kazushinjo/PSN_TRX_XIAO_ESP32C3-V2/kicad/README.txt

PSN_TRX_XIAO_ESP32C3-V2 完全KiCadプロジェクト（V2 Ver 1.4）

【このフォルダの開き方】
1. KiCad 10 のプロジェクトマネージャで「ファイルを開く」→ PSN_TRX.kicad_pro を選択
   （※ .kicad_sch や .kicad_pcb を直接開くとライブラリが解決されません。
      必ず .kicad_pro から開いてください）
2. 基板エディタで「検査 → デザインルールチェッカー(DRC)」を実行
   （シルク警告3件は修正済み。残る場合は除外で可）
3. 発注用のデータは「python3 make_production.py」で作り直せます（ガーバー・ドリル・JLCPCB 用 BOM/CPL・座標・部品配置図）
   （同梱の production/ は 2026-11-08 に基板 V2 Ver 1.3 から DRC エラー0・未配線0・回路図との不一致0 の状態で出力済み）

【含まれるもの】
- PSN_TRX.kicad_pro / .kicad_sch / .kicad_pcb / .kicad_sym / .kicad_prl
- sym-lib-table / fp-lib-table（カスタムライブラリは ${KIPRJMOD} 参照＝このフォルダ内完結）
- PSN_TRX.pretty/（カスタムフットプリント21種: XIAO ソケット（2026-11-05 に Seeed 公式の並びに修正）, Si5351 モジュール用 DIP-8（同、ピン番号を修正）, 電源線・同軸じか付け用 SolderWire_1x02（5.08mm・2.54mm、穴 φ1.1）, AL0510 縦置き, 7T50 コイル, T30/T50 トロイダル, TMCV01 トリマ, Heatsink_17PB046 等）
- blank.kicad_wks（図枠テンプレート）
- report.txt（回路図→基板 反映ログ: 警告0/エラー0）
- BOM.md / bom.csv（部品表）
- refdes_map_2026-11-05.csv（部品番号の新旧対応表。2026-11-05 に部品番号を信号の流れの順に振り直した）
- refdes_map_2026-10-15.csv（その前の対応表。2026-10-15 に部品番号を回路図の位置順に振り直した）
- bom_purchase.csv（購入用部品表: 購入先・型番・秋月の販売コード・入数・価格）／make_bom_purchase.py（その作成スクリプト）
- production/（JLCPCB 用製造データ、2026-11-08 に V2 Ver 1.3 から make_production.py で出力）
    PSN_TRX_Gerber_JLCPCB.zip … ガーバー11層＋ドリル(PTH/NPTH)＋ジョブファイル。発注時はこれだけアップロード
    PSN_TRX_BOM_JLCPCB.csv / PSN_TRX_CPL_JLCPCB.csv … 実装も頼む場合の部品表・座標（LCSC 番号は未記入）
    発注指定: 4層、1.6mm、134.1×129.7mm、最小穴 0.3mm、最小線幅 0.2mm・間隔 0.2mm（いずれも標準仕様内）
- PSN_TRX_部品配置図.pdf（A3・1ページ: 上面から見た部品外形と番号、裏面の Q7/Q6 は Q2 の真裏、2026-10-28 に基板 Ver 2.1 から出力。値は入れず部品番号のみ。値は docs/PSN_TRX_部品実装図.pdf の各ページの表を参照）

【標準ライブラリについて】
回路図・基板は KiCad標準ライブラリ（Device, Transistor_BJT, Regulator_Linear,
Diode_THT, Resistor_THT, Connector_PinHeader 等）も使用しています。
これらはKiCad 10インストーラに同梱されています。
「ライブラリが見つかりません」と出る場合は、KiCadインストール時に
「Libraries」にチェックが入っていなかった可能性があります。
その場合はKiCadインストーラを再実行し Libraries を追加してください。
