kazushinjo/PSN_TRX_XIAO_ESP32C3-V2/kicad/production/JLCPCB_提出資料.md

# PSN_TRX_XIAO_ESP32C3-V2 基板 V2 Ver 1.4（SSB シングルスーパー受信）— JLCPCB 提出資料

作成日: 2026-10-21（2026-10-28 再チェック・再出力、同日 Ver 2.1 で再出力、**2026-10-30 V2 の基板から全製造データを再出力**、2026-10-31 J310 → 2SK192A-GR で BOM・CPL の値を更新、**2026-11-05 V2 Ver 1.1 の基板から全製造データを再出力**、**2026-11-06 V2 Ver 1.2 の基板から全製造データを再出力**、**2026-11-08 V2 Ver 1.3 の基板から全製造データを再出力**、**2026-11-11 V2 Ver 1.4 の基板から全製造データを再出力**）　／　対象: `kicad/PSN_TRX.kicad_pcb`（基板シルク V2 Ver 1.4）

> **2026-10-30 以前の zip・BOM・CPL は V1（Ver 2.1）の基板のもので、V2 の受信部（NJM2594V・AD8307・12MHz 水晶 6 個・RF 増幅のカスコードなど）が入っていない。必ずこの日以降のファイル（基板シルクが「V2 Ver 1.0」以降のもの）で発注すること。2026-11-05 より前の V2 Ver 1.0 のデータは XIAO（U3）と Si5351 モジュール（U1）の部品形が鏡写しで、XIAO の列の間隔も違う（11.43mm、正しくは 15.24mm）ので使わないこと。2026-11-06 より前の V2 Ver 1.1 のデータは J2（電源入力）の位置と穴径（φ1.5）・J1 の部品形が違い、C109・C110・R80・J12 がないので、ケースの電源スイッチ・電源 LED（LCD の窓の下）と合わない。**

Ver 1.6 からの変更:
- **V2 Ver 1.4（2026-11-11）**: **PA 入力を 50Ω に整合**。C93 の 1 番を Q19 のゲートから C92 と L15 の間（ネット Net-(C92-Pad2)）へつなぎ替え、値を **C92 100pF → 150pF、C93 22pF → 33pF、L15 47nH → 270nH** に。基板は C93 をその場で 180° 回し（穴の位置は同じ、1 番が右）、ゲートへ行っていた B.Cu の線 2 本を外して、1 番から C92・L15 間の F.Cu の線へ 0.4mm の線を 2 区間引いた。部品の数・穴・外形は Ver 1.3 と同じ
- **V2 Ver 1.3（2026-11-08）**: 論理チェックの残り項目への対応。(1) **マイクのバイアスを送信 12V から +5V に**（R42 の電源側を +5V へつなぎ替え、**R42 470Ω → 1kΩ**）。電源 13.8V でマイクに約 11.2V かかり、耐圧 10V のエレクトレットを超えていたため。基板は R42 の 1 番から J7 の 1 番（+5V）へ F.Cu の 0.5mm の線を 1 本（約 12mm）引き、R42 へ来ていた送信 12V の枝（B.Cu 2 本、C91 から先）を外した。(2) **C59・C60（セラミック・フィルム）の部品形を `PSN_TRX:C_Radial_D5.0mm_P2.00mm_CPpad` に**（穴・パッドの大きさと位置は電解用の CP_Radial_D5.0mm_P2.00mm と同じで、シルクの＋・斜線と四角パッドをなくした）。(3) **K1（G5V-2）の穴を φ0.7 → φ1.0（ランド φ1.8）**に（オムロンの推奨）。(4) **FCZ コイル（L3・L12〜L14）にケースの爪の長穴（1.4 × 0.7mm、めっき、GND）を 2 か所ずつ追加**し、当たる配線 6 本を引き直した（ビア 4 個追加）。(5) **U7（XIAO）の穴 φ0.9 → φ1.0**。(6) 部品形をメーカーの資料で総点検し、**TMCV01（TC1〜TC4）の足の間隔 5.0 → 6.3mm**（長穴 1.0 × 1.3mm）、**放熱器 17PB046 の外形（Q19 側のつば 7mm）**を直し、つばに当たっていた **L15 を縦置き 2.54mm**、**L16 を左下へ**移した（配線 9 区間を引き直し）。NPTH と外形は Ver 1.2 と同じ
- **V2 Ver 1.2（2026-11-06）**: 電源関係をケースの左、アンテナ関係を右に集めるため、(1) **J2（電源入力）を基板の左辺の前寄りへ移した**（ケースの電源スイッチ・DC ジャックの側。ケースの中の電源線が PA の出力 LPF・BNC の上を通らない）。(2) J2 の横に **+12V のパスコン C109（0.1µF）・C110（0.01µF）**、電源 LED 用に **R80（10kΩ）と J12（2 ピンヘッダ）** を追加。(3) **J1（アンテナ）を同軸ケーブルのじか付け**（2.54mm ピッチ、穴 φ1.1mm）に、**J2 の穴を φ1.5 → φ1.1mm**（AWG20、電流 1A 弱に合わせた）に。(4) 旧 J2 から K1 への +12V の短い配線を外し、新しい J2 から L20 まで +12V（0.8mm、約 111mm、ビア 3 個）を基板の前半分（PA から離れた側）に新しく引いた。ほかの配線は 1 本も動かしていない（自動配線の結果は新しいネットの分だけを使った）。邪魔になる GND のステッチビア 2 個を外した。(5) J9（TX ランプ）を基板の右側の辺の前寄り（R31 と R23 の間）へ移し、Q20・R72 まで 0.25mm で引き直した（ケースの TX ランプが RF ゲインのつまみの後ろに移ったため）。部品 276 → **280 点**
- **V2 Ver 1.1（2026-11-05）**: (1) **部品形の修正**: XIAO ESP32C3（新 U7）を Seeed 公式の並び（列の間隔 15.24mm、上の列が右から D0〜D6）に、Si5351 モジュール（新 U6）のピン番号を上から見た正しい並びに、10µH（新 L20・RFC1、AL0510 は長さ 14mm で 12.7mm の横置きに入らない）を L20 は縦置き・RFC1 は横置き 15.24mm（スピーカーのマグネットの下なので寝かせる）に、電源入力 J2 を太い電線のじか付け用（5.08mm・穴 φ1.5mm・ランド φ3mm）にした。(2) **3SK59（旧 Q2）を削除**し、IF 増幅は 2SK192A カスコードだけに。2SK192A は 4 個とも **BL ランク**、ソース抵抗 R3・R18 を **100Ω** に。(3) パスコンの位置を直した（Q3 のゲートの C3、78L05 の出力の C50、DC-DC の入出力の C106・C107）。(4) **部品番号を信号の流れの順に振り直した**（新旧の対応は [`../refdes_map_2026-11-05.csv`](../refdes_map_2026-11-05.csv)。この資料の 1〜4 章は新しい番号、この下の履歴は当時の番号）。(5) ネット名 +9V → RX12V、+12V・TX12V を命名。配線は変えた部品の周りだけを引き直し、ほかの配線は前のまま。部品 277 → **276 点**
- **2026-10-31**: Q4・Q5・Q20・Q25 を J310 から **2SK192A-GR**（東芝、ピン 1 D・2 S・3 G で J310 と同じ並び、TO-92_Inline のまま）に、R66 を 100Ω → **47Ω** に。あわせて L19 のタップを 2 回目 → 3 回目（値 T30-6 11T/3T、利得を J310 のときと同じ約 20dB に戻す）。BOM（2SK192A の行、47Ω の行に R66、L18 と L19 を別の行に）と CPL の値だけが変わる。基板のパターン・配置・シルクは変更なし、ガーバー・ドリル・zip は部品の値を含まないので出し直しなし（DRC 違反 0・未配線 0・回路図との不一致 0、ERC 未除外 0 を再確認）
- **V2 Ver 1.0**（2026-10-29〜30）: 受信部を 12MHz SSB シングルスーパーに作り直した（J310 カスコード RF 増幅 Q20・Q25、NJM2594V の混合 U4・積検波 U5、12MHz 水晶ラダー Y1〜Y6、IF 増幅、AD8307（U7）＋ADS1015（J11）の S メーター、78L05（U6）、AF 前置増幅 Q23 など）。基板を **134.1 × 129.7mm** に広げて受信部を再配置・再配線。V1 の Q7・C3・C16・C20・C50・L2・L4・R8・R10・R12・R37 は削除。部品は 202 → **277 点**（基板だけの H1〜H4・HS1 を除く）。RF・IF 増幅の JFET 4 個（Q4・Q5・Q20・Q25、10-31 から 2SK192A-GR）はすべて TO-92 で、表面実装は上面の NJM2594V（U4・U5、TSSOP-8）2 個だけ
- **Ver 2.1**（2026-10-28）: IC2（NJM2904）の電源パスコン **C79（0.1µF）** を追加（IC2 の 8 番ピンの近く、+5V–GND）。8 番ピンから下りる B.Cu の +5V 配線に約 2mm でつなぎ、ベタを再充填した。部品 201 → 202 点。ほかの部品の位置と配線は変更なし（C54 の部品番号の文字だけ 1.7mm 左へ移動、シルクの版数を Ver 2.1 に）
- **Ver 2.0**: 送信の AF 90° 移相を、アナログのオールパス（IC2A・IC2B・VR8、音声トランス T1 で 2 系統に分配）から **XIAO ESP32C3（U3）のデジタル処理**に変更。マイク → IC2A（マイクアンプ）→ U3 の A2（ADC）→ 複素 FIR → I2S の PDM で D10（I）・D8（Q）→ 2 段 RC → 変調器。**削除 9 点**（T1・VR8・R53〜R57・C69・C70）、**追加 11 点**（R58・R59・R61〜R64・C73・C75〜C78）、**定数変更 3 点**（R36 10k→20k、R40 10k→1k、C54 0.1µ フィルム→10µ 電解）。送信検出は U3 の D8 → D0。基板外形・取付穴・コネクタ・RF 部の配置は変更なし。部品は 199 → 201 点
- 2026-10-28（再チェック・再出力、基板の版数は Ver 2.0 のまま）: 回路図・基板は 10-21 から変更なし。ERC・DRC・整合性・シミュレーションをやり直し、過渡解析（4.3）を追加。ガーバー・ドリル・zip を出し直した（日付の行以外は 10-21 の出力と同一）。CPL・BOM は基板・回路図と照合して変更なし。3 章のドリル径の内訳とビアの記載を実際の値に直した
- Ver 1.7: XIAO ESP32C3（U3）の USB 口の前に入り込んでいた R50・R38・Q19 を移し、USB ケーブルを挿せるようにした（回路・定数は変更なし）
- Ver 1.8: アマチュア局の新スプリアス規定に合わせ、PA 出力 LPF を 5 素子から **7 素子チェビシェフ＋2 倍波トラップ** にした（4.2 参照）。部品 5 点追加（L16・L17・C71・C72・TC2）、C1・C6・L3 の定数変更、基板左端の配置を組み直し（J1・J2 も移動）
- 2026-10-17 夜（再出力、基板の版数は Ver 1.8 のまま）: 回路図を見やすく整理し（ラベルだけでつないでいた IC2A・IC2B・PA 出力 LPF の周りを線で接続）、「回路図から基板を更新」した。変わったのはネット名（PA_LPF_C・PA_LPF_C2・AFPS_IN・AFPS_FB・AFPS_RC → 自動名）と、ガーバーに入るピン名の属性（TO-92 と Q3 のピン名を実部品どおりに）だけで、**銅箔・穴・レジスト・シルク・外形は前回の出力と同一**。あわせて Q2・Q4・Q5 の回路図とのリンクを直し、回路図と基板の整合性の警告をなくした

## 1. アップロードするファイル

| ファイル | 用途 | 内容 |
|---|---|---|
| [`PSN_TRX_Gerber_JLCPCB.zip`](PSN_TRX_Gerber_JLCPCB.zip) | **基板製造（これだけで発注できる）** | ガーバー 11 層＋ドリル 2＋ジョブファイル、計 14 ファイル |
| [`PSN_TRX_BOM_JLCPCB.csv`](PSN_TRX_BOM_JLCPCB.csv) | 部品実装を頼む場合のみ | Comment / Designator / Footprint / LCSC Part #（LCSC 番号は未記入） |
| [`PSN_TRX_CPL_JLCPCB.csv`](PSN_TRX_CPL_JLCPCB.csv) | 部品実装を頼む場合のみ | 280 点の座標・回転・面（全点 Top） |

zip の中身（ファイル名は KiCad 標準の拡張子。JLCPCB はファイル名から層を自動判別する）:

| ファイル | 層 |
|---|---|
| PSN_TRX-F_Cu.gtl | L19 上面 銅箔（信号＋GND ベタ） |
| PSN_TRX-In1_Cu.g1 | L2 内層 GND 全面 |
| PSN_TRX-In2_Cu.g2 | L16 内層 RX12V 全面 |
| PSN_TRX-B_Cu.gbl | L4 裏面 銅箔（信号＋GND ベタ） |
| PSN_TRX-F_Mask.gts / B_Mask.gbs | レジスト |
| PSN_TRX-F_Silkscreen.gto / B_Silkscreen.gbo | シルク（レジスト開口部を除いて出力） |
| PSN_TRX-F_Paste.gtp / B_Paste.gbp | メタルマスク（上面は U1・U2 の NJM2594V の 16 パッドだけ、裏面はなし。基板のみの発注では不要） |
| PSN_TRX-Edge_Cuts.gm1 | 外形 |
| PSN_TRX-PTH.drl / NPTH.drl | ドリル（めっきあり 859 穴、めっきなし 2 穴） |
| PSN_TRX-job.gbrjob | ジョブファイル（層構成・寸法） |

## 2. 注文画面の設定（PCB 製造）

| 項目 | 設定 | 備考 |
|---|---|---|
| Base Material | FR-4 | |
| Layers | **4** | 層の順序はファイル名で判別される（Specify Layer Sequence は不要） |
| Dimensions | 134.1 × 129.7 mm | ガーバーから自動入力される値を確認 |
| PCB Qty | 5（最小） | |
| Different Design | 1 | |
| Delivery Format | Single PCB | |
| PCB Thickness | **1.6 mm** | |
| PCB Color | 任意（緑が最も安い） | |
| Silkscreen | White（色に合わせて自動） | |
| Surface Finish | HASL（with lead）または LeadFree HASL | 手はんだのみなので HASL で十分。ENIG も可 |
| Outer Copper Weight | **1 oz** | PA・電源系は 0.8mm 配線、1oz で設計 |
| Inner Copper Weight | 0.5 oz（標準） | 内層は GND・RX12V のベタのみ |
| Impedance Control | No | 層構成は JLCPCB 標準（JLC04161H-7628 など）でよい |
| Via Covering | Tented（標準） | |
| Min via hole size/diameter | 0.3mm /(0.4/0.45mm) 以上の標準設定 | 本基板のビアは穴 0.3mm・径 0.6mm（162 個）と穴 0.4mm・径 0.8mm（8 個） |
| Board Outline Tolerance | ±0.2mm（標準） | |
| Confirm Production file | No（任意） | |
| Remove Order Number | 任意 | 指定場所（JLCJLCJLCJLC）は設けていない。基板に番号を入れたくない場合は有料の「Yes」 |
| Castellated / Edge plating / Gold fingers | No | |

### 部品実装（PCB Assembly）について

部品はほぼすべてリード部品（手はんだ）のため、**部品実装は頼まずに基板だけを発注**する想定。
表面実装部品は上面の U1・U2（NJM2594V、TSSOP-8）だけ。手はんだが難しい場合は、Assembly を Top side にし、BOM と CPL をアップロードして U1・U2 だけを選ぶ（LCSC 番号は NJM2594V を検索して入れる。それ以外の部品は「Do not place」）。

## 3. 設計値（JLCPCB の 4 層基板の製造能力との比較）

| 項目 | 本基板 | JLCPCB 4 層の標準能力（目安） | 判定 |
|---|---|---|---|
| 最小配線幅 | 0.2 mm（XIAO・Si5351 まわりのデジタル配線の一部 43 本、ほかは 0.25 mm 以上） | 0.09 mm | 余裕あり |
| 最小クリアランス（配線・パッド） | 0.2 mm | 0.09 mm | 余裕あり |
| ベタとのクリアランス | 0.3 mm | — | |
| 最小ドリル径 | 0.3 mm（ビア） | 0.15〜0.2 mm | 余裕あり |
| ビア径 / 穴 | 0.6 / 0.3 mm（環幅 0.15 mm）、8 個だけ 0.8 / 0.4 mm | 環幅 0.13 mm 以上 | 余裕あり |
| 最大ドリル径 | 3.2 mm（取付穴 H1〜H4） | 6.3 mm | |
| めっきなし穴 | φ1.6 × 2（放熱器 HS1 の脚ピン） | | |
| 基板端からのクリアランス | 0.5 mm | 0.3 mm | |

ドリル径の内訳（めっきあり、PTH.drl から集計、2026-11-06）: 0.3（162）、0.4（8）、0.5（32）、0.7（8）、0.75（69）、0.8（427）、0.85（8）、0.9（46）、1.0（76）、1.1（11、J1・J2 を含む）、1.2（8）、3.2（4）、計 859。めっきなし: 1.6（2）。

## 4. 提出前チェック（2026-10-21 実施、2026-10-28 再実施、2026-10-30 V2 で再実施）

| 項目 | 結果 |
|---|---|
| **V2 Ver 1.4 の再出力（2026-11-11）** | ERC 違反 0（パネル部品の除外 8 件のみ）、DRC（ベタ再充填）違反 0・未配線 0・回路図との不一致 0。変えた配線は C93 まわりの 4 区間（外した B.Cu 2 本、足した F.Cu 2 本）だけ。PTH・NPTH・外形のガーバーは Ver 1.3 と日付以外同じ。CPL 280 点・BOM 110 行を `kicad/make_production.py` で作り直し |
| **V2 Ver 1.3 の再出力（2026-11-08）** | ERC 違反 0（パネル部品の除外 8 件のみ）、DRC（ベタ再充填）違反 0・未配線 0・回路図との不一致 0。変えた配線は R42 の 1 本（と外した 2 本）、FCZ の爪に当たった 6 本、TMCV01・L15・L16 の変更に伴う 9 区間の引き直しだけで、ほかの配線は動かしていない。PTH は K1 の 8 穴（φ0.7 → φ1.0）・U7 の 14 穴（φ0.9 → φ1.0）・FCZ の長穴 8 個・TMCV01 の 8 穴（φ1.2 → 長穴 1.0 × 1.3）・L15・L16 の移動・ビアが変わり、NPTH と外形のガーバーは Ver 1.2 と日付以外同じ。CPL 280 点・BOM 110 行を `kicad/make_production.py` で作り直し |
| **V2 Ver 1.2 の再出力（2026-11-06）** | ERC 違反 0（パネル部品の除外 8 件のみ）、DRC（ベタ再充填）違反 0・未配線 0・回路図との不一致 0。追加・移動した部品の周りと新しい +12V だけを引き、元の配線は動かしていない。ガーバー・ドリル・CPL（280 点）・BOM（110 行）・`kicad/PSN_TRX_pick_place.csv`・部品配置図は `kicad/make_production.py` で作り直した（このスクリプトは変更前の基板から前回の出力と同じファイルを作ることを確かめてある） |
| **V2 Ver 1.1 の再出力（2026-11-05）** | ERC 違反 0（パネル部品の除外 8 件のみ）、DRC（ベタ再充填）違反 0・未配線 0・回路図との不一致 0・部品形とライブラリの不一致 0。配線は変えた部品の周りだけ引き直し（元の配線は 1 本も動かしていない）、内層（GND・RX12V のベタ）には配線なし。CPL 276 点・BOM 109 行を基板から作り直し |
| **V2 の再出力（2026-10-30）** | ERC 違反 0、DRC（ベタ再充填）違反 0・未配線 0・回路図との不一致 0。ガーバーのパッドの属性（部品番号・ピン・ネット）を基板と照合し 669 パッド全部一致（つながりのない 5 ピン U5-5・U5-7・U3-7・VR3-3・VR4-3 はネットなしで一致）、V1 の旧部品 11 点は含まれない。CPL・BOM は基板から作り直し 277 点（109 種）。`kicad/PSN_TRX_pick_place.csv` も 282 行（H1〜H4・HS1 を含む）で作り直した。下の行のうち 10-28 以前の数値は V1 のときのもの |
| ERC（回路図） | 違反 0（除外を含めて表示すると、基板外のパネル部品 VR1・VR2・LED1 の 8 ピンが「除外済み」で出る） |
| DRC（基板、ベタ再充填後） | 違反 0・未配線 0・フットプリントの問題 0（10-28 も同じ） |
| 回路図と基板の整合性 | エラー 0・警告 0（Ver 2.0・2.1 で追加した部品も回路図とのリンク・UUID の重複なしを確認） |
| ガーバー・ドリル | 2026-10-28 に Ver 2.1 の基板から出し直し。Ver 2.0 の出力との違いは C64 とその配線・ベタ、C63 の文字、シルクの版数だけで、ドリルの違いは C64 の穴 2 つだけ（11 層・ドリル 2・ジョブファイル）。zip 14 ファイル（内層は In1_Cu.g1・In2_Cu.g2 に改名、ジョブファイルの参照も修正） |
| CPL・BOM | 基板・回路図から作り直し。Ver 2.0 との違いは C64 の追加だけ（202 点）。10-28 に基板から座標を出し直し、座標・回転・面・値・フットプリントが CPL・BOM・回路図と全点一致 |
| USB（XIAO）の前方 | USB 中心線の上下 7mm、モジュール端から基板右端まで部品なし（配線のみ） |
| アナログ部の回路シミュレーション（ngspice） | 下の 4.1 のとおり、全項目で問題なし（2026-10-30 に V2 で再計算） |
| 過渡解析（ngspice、10-28 追加） | 下の 4.3 のとおり。基板の変更が必要なものはなし。ファームウェアで直すもの 2 点（注意 3・4、10-28 のスケッチで対応済み） |
| 外形・寸法 | 134.1 × 129.7 mm（ジョブファイル 134.1 × 129.73）、4 層・1.6mm |
| 新スプリアス規定（PA 出力 LPF） | 下の 4.2 のとおり、計算上は 1W を超える場合の −60dBc も満たす（実測での確認が必要） |
| 原寸確認（2026-11-08 追加） | `docs/PSN_TRX_原寸確認図.pdf` を 100% で印刷し、XIAO・Si5351 モジュール・ADS1015・K1・R-78E・TMCV01・放熱器・FCZ コイル・半固定抵抗などの実物を紙に当てて、足の位置と外形の当たりを確かめてから発注する |
| シルクの版数 | 「Designed by JA6FUF / V2 Ver 1.4」（上面右下。2026-11-05 に Ver 1.0 → 1.1、2026-11-06 に 1.2、2026-11-08 に 1.3、2026-11-11 に 1.4） |

プレビュー（3D 表示、部品付き）: [上面](preview/PSN_TRX_top.jpg)／[裏面](preview/PSN_TRX_bottom.jpg)

### 4.1 アナログ部の回路シミュレーション（2026-11-05、V2 Ver 1.1。V2 Ver 1.2 で足したのは +12V のパスコンと電源 LED だけで、計算の結果は変わらない。2026-11-08 に V2 Ver 1.3 で再計算: マイクの直流電圧が 2.15V になったことと、直流計算の収束の修正で Q7 のドレインが電源と同じ値になったこと以外は同じ）

回路図のネットリストから定数を直接読み、ngspice で計算した（`../sim/run.sh`、結果は `../sim/results.txt`）。トランジスタはデータシートの代表値から作った簡易モデル。

| 項目 | 結果 | 判定 |
|---|---|---|
| 直流動作点 | 電源 11/12/13.8V・hFE 下限〜上限・2SK192A-BL の個体差（IDSS 12〜24mA・VGS(off) −1.2〜−3V、R3・R18 100Ω で 4.6〜10.5mA）で全段が動作範囲内。損失の最大は Q13・Q12 の 237mW | 正常 |
| 受信の前段（L1・Q2・Q3・L2） | 雑音指数 0.88dB、電力利得 +22.6dB、−3dB 帯域 49.18〜51.88MHz、イメージ −48.3dB、AGC の幅 15.7dB（2SK192A-BL・R3 100Ω、L2 のタップ 3 回目） | 正常 |
| 12MHz ラダーフィルタ | 損失 6.1dB、−3dB 幅 2.2kHz、−60dB 幅 7.7kHz | 正常（帯域は水晶で変わる） |
| 受信の全体 | 最小検出信号 約 −139dBm、逆側帯波 −33dB（1kHz）、隣接 ±5kHz −69dB 以下、スピーカー最大 約 113mW | 正常 |
| 送信 AF・I/Q | 300〜2700Hz の逆側帯波の抑圧 69dB（定数どおり）、部品のばらつきは `iqa`・`iqd` で補正 | 正常（調整が必要） |
| PA 出力 LPF | TC4・TC3 を合わせて 2 倍波 −70dBc 以下、挿入損失 0.4〜0.5dB | 正常（**TC4 の調整が必須**） |
| キャリアの漏れ | VR5・VR6 で −30dBm | 正常（調整が必要） |
| 第 1 局発・BFO（blocks.py） | L3（7T50＝FCZ 07S50、0.51〜0.80µH）は 0.57µH で 38.5MHz（コアの範囲内）。U1 のキャリア入力 約 350mVrms、U2（BFO）約 100mVrms（NJM2594 の試験条件 100mVrms 以上） | 正常 |
| IF 増幅・S メーター（blocks.py） | 同調は 12.8MHz・10.3MHz だが負荷が重く帯域が広いので、12MHz での差は 0.5dB 以下。IF 増幅の AGC は Q7 のゲート 1V で −3.7dB、0V で −15.5dB（RF 増幅と合わせて約 −31dB） | 正常（定数の変更不要） |
| 送信の同調・送信表示・送受切替（blocks.py） | L12〜L14 は 15pF で 0.55µH（コアの範囲内）。送信表示の LED は出力 約 10mW 以上で点灯。Q1 は必要 hFE 18 で十分飽和 | 正常 |

調整の手順は `../../manual/調整手順.md`。

### 4.2 新スプリアス規定との関係（50MHz 帯、アマチュア局）

スプリアス領域（2 倍波 101MHz・3 倍波 151MHz はここに入る）の許容値（無線設備規則 別表第三号。金谷秀紀「アマチュア局 スプリアス発射の強度の許容値 改訂版」の表で確認）:

| 空中線電力 | 許容値 | 1W 出力のとき |
|---|---|---|
| 1W 以下 | 50µW 以下 | −43dBc |
| 1W を超え 50W 以下 | 基本周波数の搬送波電力より 60dB 低い値 | −60dBc |

出力の高調波 =「PA（RD06HVF1 のシングル AB 級）自身の高調波」＋「LPF の減衰」。PA 自身の 2 倍波をデータシートに値がないため −15〜−20dBc と仮定すると:

| | LPF の 2 倍波減衰 | 出力の 2 倍波 | 1W 以下（−43dBc） | 1W 超（−60dBc） |
|---|---|---|---|---|
| Ver 1.7 まで（5 素子） | −27〜−31dB | −42〜−51dBc | 届かない場合あり | 満たさない |
| Ver 1.8（7 素子＋トラップ、TC4 調整後） | −70〜−76dB | −85dBc 以下 | 満たす | 満たす |
| Ver 1.8（TC4 未調整でトラップが外れた場合の最悪） | 約 −30dB | 約 −45〜−50dBc | ほぼ満たす | 満たさない |

計算による見込みであり、適合の判断は実測（スペクトラムアナライザ）で行うこと。JARD の保証を受ける場合もスプリアスの確認が必要。

### 4.3 過渡解析（2026-10-28 追加）

回路図の定数をそのまま使い、信号源を正弦波・電源の立ち上がりに替えて時間領域で計算した（`../sim/tran.py`、`./run.sh` の結果の最後の節）。NJM2904 は出力 0.03〜3.6V（5V 電源）で制限、U7 の ADC は 0〜2.5V（減衰 12dB）、PDM はその平均値（2 段 RC の入力）で表した。

| 項目 | 条件 | 結果 | 判定 |
|---|---|---|---|
| 受信 AF 出力段 | 1kHz、スピーカー 8Ω、音量 0.9、12V | 歪み率 1% で 7mW、3% で 28mW、10% で 83mW（最大 約 110mW） | 正常（R41 100Ω 給電の小出力アンプとして妥当） |
| マイクアンプ（Q14・U5A） | 1kHz、L7 60Ω | 2Pa（100dB SPL）まで歪みなし。3Pa（103.5dB SPL）で U5A の出力が上側 3.6V で頭打ち（歪み 16%）。AF_ADC は 5Pa でも 0.98〜2.02V で ADC の範囲内 | 正常（口元に極端に近づけなければ飽和しない。飽和するのは U5A が先で ADC ではない） |
| 変調器ドライブ（Q15・Q16） | PDM の振幅、変調器の負荷 200/1000Ω | 歪み率 1% になるのは PDM ±12mV（FIR 入力 −23dBFS、出力レベル 10%）。マイク 1Pa（−19dBFS）で 1.3〜1.5%、試験トーン（−12dBFS）で 3.1〜3.6%、ALC の効き始め（−6dBFS）で 7〜8.5% | **注意 3** |
| PA 大信号（簡易モデル） | RD06HVF1 を 2 乗特性（Vth 3.0V）で近似、Idq 50/200mA、12V、LPF は標準の定数 | 出力 0.7〜2.5W、ドレインの 2 倍波 −12〜−24dBc に対し出力の 2 倍波 −65〜−77dBc、3 倍波 −91dBc 以下。ドレインのピーク 21〜29.6V（RD06HVF1 の VDSS 50V に対し余裕あり） | 正常（2 倍波の余裕は −60dBc に対し 5〜17dB。4.2 の見込み（−85dBc 以下）より小さいので TC4 の調整は必ず行う） |
| 電源投入 | RX12V が 1ms で立ち上がる、音量 0.5 | スピーカーに最大 0.53V（7ms 後、瞬間 34mW）、13ms で収まる | 正常（小さなポップ音） |
| 送信開始（変調器ドライブ） | TX12V が 10µs で立ち上がる | Q15・Q16 のコレクタが 0→5.3V に上がる段差が C71・C73 を通って変調器に入り、最大 0.58V（負荷 200Ω）〜2.1V（1000Ω）、±10mV に収まるまで 95〜115ms | 既知（Q15・Q16 の電源が送信時に入るため。送信開始の約 0.1 秒、変調器の平衡がくずれて搬送波が漏れる可能性） |
| 送信開始（マイク系） | TX12V で Q14 が立ち上がる（マイクのバイアスは V2 Ver 1.3 から +5V で常時） | U5A が一時的に頭打ちし、AF_ADC が最大 −1.97V（30ms 後）ずれ、±10mV に収まるまで 295ms（2026-11-08 再計算） | **注意 4** |

**注意 3（変調器ドライブの直線範囲、基板ではなくスケッチの設定値）**: Q15・Q16 はエミッタ抵抗 22Ω・コレクタ電流 1〜2mA の小さい増幅段で、直線に動くのは入力（PDM の平均値）±12mV 程度まで。出力レベル（`out`）初期値 10% では、ALC の効き始め −6dBFS（初期値）まで声を大きくすると歪み率 7〜8.5%（高調波 −22dB 程度）になり、これは FIR より後でできる歪みなので帯域外（隣接周波数）と逆側帯波に広がる。→ 2026-10-28 のスケッチで ALC の効き始めの初期値を **−20dBFS** にした（歪み率 1.2〜1.4%。試験トーンも ALC でこの大きさまで絞られる）。以前のスケッチで設定を保存（`w`）していた場合は `alc -20` → `w` を入れ直す。実機ではスペクトラムを見ながら `alc`・`out` を合わせる。

**注意 4（送信開始時の音、スケッチの処理）**: 送信開始から約 0.3 秒、マイク系の立ち上がりの大きな低い音が ADC に入る。スケッチは最初の 64ms（`RAMP_N`）だけ出力を止めているので、残りの約 0.2 秒は ALC の効き始めの大きさの「ボッ」という音として送信され、ALC が絞った分が約 0.26 秒かけて戻る。また複素 FIR は I 側が直流〜200Hz も素通しで（50Hz で I 0dB・Q −9dB）、この帯域の音（ハム・この立ち上がり音）は逆側帯波がほとんど抑圧されない。→ 2026-10-28 のスケッチで、送信開始から 0.3 秒（2026-10-30 に 0.45 秒へ延長。過渡が収まる 0.28 秒に対し余裕を持たせた）は入力を無音にし（`MUTE_N`）、FIR を中心 1600Hz・幅 1400Hz にして I・Q とも低域を落とした（50Hz で −21dB、通過域 300〜2700Hz の抑圧は約 69dB のまま）。この過渡波形を同じ処理に通した計算で、送信開始の音は −9.9dBFS → −55dBFS 以下。基板の変更は不要。抑圧比の図は `docs/images/sideband_suppression.png`。

## 5. 届いた基板で確認すること

- 外形 134.1×129.7mm、取付穴 4 か所、放熱器 HS1 の脚穴（φ1.6×2）の位置
- 電源（J2、基板の左辺の前寄り）と GND の間に短絡がないこと（テスター）。J1・J2 の穴は φ1.1mm（J2 は AWG20、J1 は RG-174 などの同軸をじか付け）
- XIAO をソケットに挿して、USB-C ケーブルが周りの部品に当たらずに挿さること
- 組み立て後、PA 出力の 2 倍波（約 101MHz）を測り TC4 で最小に、続いて TC3 で SWR を最小に合わせる（`manual/調整手順.md` の手順 9）。新しく必要な部品のうち C102（68p）・C98（39p）・TC4（10p トリマ）・L18（T-30-6）は購入先が要確認（`kicad/bom_purchase.csv`）
- Ver 2.0 では送信の I/Q をファームウェアで作るので、組み立て後に XIAO へ最新のスケッチ（tx_dsp.cpp を含む）を書き込み、シリアルの `tone` で 1 本のトーンを出して逆側帯波が最小になるよう `iqa`・`iqd` を合わせる（手順は `manual/送信IQ調整手順.md`）。C66〜C69・R53〜R56 は I と Q で値がそろうよう同じ袋の部品を使う。D0（送信検出）は起動設定ピンなので PTT を押したまま電源を入れない
- 送信の音質は 4.3 の注意 3・4 のとおりスケッチの設定値で決まるので、ダミーロードに送信してスペクトラムアナライザ（または別の受信機のウォーターフォール）で、帯域外への広がりと送信開始時の音を確認し、`alc`・`out` を合わせる。PA の 2 倍波は TC4 を合わせた後に必ず測る（4.3 の計算では −60dBc に対し 5〜17dB の余裕）
- 組み立て・調整は `docs/PSN_TRX_組み立て説明書.docx`・`docs/PSN_TRX_部品実装図.pdf`・`manual/調整手順.md`、部品の購入は `kicad/bom_purchase.csv` を使う（いずれも 2026-11-11 に V2 Ver 1.4 の内容に更新済み。調整は手順 9 の TC4 → TC3 の順）
