kazushinjo/PSN_TRX_XIAO_ESP32C3-V2/kicad/sim/netlist.txt

C1 10p 1=Net-(Q2-G) 2=GND
C2 0.01u 1=Net-(Q2-S) 2=GND
C3 0.01u 1=Net-(Q3-G) 2=GND
C4 5p 1=Net-(Q3-D) 2=GND
C5 0.01u 1=Net-(Q4-G) 2=Net-(C5-Pad2)
C6 0.01u 1=Net-(Q4-S) 2=GND
C7 0.01u 1=RX12V 2=GND
C8 27p 1=Net-(L3-SA) 2=RX12V
C9 0.01u 1=Net-(L2-TAP) 2=Net-(U1-SIG)
C10 0.01u 1=Net-(C10-Pad1) 2=Net-(U1-CARR)
C11 0.1u 1=Net-(U1-V+) 2=GND
C12 0.01u 1=Net-(U1-OUT2) 2=Net-(Q5-B)
C13 0.1u 1=Net-(U1-BYP) 2=GND
C14 0.1u 1=Net-(C14-Pad1) 2=GND
C15 0.01u 1=Net-(Q5-C) 2=Net-(C15-Pad2)
C16 15p 1=Net-(C15-Pad2) 2=GND
C17 82p 1=Net-(C17-Pad1) 2=GND
C18 100p 1=Net-(C18-Pad1) 2=GND
C19 120p 1=Net-(C19-Pad1) 2=GND
C20 100p 1=Net-(C20-Pad1) 2=GND
C21 82p 1=Net-(C21-Pad1) 2=GND
C22 0.01u 1=Net-(J3-Pin_2) 2=GND
C23 0.01u 1=Net-(Q6-S) 2=GND
C24 33p 1=Net-(Q7-D) 2=RX12V
C25 0.01u 1=Net-(Q7-D) 2=Net-(U2-SIG)
C26 0.01u 1=Net-(C26-Pad1) 2=Net-(U2-CARR)
C27 0.1u 1=Net-(U1-V+) 2=GND
C28 0.1u 1=Net-(U2-BYP) 2=GND
C29 0.01u 1=Net-(C29-Pad1) 2=Net-(Q8-B)
C30 0.1u 1=Net-(C30-Pad1) 2=GND
C31 33p 1=Net-(Q8-C) 2=GND
C32 0.01u 1=Net-(Q8-C) 2=Net-(U3-INP)
C33 0.01u 1=Net-(U3-INM) 2=GND
C34 0.01u 1=Net-(U3-OFS) 2=GND
C35 0.1u 1=Net-(U3-ENB) 2=GND
C36 0.1u 1=Net-(J4-A0) 2=GND
C37 1u 1=Net-(U2-OUT2) 2=Net-(C37-Pad2)
C38 0.047u 1=Net-(C38-Pad1) 2=GND
C39 1u 1=Net-(C38-Pad1) 2=Net-(Q10-B)
C40 1u 1=Net-(Q10-C) 2=Net-(C40-Pad2)
C41 0.1u 1=Net-(C40-Pad2) 2=GND
C42 0.1u 1=Net-(Q11-B) 2=GND
C43 0.1u 1=Net-(Q11-E) 2=GND
C44 1u 1=Net-(Q11-C) 2=Net-(C44-Pad2)
C45 1u 1=Net-(Q12-B) 2=Net-(J5-Pin_2)
C46 1u 1=Net-(J5-Pin_2) 2=Net-(Q13-B)
C47 100u 1=Net-(Q12-E) 2=GND
C48 100u 1=Net-(Q12-C) 2=Net-(J6-Pin_1)
C49 0.1u 1=RX12V 2=GND
C50 10u 1=Net-(U1-V+) 2=GND
C51 0.01u 1=RX12V 2=GND
C52 0.01u 1=RX12V 2=GND
C53 0.1u 1=RX12V 2=GND
C54 0.01u 1=RX12V 2=GND
C55 10u 1=RX12V 2=GND
C56 47u 1=Net-(C56-Pad1) 2=GND
C57 1u 1=Net-(J7-Pin_2) 2=Net-(Q14-B)
C58 10u 1=Net-(Q14-C) 2=Net-(C58-Pad2)
C59 0.01u 1=Net-(C58-Pad2) 2=GND
C60 0.068u 1=Net-(C60-Pad1) 2=GND
C61 10u 1=Net-(C60-Pad1) 2=Net-(C61-Pad2)
C62 1u 1=Net-(U5A-+) 2=Net-(C61-Pad2)
C63 10u 1=Net-(C63-Pad1) 2=GND
C64 0.1u 1=+5V 2=GND
C65 1u 1=Net-(C65-Pad1) 2=Net-(C65-Pad2)
C66 3300p 1=Net-(C66-Pad1) 2=GND
C67 3300p 1=/PSN_I_OUT 2=GND
C68 3300p 1=Net-(C68-Pad1) 2=GND
C69 3300p 1=Net-(C69-Pad1) 2=GND
C70 1u 1=/PSN_I_OUT 2=Net-(Q15-B)
C71 1u 1=Net-(Q15-C) 2=Net-(C71-Pad2)
C72 1u 1=Net-(C69-Pad1) 2=Net-(Q16-B)
C73 1u 1=Net-(Q16-C) 2=Net-(C73-Pad2)
C74 0.01u 1=Net-(C74-Pad1) 2=Net-(U6-CLK0)
C75 0.01u 1=Net-(C75-Pad1) 2=Net-(U6-CLK1)
C76 47PF 1=GND 2=Net-(C74-Pad1)
C77 47PF 1=GND 2=Net-(C77-Pad2)
C78 47PF 1=GND 2=Net-(C75-Pad1)
C79 47PF 1=GND 2=Net-(C79-Pad2)
C80 0.001u 1=Net-(C5-Pad2) 2=Net-(C80-Pad2)
C81 0.001u 1=Net-(C81-Pad1) 2=Net-(C81-Pad2)
C82 0.01u 1=Net-(C71-Pad2) 2=GND
C83 0.01u 1=Net-(C73-Pad2) 2=GND
C84 15p 1=Net-(D4-A) 2=Net-(D5-K)
C85 0.01u 1=Net-(Q17-S) 2=GND
C86 15p 1=Net-(L13-SA) 2=/TX12V
C87 0.01u 1=/TX12V 2=GND
C88 0.01u 1=Net-(Q18-B) 2=Net-(L13-AA)
C89 0.01u 1=Net-(Q18-E) 2=GND
C90 15p 1=Net-(L14-SA) 2=/TX12V
C91 0.01u 1=/TX12V 2=GND
C92 150pF 1=Net-(L14-AA) 2=Net-(C92-Pad2)
C93 33pF 1=Net-(C92-Pad2) 2=GND
C94 0.001u 1=Net-(Q19-D) 2=Net-(C94-Pad2)
C95 0.1uF 1=/TX12V 2=GND
C96 100u 1=/TX12V 2=GND
C97 0.1uF 1=/TX12V 2=GND
C98 39p 1=Net-(C94-Pad2) 2=GND
C99 82p 1=Net-(C99-Pad1) 2=GND
C100 5p 1=Net-(C100-Pad1) 2=GND
C101 100p 1=Net-(C101-Pad1) 2=GND
C102 68p 1=Net-(C102-Pad1) 2=GND
C103 5p 1=Net-(C102-Pad1) 2=Net-(D8-K)
C104 1u 1=Net-(C104-Pad1) 2=GND
C105 10u 1=RX12V 2=GND
C106 10u 1=Net-(U8-VI) 2=GND
C107 10u 1=+5V 2=GND
C108 10u 1=Net-(U6-VDD) 2=GND
C109 0.1u 1=/+12V 2=GND
C110 0.01u 1=/+12V 2=GND
D1 1N4001 1/K_1=Net-(D1-K) 2/A_2=GND
D2 1N4148 1/K_1=Net-(D2-K) 2/A_2=GND
D3 1N4148 1/K_1=GND 2/A_2=Net-(D2-K)
D4 1N60 1/K_1=Net-(D4-K) 2/A_2=Net-(D4-A)
D5 1N60 1/K_1=Net-(D5-K) 2/A_2=Net-(D5-A)
D6 1N60 1/K_1=Net-(D6-K) 2/A_2=Net-(D4-A)
D7 1N60 1/K_1=Net-(D5-K) 2/A_2=Net-(D7-A)
D8 1N60 1/K_1=Net-(D8-K) 2/A_2=GND
D9 1N60 1/K_1=Net-(D9-K) 2/A_2=Net-(D8-K)
D10 1N5819 1/K_1=Net-(D10-K) 2/A_2=+5V
J1 RF_IN 1/Pin_1_1=Net-(J1-Pin_1) 2/Pin_2_2=GND
J2 PWR_IN 1/Pin_1_1=/+12V 2/Pin_2_2=GND
J3 Volume 1/Pin_1_1=Net-(J3-Pin_1) 2/Pin_2_2=Net-(J3-Pin_2) 3/Pin_3_3=GND
J4 AE-ADS1015 1/VDD_1=Net-(J4-VDD) 10/A3_10=unconnected-(J4-A3-Pad10) 2/GND_2=GND 3/SCL_3=Net-(J4-SCL) 4/SDA_4=Net-(J4-SDA) 5/ADDR_5=GND 6/ALRT_6=unconnected-(J4-ALRT-Pad6) 7/A0_7=Net-(J4-A0) 8/A1_8=unconnected-(J4-A1-Pad8) 9/A2_9=unconnected-(J4-A2-Pad9)
J5 Volume 1/Pin_1_1=Net-(J5-Pin_1) 2/Pin_2_2=Net-(J5-Pin_2) 3/Pin_3_3=GND
J6 SP-OUT 1/Pin_1_1=Net-(J6-Pin_1) 2/Pin_2_2=GND
J7 MIC-IN 1/Pin_1_1=+5V 2/Pin_2_2=Net-(J7-Pin_2) 3/Pin_3_3=/PTT 4/Pin_4_4=GND
J8 I2C_OUT-LCD 1/SDA_1=Net-(J4-SDA) 2/SCL_2=Net-(J4-SCL) 3/GND_3=GND
J9 TX-ON-LED 1/Pin_1_1=Net-(J9-Pin_1) 2/Pin_2_2=Net-(J9-Pin_2)
J10 Encoder 1/Pin_1_1=Net-(J10-Pin_1) 2/Pin_2_2=Net-(J10-Pin_2) 3/Pin_3_3=Net-(J10-Pin_3) 4/Pin_4_4=GND
J11 NX4832T035 1/Pin_1_1=GND 2/Pin_2_2=Net-(J11-Pin_2) 3/Pin_3_3=Net-(J11-Pin_3) 4/Pin_4_4=+5V
J12 POWER-LED 1/Pin_1_1=Net-(J12-Pin_1) 2/Pin_2_2=GND
K1 G5V-2 DC12 1=GND 11=RX12V 13=/+12V 16=Net-(D1-K) 4=Net-(J1-Pin_1) 6=Net-(D2-K) 8=Net-(C102-Pad1) 9=/TX12V
L1 T30-6 11T/2T 1/1_1=Net-(Q2-G) 2/TAP_2=Net-(D2-K) 3/3_3=GND
L2 T30-6 11T/3T 1/1_1=Net-(Q3-D) 2/TAP_2=Net-(L2-TAP) 3/3_3=RX12V
L3 7T50 1/SA_1=Net-(L3-SA) 2/CT_2=unconnected-(L3-CT-Pad2) 3/SB_3=RX12V 4/AA_4=Net-(L3-AA) 5/AB_5=GND
L4 8.2uH 1/1_1=Net-(C15-Pad2) 2/2_2=Net-(L4-Pad2)
L5 4.7uH 1/1_1=RX12V 2/2_2=Net-(Q7-D)
L6 4.7uH 1/1_1=RX12V 2/2_2=Net-(Q8-C)
L7 15mH 1/1_1=Net-(C60-Pad1) 2/2_2=Net-(C58-Pad2)
L8 100nH 1/1_1=Net-(C74-Pad1) 2/2_2=Net-(C77-Pad2)
L9 100nH 1/1_1=Net-(C75-Pad1) 2/2_2=Net-(C79-Pad2)
L10 1mH 1/1_1=Net-(C80-Pad2) 2/2_2=Net-(C71-Pad2)
L11 1mH 1/1_1=Net-(C81-Pad2) 2/2_2=Net-(C73-Pad2)
L12 7T50 1/SA_1=Net-(D4-A) 2/CT_2=GND 3/SB_3=Net-(D5-K) 4/AA_4=Net-(L12-AA) 5/AB_5=GND
L13 7T50 1/SA_1=Net-(L13-SA) 2/CT_2=unconnected-(L13-CT-Pad2) 3/SB_3=/TX12V 4/AA_4=Net-(L13-AA) 5/AB_5=GND
L14 7T50 1/SA_1=Net-(L14-SA) 2/CT_2=unconnected-(L14-CT-Pad2) 3/SB_3=/TX12V 4/AA_4=Net-(L14-AA) 5/AB_5=GND
L15 270nH 1/1_1=Net-(C92-Pad2) 2/2_2=Net-(Q19-G)
L16 T-50-10 9T/0.6mm 1/1_1=Net-(C99-Pad1) 2/2_2=Net-(C94-Pad2)
L17 T-50-10 10T/0.6mm 1/1_1=Net-(C99-Pad1) 2/2_2=Net-(C101-Pad1)
L18 T-30-6 8T/0.4mm 1/1_1=Net-(C101-Pad1) 2/2_2=Net-(C100-Pad1)
L19 T-50-10 8T/0.6mm 1/1_1=Net-(C102-Pad1) 2/2_2=Net-(C101-Pad1)
L20 10uH 1/1_1=/+12V 2/2_2=Net-(U8-VI)
Q1 2SA1015 1/E_1=/+12V 2/C_2=Net-(D1-K) 3/B_3=Net-(Q1-B)
Q2 2SK192A 1/D_1=Net-(Q2-D) 2/S_2=Net-(Q2-S) 3/G_3=Net-(Q2-G)
Q3 2SK192A 1/D_1=Net-(Q3-D) 2/S_2=Net-(Q2-D) 3/G_3=Net-(Q3-G)
Q4 2SK439 1/G_1=Net-(Q4-G) 2/S_2=Net-(Q4-S) 3/D_3=Net-(L3-SA)
Q5 2SC1815 1/E_1=Net-(Q5-E) 2/C_2=Net-(Q5-C) 3/B_3=Net-(Q5-B)
Q6 2SK192A 1/D_1=Net-(Q6-D) 2/S_2=Net-(Q6-S) 3/G_3=Net-(Q6-G)
Q7 2SK192A 1/D_1=Net-(Q7-D) 2/S_2=Net-(Q6-D) 3/G_3=Net-(J3-Pin_2)
Q8 2SC1815 1/E_1=Net-(Q8-E) 2/C_2=Net-(Q8-C) 3/B_3=Net-(Q8-B)
Q9 2SC1815 1/E_1=GND 2/C_2=Net-(Q9-C) 3/B_3=Net-(Q9-B)
Q10 2SC1815 1/E_1=GND 2/C_2=Net-(Q10-C) 3/B_3=Net-(Q10-B)
Q11 2SC1815 1/E_1=Net-(Q11-E) 2/C_2=Net-(Q11-C) 3/B_3=Net-(Q11-B)
Q12 2SA950 1/E_1=Net-(Q12-E) 2/C_2=Net-(Q12-C) 3/B_3=Net-(Q12-B)
Q13 2SC2120 1/E_1=GND 2/C_2=Net-(Q12-C) 3/B_3=Net-(Q13-B)
Q14 2SC1815 1/E_1=Net-(Q14-E) 2/C_2=Net-(Q14-C) 3/B_3=Net-(Q14-B)
Q15 2SC1815 1/E_1=Net-(Q15-E) 2/C_2=Net-(Q15-C) 3/B_3=Net-(Q15-B)
Q16 2SC1815 1/E_1=Net-(Q16-E) 2/C_2=Net-(Q16-C) 3/B_3=Net-(Q16-B)
Q17 2SK439 1/G_1=Net-(L12-AA) 2/S_2=Net-(Q17-S) 3/D_3=Net-(L13-SA)
Q18 2SC1815 1/E_1=Net-(Q18-E) 2/C_2=Net-(L14-SA) 3/B_3=Net-(Q18-B)
Q19 RD06HVF1 1/G_1=Net-(Q19-G) 2/S_2=GND 3/D_3=Net-(Q19-D)
Q20 2SC1815 1/E_1=GND 2/C_2=Net-(J9-Pin_1) 3/B_3=Net-(D9-K)
Q21 2SC1815 1/E_1=GND 2/C_2=Net-(J3-Pin_2) 3/B_3=Net-(Q21-B)
Q22 2SC1815 1/E_1=GND 2/C_2=Net-(Q22-C) 3/B_3=Net-(Q22-B)
R1 4.7k 1=Net-(Q1-B) 2=/PTT
R2 10k 1=/+12V 2=Net-(Q1-B)
R3 100 1=Net-(Q2-S) 2=GND
R4 100k 1=Net-(J3-Pin_2) 2=Net-(Q3-G)
R5 2.2k 1=RX12V 2=Net-(Q3-D)
R6 100k 1=Net-(Q4-G) 2=GND
R7 51 1=Net-(Q4-S) 2=GND
R8 470 1=Net-(L3-AA) 2=Net-(C10-Pad1)
R9 100 1=Net-(C10-Pad1) 2=GND
R10 1k 1=Net-(U1-OUT2) 2=GND
R11 27k 1=RX12V 2=Net-(Q5-B)
R12 4.7k 1=Net-(Q5-B) 2=GND
R13 1.5k 1=RX12V 2=Net-(Q5-C)
R14 33 1=Net-(Q5-E) 2=Net-(C14-Pad1)
R15 180 1=Net-(C14-Pad1) 2=GND
R16 330 1=Net-(Q6-G) 2=GND
R17 20k 1=Net-(J3-Pin_1) 2=RX12V
R18 100 1=Net-(Q6-S) 2=GND
R19 1.2k 1=Net-(U6-CLK2) 2=Net-(C26-Pad1)
R20 100 1=Net-(C26-Pad1) 2=GND
R21 2.2k 1=Net-(Q7-D) 2=Net-(C29-Pad1)
R22 27k 1=RX12V 2=Net-(Q8-B)
R23 4.7k 1=Net-(Q8-B) 2=GND
R24 27 1=Net-(Q8-E) 2=Net-(C30-Pad1)
R25 220 1=Net-(C30-Pad1) 2=GND
R26 10 1=Net-(U1-V+) 2=Net-(U3-ENB)
R27 1k 1=Net-(U2-OUT2) 2=GND
R28 8.2k 1=Net-(C37-Pad2) 2=Net-(Q9-B)
R29 100k 1=Net-(Q9-B) 2=Net-(Q9-C)
R30 1k 1=Net-(Q9-C) 2=RX12V
R31 1k 1=Net-(Q9-C) 2=Net-(C38-Pad1)
R32 100k 1=Net-(Q10-B) 2=Net-(Q10-C)
R33 1k 1=Net-(Q10-C) 2=RX12V
R34 1.5k 1=Net-(C40-Pad2) 2=Net-(Q11-B)
R35 100k 1=Net-(Q11-B) 2=Net-(Q11-C)
R36 1k 1=Net-(Q11-E) 2=GND
R37 1k 1=Net-(Q11-C) 2=RX12V
R38 330 1=Net-(C44-Pad2) 2=Net-(J5-Pin_1)
R39 10k 1=Net-(Q12-C) 2=Net-(Q12-B)
R40 10k 1=Net-(Q13-B) 2=Net-(Q12-C)
R41 100 1W 1=Net-(Q12-E) 2=RX12V
R42 1k 1=+5V 2=Net-(C56-Pad1)
R43 4.7k 1=Net-(C56-Pad1) 2=Net-(J7-Pin_2)
R44 100k 1=Net-(Q14-C) 2=Net-(Q14-B)
R45 1k 1=/TX12V 2=Net-(Q14-C)
R46 330 1=Net-(Q14-E) 2=GND
R47 620 1=Net-(C61-Pad2) 2=GND
R48 100k 1=+5V 2=Net-(U5A-+)
R49 100k 1=Net-(U5A-+) 2=GND
R50 1k 1=Net-(U5A--) 2=Net-(C63-Pad1)
R51 20k 1=Net-(C65-Pad1) 2=Net-(U5A--)
R52 22k 1=Net-(U7-D2{slash}A2) 2=Net-(C65-Pad2)
R53 3.3k 1=Net-(C66-Pad1) 2=Net-(U7-D10{slash}MOSI)
R54 3.3k 1=/PSN_I_OUT 2=Net-(C66-Pad1)
R55 3.3k 1=Net-(C68-Pad1) 2=Net-(U7-D8{slash}SCK)
R56 3.3k 1=Net-(C69-Pad1) 2=Net-(C68-Pad1)
R57 1M 1=Net-(Q15-C) 2=Net-(Q15-B)
R58 22 1=Net-(Q15-E) 2=GND
R59 1M 1=Net-(Q16-C) 2=Net-(Q16-B)
R60 22 1=Net-(Q16-E) 2=GND
R61 4.7k 1=/TX12V 2=Net-(Q16-C)
R62 4.7k 1=/TX12V 2=Net-(Q15-C)
R63 47 1=Net-(C5-Pad2) 2=GND
R64 47 1=Net-(C81-Pad1) 2=GND
R65 51 1=Net-(Q17-S) 2=GND
R66 20k 1=/TX12V 2=Net-(Q18-B)
R67 4.7k 1=Net-(Q18-B) 2=GND
R68 100 1=Net-(Q18-E) 2=GND
R69 10 1=Net-(Q19-G) 2=Net-(R69-Pad2)
R70 330 1=/TX12V 2=Net-(R70-Pad2)
R71 100k 1=Net-(D9-K) 2=GND
R72 1k 1=Net-(J9-Pin_2) 2=/TX12V
R73 100k 1=Net-(J4-VDD) 2=Net-(U7-D2{slash}A2)
R74 100k 1=Net-(U7-D2{slash}A2) 2=GND
R75 10k 1=Net-(U7-D10{slash}MOSI) 2=Net-(C104-Pad1)
R76 47k 1=Net-(C104-Pad1) 2=Net-(Q21-B)
R77 47k 1=/TX12V 2=Net-(Q22-B)
R78 10k 1=Net-(Q22-B) 2=GND
R79 10k 1=Net-(J4-VDD) 2=Net-(Q22-C)
R80 10k 1=/+12V 2=Net-(J12-Pin_1)
RFC1 10uH 1/1_1=/TX12V 2/2_2=Net-(Q19-D)
TC1 30p 1=Net-(Q2-G) 2=GND
TC2 30p 1=Net-(Q3-D) 2=GND
TC3 30p 1=Net-(C99-Pad1) 2=GND
TC4 10p 1=Net-(C100-Pad1) 2=GND
U1 NJM2594V 1/V+_1=Net-(U1-V+) 2/OUT1_2=unconnected-(U1-OUT1-Pad2) 3/OUT2_3=Net-(U1-OUT2) 4/GND_4=GND 5/SIG_5=Net-(U1-SIG) 6/BYP_6=Net-(U1-BYP) 7/CARR_7=Net-(U1-CARR) 8/NC_8=unconnected-(U1-NC-Pad8)
U2 NJM2594V 1/V+_1=Net-(U1-V+) 2/OUT1_2=unconnected-(U2-OUT1-Pad2) 3/OUT2_3=Net-(U2-OUT2) 4/GND_4=GND 5/SIG_5=Net-(U2-SIG) 6/BYP_6=Net-(U2-BYP) 7/CARR_7=Net-(U2-CARR) 8/NC_8=unconnected-(U2-NC-Pad8)
U3 AD8307ANZ 1/INM_1=Net-(U3-INM) 2/COM_2=GND 3/OFS_3=Net-(U3-OFS) 4/OUT_4=Net-(J4-A0) 5/INT_5=unconnected-(U3-INT-Pad5) 6/ENB_6=Net-(U3-ENB) 7/VPS_7=Net-(U3-ENB) 8/INP_8=Net-(U3-INP)
U4 78L05 1/VO_1=Net-(U1-V+) 2/GND_2=GND 3/VI_3=RX12V
U5 NJM2904 1=Net-(C65-Pad1) 2/-_2=Net-(U5A--) 3/+_3=Net-(U5A-+) 4/V-_4=GND 5/+_5=GND 6/-_6=Net-(U5B--) 7=Net-(U5B--) 8/V+_8=+5V
U6 Si5351_DIP8 1/VDDO_1=Net-(U6-VDD) 2/SCL_2=Net-(J4-SCL) 3/SDA_3=Net-(J4-SDA) 4/GND_4=GND 5/CLK0_5=Net-(U6-CLK0) 6/CLK1_6=Net-(U6-CLK1) 7/CLK2_7=Net-(U6-CLK2) 8/VDD_8=Net-(U6-VDD)
U7 Seeeduino_XIAO_Socket 1/D0/A0_1=Net-(Q22-C) 10/3V3_10=Net-(J4-VDD) 11/D10/MOSI_11=Net-(U7-D10{slash}MOSI) 12/D9/MISO_12=Net-(J10-Pin_3) 13/D8/SCK_13=Net-(U7-D8{slash}SCK) 14/D7/RX_14=Net-(J11-Pin_3) 2/D1/A1_2=Net-(J10-Pin_2) 3/D2/A2_3=Net-(U7-D2{slash}A2) 4/D3/A3_4=Net-(J10-Pin_1) 5/D4/SDA_5=Net-(J4-SDA) 6/D5/SCL_6=Net-(J4-SCL) 7/D6/TX_7=Net-(J11-Pin_2) 8/VIN_8=Net-(D10-K) 9/GND_9=GND
U8 R-78E5.0-1.0 1/VO_1=+5V 2/GND_2=GND 3/VI_3=Net-(U8-VI)
U9 LP2950-3.3_TO92 1/VO_1=Net-(U6-VDD) 2/GND_2=GND 3/VI_3=+5V
VR3 500 1/1_1=Net-(C5-Pad2) 2/2_2=Net-(C77-Pad2) 3/3_3=Net-(C77-Pad2)
VR4 500 1/1_1=Net-(C81-Pad1) 2/2_2=Net-(C79-Pad2) 3/3_3=Net-(C79-Pad2)
VR5 1k 1/1_1=Net-(D4-K) 2/2_2=Net-(C80-Pad2) 3/3_3=Net-(D5-A)
VR6 1k 1/1_1=Net-(D6-K) 2/2_2=Net-(C81-Pad2) 3/3_3=Net-(D7-A)
VR7 500 1/1_1=Net-(R70-Pad2) 2/2_2=Net-(R69-Pad2) 3/3_3=GND
Y1 12MHz 1/1_1=Net-(L4-Pad2) 2/2_2=Net-(C17-Pad1)
Y2 12MHz 1/1_1=Net-(C17-Pad1) 2/2_2=Net-(C18-Pad1)
Y3 12MHz 1/1_1=Net-(C18-Pad1) 2/2_2=Net-(C19-Pad1)
Y4 12MHz 1/1_1=Net-(C19-Pad1) 2/2_2=Net-(C20-Pad1)
Y5 12MHz 1/1_1=Net-(C20-Pad1) 2/2_2=Net-(C21-Pad1)
Y6 12MHz 1/1_1=Net-(C21-Pad1) 2/2_2=Net-(Q6-G)
