kazushinjo/PSN_TRX_XIAO_ESP32C3-V2/docs/PSN_TRX_VFO改造仕様書.docx

# PSN_TRX_XIAO_ESP32C3-V2 VFO 仕様書

XIAO ESP32C3 ＋ Si5351 による局発・BFO・送信キャリアと、送信 I/Q の生成

発行日: 2026-11-11（基板シルク V2 Ver 1.4・現行スケッチに対応）

# 1. 概要

Seeed Studio XIAO ESP32C3（U7）と Si5351 モジュール（U6、秋月 AE-Si5351A）で、受信の第 1 局発・BFO と送信のキャリアを作る。Si5351 の 3 出力を送受で使い分ける。

- 送信中: CLK0（0°）と CLK1（90°）に表示周波数（50.000〜51.000MHz）を出し、2 組の平衡変調器のキャリアに直接入れる（RF 側の 90° は Si5351 の位相オフセット）。CLK2 は止める。
- 受信中: CLK0 に第 1 局発（表示周波数 + RIT − BFO、38〜39MHz）、CLK2 に BFO（約 12MHz）を出す。CLK1 は止める。
- 送信の AF の 90° は XIAO の複素 FIR で作り、I・Q を I2S の PDM で出す（9.7・9.8）。
- S メーター・AGC は IF 増幅の出力を AD8307（U3）で測り、ADS1015（J4）で読む。

# 2. 周波数の構成

出力 | 送信中 | 受信中 | PLL・分周
CLK0 | 表示周波数（0°） | 表示周波数 + RIT − BFO（38〜39MHz） | 送信: PLLA = f × 16、÷16。受信: PLLA = 局発 × 20、÷20
CLK1 | 表示周波数（90°） | 止める | PLLA、÷16、位相オフセット 16（90°）
CLK2 | 止める | BFO（USB 11,999,900Hz・LSB 12,003,100Hz が初期値） | PLLB = BFO × 64、÷64

BFO は USB ではラダーフィルタの通過域の下端の外、LSB では上端の外に置く。シリアルの「bfo usb <Hz>」「bfo lsb <Hz>」（11,990,000〜12,010,000Hz）で合わせて保存する。BFO を変えても表示周波数はずれない（局発をスケッチが合わせる）。受信のイメージは 26〜27MHz（前段で −48dB）。

# 3. VFO まわりの部品（回路図の部品番号）

部品番号 | 部品 | 値・型番 | 用途
U7 | マイコンモジュール | Seeed XIAO ESP32C3（ソケット実装） | VFO 制御・表示・エンコーダ・S メーター・AGC・送信 I/Q
U6 | クロックジェネレーター | Si5351 DIP-8 モジュール（AE-Si5351A-B、25MHz 水晶） | CLK0/CLK1/CLK2、I2C 0x60
U9 | LDO | LP2950-3.3（TO-92） | U6 用 3.3V（C108）
U8 | DC-DC | RECOM R-78E5.0-1.0（78xx 互換、1A） | +5V（U7・U9・U5・J7・J11）。+12V から L20/C106 の LC フィルタ経由で常時給電
D10 | ショットキーダイオード | 1N5819 | +5V → XIAO の 5V ピン（USB 接続時の逆流防止）
C74 / C75 | コンデンサ | 0.01µF | CLK0 / CLK1 の直流カット
C76・C77 / C78・C79 | コンデンサ | 47pF | π 型 LPF
L8 / L9 | インダクタ | 100nH（AL0510、空芯 5 回巻きで代用可） | π 型 LPF（CLK0 / CLK1）
VR3 / VR4 | 半固定抵抗 | 500Ω（GF063P） | CLK0 / CLK1 のレベル（RF 側の位相の合わせ込み）
R63 / R64 | 抵抗 | 47Ω | レベル調整の分圧の下側
C80 / C81 | コンデンサ | 0.001µF | 平衡変調器（VR5 / VR6 のワイパー）への結合
C5・Q4・R6・R7・C6 | 第 1 局発バッファ | 0.01µF・2SK439・100kΩ・51Ω・0.01µF | CLK0 を受けて L3 へ（受信中だけ動く）
L3・C8・R8・R9・C10 | 局発の取り出し | 7T50・27pF・470Ω・100Ω・0.01µF | 38.5MHz に同調し、U1 のキャリア入力へ約 350mVrms
R19・R20・C26 | BFO の減衰 | 1.2kΩ・100Ω・0.01µF | U2 のキャリア入力へ約 100mVrms
J4 | ADC モジュール | 秋月 AE-ADS1015（I2C 0x48） | A0 = U3（AD8307）の出力
R75・C104・R76・Q21 | AGC | 10kΩ・1µF・47kΩ・2SC1815 | D10 の PWM を平滑し、Q3・Q7 のゲートを下げる
Q22・R77・R78・R79 | 送信検出 | 2SC1815・47kΩ・10kΩ・10kΩ | TX12V で Q22 がオンし D0 を LOW に（RIT を外す・AGC を保持・PDM を始める）
R52・C65 / R73・R74 | マイク入力 | 22kΩ・1µF / 100kΩ ×2 | U5A の出力を A2 へ（1.65V バイアス）
R53〜R56 / C66〜C69 | PDM 出力の 2 段 RC | 3.3kΩ / 3300pF | I: D10 → R53・C66・R54・C67 → C70、Q: D8 → R55・C68・R56・C69 → C72。I と Q で同じ袋の部品
J10 / J11 / J8 | ピンヘッダ | 4P / 4P / 3P | エンコーダ / Nextion 表示器 / I2C（OLED）

# 4. 接続

## 4.1 XIAO ESP32C3（U7）のピン割り当て

XIAO ピン | GPIO | 接続先 | 備考
D0 | GPIO2 | Q22 コレクタ（送信検出） | R79 で 3V3 へプルアップ、送信中 LOW。起動設定ピンなので PTT を押したまま電源を入れない
D1 | GPIO3 | J10.2 エンコーダ B | 内部プルアップ
D2 (A2) | GPIO4 | R52 ← C65 ← U5A 出力（マイク） | ADC1。R73・R74 で 1.65V にバイアス。送信中だけ 32kHz で連続変換（受信音は来ない）
D3 | GPIO5 | J10.1 エンコーダ A | 内部プルアップ
D4 (SDA) | GPIO6 | U6.3 SDA・J4 SDA・J8.1 | I2C 共通バス（Si5351 0x60、ADS1015 0x48、OLED）
D5 (SCL) | GPIO7 | U6.2 SCL・J4 SCL・J8.2 | I2C 共通バス
D6 (TX) | GPIO21 | J11.2 → 表示器の RX | Serial1。起動時に 9600 → 115200bps に切り替え
D7 (RX) | GPIO20 | J11.3 ← 表示器の TX | Serial1
D8 | GPIO8 | R55 → C68 → R56 → C69 → C72 → Q16 | 送信中だけ I2S の PDM（Q）。受信中は LOW
D9 | GPIO9 | J10.3 エンコーダ SW | 内部プルアップ。押す = 設定モード。起動設定ピンなので押したまま電源を入れない
D10 | GPIO10 | R75 → C104 → R76 → Q21（AGC）／ R53 → C66 → R54 → C67 → C70 → Q15（I の PDM） | 受信中は AGC の PWM（19.5kHz・12 ビット）、送信中は I2S の PDM（I）
3V3 | — | J4 VDD（ADS1015）・R73・R79 | XIAO の 3.3V 出力
5V (VIN) | — | +5V（U8 の出力）から D10（1N5819） | USB 接続時の逆流防止
GND | — | GND

## 4.2 Si5351 DIP-8 モジュール（U6）のピン配置

ピン | 働き | 接続先
1 | VDDO（出力バッファの電源） | U9 3.3V
2 | SCL | XIAO D5
3 | SDA | XIAO D4
4 | GND | GND
5 | CLK0 | C74 → CLK0 の LPF
6 | CLK1 | C75 → CLK1 の LPF
7 | CLK2 | R19 → U2（BFO）
8 | VDD（コアの電源） | U9 3.3V

上から見て 1 番（VDDO）が左上の並び（2026-11-05 に部品形を修正）。

## 4.3 Si5351 → 平衡変調器・受信の局発・BFO

CLK0 ─ C74 ─┬─ L8 100nH ─┬─ VR3 500Ω ─┬─ C5 0.01µ → Q4（受信の局発バッファ）→ L3 → R8・R9 → C10 → U1

C76 47p C77 47p R63 47Ω └─ C80 0.001µ → VR5 ワイパー（平衡変調器 1: D4/D5）

CLK1 ─ C75 ─┬─ L9 100nH ─┬─ VR4 500Ω ─┬─ C81 0.001µ → VR6 ワイパー（平衡変調器 2: D6/D7）

C78 47p C79 47p R64 47Ω

CLK2 ─ R19 1.2k ─┬─ C26 0.01µ → U2（積検波）のキャリア入力

R20 100Ω

# 5. LPF とレベル

## 5.1 LPF

Si5351 は CMOS の矩形波を出すので、π 型 LPF（47pF–100nH–47pF）で高調波を減らす。50Ω 終端・理想部品での計算値: 38〜39MHz・50〜51MHz 約 −0.3dB、100MHz 約 −1.0dB、150〜153MHz 約 −11dB、250〜255MHz 約 −26dB。カットオフは約 100MHz。矩形波の第 3 高調波（基本波比 約 −9.5dB）と合わせて約 −20dB。キャリアはさらに平衡変調器・同調回路（L12〜L14）と PA 出力 LPF を通るので、最終的な高調波は送信出力で実測する。

## 5.2 レベル

Si5351 の出力は約 3.3V（CMOS）。VR3（直列の可変抵抗）と R63（47Ω）の分圧比 47/(47 + VR3) で下げる（VR3 = 500Ω で約 1/11.6 = −21dB）。CLK1 側は VR4・R64 で同じ。VR3・VR4 は I と Q の RF 側の位相・振幅の合わせ込みにも使う（計算では VR3 0.9・VR4 0.6 付近で 90°）。

供給先 | 必要なレベル | 計算値・備考
平衡変調器（D4/D5、D6/D7: 1N60） | 0.3〜0.5V ピーク | Ge ダイオードの Vf 約 0.2〜0.3V
U1（NJM2594V、第 1 混合）のキャリア入力 | 100mVrms 以上 | 約 354mVrms（Q4・L3 で増幅、R8・R9 で調整。調整手順 3）
U2（NJM2594V、積検波）のキャリア入力 | 100mVrms 以上 | 約 102mVrms（R19・R20）

# 6. ソフトウェア

## 6.1 開発環境

項目 | 内容
IDE | Arduino IDE（ESP32 Arduino コア）
ボード | XIAO_ESP32C3
スケッチ | PSN_TRX_XIAO_ESP32C3/PSN_TRX_XIAO_ESP32C3.ino（送信 I/Q は tx_dsp.cpp / tx_dsp.h）
表示器の選択 | #define USE_NEXTION_DISPLAY（標準: NX4832T035）。コメントアウトで SSD1306 OLED

## 6.2 必要なライブラリ

ライブラリ | 作者 | 用途
Etherkit Si5351 | Jason Milldrum | Si5351 の制御
Preferences | ESP32 Arduino コア内蔵 | NVS への周波数・ステップ・AGC・BFO・送信設定の保存
Wire | ESP32 Arduino コア内蔵 | I2C（Si5351・ADS1015。ADS1015 はレジスタを直接読む）
Adafruit SSD1306 / Adafruit GFX | Adafruit | OLED を選んだときだけ

## 6.3 主な機能

機能 | 内容
周波数範囲 | 50.000〜51.000MHz（範囲外は端で止まる）、初期値 50.500MHz
送信の 90° | set_phase(CLK0, 0)、set_phase(CLK1, 16) の後に PLL をリセット（位相オフセットの単位 Tvco/4 → 90° = 分周比）
受信の局発・BFO | CLK0 = 表示周波数 + RIT − BFO（PLLA、×20）、CLK2 = BFO（PLLB、×64）。BFO は変わったときだけ設定し直す
出力 | CLK0・CLK1・CLK2 とも駆動電流 8mA
チューニングステップ | 10Hz / 100Hz / 1kHz（初期値）/ 10kHz / 100kHz。設定モードの STEP で変える
周波数の記憶 | 周波数・ステップ・AGC を変えるたびに NVS へ保存（RIT は電源投入で 0）
表示 | Nextion: t0 = 周波数、t1 = ステップ（設定モード中はメニュー）、t2 = 機種名、t3 = S 値、t4 = AGC/TX、t5 = RIT、t6 = AGC の量、背景の目盛りに針を描くアナログ S メーター。OLED: 周波数・ステップ・バー
設定モード | エンコーダを押す → 機能（RIT / STEP / AGC / EXIT）を選ぶ → 押す → 値を変える → 押して確定。長押し・15 秒操作なしで取り消し
RIT | ±9.99kHz・10Hz 刻み。受信のときだけ加え、送信検出（D0 LOW）で外す
S メーター | ADS1015 の A0（AD8307 の出力、25mV/dB）を 2ms ごとに読み、16ms のピーク（rssi）と AGC で下げた量から計算（S9 = RSSI_S9_MV、初期値 1900mV）
AGC | rssi が AGC_TARGET_MV（初期値 1750mV）を超えた分で D10 の PWM（19.5kHz・12 ビット、AGC_DUTY_START 700〜AGC_DUTY_FULL 1400）を上げる。FAST / SLOW / OFF。送信中は保持
送信 I/Q の生成 | A2 を 32kHz で連続変換し 2 サンプル平均で 16kHz → マイク利得 → ALC → 複素 FIR（127 タップ、カイザー窓、中心 1600Hz・通過 300〜2700Hz）→ I2S の PDM（D10 = I、D8 = Q）。送信開始時は 64ms かけて出力の平均を中点へ上げ、0.45 秒は入力を無音にする
ALC | FIR の前で、入力のピークが効き始め（初期値 −20dBFS）を超えた分だけ利得を下げる（すぐ追従、戻り約 0.26 秒）。送信中はメーターが ALC メーターになる
シリアルのコマンド | 115200bps・改行あり。受信中は 0.1 秒ごとに「rssi … mV agc … S … dB」を出す。bfo（表示・設定）、dsp（表示）、mic・out・iqd・iqa・sb・tone・alc、w（保存）

# 7. 注意事項

- Si5351 モジュールの基準水晶が 25MHz 以外（27MHz など）のときは、si5351.init() の第 2 引数を変える。
- 送信の CLK0 と CLK1 は必ず同じ PLL（PLLA）・同じ偶数の整数分周にする（スケッチは ÷16 固定）。分周比を変えるときは位相オフセットも同じ値にする。
- BFO は PLLB を使う。PLLB をリセットすると BFO が一瞬途切れるので、スケッチは BFO が変わったときだけ設定し直す。
- NVS には周波数を変えるたびに書き込む。フラッシュの書き換え回数を減らしたいときは、一定時間操作がないときだけ保存する方式にする。
- I2C の線にプルアップ抵抗がない（AE-Si5351A と XIAO には付いておらず、AE-ADS1015 は出荷時に未接続）。AE-ADS1015 の裏のはんだジャンパを短絡してプルアップを入れる。
- OLED（J8）を使うとき、J8 には電源ピンがないので 3.3V を別に配線する。
- +5V は DC-DC（1A）なので Nextion 表示器を含めても容量に余裕がある。受信でスイッチングノイズのビートが出ないことを確かめる。
- D0（GPIO2、送信検出）と D9（GPIO9、エンコーダの SW）は起動設定ピン。PTT やつまみを押したまま電源を入れると起動しない。

# 8. S メーター・AGC の調整値

定数（スケッチ冒頭） | 初期値 | 意味・合わせ方
RSSI_S9_MV | 1900.0 | S9（−73dBm）の信号のときの rssi（計算の見込み 約 1900mV）。調整手順 7 で実測値を入れる
RSSI_MV_PER_DB | 25.0 | AD8307 の傾き。−93dBm との差 ÷ 20 で確かめる
AGC_TARGET_MV | 1750.0 | AGC が効き始める rssi（S9 の 6dB 下 = RSSI_S9_MV − 150）
AGC_DUTY_START / AGC_DUTY_FULL | 700 / 1400 | Q21 が効き始める PWM 値と、Q3・Q7 のゲートをほぼ 0V まで下げる PWM 値（計算では 700 前後・1000 前後）
AGC_RANGE_DB | 28.0 | AGC を最大に効かせたときの利得の低下（S メーター換算用。計算では約 31dB）
BFO_USB_DEFAULT / BFO_LSB_DEFAULT | 11999900 / 12003100 | BFO の初期値。bfo コマンドで合わせた値が優先

# 9. 1W パワーアンプ（PA）

励振段（Q17 2SK439 → Q18 2SC1815）の出力（約 20〜30mW）を、終段の RD06HVF1（RF MOSFET、Q19）で約 1W に増幅する。

## 9.1 使用するトランジスタ: RD06HVF1（三菱電機）

パラメータ | 値 | 備考
VDSS | 50V | 絶対最大定格
VGSS | ±20V
ID | 3A
Pch | 27.8W（Tc = 25℃） | 放熱器 17PB046（11.9℃/W）を使う
Rth(ch-c) | 4.5℃/W
動作例 | 175MHz・12.5V で 6W 級 | データシート
本機の目標 | 50MHz・12V で約 1W、AB 級（Idq 200〜400mA）

アイドル時の損失は約 3.6W（12V × 0.3A）で、チャネル温度は約 86〜101℃ と見積もられる（評価試験報告書 6.1）。Idq は 200mA 程度から合わせることを推奨する。

## 9.2 ゲートバイアス回路

TX12V（送信中の 12V、K1 NO2）

│

R70 330Ω

├──── VR7 500Ω（3266W）の 1 番 ─ 3 番 ─ GND

│ │ワイパー（2 番）

│ R69 10Ω（ゲートストッパ）── Q19 ゲート

ドレイン給電: TX12V ── RFC1 10µH ── Q19 ドレイン、ソースは GND 直結

VR7 でゲート電圧 0〜約 7.2V（12V のとき、13.8V では約 8.3V）。RD06HVF1 の Vth は 1.9〜4.9V（データシート）で、Idq 200〜400mA になるゲート電圧は個体により約 4〜6V。最初の送信の前に VR7 を GND 側いっぱいにしておく。

## 9.3 入力回路

励振段 Q18 の出力トランス L14（AA 端子）→ C92（150pF、直流カット）→ C93（33pF、GND へ）→ L15（270nH）→ Q19 ゲート。C93（並列 C）と L15（直列 L）で、ゲートの低いインピーダンス（ゲート容量・ミラー容量・バイアス抵抗）を 50Ω に変換する L 型の整合回路。計算（RD06HVF1 の小信号モデル、ミラー効果を含む、gm 0.3〜1.0S・VR7 0.3〜0.7）で、信号源を 50Ω とした不整合損失は 0.2〜0.4dB（V2 Ver 1.3 までの C92 100p・L15 47nH・ゲートに C93 22p では 3.4〜5.3dB）。50〜51MHz で特性はほぼ同じ。L14 のリンクの実際のインピーダンスは測っていない。

## 9.4 出力ローパスフィルター

アマチュア局の新スプリアス規定（50MHz 帯: 1W 以下は 50µW 以下＝1W 出力で −43dBc、1W を超え 50W 以下は −60dBc）を満たすため、7 素子チェビシェフ LPF（fc 約 56MHz）とし、アンテナ側から 2 番目のシャント（C101）に 101MHz の直列共振トラップを付けた。Q19 の出力容量（Coss 約 18pF＠12V）は入口のシャント C98 に並列に入るので、C98 はその分を見込んだ値にしている。

Q19 ドレイン ── C94 0.001µF ──┬── L16 ──┬── L17 ──┬── L19 ──┬── K1 NO1 → アンテナ

(RFC1 給電) (直流カット) C98 9T C99 82p 10T C101 8T C102 68p ／ C103 5p（送信表示）

39p ∥ TC3 30p 100p ∥ L18 T-30-6 8T ─ C100 5p ∥ TC4 10p（101MHz）

GND

L19 = T-50-10 8T（約 0.20µH）、L16 = 9T（約 0.25µH）、L17 = 10T（約 0.31µH）（0.6mm 線、AL = 31µH/100T として）。C98 = 39pF、C99 = 82pF ＋ TC3、C101 = 100pF、C102 = 68pF（いずれも NP0）。トラップは L18 = T-30-6 8T（0.4mm 線、約 0.23µH）と C100 5pF ＋ TC4 で 101MHz に共振させる。ngspice の計算（L ±7%、Coss 18〜25pF）で、TC4 を合わせると 2 倍波 −70〜−76dB、3 倍波 −75〜−80dB、挿入損失 0.41〜0.53dB、反射減衰量 21.7dB 以上。TC4 を合わせないと 2 倍波が −30dB 程度に戻ることがある。

PA 自体の高調波と合わせて、スプリアス規定への適合はスペクトラムアナライザで実測すること。

## 9.5 PA の部品

部品番号 | 部品 | 値・型番 | 備考
Q19 | RF MOSFET | RD06HVF1 | 放熱器 HS1 にタブを M3 ねじ止め（タブは HS1 側）。ピン 1 = G、2 = S、3 = D
HS1 | 放熱器 | 秋月 17PB046 | 46.2 × 17 × 25mm、11.9℃/W。脚ピン 2 本（φ1.4、ピッチ 30mm）を基板の φ1.6 穴へ。Q19 側に両端のつば（7mm）
RFC1 | RF チョーク | 10µH（アキシャル） | ドレイン給電。横置き 15.24mm（スピーカーのマグネットの下）
R70 / VR7 / R69 | バイアス | 330Ω / 500Ω（3266W）/ 10Ω | Idq の調整・ゲートストッパ
C92 / C93 / L15 | 入力の整合回路 | 150pF / 33pF / 270nH（Fastron SMCC-R27K-02） | C93 は C92 と L15 の間から GND へ（V2 Ver 1.4）
C94 | 直流カット | 0.001µF
L16 / L17 / L19 | 出力 LPF | T-50-10 9T / 10T / 8T | 7 素子チェビシェフ
C98 / C99・TC3 / C101 / C102 | 出力 LPF のシャント | 39pF / 82pF ＋ 30pF トリマ / 100pF / 68pF（NP0） | TC3 は TC4 の後に出力最大（SWR 最小）に
L18 / C100 / TC4 | 2 倍波トラップ | T-30-6 8T（0.4mm 線）/ 5pF NP0 / 10pF トリマ | C101 と並列に GND へ。TC4 で 101MHz に
C95 / C97 / C96 / C87 / C91 | バイパス | 0.1µF / 0.1µF / 100µF / 0.01µF / 0.01µF | TX12V。C96 はバルク

## 9.6 バイアスの調整手順

(1) アンテナ端子（J1）に 50Ω のダミーロードをつなぐ。

(2) VR7 をゲート電圧最小（GND 側いっぱい）にしてから電源を入れる。

(3) 電源の電流を見ながら PTT を押し（tone 0）、VR7 を少しずつ回してドレイン電流の増えた分（Idq）を 200mA に合わせる。ゲート電圧が 4V を超えたあたりから電流が急に増えるので、ゆっくり回す。

(4) 先に TC4 を 2 倍波（約 101MHz）が最小になるように合わせる（スペクトラムアナライザで出力を見る。測定器がなければ、取り付けた後、送信回路の電源を入れる前にディップメーターで L18＋C100∥TC4 を 101MHz に合わせる）。そのあと TC3 を出力最大に合わせる。

(5) Idq を変えて最大出力・歪みの少ない点を探す。放熱器の温度も確かめる。

(6) 発振や不安定な動作があるときは R69（ゲートストッパ）の値を見直す。

## 9.7 送信信号の経路

マイク（J7.2）→ Q14 → AF LPF（C59・L7・C60、R47 で終端）→ C62 → U5A（約 21 倍）→ C65・R52 → U7 の A2（ADC）

U7: 16kHz → マイク利得 → ALC（−20dBFS から）→ 複素 FIR（中心 1600Hz、通過 300〜2700Hz）→ I・Q → I2S の PDM

├ I: D10 → R53・C66・R54・C67（2 段 RC）→ C70 → Q15 → L10 → VR5 ─ 平衡変調器 1（D4/D5）← CLK0

└ Q: D8 → R55・C68・R56・C69（2 段 RC）→ C72 → Q16 → L11 → VR6 ─ 平衡変調器 2（D6/D7）← CLK1

→ L12（合成）→ Q17（2SK439）→ L13 → Q18（2SC1815）→ L14 → L15 → Q19（RD06HVF1）約 1W

→ 出力 LPF（C98・L16・C99＋TC3・L17・C101＋トラップ・L19・C102）→ K1（送受切替）→ J1（アンテナ 50Ω）

Q15・Q16 はエミッタ抵抗 22Ω・コレクタ電流 1〜2mA の小さな増幅段で、直線に動くのは入力（PDM の平均値）±12mV 程度まで（ngspice の過渡解析）。出力レベル（out）10% で ALC の効き始めを −20dBFS にすると、変調器入力の歪み率は約 1.2〜1.4%（−6dBFS では 7〜8.5%）。

## 9.8 送信 I/Q の調整（iqd・iqa、VR3・VR4）

I/Q の 90° は FIR の係数で決まるが、PDM の 2 段 RC・Q15/Q16・平衡変調器の I と Q の差が残る。ダミーロードに送信し、シリアルの tone で試験トーンを出して、SDR または受信機で逆側帯波（USB なら送信周波数 − トーン周波数）が最小になるよう iqa（利得、−2〜+2dB）と iqd（遅延、−20〜+20µs）を合わせ、w で保存する。どのトーンでも同じだけ残るときは RF 側の位相のずれなので VR3・VR4 で合わせる。調整中は out 5 に下げ、最後に out 10 に戻して保存する。計算では、RC が I/Q で ±3% ずれた場合に補正なしで約 33dB、補正後で約 50dB（300〜2700Hz の最悪値）。手順・測り方・記録表は manual/送信IQ調整手順.md。

# 10. KiCad のシンボル・部品形

部品 | シンボル | 部品形
XIAO ESP32C3（U7） | PSN_TRX:Seeeduino_XIAO_Socket（14 ピン） | PSN_TRX:Seeeduino_XIAO_Socket（列の間隔 15.24mm）
Si5351 モジュール（U6） | PSN_TRX:Si5351_DIP8 | PSN_TRX:DIP-8_W7.62mm
ADS1015 モジュール（J4） | AE-ADS1015（10 ピン） | PSN_TRX:AE-ADS1015_Vertical
FCZ コイル（L3・L12〜L14） | 7T50 | PSN_TRX:L_FCZ07S_CT
トロイダルコイル（L1・L2 / L16・L17・L19 / L18） | — | PSN_TRX:L_T30_3pin_Vertical / L_T50_2pin_Vertical / L_T30_2pin_Vertical
RD06HVF1（Q19） | PSN_TRX:RD06HVF1 | Package_TO_SOT_THT:TO-220-3_Vertical
放熱器 17PB046（HS1） | —（基板専用部品） | PSN_TRX:Heatsink_17PB046
電源入力（J2） | PWR_IN | PSN_TRX:SolderWire_1x02_P5.08mm_D1.1mm
アンテナ入力（J1） | RF_IN | PSN_TRX:SolderWire_1x02_P2.54mm_D1.1mm

ライブラリは sym-lib-table に PSN_TRX（PSN_TRX.kicad_sym）、fp-lib-table に PSN_TRX（PSN_TRX.pretty）を登録している。

以上
