kazushinjo/PSN_TRX_XIAO_ESP32C3-V2/docs/PSN_TRX_回路図論理検証レポート.docx

# PSN_TRX_XIAO_ESP32C3-V2 回路図 論理検証レポート

対象リポジトリ: kazushinjo/PSN_TRX_XIAO_ESP32C3-V2

対象ファイル: kicad/PSN_TRX.kicad_sch（V2 Ver 1.4: 基板実装 280 点＋パネル部品 VR1・VR2・LED1・160 ネット）、PSN_TRX_XIAO_ESP32C3/PSN_TRX_XIAO_ESP32C3.ino・tx_dsp.cpp

検証日: 2026-11-11（基板シルク V2 Ver 1.4。部品番号は 2026-11-05 に信号の流れの順に振り直した後のもの。C109・C110・R80・J12 は V2 Ver 1.2 で追加）

# 1. 概要

50MHz 帯 PSN（位相シフト網）方式 SSB トランシーバ（受信は IF 12MHz の SSB シングルスーパー）の KiCad 回路図を対象に、ERC・ネットリスト全ネットの横断解析・ファームウェアとの照合・部品データシートとの照合で、電気的・論理的な矛盾がないかを確かめた。

結果: ERC の未除外の違反は 0 件で、断線・ショートなどの形式的な矛盾はない。ネットごとに回路の働きを追った結果、受信・送信・送受切替・電源の各経路は設計どおりにつながっており、ファームウェアのピン割り当て・Si5351 の設定とも一致する。部品の仕様や実機で確かめる必要のある項目を 7.1 にまとめた。

# 2. 検証方法

- kicad-cli sch erc --severity-all（エレクトリカルルールチェック、KiCad 10.0.6）
- kicad-cli sch export netlist（kicadsexpr）＋ Python による全ネットの接続・ピンの働きの横断解析
- 各ブロック（受信・送信・送受切替・電源・VFO・S メーター／AGC）の信号経路と直流バイアス経路の追跡
- ファームウェア（PSN_TRX_XIAO_ESP32C3.ino・tx_dsp.cpp）のピン割り当て・Si5351 の設定と回路図の照合
- データシートとの照合: Omron G5V-2、NJM2594、AD8307、ADS1015（AE-ADS1015）、2SK192A、2SK439、RD06HVF1、LP2950、78L05、R-78E5.0-1.0、Si5351（位相オフセット）、ESP32-C3（起動設定ピン）
- JARL 公開資料（FCZ コイル）との照合
- KiCad 同梱の ngspice による直流動作点・周波数特性・過渡解析（kicad/sim/、結果は評価試験報告書 6.5）

# 3. 信号の流れの確認

## 3.1 受信経路（RX）

J1（ANT）→ K1.4（COM1）→ K1.6（NC1）→ L1 のタップ（D2・D3 1N4148 で入力保護）

→ L1（T30-6 11T、TC1・C1 10p で 50.5MHz に同調）→ Q2 ゲート

→ Q2・Q3（2SK192A-BL カスコード。Q2 ソース R3 100Ω/C2、Q3 ゲート = AGC 線から R4 100k・C3）

→ L2（T30-6 11T、TC2・C4 5p、R5 2.2k で制動）→ L2 のタップ → C9 → U1（NJM2594V、第 1 混合）SIG

局発: U6 CLK0 → C74 → C76・L8・C77（π 型 LPF）→ VR3 → R63/C5 → Q4（2SK439）

→ L3（7T50、C8 27p）→ R8・R9 → C10 → U1 CARR

→ U1 OUT2（R10）→ C12 → Q5（2SC1815、混合後増幅）→ C15 → L4 8.2µH・C16（L 整合）

→ Y1〜Y6（12MHz ラダー、C17〜C21）→ R16 330Ω → Q6 ゲート

→ Q6・Q7（2SK192A-BL カスコード。R18 100Ω/C23、Q7 ゲート = AGC 線）→ L5・C24 → C25 → U2（積検波）SIG

BFO: U6 CLK2 → R19・R20 → C26 → U2 CARR

→ U2 OUT2（R27）→ C37 → R28 → Q9（前置増幅）→ R31・C38 → C39 → Q10 → C40 → R34 → Q11

→ C44 → R38 → J5（音量 VR2）→ C45・C46 → Q12（2SA950）・Q13（2SC2120）→ C48 → J6（SP-OUT）

S メーター: Q7 ドレイン → R21 → C29 → Q8（L6・C31）→ C32 → U3（AD8307）→ J4 A0（ADS1015）→ I2C → U7

信号経路は一直線につながっている。局発バッファ Q4 のドレインには L3 の SB から RX12V、U1・U2・U3 には U4（78L05）の 5V（受信中だけ）を供給している。U1・U2 の未使用の OUT1・NC はどこにもつながっていない。

## 3.2 送信経路（TX）

J7.2（MIC。+5V → R42 1kΩ/C56 47µ → R43 4.7k でバイアス、V2 Ver 1.3）→ C57 → Q14（マイクアンプ）→ C58

→ C59 0.01µ・L7 15mH・C60 0.068µ（AF LPF、R47 620Ω で終端）→ C61 → C62

→ U5A（非反転 約 21 倍: R51 20k・R50 1k・C63 10µ、R48/R49 で 2.5V バイアス）→ C65 → R52 → U7 A2（R73/R74 で 1.65V）

U7: 複素 FIR で I/Q を作り、D10（I）の PDM → R53・C66・R54・C67 → C70 → Q15 → C71 → L10（C82）→ VR5 ワイパー（D4/D5）

D8（Q）の PDM → R55・C68・R56・C69 → C72 → Q16 → C73 → L11（C83）→ VR6 ワイパー（D6/D7）

キャリア: CLK0 → C74 → C76・L8・C77 → VR3 → R63 → C80 → VR5 ワイパー

CLK1 → C75 → C78・L9・C79 → VR4 → R64 → C81 → VR6 ワイパー

→ L12（合成、C84 15p、CT = GND）→ Q17 2SK439 → L13（C86）→ C88 → Q18 2SC1815 → L14（C90）

→ C92 150p →（C93 33p で GND へ）→ L15 270nH → Q19 RD06HVF1 ゲート（バイアス R70 330Ω・VR7 500Ω・R69 10Ω）

→ ドレイン（RFC1 10µH から TX12V）→ C94 → C98 39p → L16 9T → C99 82p＋TC3 → L17 10T

→ C101 100p ∥ トラップ（L18 8T ＋ C100 5p ∥ TC4、101MHz）→ L19 8T → C102 68p（7 素子 LPF）→ K1.8（NO1）→ K1.4 → J1

送信表示: C102 → C103 5p → D8・D9（倍電圧検波）→ R71 → Q20 → J9（LED1、R72 1k から TX12V）

CLK0（0°）・CLK1（90°）の直交キャリアを 2 組の平衡変調器（D4/D5・D6/D7、1N60）へ入れ、AF 側は XIAO（U7）の複素 FIR で作った 90° 違う I/Q を PDM で出して 2 段 RC で平滑し、L12 で合成する PSN 構成であることを確かめた。RF 側の 90° は CLK1 の位相オフセット（分周比と同じ 16）で、AF 側は FIR の係数（I 側が左右対称、Q 側が逆対称）で作る。D10 は受信中は AGC の PWM、送信中だけ I の PDM になる（送信中は RX12V が切れて Q21 の先の Q3・Q7 は止まっているので影響しない）。D8 はコンデンサで直流的に切れているので、起動設定ピン GPIO8 の条件に影響しない。CLK0 は送信中は C5 → Q4 にも入るが、Q4 は RX12V で動くので送信中は働かない。U5B は未使用（＋入力を GND、出力を−入力に接続）。

## 3.3 送受切替（K1）と電源

ピン | 働き | 回路図での接続
1 / 16 | コイル | 1 = GND、16 = Q1 コレクタ（D1 のカソード）
4（COM1） | 共通 1 | J1（アンテナ）
6（NC1） | 常閉 1 | L1 のタップ（受信入力、D2・D3 で保護）
8（NO1） | 常開 1 | PA 出力 LPF の出口（C102）・C103（送信表示）
13（COM2） | 共通 2 | +12V（J2）
11（NC2） | 常閉 2 | RX12V（受信中の 12V: RF 増幅・局発バッファ・混合・IF・検波・AF・U4 78L05）
9（NO2） | 常開 2 | TX12V（送信中の 12V: マイクアンプ Q14・変調器ドライブ Q15/Q16・励振 Q17/Q18・PA Q19・送信検出 Q22・TX ランプ）

PTT: J7.3 を外の PTT スイッチで GND に落とすと、+12V → Q1（2SA1015、PNP）のエミッタ → ベース → R1（4.7kΩ）→ J7.3 とベース電流（約 2.3mA）が流れて Q1 が導通し、コレクタから K1 のコイル（他端 K1.1 = GND、約 41.7mA）が励磁される。R2（10kΩ）はベース・エミッタ間で、PTT を離したときに Q1 をオフに保つ。D1（1N4001）はコイルのフライバック保護（カソードが Q1 のコレクタ側）。

+12V（J2、C109 0.1µ・C110 0.01µ）─┬─ R80 10k → J12（電源 LED、約 1mA）

├─ L20 10µH / C106 → U8（R-78E 5V、常時）→ +5V ─┬→ U9 LP2950 3.3V → U6（Si5351）

│ ├→ D10 → U7（XIAO）VIN、U5（NJM2904）、J7.1、J11.4、R42（マイクのバイアス）

│ └ U7 の 3V3 → J4（ADS1015）・R73・R79

├─ K1 COM2 ─┬─ NC2 → RX12V（受信中だけ）→ 受信 RF・IF・AF、U4 78L05 → 5V（U1・U2・U3）

│ └─ NO2 → TX12V（送信中だけ）→ マイクアンプ・変調器ドライブ・励振・PA・送信検出

└─ Q1（PNP）→ K1 のコイル → GND（ベースは R1 から J7.3（PTT））

U8（5V DC-DC）は +12V から常に動くので、送信中も XIAO・Si5351・U5・表示器が動く。受信のアナログ部の 5V は、スイッチングノイズを避けるため U4（78L05）で RX12V から別に作っている。内層 In2.Cu は RX12V の全面ベタ。

# 4. ファームウェアとの照合

項目 | ファームウェア | 回路図 | 判定
I2C | Wire.begin()（XIAO 既定 D4 = SDA、D5 = SCL） | D4 → U6.3・J4 SDA・J8.1、D5 → U6.2・J4 SCL・J8.2 | 一致
エンコーダ | D3 = A、D1 = B、D9 = SW（内部プルアップ） | J10.1/2/3 = D3/D1/D9、J10.4 = GND | 一致
表示器 | NX4832T035: Serial1 9600 → 115200bps（起動時に切り替え）、TX = D6、RX = D7 | J11.2 = D6、J11.3 = D7、J11.4 = +5V、J11.1 = GND | 一致
Si5351（送信） | 25MHz 水晶、PLLA = f × 16、CLK0/CLK1 を ÷16、CLK1 の位相 16（90°）、8mA | U6 CLK0 → C74、CLK1 → C75 | 一致
Si5351（受信） | CLK0 = 表示周波数 + RIT − BFO（PLLA、×20）、CLK2 = BFO（PLLB、×64）、CLK1 は止める | CLK0 → C74 → … → Q4 → L3 → U1、CLK2 → R19・R20 → U2 | 一致
S メーター | ADS1015（0x48）の A0 を 2ms ごとに読み、16ms のピークから AGC・S メーターを計算 | U3（AD8307）OUT → J4.7（A0）、J4.5（ADDR）= GND → 0x48 | 一致
AGC | D10 の PWM（19.5kHz・12 ビット）、AGC_DUTY_START 700・FULL 1400 | D10 → R75・C104・R76 → Q21 → J3.2 の線 → Q7 ゲート・R4 → Q3 ゲート | 一致
送信検出 | D0（送信中 LOW）で RIT を外し、AGC を保持し、PDM を始める | D0 = Q22 コレクタ（R79 で 3V3）、Q22 のベースは TX12V から R77/R78 | 一致
送信 I/Q | A2 を送信中だけマイク入力に（ADC 連続変換）、I2S の PDM で D10 = I・D8 = Q（tx_dsp.cpp） | A2 = R52 ← C65 ← U5A、D10 → R53 → … → Q15、D8 → R55 → … → Q16 | 一致

# 5. FCZ コイル・トロイダルコイルの接続の照合

FCZ コイル（7T50 = FCZ 07S50）の L3・L12・L13・L14 の接続を JARL 公開資料（1–3 同調巻線、2 センタータップ、4–5 リンク巻線）と照合した。4 個とも同調巻線（SA = 1、SB = 3）に高インピーダンス側と同調コンデンサ（L3 は C8 27p、L12〜L14 は 15p）、リンク巻線（AA = 4、AB = 5）に低インピーダンス側がつながり、一次側・二次側の取り違えはない。L12 のセンタータップは GND（平衡変調器の電流の帰り道）、L3・L13・L14 のセンタータップは未接続。

受信の入出力同調 L1・L2（T30-6 11T）は 3 ピンの部品形で、1 = 高インピーダンス側（L1 は Q2 ゲート、L2 は Q3 ドレイン）、3 = 交流的な接地（L1 は GND、L2 は RX12V）、2 = タップ（L1 はアンテナ側、GND 側から 2 回目。L2 は U1 の入力、RX12V 側から 3 回目）で、回路図・部品表と一致する。

# 6. KiCad ERC の結果

回路図に対し全重要度で ERC を実行した結果、未除外の違反は 0 件（2026-11-11、KiCad 10.0.6）。基板に載せないパネル部品 VR1（RF ゲイン 10kΩ B）・VR2（AF 音量 10kΩ）・LED1（送信表示）の計 8 ピンは「pin not connected」として出るので、プロジェクト設定でピンごとに除外している（除外分を含めて表示すると 8 件が「除外済み」で出る）。基板の DRC も違反 0・未配線 0・回路図との不一致 0・部品形の問題 0。

ERC は結線の形の整合を確かめるもので、働きの上の問題は見つけられないため、3〜5 章でネットごとに追った。

# 7. 結論

回路図には断線・ショートなどの形式的な矛盾はなく、受信・送信・送受切替・電源の信号経路は設計どおりにつながっている。ファームウェアのピン割り当て・Si5351 の設定とも一致し、回路図と基板の不一致もない（評価試験報告書 3 章）。部品の仕様や実機で確かめる必要のある項目を 7.1 に示す。

再精査（2026-11-05）で、RF ゲインのつまみ VR1 を 5kΩ → 10kΩ B に変えた。R17（20kΩ）との分圧で AGC の線（Q3・Q7 のゲート）の最大は、5kΩ では約 2.4V（電源 11V で 2.2V）にしかならず、VGS(off) が −3V に近い 2SK192A では下段 Q2・Q6 の Vds（2.26V）が飽和に必要な電圧（2.29V）を下回る。10kΩ では約 4.0V（11〜13.8V で 3.7〜4.6V）になり、ngspice の計算・調整手順の目安と一致する。VR1 は基板に載らないパネル部品なので、基板・製造データは変わらない。

再チェック（2026-11-08、V2 Ver 1.3）では、ネットリストを部品ごと・ネットごとにもう一度追い、極性・ピンの並び・ファームウェアとの対応に誤りがないことを確かめた。そのうえで残っていた項目に対応した: (1) マイクのバイアスを送信 12V から +5V に変えた（R42 の電源側を +5V へ、R42 470Ω → 1kΩ。7.1 の No.10）。(2) C59・C60（セラミック・フィルム）の部品形を、穴・パッドは電解用のまま極性マークのないものにした。(3) I2C のプルアップは AE-ADS1015 のはんだジャンパを短絡する方式にそろえ、購入用部品表の「つながない」を訂正した（No.14）。(4) 回路シミュレーションの直流計算が、コンデンサだけでつながった点（L7・L10・L11 の先）で収束していなかったのを直した（Q7 のドレインが電源より高く出ていた。ほかの値は変わらない）。(5) 部品形の寸法をメーカーの資料で総点検し、TMCV01（TC1〜TC4）の足の間隔（5.0 → 6.3mm）と放熱器 17PB046 の外形（Q19 側のつば 7mm。つばに当たっていた L15 を縦置きに、L16 を移動）を直した。部品のピンの並びをメーカーの資料（東芝 2SK192A、ルネサス 2SK439、日清紡 NJM2594、秋月 AE-Si5351A・AE-ADS1015、RECOM R-78E、オムロン G5V-2）で照合し、すべて一致した。G5V-2 の穴は KiCad 標準の部品形の φ0.7 だったので、オムロンの推奨の φ1.0（ランド φ1.8）にした。FCZ コイル（L3・L12〜L14）にケースの爪の長穴（GND）を 2 か所ずつ足し、当たる配線 6 本（PTT・TX12V・AGC・BFO・TX ランプ・L14 の SA）を引き直した。XIAO（U7）の穴は 0.64mm 角のピンヘッダが入るよう φ0.9 → φ1.0 にした。D0・D9 の起動設定ピン（No.8）は、XIAO の空きピンがないので、組み立て説明書と README の注意で対応する。

## 7.1 確認事項

No | 項目 | 内容 | 重大度 | 推奨する対応
1 | 12MHz ラダーフィルタの通過域 | 帯域・中心は水晶の運動定数で決まる（計算は Cm 15fF と仮定。10〜20fF で −6dB 幅 1.7〜3.4kHz）。 | 中 | Y1〜Y6 は同じロットで直列共振 ±50Hz 以内のものを選び、BFO で音声の帯域を合わせる（調整手順 6）
2 | 2SK192A-BL の個体差 | R3・R18 100Ω で 4.6〜10.5mA。 | 低 | 調整手順 1・2 で R3・R18 の両端電圧を測り、外れたら R18 を 47〜150Ω に替える
3 | NJM2594V のキャリア入力 | 計算では U1 約 354mVrms、U2 約 102mVrms（試験条件 100mVrms 以上）。U2 は下限に近い。 | 低 | 調整手順 3 で U1・U2 の 7 番ピン側を測る。U2 が 0.28Vpp に届かないときは R19 を小さく
4 | DC-DC のスイッチングノイズ | U8（R-78E5.0-1.0）はスイッチング方式。入力に L20/C106 の LC フィルタ、受信のアナログ部は U4（78L05）の別電源。 | 中 | 受信でスプリアス（ビート）が出ないことを実機で確かめる
5 | PA 入力の整合 | V2 Ver 1.4 で C92 150p・C93 33p（C92 と L15 の間から GND へ）・L15 270nH の L 型整合にし、50Ω 源に対する不整合損失を 3.4〜5.3dB → 0.2〜0.4dB に（計算）。L14 リンクの実際のインピーダンスは不明。 | 低 | 励振が強くなったので、最初は出力レベル（out）を小さくして出力を確かめる
6 | PA 出力のスプリアス | 7 素子 LPF＋2 倍波トラップで、TC4 を合わせると 2 倍波 −70〜−76dB（計算）。合わせないと −30dB 程度に戻ることがある。 | 中 | TC4 を 2 倍波最小に合わせ、スペクトラムアナライザで実測（調整手順 9）
7 | Si5351 出力の LPF | L8・L9 100nH の π 型 LPF は 2 倍波をほとんど減らさない（Si5351 の出力はデューティ 50% で偶数次はもともと小さい）。 | 低 | 送信出力で高調波を実測
8 | D0・D9 が起動設定ピン | D0（GPIO2、送信検出）と D9（GPIO9、エンコーダの SW）は ESP32-C3 の起動設定ピン。 | 低 | PTT やつまみを押したまま電源を入れない（組み立て説明書 1.1）
9 | J8（I2C_OUT-LCD）に電源ピンがない | J8 は SDA/SCL/GND の 3 ピンで、OLED（SSD1306）を使うときの電源がない。 | 低 | J11（Nextion）を標準とし、OLED のときは 3.3V を別に配線
10 | マイクの電圧 | V2 Ver 1.2 までは送信 12V から給電し、13.8V で約 11.2V と耐圧 10V のエレクトレットを超えていた。V2 Ver 1.3 で +5V → R42 1kΩ → R43 4.7kΩ に変更し、マイク電圧は電流 0.1〜0.5mA で約 4.4〜2.2V（計算、電源電圧によらない）。感度（R43 の負荷）は同じ。 | 済 | 対応済み（V2 Ver 1.3）
11 | U6 のピン配置 | U6 の DIP-8 の並びは秋月 AE-Si5351A-B の資料（1 VDDO・2 SCL・3 SDA・4 GND・5〜7 CLK0〜2・8 VDD）に合わせた。 | 低 | 実物のモジュールで確かめる
12 | AGC の効き切る点 | 計算では PWM 値 1000 前後で Q3・Q7 のゲートがほぼ 0V になるが、スケッチの AGC_DUTY_FULL は 1400。 | 低 | 調整手順 7 で実機の値に合わせる
13 | 電源の逆接続保護 | +12V（J2）に逆接続の保護がない。 | 低 | 電源の極性に注意（必要なら外にダイオードを入れる）
14 | I2C のプルアップ | SDA・SCL にプルアップ抵抗がない（AE-Si5351A・XIAO には付いておらず、AE-ADS1015 は出荷時に未接続）。ESP32 の内部プルアップ（約 45kΩ）だけでは不安定になるおそれがある。 | 中 | AE-ADS1015 の裏のはんだジャンパを短絡してプルアップを入れる（組み立て説明書 STEP 11）

No.1 と No.6 は実機での調整・測定で確かめる必要がある。PA 出力 LPF の減衰量は計算値なので、TC4 を 2 倍波最小に合わせたうえで、スプリアス規定への適合をスペクトラムアナライザで確かめること。
