kazushinjo/PSN_TRX_XIAO_ESP32C3-V2/docs/PSN_TRX_組み立て説明書.docx

# PSN_TRX_XIAO_ESP32C3-V2 組み立て説明書

50MHz 帯 PSN 方式 SSB トランシーバ（受信 IF 12MHz シングルスーパー）　XIAO ESP32C3 制御版

対象基板: PSN_TRX.kicad_pcb（4 層 134.1 × 129.7mm、M3 取付穴 ×4、基板シルク V2 Ver 1.4）

発行日: 2026-11-11

# 1. はじめに

この説明書は、50MHz 帯の PSN（位相シフト網）方式 SSB トランシーバ基板「PSN_TRX_XIAO_ESP32C3-V2」の部品の取り付け・配線・調整をまとめたものです。

受信は、RF 増幅（2SK192A-BL のカスコード）→ 第 1 混合（NJM2594V）→ 12MHz の水晶ラダーフィルタ → IF 増幅 → 積検波のシングルスーパーです。送信は、Si5351 の CLK0/CLK1 の直交出力を平衡変調器へ直接入れる PSN 方式で、音声の 90° は XIAO ESP32C3（U7）のファームウェア（複素 FIR）で作ります。PA 出力は 7 素子 LPF＋2 倍波トラップです。組み立て後に、manual/調整手順.md の 13 の調整（受信 7・送信 6）が必要です。部品番号・配置は基板シルク V2 Ver 1.2（部品番号は 2026-11-05 の振り直し後、C109・C110・R80・J12 は V2 Ver 1.2 で追加）のものです。

## 1.1 安全上の注意

- はんだ付けの作業中はやけどに注意してください。作業台を片づけ、燃えやすい物を近づけないこと。
- 電解コンデンサ・ダイオード・トランジスタ・IC には極性・向きがあります。逆に付けると壊れたり煙が出たりします。
- Q19（RD06HVF1）は終段の RF MOSFET です。必ず放熱器 HS1 を取り付け、最初の送信の前に VR7（Idq）をゲート電圧最小（GND 側いっぱい）にしてください。
- 通電前のチェック（6 章）を必ず行ってから電源を入れてください。
- XIAO の D0（送信検出）と D9（エンコーダの SW）は起動設定ピンです。PTT やつまみを押したまま電源を入れないでください。
- 送信の試験は必ずダミーロードをつなぎ、無線局の免許などの法令の要件を満たしたうえで行ってください。

## 1.2 用意するもの（工具・部材）

- はんだごて（温度調節式、320〜350℃）と細いこて先（U1・U2 の TSSOP-8 用）／糸はんだ（0.6〜0.8mm と 0.3mm 程度）／フラックス・はんだ吸取線・ルーペ
- ニッパー・ラジオペンチ・ピンセット
- テスター（直流の電圧・電流・導通）
- 安定化電源（12V、電流制限つき）
- トリマ用の絶縁ドライバー（VR3〜VR7、TC1〜TC4、FCZ コイルのコア）
- ポリウレタン線: 0.4mm（L1・L2・L18）、0.6mm（L16・L17・L19。L8・L9 を空芯コイルで代用するときも）
- M3 スペーサー・ねじ（基板の固定用 4 組、放熱器の固定用 1 組）、電源線 AWG20（0.5sq、J2）、同軸ケーブル RG-174 など（J1）
- 換気・煙の対策

# 2. 部品表（BOM）

部品は回路図（PSN_TRX.kicad_sch）から集計しました（基板に付ける部品 280 点＋放熱器 HS1）。部品番号・購入先は kicad/BOM.md と kicad/bom_purchase.csv（サトー電気優先版は bom_purchase_sato.csv）にあります。

種類 | 数量 | 部品番号・注意
固定抵抗 | 80 本 | R1〜R80。R80（10kΩ）は電源 LED の電流制限。R41 は 1W 品（100Ω）。R53〜R56（3.3kΩ、PDM の RC）は I と Q で同じ袋のものを使う。R3・R18（100Ω）は 2SK192A のソース抵抗
半固定抵抗 | 5 個 | VR3・VR4（GF063P 500Ω）、VR5・VR6（GF063P 1kΩ）、VR7（3266W 500Ω）
セラミック・フィルムコンデンサ | 90 個 | C109（0.1µF）・C110（0.01µF）は J2 の横の +12V のパスコン。C66〜C69（3300pF、PDM の RC）は C0G かフィルムで I と Q で同じ袋。PA の LPF・トラップ（C98・C99・C101・C102・C100）と同調用（C1・C4・C8・C16〜C21・C24・C31・C84・C86・C90）は NP0（CH）
電解コンデンサ | 20 個 | C47・C48・C96（100µF）、C50・C55・C58・C61・C63・C105〜C108（10µF）、C56（47µF）、C57・C62・C65・C70〜C73（1µF）
トリマコンデンサ | 4 個 | TC1〜TC3（30pF）、TC4（10pF）
コイル・インダクタ・チョーク | 21 個 | L1・L2（T30-6 11T タップ付き、自分で巻く）、L3・L12〜L14（FCZ 7T50）、L4〜L11・L15・L20（市販品）、L16・L17・L19（T-50-10、自分で巻く）、L18（T-30-6、自分で巻く）、RFC1
ダイオード | 10 本 | D1（1N4001）、D2・D3（1N4148）、D4〜D9（1N60）、D10（1N5819）
トランジスタ・FET | 22 個 | Q1（2SA1015）、Q2・Q3・Q6・Q7（2SK192A-BL）、Q4・Q17（2SK439）、2SC1815 ×12、Q12（2SA950）、Q13（2SC2120）、Q19（RD06HVF1）
水晶振動子 | 6 個 | Y1〜Y6（12MHz、同じロットで直列共振 ±50Hz 以内）
IC・レギュレータ・モジュール | 8 個 | U1・U2（NJM2594V、TSSOP-8 表面実装）、U3（AD8307）、U4（78L05）、U5（NJM2904）、U6（Si5351 モジュール）、U8（R-78E5.0-1.0）、U9（LP2950-3.3）
マイコンモジュール | 1 個 | U7（XIAO ESP32C3、ソケットに差す）
リレー | 1 個 | K1（G5V-2 DC12）
コネクタ | 12 個 | J3・J5〜J12（ピンヘッダ）、J4 は AE-ADS1015 を差す、J1 は同軸・J2 は電源線のじか付け
放熱器 | 1 個 | HS1（秋月 17PB046）。脚ピン 2 本を基板の穴に差す

このほかパネル部品（RF ゲイン 10kΩ B = VR1、AF 音量 10kΩ A = VR2、送信表示 LED = LED1、エンコーダ、LCD、マイクコネクタ、イヤホンジャック、スピーカー、電源スイッチ、DC ジャック、ヒューズ、BNC）と、IC ソケット DIP-8 ×3（U3・U5・U6）、ケースが必要です（5 章）。

# 3. 取り付けの手順

表面実装の U1・U2 を最初に付け、そのあと背の低い部品から順に付けると、はんだ付けのときに基板を安定して置けます。部品はすべて部品面（表面）に付けます。四角いパッドが 1 番ピン（電解コンデンサの＋、ダイオードの K）です。ブロックごとの拡大図と部品表は docs/PSN_TRX_部品実装図.pdf（組立順の目安: 1 → 13）にあります。

## STEP 1: 表面実装の IC（U1・U2）

- U1（第 1 混合）・U2（積検波）は NJM2594V（TSSOP-8、0.65mm ピッチ）です。ほかの部品がない状態で最初に付けます。
- 1 番ピンの印（くぼみ・線）を実装図の 1 番パッドに合わせます。片側のパッド 1 つに予備はんだ → 部品を置いて 1 本だけ仮止め → 位置を直して反対側 → 残りの順に付けます。ブリッジしたらフラックスを付けて吸取線で取ります。
- ルーペで全ピンを確かめ、隣のピンとの導通がないことをテスターで確かめます。

## STEP 2: 固定抵抗（R1〜R79）

- 全 80 本を付けます（縦置き）。R53〜R56（3.3kΩ）は I と Q で値がそろうよう同じ袋のものを使います。抵抗に極性はありません。値をテスターで確かめてから差すと間違いを防げます。
- R41（100Ω 1W）は小型の 1W 品を縦に置き、本体を少し浮かせます（静止時に最大約 0.5W 消費）。
- R3・R18（100Ω）は 2SK192A の電流を決めます。調整手順 2 で替えることがあるので、足を少し長めに残しておくと楽です。

## STEP 3: ダイオード（D1〜D10）

- D2〜D9（1N4148・1N60）: 縦置き。四角パッドが K（カソード）です。D4〜D7（平衡変調）は同じ袋の品を 4 本使います。
- D1（1N4001）: 横置き 10.16mm。帯（カソード）を四角パッド側に合わせます。
- D10（1N5819、ショットキー）: 縦置き。四角パッドが K（カソード、XIAO 側）。XIAO の 5V ピンへの逆流防止で、基板に電源を入れたまま USB で書き込んでも DC-DC と USB の電源がぶつかりません。

## STEP 4: IC ソケット・水晶

- U3（AD8307）・U5（NJM2904）・U6（Si5351 モジュール）は DIP-8 のソケットを使います。切り欠き（1 番ピン）の向きに注意します。
- Y1〜Y6（12MHz、HC-49/U）を付けます。6 個とも同じロットで、直列共振周波数がそろったもの（±50Hz 以内）を使います。

## STEP 5: トランジスタ・FET・小型レギュレータ

- TO-92 の部品は、シルク・実装図の外形の平らな側に、部品の平らな面（型番の印字面）を合わせて差します。基板の穴はこの向きで正しい並びになるようにしてあります。
- バイポーラ（2SC1815・2SC2120・2SA950・2SA1015）は平らな面から見て左から E-C-B、2SK192A は D-S-G（1 D・2 S・3 G）、2SK439 は G-S-D です。
- Q1 は PNP の 2SA1015 です（2SC1815 と取り違えないこと）。Q12 は PNP の 2SA950、Q13 は NPN の 2SC2120 です。
- Q2・Q3・Q6・Q7 は 2SK192A の BL ランク（IDSS 12〜24mA）です。上段・下段の組（Q2 と Q3、Q6 と Q7）は IDSS の近いものにします。
- U4（78L05）・U9（LP2950-3.3）も TO-92 です。平らな面の向きを実装図で確かめます。
- Q19（RD06HVF1、TO-220）: 先に放熱器 HS1（17PB046）をタブに M3 ねじで固定し（Q19 は放熱器の両端のつばの間に入ります）、Q19 の足と放熱器の脚ピン 2 本を同時に基板の穴へ差します（脚のピッチ 30mm）。タブは放熱器側（実装図の HS1 側）を向きます。ピンは 1 = G、2 = S（タブと共通）、3 = D で、四角パッドが 1 番（ゲート）です。

## STEP 6: セラミック・フィルムコンデンサ

- 電解以外の 90 個を付けます。0.01µF と 0.001µF など値の近いものを混同しないよう確かめます。
- C66〜C69（3300pF）は XIAO の PDM 出力（I・Q）を平滑する RC の部品です。C0G（NP0）かフィルムを使い、I と Q で値がそろうよう同じ袋のものを付けます。残ったずれは調整手順 12 のファームウェアの補正で打ち消します。
- PA 出力 LPF・2 倍波トラップの C98（39pF）・C99（82pF）・C101（100pF）・C102（68pF）・C100（5pF）、同調用の C1（10pF）・C4（5pF）・C8（27pF）・C16（15pF）・C17〜C21（ラダー）・C24・C31（33pF）・C84・C86・C90（15pF）は NP0（CH）特性のものを使います。2.54mm ピッチの品がない 27p・82p・120p・3300p は 5mm ピッチ品の足を寄せて使います。
- C59（0.01µF、セラミック）・C60（0.068µF、フィルム）は 2mm ピッチの穴（電解用と同じ大きさ、極性マークなし）に足を合わせて差します（無極性なので向きは自由）。

## STEP 7: 電解コンデンサ

- 計 20 個。足の長い方（＋）を四角パッドに合わせます。
- C58 は＋が Q14 側、C61 は＋が L7・C60 側、C63 は＋が R50 側、C65 は＋が U5A の出力側、C70 は＋が R54・C67 側、C72 は＋が R56・C69 側です。向きはすべて実装図の四角パッドに従ってください。
- C96（100µF、送信 12V のバルク）はふた裏のスピーカーのマグネットの真下に来るので、寝かせて付けるか高さ 7mm 以下の品を使います。

## STEP 8: コイル・インダクタ

- L3・L12・L13・L14（FCZ 7T50 = 07S50）。5 本足で向きは穴の並びで決まります。ケースの爪 2 本も長穴に差し、基板に密着させてからはんだ付けします（爪は GND。シールドになります）。
- L4（8.2µH）・L5・L6（4.7µH）・L7（15mH）・L8・L9（100nH）・L10・L11（1mH）・L20（10µH）は縦置きのインダクタ（AL0510 など）。値の取り違えに注意します（特に L5・L6 の 4.7µH と L4 の 8.2µH）。
- L15（270nH）は縦置き 2.54mm です。本体を 1 番の穴（C92 側）の上に立て、もう一方の足を折り返して 2 番（Q19 ゲート側）へ差します。RFC1（10µH）は横置き 15.24mm です（スピーカーのマグネットの下なので寝かせて付ける）。

### 受信の同調コイル L1・L2 の巻き方（T30-6）

- コア: T30-6（黄）、線: 0.4mm ポリウレタン線を約 20cm、巻き数: 11 回（すき間なく均等に、コアの約 3/4 周に広げる）。
- L1: GND 側（3 番）の端から 2 回目のところで線をよじってタップを出します（タップ = 2 番、アンテナ側）。1 番が Q2 のゲート側です。
- L2: RX12V 側（3 番）の端から 3 回目のところでタップを出します（タップ = 2 番、U1 の入力側）。1 番が Q3 のドレイン側です。
- タップの線は被覆を取ってよじり、予備はんだをします。巻き終わったら番号を書いたテープを付け、L1 と L2 を取り違えないようにします。
- 同調は TC1・TC2（30pF）で取ります（計算では TC1 約 11pF・TC2 約 18.5pF）。

### PA 出力 LPF・トラップのコイル（T-50-10・T-30-6）

- L19: T-50-10 に 0.6mm 線 8 回（約 0.20µH、アンテナ側）、L16: 9 回（約 0.25µH、ドレイン側）、L17: 10 回（約 0.31µH、中央）。
- L18: T-30-6（黄）に 0.4mm 線 8 回（約 0.23µH、2 倍波トラップ）。
- 巻き数を取り違えないよう、巻いたら番号を書いたテープを付けてから取り付けます。

### 空芯コイルの巻き方（L8・L9 を空芯で代用するとき）

L8・L9 は Si5351 の CLK0・CLK1 出力の LPF の 100nH です。市販の 100nH（AL0510 相当）が手に入らないときは、空芯コイルで代用します。2 個とも同じものを作ります。

- 線: 0.6mm ポリウレタン線を 1 個あたり約 12cm
- 巻き芯: 直径 4.4mm の丸棒（4.4mm のドリルの柄など）。線の中心で測った直径が約 5mm になります
- 巻き数: 5 回、巻き幅: 約 3.9mm（1 回目の線の端から 5 回目の線の端まで）。このとき約 100nH

(1) 線を約 12cm に切り、端を 15mm ほど残して、芯にすき間なく 5 回巻きます。巻き終わりも 15mm ほど残して切ります。

(2) 芯から抜き、両端を軽く引いて巻き幅を約 3.9mm に広げます（1 回あたり約 0.8mm、すき間は約 0.2mm）。

(3) 巻き始めと巻き終わりの線を、コイルの両端の下側から真下へ出るように曲げ、足の間隔を基板の穴の間隔（2.54mm）に合わせます。

(4) 足の先 5mm ほどの被覆を取り、予備はんだをします（380℃ 前後のこてで被覆が溶けます）。

(5) コイルを寝かせて基板から 1〜2mm 浮かせて付けます。L8 と L9 は軸を 90° ずらして、互いの結合を小さくします。U6（Si5351）のソケットに触れないようにします。

(6) LCR メーターや NanoVNA があれば 100nH 前後になっているかを測ります。巻き幅を縮めると増え、広げると減ります。±10% 程度に入っていれば十分です。

## STEP 9: 半固定抵抗・トリマ

- VR3・VR4（GF063P 500Ω）、VR5・VR6（GF063P 1kΩ）、VR7（3266W 500Ω）を付けます。VR3〜VR6 は中点、VR7 はゲート電圧最小（GND 側いっぱい）にしておきます。
- TC1〜TC3（30pF）、TC4（10pF）を付けます。

## STEP 10: リレー・コネクタ・電源線

- K1（G5V-2 DC12、12V コイル品）を付けます。穴は φ1.0 なので足はそのまま入ります。
- J3・J5〜J12 のピンヘッダと、J4（AE-ADS1015 を差すソケット）を付けます（働きは 5 章の表）。
- J2（電源入力、基板の左辺の前寄り）は AWG20（0.5sq）の電線を穴（φ1.1mm）に直接はんだ付けします。四角パッドが +12V（1 番）、丸パッドが GND です。
- J1（アンテナ入力）は同軸ケーブル（RG-174 など）を直接はんだ付けします。四角パッド（1 番、φ1.1mm）に芯線、丸パッド（2 番）に編組をよじって付け、編組の引き出しはできるだけ短くします。

## STEP 11: DC-DC・モジュール

- U8（5V DC-DC、RECOM R-78E5.0-1.0）: 四角パッドがモジュールの 1 番ピン（Vin）。向きを実装図で確かめて差します。
- U3（AD8307）・U5（NJM2904）・U6（Si5351 モジュール）・J4（AE-ADS1015）は、通電前のチェック（6 章）のあとに差します。
- J4 の AE-ADS1015 は、差す前にモジュール裏の SDA・SCL のプルアップ用はんだジャンパを短絡します。I2C の線（Si5351・ADS1015・表示器の OLED）には、ほかにプルアップ抵抗がありません（Si5351 モジュールと XIAO には付いていない。AE-ADS1015 は出荷時は未接続）。
- XIAO ESP32C3 はふちが端子の基板なので、先に 1×7 のピンヘッダを 2 本はんだ付けしておきます（基板の穴は φ1.0 で 0.64mm 角の足が入ります。抜き差ししたいときは基板側に 1×7 のピンソケットを 2 本付けます）。
- 最後に XIAO ESP32C3 を差します（部品面を上にし、USB 端子が基板の右辺を向く向き。実装図の「U7 (XIAO)」に合わせる）。

## STEP 12: 基板の固定

- 4 隅の M3 取付穴（GND）にスペーサーを付け、ケースに固定します。

# 4. 部品配置図

基板表面（部品面）の部品配置図です。部品は 13 のブロック（色分け）にまとめてあり、ブロックの番号が組み立ての順の目安です。ブロック別の拡大図と部品表は docs/PSN_TRX_部品実装図.pdf を見てください。

## 4.1 全体図（ブロック色分け）

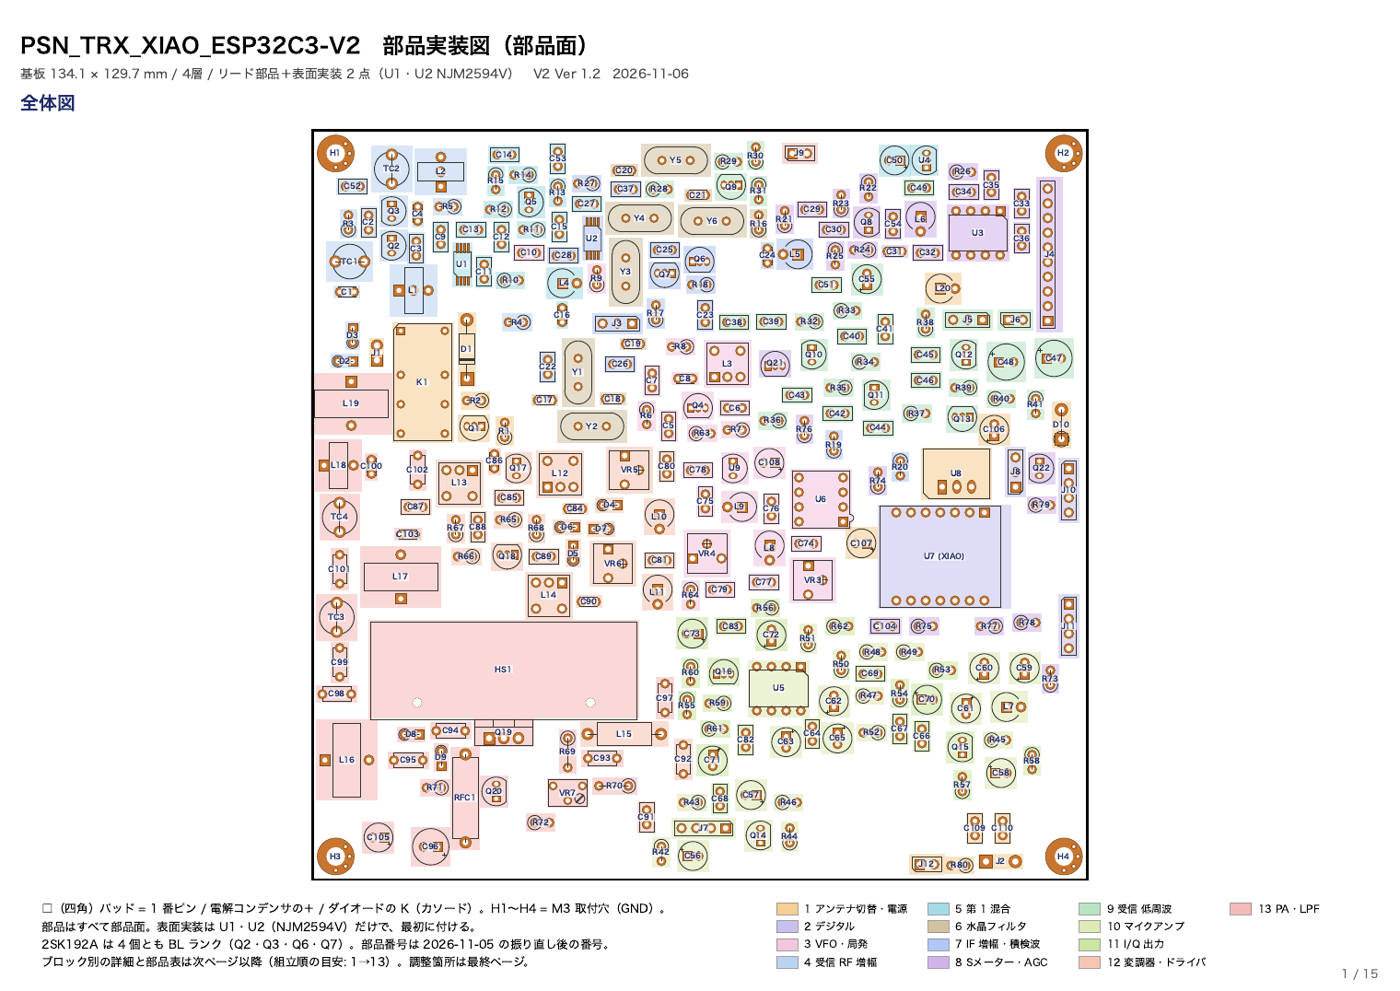
[picture p8: figure]

## 4.2 調整箇所

赤枠が調整する部品、丸数字が manual/調整手順.md の手順の番号です。

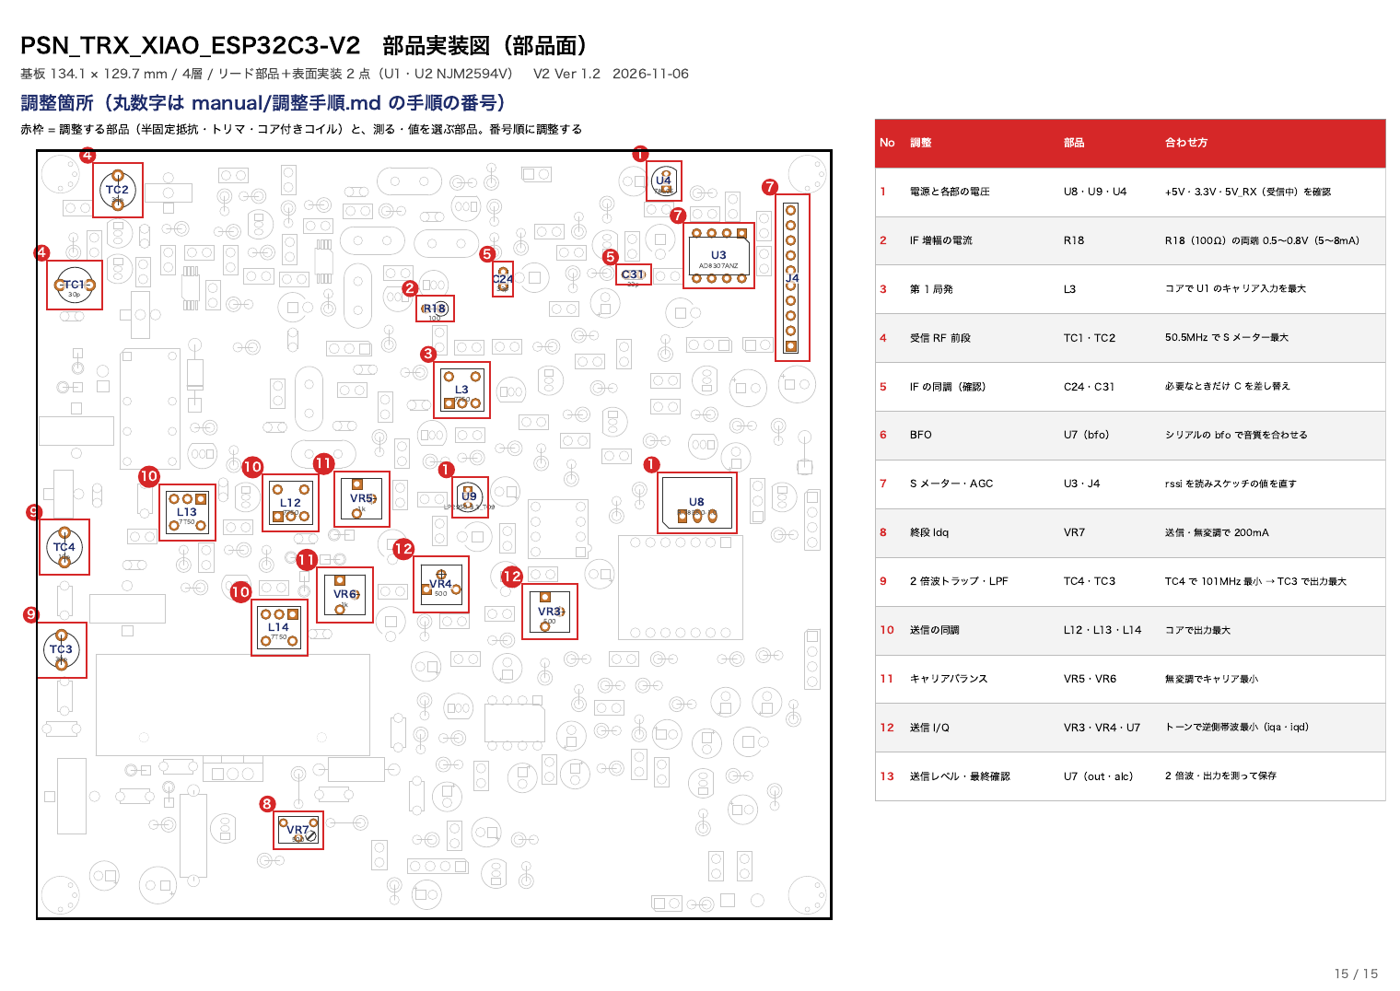
[picture p9: figure]

# 5. コネクタとパネル部品の配線

## 5.1 基板のコネクタ

コネクタ | 名前 | ピン配置 | つなぐパネル部品
J1 | RF_IN（じか付け） | 1: 芯線 / 2: 編組（GND） | 後面の BNC（アンテナ）。同軸ケーブル（RG-174 など）を基板にじか付けし、短く
J2 | PWR_IN（じか付け） | 1: +12V（四角）/ 2: GND | 後面の DC ジャック → ヒューズ → 電源スイッチ（ふた上面、LCD の窓の下）→ J2（AWG20 をじか付け）
J3 | Volume（RF ゲイン） | 1: R17 経由 RX12V / 2: ワイパー（AGC の線、Q3・Q7 のゲート）/ 3: GND | 上面の RF ゲインつまみ VR1（10kΩ B カーブ。R17 20kΩ との分圧で、右いっぱいのとき AGC の線が約 4.0V）。AGC はこのつまみで決めた感度を上限に働くので、AGC を使うときも必ずつなぐ
J4 | AE-ADS1015 | モジュールを差す（VDD = XIAO 3V3、ADDR = GND、A0 = AD8307 の出力） | 基板上（パネル部品なし）
J5 | Volume（AF） | 1: 入力 / 2: ワイパー / 3: GND | 上面の AF 音量 VR2（10kΩ A カーブ）
J6 | SP-OUT | 1: 音声出力 / 2: GND | イヤホンジャック（スイッチ付き）とスピーカー（8Ω）
J7 | MIC-IN | 1: +5V / 2: MIC / 3: PTT / 4: GND | 上面のマイクコネクタ（4 ピン）
J8 | I2C_OUT-LCD | 1: SDA / 2: SCL / 3: GND | OLED を使うときだけ（電源は 3.3V を別に）。Nextion 表示器では使わない
J9 | TX-ON-LED | 1: LED のカソード側 / 2: LED のアノード側（R72 1k から TX12V） | 上面の送信表示 LED1（3mm、TX、φ3.0 穴、RF ゲインのつまみの後ろ）。J9 は基板の右側の辺の前寄り
J10 | Encoder | 1: A（D3）/ 2: B（D1）/ 3: SW（D9）/ 4: GND | 上面のロータリーエンコーダ（押しスイッチ付き）。ケーブルは MIC と反対の向き（ケースの右奥）へ出す
J11 | NX4832T035 | 1: GND / 2: TX（D6）/ 3: RX（D7）/ 4: +5V | LCD NX4832T035（3.5 インチ）。J11.2 → LCD の RX、J11.3 → LCD の TX
J12 | POWER-LED | 1: LED のアノード側（R80 10kΩ 経由 +12V）/ 2: GND | ふた上面の電源 LED（LCD の窓の下、POWER の右）（3mm、高輝度品。電流は約 1mA）

## 5.2 電源の系統（後面 → 電源スイッチ → 基板）

後面 DC ジャック（+12V）─┬─ ヒューズ（1A）─ 電源スイッチ（ふた上面、LCD の窓の下）─ J2.1（+12V）

左側面 DC ジャック（+12V）─┘ 基板の中: +12V ─ R80 10kΩ ─ J12.1 ─ 電源 LED（3mm）─ J12.2（GND）

DC ジャックの GND ─────────────────────────────── J2.2（GND）

ヒューズは速断 1A を目安にしてください（PA の Idq 0.2〜0.4A ＋ 送信時の電流 ＋ 受信部・表示器）。電源 LED は基板の R80（10kΩ）で約 1mA にしているので、高輝度品を使ってください。

電源関係（DC ジャック・ヒューズ・電源スイッチ・電源 LED・J2）はケースの左側、アンテナ（BNC・J1）は右寄りに集めてあります。電源線はケースの左の側板に沿わせ（＋12V で約 175mm）、PA の出力 LPF（基板の後ろの端）と BNC の上を通さないでください。＋12V と GND の 2 本はより合わせます。2 つの DC ジャックに同時に電源をつながないでください。

## 5.3 配線の要点

- RF ゲイン（J3）: 上面の RF つまみ（10kΩ B のパネル取付ボリューム、φ7.2 穴。5kΩ を使うと AGC の線が約 2.4V までしか上がらず、Q2・Q6 の電圧が足りなくなる個体がある）を J3 につなぎます（J3.1 = 上端、J3.2 = ワイパー、J3.3 = GND）。右いっぱいで最大感度です。
- AF 音量（J5）・マイク（J7）の配線はシールド線かツイストペアを使い、PA・アンテナの配線から離してください。
- LCD（J11）の配線は 4 芯で、+5V と GND を確実につなぎ、TX/RX は交差させます（J11.2 → LCD の RX、J11.3 → LCD の TX）。
- エンコーダ（J10）のケーブル: ふた裏の MIC コネクタの本体（φ20、ふた裏に約 25mm）と J10 のすき間は約 0.9mm しかありません。J10 に差すコネクタは低いものを使い、ケーブルは MIC と反対の向き（ケースの右奥）へ倒して出してください。ふたを閉める前に、MIC の本体がコネクタに当たらないことを確かめます。
- イヤホンジャックのブレーク接点を通してスピーカーをつなぐと、イヤホンを挿したときにスピーカーが切れます。
- アンテナ（J1）は同軸ケーブルで BNC から最短でつなぎます。

# 6. 通電前のチェックリスト

- ☐ 全部品のはんだ付けにブリッジ・いもはんだがないか目で確かめた（特に U1・U2 の TSSOP-8）
- ☐ 電解コンデンサ・ダイオード・トランジスタ・IC の極性・向きをもう一度確かめた
- ☐ D10（1N5819）の向き（四角パッド = カソードが XIAO 側）を確かめた
- ☐ Q1（2SA1015）・Q12（2SA950）・Q13（2SC2120）・2SK192A・2SK439・U4・U9 を取り違えていない
- ☐ L1（GND 側から 2 回目）と L2（RX12V 側から 3 回目）のタップの位置、L5・L6（4.7µH）と L4（8.2µH）を確かめた
- ☐ L19 が 8 回、L16 が 9 回、L17 が 10 回、L18（T-30-6）が 8 回巻きで、C98・C99・C101・C102・C100・TC3・TC4 が付いている
- ☐ R53〜R56・C66〜C69（PDM の RC）は I と Q で同じ値の部品を付けた
- ☐ AE-ADS1015（J4）の裏のプルアップ用はんだジャンパを短絡した
- ☐ Q19 に放熱器 HS1 を固定し、放熱器の脚ピン 2 本が基板の穴に入っている
- ☐ VR7（Idq）をゲート電圧最小（GND 側いっぱい）にした
- ☐ J2（+12V）と GND の間、RX12V・TX12V・+5V と GND の間に短絡がないことをテスターで確かめた
- ☐ ヒューズ・電源スイッチ・電源 LED（J12、アノードが 1 番）の配線を確かめた
- ☐ J10（エンコーダ）のケーブルを MIC と反対の向きへ出し、ふたを閉めても MIC の本体に当たらないことを確かめた
- ☐ 安定化電源の電流制限を絞った状態（300mA）で最初の通電をする準備ができた

最初の通電は、XIAO・Si5351・ADS1015・U3・U5 を差さずに行い、異常な電流が流れないことを確かめます。電源を切ってモジュールを差し、受信状態で +5V（U8 の出力）・3.3V（U9 の出力）・5V_RX（U4 の出力）を確かめ、PTT を押して（J7.3 を GND）K1 が動き、+5V・3.3V が保たれることを確かめます。

# 7. 調整

調整は manual/調整手順.md のとおり、受信 → 送信の順に行います。番号は 4.2 の調整箇所の丸数字と同じです。送信の調整は必ず 50Ω のダミーロードをつないで行います。XIAO にはあらかじめ最新のスケッチを書き込み、シリアルモニタ（115200bps・改行あり）を使います。

No | 調整 | 部品 | 目標
1 | 電源と各部の電圧 | U8・U9・U4 | +5V・3.3V・5V_RX（受信中）、R3 の両端 0.46〜1.05V
2 | IF 増幅の電流（Q6・Q7） | R18 | R18（100Ω）の両端 0.5〜0.8V（5〜8mA）
3 | 第 1 局発 | L3（コア） | U1 のキャリア入力が最大（0.3〜1.0Vpp）
4 | 受信 RF 前段 | TC1・TC2 | 50.5MHz で rssi 最大
5 | IF の同調（確認） | C24・C31 | 調整不要（症状があるときだけ）
6 | BFO | シリアルの bfo | 音声の帯域 300〜2700Hz
7 | S メーター・AGC | スケッチの値 | S9（−73dBm）で S9 を指す
8 | 終段 Idq | VR7 | 無変調の送信で 200mA
9 | 2 倍波トラップ・出力 LPF | TC4 → TC3 | 101MHz が最小 → 出力最大
10 | 送信の同調 | L12・L13・L14（コア） | 出力最大
11 | キャリアバランス | VR5・VR6 | 無変調でキャリア最小（−30dBm 以下）
12 | 送信 I/Q | VR3・VR4・iqa・iqd | 逆側帯波 40dB 以上（manual/送信IQ調整手順.md）
13 | 送信レベル・最終確認 | out・alc | 出力・2 倍波・Idq を確かめて保存

TC4 を合わせないと 2 倍波が十分に下がらず（計算で −30dB 程度）、アマチュア局の新スプリアス規定を満たさないことがあります。スペクトラムアナライザがないときは、L18・C100・TC4 を付けた後、送信回路の電源を入れる前にディップメーターで L18＋C100∥TC4 を 101MHz に合わせます。

# 8. 動作の確認

- 受信: アンテナ（後面の BNC）をつなぎ、わかっている信号を受信してスピーカー・イヤホンから音が出ることを確かめる。
- AF 音量・RF ゲインのつまみで音量・感度が変わることを確かめる。
- エンコーダで周波数が変わり LCD の表示が追いつくこと、つまみを押すと設定モード（RIT・STEP・AGC）に入って設定を変えられることを確かめる。受信信号で S メーターが振れることも確かめる。
- 送信: マイクの PTT を押すと K1 が切り替わることを確かめる（上面の TX ランプは出力約 10mW 以上で点く）。送信中も LCD の表示が消えないこと。
- 送信出力をパワー計またはダミーロード＋オシロスコープで確かめ、異常な発振がないことを確かめる。送信開始の 0.45 秒は無音になるのが正常。
- 送信のあと、Idq（VR7 の設定）が変わっていないかもう一度確かめる。

送信の試験は必ずダミーロードをつなぎ、必要な無線局の免許などの法令の要件を満たしたうえで行ってください。スプリアスはスペクトラムアナライザで確かめることを推奨します（評価試験報告書 6.3）。
