kazushinjo/PSN_TRX_XIAO_ESP32C3-V2/docs/PSN_TRX_評価試験報告書.docx

PSN_TRX_XIAO_ESP32C3-V2

評価試験報告書

対象リポジトリ: kazushinjo/PSN_TRX_XIAO_ESP32C3-V2

対象ファイル: kicad/PSN_TRX.kicad_sch, kicad/PSN_TRX.kicad_pcb, PSN_TRX_XIAO_ESP32C3/PSN_TRX_XIAO_ESP32C3.ino, PSN_TRX_XIAO_ESP32C3/tx_dsp.cpp

試験日: 2026-11-11（基板シルク V2 Ver 1.4）

試験者: JA6FUF (kazushinjo) / Claude Code 支援

関連文書: PSN_TRX_回路図論理検証レポート.docx、kicad/production/JLCPCB_提出資料.md、manual/調整手順.md

# 1. 概要

基板シルク V2 Ver 1.4 の KiCad プロジェクト（4 層、7 ブロックの配置、受信は IF 12MHz の SSB シングルスーパー、送信 AF の I/Q は XIAO の複素 FIR、PA 出力は 7 素子チェビシェフ＋2 倍波トラップ）とスケッチを対象に、次の 2 段階で評価した。

- 基板を発注してよいかの判定: ERC・DRC、回路図と基板の整合、高周波配線の長さ・デジタル部との距離
- 回路の働きの妥当性: 回路のつながりの確認と、データシートの値・回路定数による計算（ngspice の回路シミュレーションを含む。6.5）

後者は実測を伴わない検討で、動作を保証するものではない。実機は未確認。

# 2. 試験方法

- kicad-cli sch erc --severity-all: 回路図の電気的ルールチェック
- kicad-cli pcb drc --severity-all --schematic-parity: 基板の設計ルールと回路図・基板の整合
- kicad-cli sch export netlist ＋ Python: 全ネットの接続・直流バイアス経路の追跡
- pcbnew の Python API: 配線長・ビア数・部品間の距離
- データシートとの照合: RD06HVF1（三菱電機）、2SK192A（東芝）、NJM2594、AD8307、LP2950、Si5351（位相オフセット）
- KiCad 同梱の ngspice（libngspice を Python から呼ぶ、kicad/sim/run.sh）: 直流動作点（dc.py）、AF 系（af.py）、PA 出力 LPF・PA 入力・DC-DC 入力フィルタ・AGC（rf.py）、過渡解析（tran.py）、受信部（rx.py）、回路全体（full.py）、ブロックごとの確認（blocks.py）。I/Q の位相差・抑圧比は iq_scan.py・sideband.py（ファームウェアと同じ FIR 係数）

# 3. 基板発注可否の判定

## 3.1 基板の仕様

項目 | 内容
外形 | 134.1 × 129.7 mm（M3 取付穴 4 か所、GND パッド付き）
層構成 | 4 層: F.Cu 信号 / In1.Cu GND 全面 / In2.Cu RX12V 全面 / B.Cu 信号。F.Cu・B.Cu の空いたところは GND ベタ
部品 | 285 フットプリント（回路部品 280、放熱器 HS1、取付穴 H1〜H4）。表面実装は上面の U1・U2（NJM2594V、TSSOP-8）だけで、ほかはすべて上面のリード部品
配置 | 7 ブロック: アンテナ切替・電源（ANT/T-R/PWR）／受信高周波（RX RF）／受信低周波（RX AF）／送信高周波（TX RF）／VFO（Si5351）／デジタル（DIGITAL）／送信低周波（TX AF）
配線 | 1,411 本（総延長 約 4.4 m）。0.25 mm（デジタル）・0.4 mm（信号）・0.8 mm（電源・PA 出力系、TX12V は全区間）、XIAO・Si5351 まわりの一部 43 本は 0.2 mm
ビア | 177 個（0.6/0.3 mm 169 個、0.8/0.4 mm 8 個）。うち GND ステッチ 144 個
設計ルール | クリアランス 0.2 mm、基板端 0.5 mm
シルク | 「Designed by JA6FUF / V2 Ver 1.4」（上面右下）

## 3.2 試験結果のまとめ

項目 | 結果 | 備考
ERC（回路図） | 未除外の違反 0 件 | 基板外のパネル部品 VR1・VR2・LED1 の 8 ピンは除外設定
DRC（基板ルール） | 違反 0 件 | ベタ再充填後
未配線 | 0 件
回路図と基板の整合 | 0 件 | HS1・取付穴は基板専用部品
部品形とライブラリ | 問題 0 件

## 3.3 部品形の確認（2026-11-05）

全部品の部品形（フットプリント）を実部品・データシートと照合し、見つかった誤りを V2 Ver 1.1 で直した。

部品 | 内容 | 対応
U7（XIAO ESP32C3） | 列の間隔が 11.43 mm で、ピンの並びが鏡写しだった | Seeed 公式の並び（列の間隔 15.24 mm、上の列が右から D0〜D6）に修正
U6（Si5351 モジュール） | ピン番号が鏡写しだった | 上から見て 1 番（VDDO）が左上の DIP-8 の並びに修正
L20・RFC1（10µH） | AL0510（長さ 14 mm）が 12.7 mm の横置きに入らない | L20 は縦置き（2.54 mm）、RFC1 は横置き 15.24 mm（スピーカーのマグネットの下なので寝かせる）
J2（電源入力） | ピンヘッダでは太い電線が使えない | 電線のじか付け用（5.08 mm、穴 φ1.1 mm、AWG20。V2 Ver 1.2 で基板の左辺の前寄りへ移し、穴を電流 1A 弱に合わせた）
J1（アンテナ入力） | ピンヘッダでは同軸の編組の付け方があいまい | 同軸ケーブルのじか付け用（2.54 mm、穴 φ1.1 mm。1 = 芯線、2 = 編組。V2 Ver 1.2）

## 3.4 高周波配線とデジタル部の分離

主な高周波ネットの配線長を示す（pcbnew で集計）。ビアは CLK2 と第 1 局発の U1 入力の 1 個ずつだけ。

ネット（区間） | 配線長 | ビア
J1 → K1（アンテナ） | 5.1 mm | 0
K1 → L1 のタップ（D2・D3 を含む） | 35.2 mm | 0
L1 → Q2 ゲート（TC1・C1 を含む） | 18.8 mm | 0
Q3 ドレイン → L2（TC2・C4・R5 を含む） | 15.5 mm | 0
L2 のタップ → C9（U1 の入力） | 11.1 mm | 0
Si5351 CLK0 / CLK1 / CLK2 の出力 | 12.5 / 17.4 / 28.1 mm | 0 / 0 / 1
VR3・R63 → C5（局発）・C80（変調器 1） | 46.5 mm | 0
Q4 → L3、L3 → R8 | 9.8 / 5.1 mm | 0
R8・R9 → C10（U1 のキャリア入力） | 40.3 mm | 1
C15 → L4・C16、L4 → Y1 | 13.1 / 13.4 mm | 0
Y6 → Q6 ゲート（R16 を含む） | 14.6 mm | 0
Q7 ドレイン → L5・C24・C25・R21 | 31.2 mm | 0
L12 → Q17 ゲート | 5.4 mm | 0
L14 → C92（PA 入力） | 38.2 mm | 0
Q19 ゲート / ドレイン | 22.8 / 14.3 mm | 0
出力 LPF の中間（C94–L16、C99、C101） | 26.4 / 41.0 / 38.6 mm | 0
LPF の出口 → K1（C103 を含む） | 33.4 mm | 0

XIAO（U7）から受信初段 Q2 までは 109.7 mm、入力同調 L1 までは 104.4 mm 離れている。5V DC-DC（U8）も XIAO の近く（デジタルブロック）にあり、Q2 から 104.5 mm。Si5351（U6）はデジタルブロックの隣の VFO ブロックにあり、XIAO との距離は 21.5 mm、局発バッファ Q4 とは 29.9 mm。アナログ信号の配線はデジタル領域を通さず、デジタル配線はデジタル・VFO 領域の中に収めた。電源入力 J2 は基板の左辺の前寄り（ケースの電源スイッチ・DC ジャックの側）にあり、+12V は J2 から L20 まで約 111mm（0.8mm、ビア 3 個）を基板の前半分に通して、PA（Q19・出力 LPF）から離した（V2 Ver 1.2）。

## 3.5 結論（発注可否）

DRC 違反 0・未配線 0・整合 0 で、製造データとしては発注してよい状態である。ガーバー・ドリルデータと JLCPCB 用の BOM・CPL は kicad/production/ にある（2026-11-11 に V2 Ver 1.4 の基板から kicad/make_production.py で出力）。6.3 の PA 出力 LPF とスプリアスは実測で確かめること。

# 4. FCZ コイル（L_FCZ07S_CT）の部品形の確認

サトー電気 FCZ コイル 7mm 角（07S、50MHz 用 7T50）の JARL 公開資料の寸法表と KiCad の部品形を照合した。使っているのは L3（第 1 局発 38.5MHz、C8 27p）と L12〜L14（送信 50.5MHz、15p）。

項目 | 公式値（JARL 資料 07S 寸法表） | 部品形の値 | 判定
外形（A） | 7.2 mm 角 | fp_rect −3.6〜3.6 = 7.2 mm 角 | 一致
ピン間隔（B） | 4.5 mm | パッド座標 ±2.25 mm = 4.5 mm 間隔 | 一致
ケースの爪の幅（C） | 1.0 mm | パッド 5 と同じ GND の長穴 1.4 × 0.7 mm を 2 か所（ケースの辺の中央、±3.5 mm） | 一致（V2 Ver 1.3 で追加）
ピン径（D） | 0.7 mm | 穴径 1.0 mm（余裕 0.3 mm） | 一致

V2 Ver 1.2 までの照合では寸法表の C（ケースの爪の幅）をピン径と読み違え、爪の穴がないことを見落としていた。V2 Ver 1.3 で寸法図（FCZ 研究所）を読み直し、爪の長穴を足した。爪はケースの GND で、パッド 5（リンク巻線の AB、4 個とも GND）と同じ番号にしたので回路図は変わらない。

pad1（+2.25, +2.25）・pad2（+2.25, 0）・pad3（+2.25, −2.25）が縦一列に並び、2 番ピンが中間にある配置は、公式資料の「2 番ピンを中心に 1 番・3 番ピンとの間でバランスをとる」記述と合う。L3 は FCZ 07S50（0.68µH、コアで 0.51〜0.80µH）で 38.5MHz に必要な 0.57µH がコアの範囲内に入る（6.5）。

# 5. 回路の働きのレビュー

ネットリストの解析と設計資料との照合による机上のレビューである。

## 5.1 受信の前段・第 1 混合

入力同調 L1（T30-6 11T、GND 側から 2 回目のタップがアンテナ）→ RF 増幅 Q2・Q3（2SK192A-BL のカスコード、AGC は上段 Q3 のゲート）→ 出力同調 L2（RX12V 側から 3 回目のタップ）→ U1（NJM2594V）の構成。R5（2.2kΩ）で L2 を制動して前段の利得を約 23dB に抑え、混合器に入る信号を小さくしている（その分は AF 前置増幅 Q9 で戻す）。局発は CLK0（38〜39MHz）を Q4 で受けて L3 で取り出し、R8・R9 で約 350mVrms にして U1 のキャリア入力へ入れる。

## 5.2 12MHz ラダーフィルタ・IF 増幅・積検波

Q5 の出力を L4・C16 の L 整合で 330Ω にしてラダーフィルタ（Y1〜Y6、C17 82p・C18 100p・C19 120p・C20 100p・C21 82p）へ入れ、出口を R16（330Ω）で終端して IF 増幅 Q6・Q7（2SK192A-BL のカスコード、AGC は上段 Q7 のゲート）で増幅する。Q7 の負荷 L5・C24 から C25 で U2（積検波）へ、R21 から S メーター用の Q8 へ分ける。BFO は CLK2 を R19・R20 で約 100mVrms にして U2 へ入れる。

## 5.3 S メーター・AGC

Q8（L6・C31）→ U3（AD8307、25mV/dB）→ J4（ADS1015）の A0 を XIAO が I2C で読む。AGC は D10 の PWM を R75・C104 で平滑し、R76 → Q21 で J3 の 2 番の線（Q7 のゲート、R4 から Q3 のゲート）を下げる。最大感度は J3 につなぐ RF ゲインのつまみ（VR1）で決まる。

## 5.4 受信 AF

U2 → C37 → R28 → Q9（利得 R29 ÷ R28 ≒ 12）→ R31・C38（LPF）→ Q10 → Q11 → R38 → J5（音量、VR2）→ Q12（2SA950）・Q13（2SC2120）の出力段 → C48 → J6。出力段は R41（100Ω 1W）から給電する。

## 5.5 送信 AF・I/Q

マイク → Q14 → AF LPF（C59・L7・C60、R47 で終端）→ U5A（約 21 倍）→ C65・R52 → U7 の A2。U7 で 16kHz → マイク利得 → ALC → 複素 FIR（127 タップ、中心 1600Hz・通過 300〜2700Hz）→ I2S の PDM（D10 = I、D8 = Q）→ 2 段 RC（3.3kΩ・3300pF ×2）→ Q15・Q16 → L10・L11 → VR5・VR6 のワイパー。

## 5.6 平衡変調器・励振・PA

平衡変調器は 2 組: D4/D5＋VR5（キャリア CLK0、I）と D6/D7＋VR6（キャリア CLK1、Q）。VR5・VR6 がキャリアバランス、VR3・VR4 が CLK0・CLK1 のレベル（RF 側の位相の合わせ込み）。出力は L12（C84 15p、センタータップ GND）で合成し、Q17（2SK439）→ L13 → Q18（2SC1815）→ L14 → L15・C92・C93 → Q19（RD06HVF1）。Q19 のバイアスは TX12V → R70 → VR7 → R69 → ゲート。

## 5.7 送受切替・電源

K1（G5V-2 DC12）の 1 組目でアンテナ、2 組目で電源（RX12V／TX12V）を切り替える。U8（5V DC-DC）は常時、U4（78L05）は受信中だけ動く。詳しくは論理検証レポート 3.3。

# 6. 計算による評価

## 6.1 PA の発熱

アイドル時の損失は約 3.6W（12V × 0.3A）。RD06HVF1 の Rth(ch-c) 4.5℃/W、放熱器 17PB046 の 11.9℃/W、接触の 0.5℃/W として、温度上昇は約 61℃（周囲 25〜40℃ でチャネル約 86〜101℃）と見積もられる。Idq は 200mA から合わせることを推奨する（このとき損失 2.4W、上昇約 41℃）。

## 6.2 Si5351 出力の LPF

Si5351 は CMOS の矩形波を出すので、π 型 LPF（C76・C78 47pF – L8・L9 100nH – C77・C79 47pF）で高調波を減らす。50Ω 終端・理想部品での計算値:

周波数 | 内容 | LPF の減衰（計算）
38〜39 MHz | 受信の局発 | 約 −0.3 dB
50〜51 MHz | 送信のキャリア | 約 −0.3 dB
100 MHz | — | 約 −1.0 dB
150〜153 MHz | 第 3 高調波 | 約 −11 dB
250〜255 MHz | 第 5 高調波 | 約 −26 dB

## 6.3 PA 出力 LPF とスプリアス

7 素子チェビシェフ LPF（C98 39p・L16 9T・C99 82p＋TC3・L17 10T・C101 100p・L19 8T・C102 68p、fc 約 56MHz）のアンテナ側から 2 番目のシャント（C101）に、101MHz の直列共振トラップ（L18 T-30-6 8T ＋ C100 5p ∥ TC4）を付けた。C98 には Q19 の出力容量（Coss 約 18pF）が並列に入る。

周波数 | LPF の減衰（TC4 調整後、計算）
50.5 MHz（基本波） | 挿入損失 0.41〜0.53 dB
101 MHz（2 倍波） | −70.5〜−76.1 dB
151.5 MHz（3 倍波） | −75.3〜−79.8 dB
202 MHz（4 倍波） | −94〜−99 dB

アマチュア局の新スプリアス規定（50MHz 帯: 1W 以下は 50µW 以下＝1W 出力で −43dBc、1W を超え 50W 以下は −60dBc）に対し、PA 自身の 2 倍波を −15〜−20dBc と仮定すると出力の 2 倍波は −85dBc 以下で、どちらも満たす見込み。ただし TC4 を合わせないと LPF の 2 倍波の減衰が約 −30dB に戻る組み合わせがあり、そのときは −60dBc を満たさない。過渡解析の簡易モデルでは出力の 2 倍波 −65〜−77dBc で、−60dBc に対する余裕は 5〜17dB。TC4 の調整と実測は必ず行う。

## 6.4 受信の感度と選択度

前段の雑音指数 0.88dB・電力利得 +22.6dB、混合器の雑音指数を 10〜15dB として全体 1.0〜1.4dB、最小検出信号は帯域 2.4kHz で約 −139dBm（約 0.02〜0.03µV）。選択度は逆側帯波 −33dB（1kHz）・−49dB（2kHz）、隣接 +5kHz −69dB・−5kHz −78dB、イメージ −48dB。

## 6.5 回路シミュレーション（ngspice）

回路図のネットリストから定数を直接読み、KiCad 同梱の ngspice で計算した（V2 Ver 1.4、2026-11-11。kicad/sim/run.sh、結果は kicad/sim/results.txt）。トランジスタはデータシートの代表値から作った簡易モデルなので、実機では測定で確かめること。

項目 | 結果
直流動作点 | 電源 11/12/13.8V・hFE 下限〜上限・2SK192A-BL の個体差（IDSS 12〜24mA・VGS(off) −1.2〜−3V）で全段が動作範囲内。2SK192A は R3・R18 100Ω で 4.6〜10.5mA（標準 7.4mA）。損失の最大は Q12・Q13 の 237mW、Q18 の 212mW。AF 出力段のアイドル 37〜68mA（R41 最大 0.47W、1W 品）
受信の前段（L1・Q2・Q3・L2） | 電力利得 +22.6dB、雑音指数 0.88dB、−3dB 帯域 49.18〜51.88MHz（50.0MHz −0.5dB・51.0MHz −0.4dB）。イメージ 26.5MHz −48.3dB、半 IF 44.5MHz −19.8dB、局発の漏れ −32.5dB、12MHz の素通り −66.4dB。TC1 11.0pF・TC2 18.5pF で同調。AGC（Q3 のゲート 1V）−3.9dB、（0V）−15.7dB
第 1 局発（blocks.py） | L3（FCZ 07S50、0.51〜0.80µH）は 0.57µH で 38.5MHz に同調（コアの範囲内）。U1 のキャリア入力 約 354mVrms、38.0／39.0MHz で −1.8／−1.6dB
混合後増幅（Q5・L 整合） | 電圧利得 +18.7dB（NJM2594 の出力 1kΩ → ラダー 330Ω）
12MHz ラダーフィルタ（水晶の運動定数は仮定 Cm 15fF） | 損失 6.1dB、−3dB 幅 2.22kHz、−6dB 幅 2.56kHz、−60dB 幅 7.7kHz、リップル 3dB。Cm 10〜20fF の水晶では −6dB 幅 1.7〜3.4kHz
IF 増幅・S メーター増幅（blocks.py） | Q6 のゲート → U2 +14.0dB、→ AD8307 +23.0dB（12MHz）。同調点は 12.84MHz・10.25MHz だが帯域が広く、C24・C31 を替えても 12MHz での差は 0.5dB 以下。IF 増幅の AGC は Q7 のゲート 1V で −3.7dB、0V で −15.5dB
BFO（blocks.py） | U2 のキャリア入力 約 102mVrms（NJM2594 の試験条件 100mVrms 以上）
受信のレベル配分（NJM2594 の変換利得 0dB と仮定） | アンテナ端 → 積検波の入力 +60.1dB。S9（−73dBm）で積検波の出力 約 50mVrms、AD8307 の入力 S1 −51.9dBm・S9 −4.0dBm（範囲 −75〜+17dBm）
AGC（Q21） | PWM の平均 0.55〜0.80V（12 ビットで 683〜993）でゲートが 4.0V → 0.1〜0.2V。RF 増幅 −15.7dB ＋ IF 増幅 −15.5dB で計 約 −31dB
受信 AF（U2 → Q9 → スピーカー 8Ω） | 1kHz 基準で 300Hz +0.3dB、2700Hz −2.0dB、利得 41.9dB（音量 0.9）。歪み率 1% 以下は 3.8mW、3% 以下は 23mW、10% 以下は 76mW、最大 約 113mW
受信の全体（full.py、アンテナ → スピーカー） | 約 +101dB（1kHz、音量 0.9。S9 のスピーカー出力は出力段の最大 約 113mW で頭打ち）。音声の −6dB 帯域 300〜2830Hz。逆側帯波 −33dB（1kHz）・−49dB（2kHz）、隣接 +5kHz −69dB・−5kHz −78dB、イメージ −48dB。全体の雑音指数 1.0〜1.4dB（混合器 10〜15dB と仮定）、最小検出信号 約 −139dBm（2.4kHz）
送信 AF（マイク → A2） | 300Hz 0〜+0.1dB、2700Hz −0.5dB（1kHz 基準）。マイク 1Pa で U5A の出力 約 330mVrms、A2 に約 230mVrms。U5A は 3Pa（103.5dB SPL）付近から頭打ち（ADC は範囲内）
送信 PDM 出力 → 変調器入力 | 300Hz 0dB、2700Hz −0.4dB、PDM の 78kHz で −30dB 以下
送信 I/Q | FIR だけでは位相差 90.00°、逆側帯波の抑圧 約 69〜70dB。RC が I/Q で ±3% ずれると 32.6dB、iqd 2.19µs・iqa −0.22dB の補正で 49.6dB
変調器ドライブ（Q15・Q16） | 歪み率 1% は PDM ±12mV（FIR 入力 −23dBFS、出力レベル 10%）まで。ALC の効き始め −20dBFS で 1.2〜1.4%
送信の全体（full.py、変調器 → PA → LPF → 50Ω） | 変調器の音声入力 100mV で 114mW、800mV で 1.68W（最大 約 1.7W、2 倍波 −67〜−90dBc）。キャリアの漏れは VR5・VR6 の中点で −1dBm、合わせると −25dBm（計算の刻みによる）。I と Q の RF 側の位相差は中点で 93.2°（RF 側だけで抑圧 31dB）→ VR3 0.9・VR4 0.6 で 90°
送信の同調（blocks.py） | L12〜L14 は 15pF で 0.55µH（コアの範囲内、41.9〜52.5MHz で合う）
PA 入力 | C92 150p・C93 33p・L15 270nH の L 型整合（V2 Ver 1.4）で、50Ω 源に対し不整合損失 0.2〜0.4dB。ゲート電圧の上限 12V で 7.23V
PA 出力 LPF（7 素子＋2 倍波トラップ） | L ±7%・Coss 18〜25pF の全組み合わせで、TC4 を合わせると 2 倍波 −70.5〜−76.1dB、3 倍波 −75.3〜−79.8dB、挿入損失 0.41〜0.53dB、反射減衰量 21.7dB 以上。TC4 を合わせないと 2 倍波が −30〜−32dB に戻る組み合わせがある
PA 大信号（簡易モデル） | Idq 50/200mA で出力 0.7〜2.5W、出力の 2 倍波 −65〜−77dBc、3 倍波 −91dBc 以下、ドレインのピーク 21〜29.6V（VDSS 50V）
RFC1・DC-DC 入力フィルタ | RFC1 10µH は 51MHz で 1.5kΩ（自己共振 29MHz）。L20/C106 の共振 16kHz のピーク 1.5〜4.1Ω で、R-78E の負性入力抵抗（−58〜−96Ω）より十分小さく安定
送信表示・送受切替（blocks.py） | LED は出力 約 10mW 以上で点灯（約 10mA）。PTT で Q1 のベース電流 2.3mA、K1 のコイル 41.7mA に必要な hFE は 18 で十分に飽和
過渡（電源投入・送信開始） | 電源投入時のスピーカーのポップ音 最大 0.33V（14mW、19ms）。送信開始時の変調器入力の段差は 95〜115ms、マイク系の A2 のずれは 295ms で収まる（スケッチが送信開始から 0.45 秒を無音にする）

基板の変更が必要な結果はなかった。IF・S メーターの同調（C24・C31）は 12MHz からずれているが、帯域が広いので変更不要（調整手順 5）。調整箇所と目標値は manual/調整手順.md にまとめた。

# 7. 総合評価

V2 Ver 1.4 の回路図・基板は、ERC・DRC・整合の確認で問題がなく、計算でも受信・送信の各ブロックが設計どおりに働く見込みである。基板は発注してよい。実機で次を確かめること。

- 電源・各段の直流電圧、2SK192A の電流（調整手順 1・2）
- 第 1 局発・BFO のレベル、受信 RF 前段の同調、BFO による音声の帯域（調整手順 3〜6）
- S メーター・AGC の調整値（RSSI_S9_MV・AGC_TARGET_MV・AGC_DUTY_FULL、調整手順 7）
- PA の Idq、2 倍波トラップ（TC4）と出力 LPF（TC3）、送信の同調（調整手順 8〜10）
- キャリアバランス、送信 I/Q の補正（iqa・iqd）、逆側帯波の抑圧 40dB 以上（調整手順 11・12、manual/送信IQ調整手順.md）
- スペクトラムアナライザでの 2 倍波・3 倍波（−60dBc 以下）と帯域外への広がり、受信時のビート（DC-DC・XIAO）
