kazushinjo/PSN_TRX_XIAO_ESP32C3-V2/docs/images/fp_check/fp_check_08.png

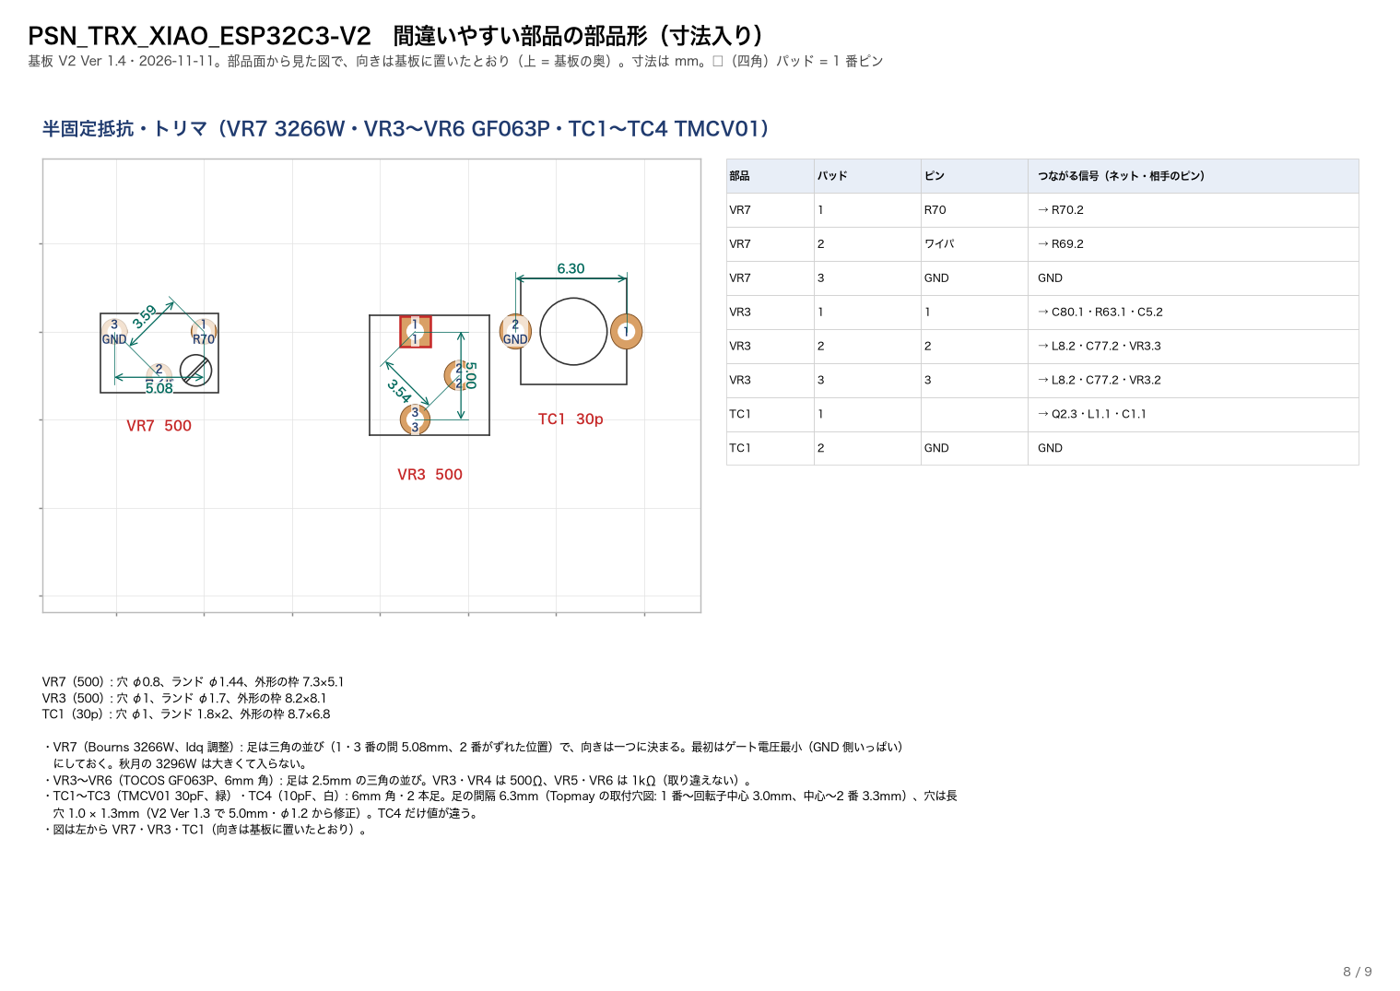
docs/images/fp_check/fp_check_08.png
