kazushinjo/PSN_TRX_XIAO_ESP32C3-V2/enclosure/preview/front_view.png

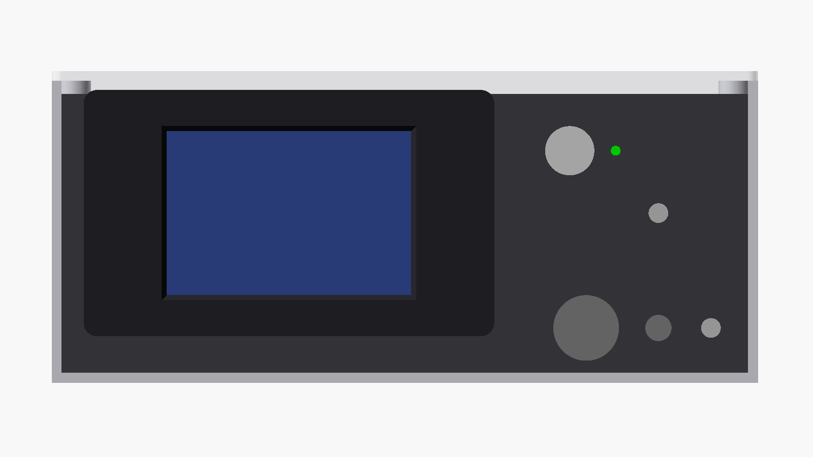
enclosure/preview/front_view.png
