kazushinjo/PSN_TRX_XIAO_ESP32C3-V2/kicad/BOM.md

# PSN_TRX V2 部品表（BOM）

50MHz 帯 PSN 方式 SSB トランシーバ V2（受信部は IF 12MHz の SSB シングルスーパー）。回路図 (`PSN_TRX.kicad_sch`) から `kicad-cli sch export bom` で自動生成した [`bom.csv`](bom.csv) を整形したもの。

> **購入先（2026-10-15、2026-11-04 更新）**: 各表の「購入先」「購入先の型番（販売コード）」列は [`make_bom_purchase.py`](make_bom_purchase.py) で入れたもの。秋月電子の型番・販売コードは 2026-10-15 に秋月の通販サイトで確認済み（V2 で増えた部品は 2026-11-04 に確認）。入数・価格・代替品のメモ付きの一覧は [`bom_purchase.csv`](bom_purchase.csv)（Excel でそのまま開ける）。サトー電気（町田・川崎・横浜）で扱いのある部品をサトー電気から買う版は [`bom_purchase_sato.csv`](bom_purchase_sato.csv)（[`make_bom_purchase_sato.py`](make_bom_purchase_sato.py) で作成、価格は 2026-11-04 に通販カタログで確認。販売コードはないので品名と値で注文する）。「要確認」は秋月で扱いがないか、型番・在庫・販売コードを確かめていない部品（2SK439・2SK192A・1N60・FCZ コイル・RD06HVF1・L15・L8/L9・L4（8.2µH）・R47（620Ω）・マイクコネクタ・電源スイッチ）。2.54mm ピッチ品がない 27p・82p・120p・3300p の C0G は 5mm ピッチ品の足を寄せて使う
> - 代替品: D1 は 1N4001 の代わりに秋月の **1N4007**。C77・C76・C79・C78（47pF）は 2.54mm ピッチ品がないので 5mm ピッチ品の足を寄せて使う
> - U8（R-78E5.0-1.0）・K1（G5V-2-DC12）・VR7（3266W-1-501LF）は秋月に扱いがなく DigiKey／Mouser。秋月の R-78E5.0-0.5 は 0.5A 品、3296W は外形が大きく基板に合わない

> **最終更新: 2026-11-11（V2 Ver 1.4）**
> - **V2 Ver 1.3（2026-11-08、論理チェックの残り項目）**: (1) マイクのバイアスを送信 12V から **+5V** に（R42 の電源側を +5V へつなぎ替え、**R42 470Ω → 1kΩ**）。電源 13.8V でマイクに約 11.2V かかり、耐圧 10V のエレクトレットを超えていたため。マイク電圧は電流 0.1〜0.5mA で約 4.4〜2.2V、感度（R43 4.7kΩ の負荷）は変わらない。基板は R42 の 1 番から J7 の 1 番（+5V）へ 0.5mm の線を 1 本引き、送信 12V の枝 2 本を外した。(2) **C59・C60 の部品形を極性マークなしの `PSN_TRX:C_Radial_D5.0mm_P2.00mm_CPpad` に**（穴・パッドは電解用と同じで、シルクの＋と斜線だけを消した）。(3) I2C のプルアップは AE-ADS1015 の裏のはんだジャンパを短絡する方式にそろえた（購入用部品表の「つながない」は誤り）。(4) **K1（G5V-2）の穴を φ0.7 → φ1.0（ランド φ1.4 → φ1.8）**に（オムロンの推奨。足の断面 0.4×0.5mm に φ0.7 では余裕が約 0.06mm しかなかった）。部品形は `PSN_TRX:Relay_DPDT_Omron_G5V-2_D1.0mm`。(5) **FCZ コイル（L3・L12〜L14）にケースの爪の長穴（1.4 × 0.7mm、GND）を 2 か所ずつ追加**（FCZ 研究所の寸法表の C = 爪の幅 1.0mm。それまでは穴がなく、コイルが浮いてケースも GND につながらなかった）。爪と当たる配線 6 本（PTT・TX12V・AGC・BFO・TX ランプ・L14 の SA）を引き直し（ビア 4 個追加）。(6) **U7（XIAO）の穴を φ0.9 → φ1.0**（0.64mm 角のピンヘッダが入るように）。(7) **部品形のメーカー資料による総点検**: **TMCV01（TC1〜TC4）の足の間隔を 5.0 → 6.3mm**（Topmay の取付穴図: 1 番〜回転子中心 3.0mm・中心〜2 番 3.3mm、穴 1.0 × 1.3mm → 長穴 1.0 × 1.3mm・ランド 1.8 × 2.0mm）。TC1・TC2・TC4 は 2 番（GND）を 1.3mm 外へ、TC3 は 1 番を 0.75mm 上げて 2 番を 0.55mm 下げた。**放熱器 17PB046 の外形を実物どおり**（取付面からフィン側 10mm、Q19 側に両端のつば 7mm）に直し、つばに当たっていた **L15 を縦置き 2.54mm** に、**L16 を左下へ**移した。T-50 縦置きの外形は本体と足だけに。関係する配線 9 区間を引き直し（ビア +3）
> - **V2 Ver 1.2（2026-11-06）**: 電源関係をケースの左に集めるため、J2（電源入力）を基板の左辺の前寄りへ移し、穴を φ1.1mm（AWG20）に。J1（アンテナ）を同軸のじか付け（穴 φ1.1mm）に。J2 の横に +12V のパスコン **C109（0.1µF）・C110（0.01µF）**、電源 LED 用に **R80（10kΩ）・J12（2 ピンヘッダ）** を追加（部品 276 → 280 点）。電源 LED の 2.2kΩ は基板の R80 に置き換え
> - **RF ゲインのつまみ VR1 を 5kΩ → 10kΩ B に（2026-11-05、回路図の再精査）**: R17（20kΩ）との分圧で AGC の線（Q3・Q7 のゲート）の最大を約 4.0V に（5kΩ では約 2.4V）。パネル部品なので基板・製造データは変わらない
> - **V2 Ver 1.1（2026-11-05）**: (1) **部品番号を信号の流れの順に振り直した**（受信: アンテナ → RF 増幅 → 混合 → フィルタ → IF → 検波 → 低周波、送信: マイク → I/Q → 変調 → 励振 → 終段 → LPF、最後に制御・電源。IC は U に統一し U1〜U9）。新旧の対応は [`refdes_map_2026-11-05.csv`](refdes_map_2026-11-05.csv)。この表の番号はすべて新しい番号（下の履歴は当時の番号のまま）。(2) **3SK59 をやめた**（旧 Q2 を削除。IF 増幅は Q6・Q7 の 2SK192A カスコードだけ）。2SK192A は 4 個とも **BL ランク**、ソース抵抗 **R3・R18 を 100Ω** に。(3) **部品形の修正**: U7（XIAO、列の間隔 11.43 → 15.24mm・鏡写しを公式の並びに）、U6（Si5351 モジュール、鏡写しのピン番号）、L20（縦置き 2.54mm）・RFC1（横置き 15.24mm、スピーカーのマグネットの下なので寝かせる）、J2（電源線のじか付け用、穴 φ1.5mm）。(4) ネット名 +9V → **RX12V**（受信中の 12V）、送信中の 12V を **TX12V**、入力を **+12V** と命名。(5) パスコンの配置: C3（Q3 のゲート）・C50（U4 78L05 の出力）・C106・C107（U8 DC-DC の入出力）を足元へ移動
> - **V2 Ver 1.0: 受信部を 12MHz の SSB シングルスーパーに（2026-10-30）**: 受信をダイレクトコンバージョンから、入力同調 L18 → RF 増幅 Q20・Q25（2SK192A-GR カスコード、AGC 付き）→ 出力同調 L19 → 第 1 混合 U4（NJM2594V、局発 38〜39MHz は CLK0 → Q11 → L9）→ 混合後増幅 Q21・L 整合 → 12MHz 水晶ラダーフィルタ（Y1〜Y6）→ IF 増幅 Q2（3SK59、AGC）→ 積検波 U5（NJM2594V、BFO は CLK2）→ AF 前置増幅 Q23 → AF 段 に変更。S メーター・AGC は Q22 → U7（AD8307）→ J11（ADS1015）で測る。U6（78L05）は受信中だけの 5V。部品 202 → 277 点（LED1 を除く）
>   - **追加（86 点）**: R66〜R86・R95〜R98、C80・C82〜C114・C116・C117、L18・L19・L21〜L23、TC3・TC4、D9・D10、Q20〜Q23・Q25、U4〜U7、Y1〜Y6、J11
>   - **削除（11 点）**: Q7（2SC1923、プロダクト検波）、L2・L4（受信の同調）、R8・R10・R12・R37、C3・C16・C20・C50。A2 に受信音は来ない（送信中のマイク入力だけ）
>   - **変更**: C11 15p → 33p（L22 と 12MHz）、C29 15p → 27p（L9 を第 1 局発に）、Q2 は受信 RF 増幅から IF 増幅に、Q4・Q5 は SOT-23（基板裏面）から TO-92（表面）に。J310 は 4 個とも 2SK192A-GR に置き換え（2026-10-31、R66 100Ω → 47Ω）。IC ソケットは U7 の分を足して 3 個。DC ジャックはケースの後面と左側面に 1 個ずつ（並列）
>
> **V1（PSN_TRX_XIAO_ESP32C3）での変更の履歴**（部品番号・役割は当時のもの）
> - **基板 Ver 2.1: IC2 の電源パスコン C79 を追加（2026-10-28）**: +5V ネットのコンデンサが C55（10µF）だけで、IC2（NJM2904）の電源ピンの近くにパスコンがなかったため、C79（0.1µF、円板セラミック 2.5mm ピッチ）を IC2 の 8 番ピンの近く（右下）に追加。部品 201 → 202 点
> - **基板 Ver 2.0: 送信の I/Q をデジタルで生成（2026-10-21）**: AF の 90° 移相を、アナログのオールパス（IC2A・IC2B・VR8）から **U3（XIAO ESP32C3）のファームウェア**に移した。マイク音声を A2 の ADC で読み、複素 FIR（127 タップ、300〜2700Hz）で I・Q を作り、PDM で **D10（I）・D8（Q）** に出して 2 段 RC（R61〜R64・C75〜C78）で平滑して変調器へ入れる。計算上の逆側帯波の抑圧は 70dB、RC が I/Q で ±3% ずれても iqd・iqa の補正で約 50dB。**削除: T1（ST-71）・VR8・R53〜R57・C69・C70**。**追加: R58（620Ω）・R59（22k）・R61〜R64（3.3k）・C73（1µ）・C75〜C78（3300p）**。**変更: IC2A をマイクアンプ（R36 20k・R40 1k・C54 10µ 電解）**、IC2B は未使用。送信検出を D8→**D0** に。A2 は受信中は受信音（S メーター・AGC）、送信中はマイク。D10 は受信中は AGC の PWM、送信中は PDM の I
> - **PA 出力 LPF を 7 素子＋2 倍波トラップに（2026-10-17、基板シルク Ver 1.8）**: アマチュア局の新スプリアス規定（50MHz 帯: 1W 以下は 50µW 以下、1W を超え 50W 以下は −60dBc）を満たすため、5 素子（2 倍波の減衰 −27〜−31dB）を 7 素子チェビシェフ（カットオフ約 56MHz）にし、中央に 101MHz の直列共振トラップを付けた。C6-L3-（C4＋TC1）-L16-（C71＋トラップ）-L1-C1 の順。**C6 を 33p→39p、C1 を 56p→68p、L3 を 9T に、L16（10T）・C71（100p）を追加**、トラップは **L17（T-30-6 8T ≈ 0.23µH）＋C72（5p）∥TC2（10p トリマ）**。ngspice の計算で、L1/L3/L16 ±7%・Coss 18〜25pF の範囲で TC1 8〜16pF、TC2 5〜6.5pF に合わせると、2 倍波 −70〜−76dB、3 倍波 −75〜−80dB、挿入損失 0.41〜0.53dB、反射減衰量 22dB 以上。**TC2 は 2 倍波が最小になるように必ず合わせる**（合わせないと −30dB 程度に戻ることがある）
> - **アナログ部の動作点・フィルタ特性の検証（2026-10-16、基板シルク Ver 1.6）**: KiCad 同梱の ngspice で、各段の直流動作点（電源 11〜13.8V、hFE 下限〜上限）と AF・RF フィルタの特性を計算して修正した。(1) **マイク系**: C66・C62 を 1µ→**10µ**（T1 との直列共振で 300Hz 付近が +7〜17dB 持ち上がっていた）、**C65 を 0.01µ・C63 を 0.068µ** に（1µ では 15mH と Q18 の 1kΩ に合わず、1kHz を基準に 2.7kHz で −12dB、途中に山と谷があった）。変調器入力で 300〜2700Hz が +1〜−3dB に。**C62 は向きを反転**（＋を L15 側に）。(2) **PA 出力 LPF**: **C6 を 56p→33p**（Q3 の Coss 約 18pF が並列に入り、TC1 をどこに合わせても反射減衰量が 10〜13dB しか取れなかった）、**C4 を 100p→82p**（最適な C4＋TC1 が 90〜106pF のため）。(3) **R6 を 470→330Ω**（RD06HVF1 の Vth は最大 4.9V。ゲート電圧の上限を約 6.2V→7.2V に）。VR8 の合わせ値の記載を 5.6kΩ→5.1kΩ（約 310Hz）に訂正
> - **部品番号の振り直し（2026-10-15）**: 部品番号を回路図の位置順（X 座標の小さい順、同じ X は Y の順）に振り直した。欠番（旧 C26・D4・R20・LED1）はなくなり、XIAO ESP32C3 のソケットは U3 になった。新旧の対応は [`refdes_map_2026-10-15.csv`](refdes_map_2026-10-15.csv)。接続・部品・基板の配置と配線は変わらない（ネットリストの接続は振り直し前と同じ、DRC・ERC も同じ結果）。この表の番号はすべて新しい番号
> - **PTT 回路の修正（2026-10-15、基板シルク Ver 1.4）**: Q1 のベースが PTT につながっておらず（ベースは R1 経由で自分のコレクタへ、エミッタが PTT）、PTT スイッチにリレーのコイル電流がそのまま流れていた。**Q1 を PNP の 2SA1015 に替えてハイサイドスイッチに**（エミッタ = PWR_IN、コレクタ = K1.16、K1.1 = GND）、**R1 を 4.7kΩ のベース抵抗（ベース↔PTT）**に、**R2（10kΩ、ベース↔エミッタ）を追加**、D1 の向きをコイルに合わせて反転。PTT を GND に落とすとベース電流約 2.4mA で Q1 がオンし K1 が入る。PTT の電流は約 2.4mA、開放時の PTT 端子は R1＋R2 経由で 12V
> - **S メーター・AGC・送信検出を追加（2026-10-14〜15、基板 Ver 1.3）**: リード部品 12 点（縦置き抵抗 8・円板セラミック 2・2SC1815 2）を追加。基板は元の 134×108 mm のまま。RF 部（ANT/T-R/PWR・TX RF・RX RF・VFO）は元の配置・配線のまま、AF・DIGITAL 部だけを配置し直して入れた（ケースは変更なし）。エンコーダ SW を XIAO の D2 → D9 に変更
> - 回路図論理検証（第2版）の修正を反映: **R41・R43（100kΩ）追加**（IC2A の Vcc/2 バイアス）、**C4（82pF NP0）追加**（PA 出力 LPF）、**L1・L3 を T-50-10 6T に変更**（旧 18T）、**C7 を 0.001µF に変更**（旧 100pF）
> - Q2 は 3SK59（TO-72、挿入部品）。旧 BOM の BF998（SOT-143）から変更済み
> - **論理チェック（2026-10-11）**: 電解 C43・C66・C48・C68・C44 の向きを直流電圧に合わせて修正、XIAO 5V ピンに逆流防止ショットキー D8（1N5819）を追加、R11 を 100Ω に変更（12V 動作での Q8 損失対策）
> - **論理チェック（2026-10-12）**: TO-92 トランジスタ・FET と Q3 のピン配置を実部品に合わせて修正（シルクの平面側に合わせて挿せば正しく付く。下記トランジスタ表の備考参照）、R52 を 2.2kΩ に変更（12V 動作でのマイク電圧対策）、K1 を **12V コイル品（G5V-2 DC12）** と明記
> - **論理チェック第2回（2026-10-12）**: 送信 12V に **C13（100µF）** を追加、マイク電源を **R51（470Ω）＋C67（47µF）** で送信 12V から分離し **R52 を 4.7kΩ** に、PA 出力 LPF を **5 素子**に（**C6・C1（56pF NP0）** を追加、**L1・L3 を T-50-10 8T** に）、エンコーダ A 相を XIAO の **D0 → D3** に変更（起動設定ピン GPIO2 を避ける）。基板シルク「Ver 1.2」
> - **回路図の見直し（2026-10-11）**: L8 のセンタータップを GND に、Q8 コレクタを L6 の 1 番に修正。C54=0.1µF、R32・R29=22Ω、R3=100kΩ に修正
> - **Q2 は選択式**: 3SK59（Q2）または 2SK192A-GR カスコード（Q4 上段 + Q5 下段、TO-92、基板表面）の**どちらか一方のみ実装**する。2SK192A 使用時は R5 を 47Ω にして実機で調整（下記 R5 の備考参照）
> - IC1（5V）を **DC-DC コンバータ R-78E5.0-1.0**（78xx 互換、1A）に変更し、PWR_IN から **L12（10µH）・C52（10µF）** の入力フィルタ経由で常時給電（送信中も 5V/3.3V 系が動作、LCD を含めても発熱しない）
> - J11 は廃止済み。PTT は J10（MIC-IN）の 3 番ピンで、Q1（PNP）が K1 のコイルを 12V 側でオンオフする
> - **基板 Ver 1.5（2026-10-16）**: 空いていた **IC2B を I 側の AF オールパス**に使用（**R53〜R57・C69・C70** を追加、C49 の向きを反転。逆側帯波の抑圧が 300〜2700Hz の最悪値で約 6dB → 約 18dB）、**R27 を 1W** に（静止電流で最大約 0.5W 消費するため）、**C4 を 100pF** に（TC1 が回しきりにならないように）、放熱器を **17PB046（11.9℃/W）** に変更
> - 基板専用部品（回路図にない）: 放熱器 **HS1（秋月 17PB046）**、M3 取付穴 **H1〜H4**

---

## 抵抗 R（固定）

| Reference | 値 / 型番 | フットプリント | 数量 | 購入先 | 購入先の型番（販売コード） | 備考 |
|---|---|---|---|---|---|---|
| R1, R12, R23, R43, R61, R62, R67 | 4.7k | `R_Axial_DIN0207_L6.3mm_D2.5mm_P2.54mm_Vertical` | 7 | 秋月電子 | CF25J4K7B（125472） | R1: Q1（PNP）のベース抵抗（PTT を GND に落とすとベース電流約 2.4mA）。R43: エレクトレットマイクのバイアス（V2 Ver 1.3 から +5V → R42 1kΩ → R43 の順で給電。マイク電圧は電流 0.1〜0.5mA で約 4.4〜2.2V、電源電圧によらない）。R12 は混合後増幅 Q5、R23 は S メーター用増幅 Q8 のまわり（V2 追加） |
| R2, R39, R40, R75, R78, R79, R80 | 10k | `R_Axial_DIN0207_L6.3mm_D2.5mm_P2.54mm_Vertical` | 7 | 秋月電子 | RD25S 10K（125103） | R2: Q1 のベース-エミッタ間（PTT 開放時に Q1 を確実にオフ）。R75: AGC の PWM 平滑。R78: Q22 ベース-GND。R79: 送信検出（D0）のプルアップ。R80: 電源 LED の電流制限（+12V から J12 へ、約 1mA。V2 Ver 1.2 追加） |
| R3, R9, R18, R20, R68 | 100 | `R_Axial_DIN0207_L6.3mm_D2.5mm_P2.54mm_Vertical` | 5 | 秋月電子 | CF25J100RB（125101） | R3: 受信 RF 増幅のカスコード下段 Q2（2SK192A-BL）のソース。R18: IF 増幅のカスコード下段 Q6（2SK192A-BL）のソース（どちらも 100Ω で 5〜8mA。R18 は調整 2 で 47〜150Ω の範囲で合わせる。2026-11-05 に 47Ω・120Ω → 100Ω）。R68: Q18（励振）のエミッタ抵抗（12V 動作で Q18 の損失を抑えるため 100Ω）。R9: 第 1 局発の減衰（R8 と組）、R20: BFO の減衰（R19 と組） |
| R4, R6, R29, R32, R35, R44, R48, R49, R71, R73, R74 | 100k | `R_Axial_DIN0207_L6.3mm_D2.5mm_P2.54mm_Vertical` | 11 | 秋月電子 | CF25J100KB（125104） | R71: 送信検出 Q20 のベース抵抗。R73・R74: A2（マイク入力）を 1.65V にバイアス（3V3／GND 側）。R48・R49: U5A（マイクアンプ）の＋入力の Vcc/2 バイアス。R4: AGC → Q3 のゲート、R29: AF 前置増幅 Q9 の帰還（R4・R29 は V2 追加） |
| R5, R21 | 2.2k | `R_Axial_DIN0207_L6.3mm_D2.5mm_P2.54mm_Vertical` | 2 | 秋月電子 | CF25J2K2B（125222） | R5: L2 の制動（受信 RF 増幅の利得を約 20dB に、L2 のタップ 3 回目）。R21 は S メーター用増幅 Q8 のまわり（V2 追加） |
| R7, R65 | 51 | `R_Axial_DIN0207_L6.3mm_D2.5mm_P2.54mm_Vertical` | 2 | 秋月電子 | CF25J51RB（125510） |  |
| R8 | 470 | `R_Axial_DIN0207_L6.3mm_D2.5mm_P2.54mm_Vertical` | 1 | 秋月電子 | CF25J470RB（125471） | R8: 第 1 局発のレベル（U1 へ約 100mVrms、V2 追加） |
| R10, R27, R30, R31, R33, R36, R37, R42, R45, R50, R72 | 1k | `R_Axial_DIN0207_L6.3mm_D2.5mm_P2.54mm_Vertical` | 11 | 秋月電子 | CF25J1KB（125102） | R42: マイク電源のデカップリング（+5V から、C56 と組。V2 Ver 1.3 で送信 12V → +5V、470Ω → 1kΩ）。R50: U5A の−入力→C63→GND。R10・R27: U1・U2 の出力（エミッタフォロワ）の負荷。R31: AF の LPF（C38 と組）。R30: AF 前置増幅 Q9 のコレクタ負荷（R10・R27・R31・R30 は V2 追加） |
| R11, R22 | 27k | `R_Axial_DIN0207_L6.3mm_D2.5mm_P2.54mm_Vertical` | 2 | 秋月電子 | RD25S 27K（125273） | R11 は混合後増幅 Q5、R22 は S メーター用増幅 Q8 のまわり（V2 追加） |
| R13, R34 | 1.5k | `R_Axial_DIN0207_L6.3mm_D2.5mm_P2.54mm_Vertical` | 2 | 秋月電子 | CF25J1K5B（125152） | R13 は混合後増幅 Q5 のまわり（V2 追加） |
| R14 | 33 | `R_Axial_DIN0207_L6.3mm_D2.5mm_P2.54mm_Vertical` | 1 | 秋月電子 | CF25J33RB（103941） | 混合後増幅 Q5 のエミッタ帰還（バイパスしない、V2 追加） |
| R15 | 180 | `R_Axial_DIN0207_L6.3mm_D2.5mm_P2.54mm_Vertical` | 1 | 秋月電子 | CF25J180RB（125181） | 混合後増幅 Q5 のまわり（V2 追加） |
| R16, R38, R46 | 330 | `R_Axial_DIN0207_L6.3mm_D2.5mm_P2.54mm_Vertical` | 3 | 秋月電子 | CF25J330RB（125331） | R16: 水晶ラダーフィルタの出力の終端（V2 追加） |
| R17, R51, R66 | 20k | `R_Axial_DIN0207_L6.3mm_D2.5mm_P2.54mm_Vertical` | 3 | 秋月電子 | CF25J20KB（103940） | R51 は U5A（マイクアンプ）の帰還抵抗（R50 と組で利得 21 倍） |
| R19 | 1.2k | `R_Axial_DIN0207_L6.3mm_D2.5mm_P2.54mm_Vertical` | 1 | 秋月電子 | CF25J1K2B（125122） | BFO の減衰（U2 へ約 100mVrms、V2 追加） |
| R24 | 27 | `R_Axial_DIN0207_L6.3mm_D2.5mm_P2.54mm_Vertical` | 1 | 秋月電子 | CF25J27RB（114273） | S メーター用増幅 Q8 のまわり（V2 追加） |
| R25 | 220 | `R_Axial_DIN0207_L6.3mm_D2.5mm_P2.54mm_Vertical` | 1 | 秋月電子 | CF25J220RB（125221） | S メーター用増幅 Q8 のまわり（V2 追加） |
| R26 | 10 | `R_Axial_DIN0207_L6.3mm_D2.5mm_P2.54mm_Vertical` | 1 | 秋月電子 | CF25J10RB（125100） | U3（AD8307）の電源デカップリング（V2 追加） |
| R28 | 8.2k | `R_Axial_DIN0207_L6.3mm_D2.5mm_P2.54mm_Vertical` | 1 | 秋月電子 | CF25J8K2B（125822） | AF 前置増幅 Q9 の入力（利得 ≒ R29÷R28、V2 追加） |
| R41 | 100 1W | `R_Axial_DIN0207_L6.3mm_D2.5mm_P2.54mm_Vertical` | 1 | 秋月電子 | MFU100F100RB（108816） | AF 終段（Q13/Q12）のバイアス。静止電流 35〜80mA で最大約 0.5W 消費するので 1W 品。φ3.5×9mm 程度の小型品を縦置き、本体は 1 番パッド（C47 側）。C47 に触れないよう少し離して付ける |
| R47 | 620 | `R_Axial_DIN0207_L6.3mm_D2.5mm_P2.54mm_Vertical` | 1 | 千石電商／マルツ など（要確認） | 1/4W 620Ω | マイク LPF（L7）の出口の終端 |
| R52 | 22k | `R_Axial_DIN0207_L6.3mm_D2.5mm_P2.54mm_Vertical` | 1 | 秋月電子 | CF25J22KB（125223） | U5A 出力（C65 経由）→ AF_ADC（U7 の A2）の直列 |
| R53, R54, R55, R56 | 3.3k | `R_Axial_DIN0207_L6.3mm_D2.5mm_P2.54mm_Vertical` | 4 | 秋月電子 | CF25J3K3B（125332） | U7 の PDM 出力の 2 段 RC（R53・R54 が I＝D10、R55・R56 が Q＝D8、C66〜C69 と組で約 15kHz）。I と Q で値がそろうよう同じ袋のものを使う |
| R57, R59 | 1M | `R_Axial_DIN0207_L6.3mm_D2.5mm_P2.54mm_Vertical` | 2 | 秋月電子 | CF25J1MB（125105） |  |
| R58, R60 | 22 | `R_Axial_DIN0207_L6.3mm_D2.5mm_P2.54mm_Vertical` | 2 | 秋月電子 | CF25J22RB（103821） | I・Q 2 系統（Q16・Q15）のエミッタ抵抗。両系統の利得をそろえるため同じ値にする |
| R63, R64 | 47 | `R_Axial_DIN0207_L6.3mm_D2.5mm_P2.54mm_Vertical` | 2 | 秋月電子 | CF25J47RB（125470） | RF PSN（CLK0・CLK1）側の抵抗 |
| R69 | 10 | `R_Axial_DIN0207_L6.3mm_D2.5mm_P5.08mm_Vertical` | 1 | 秋月電子 | CF25J10RB（125100） | PA ゲートストッパー |
| R70 | 330 | `R_Axial_DIN0207_L6.3mm_D2.5mm_P5.08mm_Vertical` | 1 | 秋月電子 | CF25J330RB（125331） | PA ゲートバイアス上側。RD06HVF1 の Vth は 1.9〜4.9V（Idq 0.3A で Vgs 約 5V）なので、ゲート電圧の上限を約 7.2V（12V 時）にしている |
| R76, R77 | 47k | `R_Axial_DIN0207_L6.3mm_D2.5mm_P2.54mm_Vertical` | 2 | 秋月電子 | CF25J47KB（118208） | R77 TX12V→Q22 ベース、R76 AGC 電圧→Q21 ベース |

**抵抗 R（固定） 合計: 80**

---

## 半固定抵抗 VR（基板実装）

| Reference | 値 / 型番 | フットプリント | 数量 | 購入先 | 購入先の型番（販売コード） | 備考 |
|---|---|---|---|---|---|---|
| VR3, VR4 | 500 | `Potentiometer_TOCOS_GF063P_Vertical` | 2 | 秋月電子 | GF063P B501K（114900） | CLK0・CLK1 のレベル（RF の位相、調整 12） |
| VR5, VR6 | 1k | `Potentiometer_TOCOS_GF063P_Vertical` | 2 | 秋月電子 | GF063P B102K（114901） | キャリアバランス（調整 11） |
| VR7 | 500 | `Potentiometer_Bourns_3266W_Vertical` | 1 | DigiKey／Mouser | 3266W-1-501LF | Idq 調整（Bourns 3266W）。最初は GND 側いっぱいから回す。Idq 200〜400mA はゲート約 4.5〜5.5V（個体差あり、調整 8） |

**半固定抵抗 VR（基板実装） 合計: 5**

---

## コンデンサ C（無極性：セラミック）

| Reference | 値 / 型番 | フットプリント | 数量 | 購入先 | 購入先の型番（販売コード） | 備考 |
|---|---|---|---|---|---|---|
| C1 | 10p | `C_Disc_D3.0mm_W1.6mm_P2.50mm` | 1 | 秋月電子 | RD15N100J1HL2L-10（104058） | NP0。受信 RF 増幅の入力同調（L1・TC1 と並列、V2 追加） |
| C2, C3, C5, C6, C7, C9, C10, C12, C15, C22, C23, C25, C26, C29, C32, C33, C34, C51, C52, C54, C74, C75, C82, C83, C85, C87, C88, C89, C91, C110 | 0.01u | `C_Disc_D5.0mm_W2.5mm_P2.50mm` | 30 | 秋月電子 | RD15W103K1HL2L-10（104063） | C9: L2 のタップ→U1 の入力。C25: Q2 ドレイン→U2 の入力。C26: BFO→U2 のキャリア入力。C32: Q8→U3（AD8307）の入力。C34: AD8307 の OFS。C3: Q3 ゲートの高周波接地（C2〜C9・C10・C12・C15・C25・C26・C29・C54〜C34・C3 は V2 追加） |
| C4, C100, C103 | 5p | `C_Disc_D3.0mm_W1.6mm_P2.50mm` | 3 | 秋月電子 | RDE5C1H5R0C0P1H03B（131234） | NP0。C100: 2 倍波トラップの固定分（TC4 と並列）。C4: 受信 RF 増幅の出力同調（L2・TC2 と並列、V2 追加） |
| C8 | 27p | `C_Disc_D3.0mm_W1.6mm_P2.50mm` | 1 | 秋月電子 | RDE5C1H270J0K1H03B（108095） | L3 を第 1 局発（38〜39MHz）に同調（V2 で 15p→27p） |
| C11, C13, C14, C27, C28, C30, C35, C36, C41, C42, C43, C49, C53, C64, C109 | 0.1u | `C_Disc_D5.0mm_W2.5mm_P2.50mm` | 15 | 秋月電子 | RDER71H104K0P1H03B（113582） | C109（0.1u）・C110（0.01u）: J2（電源入力）のすぐ横の +12V のパスコン（V2 Ver 1.2 追加）。C64: U5（NJM2904）の電源パスコン（8 番ピンの近く）。C13・C28: U1・U2 の BYP（AC 接地）。C11・C27: U1・U2 の電源パスコン。C35: U3（AD8307）の電源パスコン。C36: AD8307 出力の平滑（C13・C11・C14・C53・C28・C27・C49・C30・C35・C36 は V2 追加） |
| C16, C84, C86, C90 | 15p | `C_Disc_D3.0mm_W1.6mm_P2.50mm` | 4 | 秋月電子 | RD15N150J1HL2L（104059） | C16: 混合後増幅 Q5 の出力の L 整合（L4 と組、約 1.5kΩ→330Ω）、NP0（V2 追加） |
| C17, C21 | 82p | `C_Disc_D3.0mm_W1.6mm_P2.50mm` | 2 | 秋月電子 | RDE5C1H820J0K1H03B（108101） | NP0。12MHz 水晶ラダーフィルタの両端の C。水晶の運動定数で最適値が変わるので、水晶を測って決める（V2 追加） |
| C18, C20 | 100p | `C_Disc_D3.0mm_W1.6mm_P2.50mm` | 2 | 秋月電子 | RD15N101J1HL2L-10（104061） | NP0。12MHz 水晶ラダーフィルタの C（V2 追加） |
| C19 | 120p | `C_Disc_D3.0mm_W1.6mm_P2.50mm` | 1 | 秋月電子 | RDE5C1H121J0K1H03B（108103） | NP0。12MHz 水晶ラダーフィルタの中央の C（V2 追加） |
| C24, C31 | 33p | `C_Disc_D3.0mm_W1.6mm_P2.50mm` | 2 | 秋月電子 | RDE5C1H330J0P1H03B（113317） | NP0。C24: L5 と 12MHz に同調（IF 増幅 Q7 の出力、V2 で 15p→33p）。C31: L6 と 12MHz に同調（S メーター用増幅 Q8、V2 追加）。同調がずれていれば C を差し替える（調整 5） |
| C37, C39, C40, C44, C45, C46, C104 | 1u | `C_Disc_D5.0mm_W2.5mm_P2.50mm` | 7 | 秋月電子 | RD15W105K1HL2L-503（115940） | C104: AGC の PWM 平滑（R75 と組）。C37: 積検波（U2）の出力→AF 前置増幅 Q9（V2 追加） |
| C38 | 0.047u | `C_Disc_D5.0mm_W2.5mm_P2.50mm` | 1 | 秋月電子 | RDER71H473K0P1H03B（112059） | AF の LPF（R31 と組で約 3.4kHz、V2 追加） |
| C66, C67, C68, C69 | 3300p | `C_Disc_D5.0mm_W2.5mm_P2.50mm` | 4 | 秋月電子 | RDE5C1H332J0K1H03B（108120） | U7 の PDM 出力の 2 段 RC の C（C66・C67 が I、C68・C69 が Q）。I と Q で値がそろうよう同じ袋のものを使う。残ったずれはファームウェアの iqd・iqa で補正 |
| C76, C77, C78, C79 | 47PF | `C_Disc_D5.0mm_W2.5mm_P2.50mm` | 4 | 秋月電子 | RDE5C1H470J0K1H03B（108045） |  |
| C80, C81 | 0.001u | `C_Disc_D5.0mm_W2.5mm_P2.50mm` | 2 | 秋月電子 | RD15N102J1HL2L-10（104062） |  |
| C92 | 150pF | `C_Disc_D5.0mm_W2.5mm_P5.00mm` | 1 | 秋月電子 | RDE5C1H151J0K1H03B（108104） | PA 入力整合（V2 Ver 1.4 で 100pF から変更） |
| C93 | 33pF | `C_Disc_D5.0mm_W2.5mm_P5.00mm` | 1 | 秋月電子 | RDE5C1H330J0K1H03B（108096） | PA 入力整合。C92 と L15 の間から GND へ（V2 Ver 1.4 でゲート側から移し、22pF から変更） |
| C94 | 0.001u | `C_Disc_D5.0mm_W2.5mm_P5.00mm` | 1 | 秋月電子 | RDE5C1H102J0K1H03B（108114） | PA 出力 DC カット |
| C95, C97 | 0.1uF | `C_Disc_D5.0mm_W2.5mm_P5.00mm` | 2 | 秋月電子 | RDER72E104K2K1H03B（110147） |  |
| C98 | 39p | `C_Disc_D5.0mm_W2.5mm_P5.00mm` | 1 | 秋月電子 | RDE5C1H390J0K1H03B（108097） | PA 出力 LPF のドレイン側シャント、NP0。Q19 の出力容量（Coss 約 18〜25pF）と配線容量が並列に入る分を差し引いた値（2026-10-17 に 33p→39p） |
| C99 | 82p | `C_Disc_D5.0mm_W2.5mm_P5.00mm` | 1 | 秋月電子 | RDE5C1H820J0K1H03B（108101） | PA 出力 LPF の 1 番目の中央シャント、NP0。7 素子にしても TC3 が 8〜16pF（調整範囲 5〜30pF の中ほど）で合う |
| C101 | 100p | `C_Disc_D5.0mm_W2.5mm_P5.00mm` | 1 | 秋月電子 | RDE5C1H101J0K1H03B（108063） | PA 出力 LPF 7 素子の 2 番目の中央シャント、NP0 |
| C102 | 68p | `C_Disc_D5.0mm_W2.5mm_P5.00mm` | 1 | 秋月電子 | RDE5C1H680J0K1H03B（108048） | PA 出力 LPF のアンテナ側シャント、NP0（7 素子 C98-L16-C99/TC3-L17-C101-L19-C102、2026-10-17 に 56p→68p） |

**コンデンサ C（無極性：セラミック） 合計: 88**

---

## コンデンサ C（電解：有極性）

| Reference | 値 / 型番 | フットプリント | 数量 | 購入先 | 購入先の型番（販売コード） | 備考 |
|---|---|---|---|---|---|---|
| C47, C48, C96 | 100u | `CP_Radial_D6.3mm_P2.50mm` | 3 | 秋月電子 | 25PX100MEFC5X11（117877） | C96: 送信 12V のバルク（PA 電流の変動対策、25V 以上）。C96 はふた裏のスピーカーのマグネットの真下に来るので、寝かせて付けるか高さ 7mm 以下の品を使う |
| C50, C55, C58, C61, C63, C105, C106, C107, C108 | 10u | `CP_Radial_D5.0mm_P2.00mm` | 9 | 秋月電子 | 50PX10MEFC5X11（117897） | C106: DC-DC 入力 LC フィルタ。C58・C61: マイク系の結合（C58 は＋が Q14 側、C61 は＋が L7・C60 側）。C63 は U5A の−入力側（R50 と GND の間、＋が R50 側）。C50: 受信中の 5V（5V_RX、U4 の出力）のデカップリング（V2 追加） |
| C56 | 47u | `CP_Radial_D5.0mm_P2.00mm` | 1 | 秋月電子 | 35PX47MEFC5X11（117887） | マイク電源デカップリング（R42 と組。V2 Ver 1.3 から 5V 系） |
| C57, C62, C65, C70, C71, C72, C73 | 1u | `CP_Radial_D5.0mm_P2.00mm` | 7 | 秋月電子 | 50PX1MEFC5X11（117889） | ＋は四角パッド。C72・C70 は PDM の RC の出口→変調器の結合（C72 は＋が R56・C69 側、C70 は＋が R54・C67 側）。C65 は U5A 出力→R52 の結合（＋が U5A 側） |
| C59 | 0.01u | `C_Radial_D5.0mm_P2.00mm_CPpad` | 1 | 秋月電子 | RD15W103K1HL2L-10（104063） | マイク LPF（L7 の入口側シャント）。セラミック（無極性）を 2mm ピッチに足を合わせて付ける。V2 Ver 1.3 から部品形は極性マークなし（穴・パッドは電解用と同じ） |
| C60 | 0.068u | `C_Radial_D5.0mm_P2.00mm_CPpad` | 1 | 秋月電子 | 50F2D683J（110342） | マイク LPF（L7 の出口側シャント）。フィルム（無極性）を 2mm ピッチに足を合わせて付ける。V2 Ver 1.3 から部品形は極性マークなし（穴・パッドは電解用と同じ） |

**コンデンサ C（電解：有極性） 合計: 22**

---

## トリマコンデンサ TC

| Reference | 値 / 型番 | フットプリント | 数量 | 購入先 | 購入先の型番（販売コード） | 備考 |
|---|---|---|---|---|---|---|
| TC1, TC2, TC3 | 30p | `C_Trimmer_TMCV01` | 3 | 秋月電子 | TMCV01-30P100VBG（115472） | TC3: PA 出力 LPF（TC4 を合わせた後、出力最大に、調整 9）。TC1・TC2: 受信 RF 増幅の入出力同調（50.5MHz で S メーター最大に、調整 4、V2 追加）。足の間隔 6.3mm（V2 Ver 1.3 で 5.0mm から修正） |
| TC4 | 10p | `C_Trimmer_TMCV01` | 1 | 秋月電子 | TMCV01-10P100VBW（115470） | 2 倍波トラップの調整（C100 と並列、3〜10pF 程度で可。2 倍波（約 101MHz）が最小になるように合わせる、調整 9） |

**トリマコンデンサ TC 合計: 4**

---

## コイル L・インダクタ・チョーク

| Reference | 値 / 型番 | フットプリント | 数量 | 購入先 | 購入先の型番（販売コード） | 備考 |
|---|---|---|---|---|---|---|
| L1 | T30-6 11T/2T | `L_T30_3pin_Vertical` | 1 | 秋月電子 | T-30-6（116458） | T30-6（黄）に 0.4mm 線 11 回、2 回目からタップ。受信 RF 増幅の入力同調。巻き方は組み立て説明書（V2 追加） |
| L2 | T30-6 11T/3T | `L_T30_3pin_Vertical` | 1 | 秋月電子 | T-30-6（116458） | T30-6（黄）に 0.4mm 線 11 回、**RX12V 側から 3 回目**からタップ（L1 は 2 回目）。受信 RF 増幅の出力同調（1 = ドレイン、3 = RX12V、タップ → U1）。巻き方は組み立て説明書（V2 追加、2026-10-31 にタップを 2 回目 → 3 回目） |
| L3, L12, L13, L14 | 7T50 | `L_FCZ07S_CT` | 4 | サトー電気 など（要確認） | 7S50 | FCZ07S 相当（7T50）。ケースの爪 2 か所も長穴（GND）に差してはんだ付けする（V2 Ver 1.3 で長穴を追加）。L14〜L12 は送信の同調（コアで出力最大、調整 10）。L3 は第 1 局発（38〜39MHz）の取り出し（コアで U1 のキャリア入力を最大、調整 3）。旧 L2・L4（受信の同調）は V2 で削除 |
| L4 | 8.2uH | `L_AL0510-153K_Vertical` | 1 | マルツ／DigiKey など（要確認） | AL0510-8R2K 相当（アキシャル 8.2µH） | 混合後増幅 Q5 の出力の L 整合の直列 L（C16 と組、V2 追加） |
| L5, L6 | 4.7uH | `L_AL0510-153K_Vertical` | 2 | 秋月電子 | AL0410-4R7K（104931） | L5: C24 と 12MHz に同調（IF 増幅 Q7 の出力）。L6: C31 と 12MHz に同調（S メーター用増幅 Q8）（V2 追加） |
| L7 | 15mH | `L_AL0510-153K_Vertical` | 1 | 秋月電子 | AL0510-153K（111407） | マイク AF ローパス |
| L8, L9 | 100nH | `L_AL0510-153K_Vertical` | 2 | DigiKey／Mouser（要確認） | 100nH アキシャル（AL0510 相当） | L8/L9: Si5351 CLK0/CLK1 出力 LPF。代替に空芯可（φ0.6mm 線を φ4.4mm 芯に 5 回巻き・巻き幅 約3.9mm で約100nH、伸縮で調整。L8 と L9 は軸を 90° ずらす） |
| L10, L11 | 1mH | `L_AL0510-153K_Vertical` | 2 | 秋月電子 | AL0510-102K（111367） | L11: 平衡変調器 AF 注入 |
| L15 | 270nH | `L_Axial_L9.5mm_D4.0mm_P2.54mm_Vertical_Fastron_SMCC` | 1 | DigiKey／Mouser（要確認） | Fastron SMCC-R27K-02（0.27µH ±10%、Q 45、0.11Ω、1.4A） | PA 入力整合（V2 Ver 1.4 で 47nH から変更）。縦置き 2.54mm（本体は 1 番の穴の上に立て、2 番 = Q19 ゲート側へ足を折り返す。放熱器のつばの内側。V2 Ver 1.3 で横置き 12.7mm から変更） |
| L16 | T-50-10 9T/0.6mm | `L_T50_2pin_Vertical` | 1 | 秋月電子 | T-50-10（111948） | 9 回巻き（約 0.25µH）。PA 出力 7 素子 LPF のドレイン側 |
| L17 | T-50-10 10T/0.6mm | `L_T50_2pin_Vertical` | 1 | 秋月電子 | T-50-10（111948） | 10 回巻き（約 0.31µH）。PA 出力 7 素子 LPF の中央 |
| L18 | T-30-6 8T/0.4mm | `L_T30_2pin_Vertical` | 1 | 秋月電子 | T-30-6（116458） | 0.4mm 線 8 回巻き（約 0.23µH）。2 倍波トラップ（C100∥TC4 と 101MHz で直列共振） |
| L19 | T-50-10 8T/0.6mm | `L_T50_2pin_Vertical` | 1 | 秋月電子 | T-50-10（111948） | T-50-10 に 0.6mm 線 8 回巻き（約 0.20µH）。PA 出力 7 素子 LPF のアンテナ側 |
| L20 | 10uH | `L_AL0510-153K_Vertical` | 1 | 秋月電子 | AL0510-100K（104922） | DC-DC（U8）入力 LC フィルタ。AL0510（長さ 14mm）は 12.7mm の横置きに入らないので、2026-11-05 に縦置き（2.54mm）に変更 |
| RFC1 | 10uH | `L_Axial_L14.0mm_D4.5mm_P15.24mm_Horizontal_Fastron_LACC` | 1 | 秋月電子 | AL0510-100K（104922） | PA（Q19）ドレインの RF チョーク。スピーカーのマグネットの下（すき間約 10mm）なので横置き（15.24mm、高さ約 5mm）。2026-11-05 に 12.7mm から変更（AL0510 の長さ 14mm が入らなかった） |

**コイル L・インダクタ・チョーク 合計: 21**

---

## ダイオード D

| Reference | 値 / 型番 | フットプリント | 数量 | 購入先 | 購入先の型番（販売コード） | 備考 |
|---|---|---|---|---|---|---|
| D1 | 1N4001 | `D_DO-41_SOD81_P10.16mm_Horizontal` | 1 | 秋月電子 | 1N4007-3485（100934） | K1 コイルのフライバック（カソードが Q1 コレクタ側、アノードが GND） |
| D2, D3 | 1N4148 | `D_DO-35_SOD27_P2.54mm_Vertical_CathodeUp` | 2 | 秋月電子 | 1N4148（100941） | 受信入力の保護（2 本を逆向きに並列、V2 追加） |
| D4, D5, D6, D7, D8, D9 | 1N60 | `D_DO-35_SOD27_P2.54mm_Vertical_CathodeUp` | 6 | サトー電気 など（要確認） | 1N60 | ゲルマニウム。D4〜D7 は平衡変調（4 本とも同じ袋の品を使う）、D8・D9 は送信検出 |
| D10 | 1N5819 | `D_DO-41_SOD81_P5.08mm_Vertical_AnodeUp` | 1 | 秋月電子 | 1N5819（117244） | ショットキー。+5V → XIAO 5V ピンの逆流防止（USB 接続時に DC-DC と USB 電源がぶつからないよう、Seeed 推奨） |

**ダイオード D 合計: 10**

---

## トランジスタ・FET Q

| Reference | 値 / 型番 | フットプリント | 数量 | 購入先 | 購入先の型番（販売コード） | 備考 |
|---|---|---|---|---|---|---|
| Q1 | 2SA1015 | `TO-92_Inline` | 1 | 秋月電子 | 2SA1015L-GR-T92（106734） | K1 コイルのハイサイドスイッチ（PNP、エミッタ = PWR_IN）。ピン E-C-B（平面側から見て左から）、シルクの平面側に合わせて挿入。2SC1815 と取り違えない |
| Q2, Q3, Q6, Q7 | 2SK192A | `TO-92_Inline` | 4 | 秋月電子／サトー電気 など（要確認） | 2SK192A-BL（東芝） | BL ランク（IDSS 12〜24mA）を 4 個そろえる（上段・下段の組で IDSS が近いもの）。ピン 1 D・2 S・3 G（東芝データシートで確認、基板と同じ並び）。耐圧 VGDO 18V・許容損失 200mW。Q2・Q3: 受信 RF 増幅のカスコード（Q2 = 下段、Q3 = 上段でゲートに AGC）。Q6・Q7: IF 増幅のカスコード（Q6 = 下段、Q7 = 上段でゲートに AGC）。ソース抵抗 R3・R18 は 100Ω。2026-10-31 に J310 から置き換え、2026-11-05 に GR → BL ランク（3SK59 は使わない） |
| Q4, Q17 | 2SK439 | `TO-92_Inline` | 2 | サトー電気 など（要確認） | 2SK439 | Q4 は第 1 局発のバッファ、Q17 は励振。ピン G-S-D（日立 SPAK） |
| Q5, Q8, Q9, Q10, Q11, Q14, Q15, Q16, Q18, Q20, Q21, Q22 | 2SC1815 | `TO-92_Inline` | 12 | 秋月電子 | 2SC1815L-GR-T92（106477） | ピン E-C-B（平面側から見て左から）、シルクの平面側に合わせて挿入。Q20: 送信検出（TX ランプ）。Q18: 励振。Q10・Q11: 受信 AF。Q15・Q16: 変調器ドライブ（I・Q）。Q21: AGC（Q3・Q7 のゲートを下げる）。Q14: マイク。Q22: 送信検出（TX12V でオン → D0 を LOW）。Q5: 混合後の 12MHz 増幅、Q8: S メーター用の 12MHz 増幅、Q9: AF 前置増幅（Q5〜Q9 は V2 追加） |
| Q12 | 2SA950 | `TO-92_Inline` | 1 | 秋月電子 | 2SA950-Y（113825） | AF 出力 PNP。ピン E-C-B |
| Q13 | 2SC2120 | `TO-92_Inline` | 1 | 秋月電子 | 2SC2120-Y（113829） | AF 出力 NPN。ピン E-C-B（平面側から見て左から） |
| Q19 | RD06HVF1 | `TO-220-3_Vertical` | 1 | DigiKey／RF 部品店（要確認） | RD06HVF1 | 1W PA 終段 RF MOSFET、放熱器 HS1 に固定。ピン 1=G 2=S 3=D |

**トランジスタ・FET Q 合計: 22**

---

## 水晶振動子 Y

| Reference | 値 / 型番 | フットプリント | 数量 | 購入先 | 購入先の型番（販売コード） | 備考 |
|---|---|---|---|---|---|---|
| Y1, Y2, Y3, Y4, Y5, Y6 | 12MHz | `Crystal_HC49-U_Vertical` | 6 | 秋月電子 | HUSG-12.000-20（108669） | 12MHz 水晶ラダーフィルタ（6 素子）。6 個とも同じロットで、直列共振周波数が ±50Hz 以内のものを選ぶ（V2 追加） |

**水晶振動子 Y 合計: 6**

---

## IC・レギュレータ・モジュール

| Reference | 値 / 型番 | フットプリント | 数量 | 購入先 | 購入先の型番（販売コード） | 備考 |
|---|---|---|---|---|---|---|
| U1, U2 | NJM2594V | `TSSOP-8_4.4x3mm_P0.65mm` | 2 | 秋月電子 | NJM2594V（111195） | ダブルバランスドミキサ（SSOP8 0.65mm、表面実装）。U1 = 第 1 混合（50MHz × 局発 38〜39MHz → 12MHz）、U2 = 積検波（12MHz × BFO）。全部品の中で最初にはんだ付けする。1 番ピンに注意（V2 追加） |
| U3 | AD8307ANZ | `DIP-8_W7.62mm` | 1 | 秋月電子 | AD8307ANZ（100195） | 対数検波（S メーター・AGC、25mV/dB）。出力を J4（ADS1015）の A0 へ。切り欠きの向きに注意（V2 追加） |
| U4 | 78L05 | `TO-92_Inline` | 1 | 秋月電子 | TA78L05S（108973） | 受信中だけの 5V（5V_RX、U1・U2・U3 の電源）。平面側の向きに注意（V2 追加） |
| U5 | NJM2904 | `DIP-8_W7.62mm` | 1 | 秋月電子 | NJM2904D（109216） | U5A はマイクアンプ（非反転、約 21 倍）。U5B は未使用（＋入力を GND、出力を−入力につなぐ） |
| U6 | Si5351_DIP8 | `DIP-8_W7.62mm` | 1 | 秋月電子 | AE-Si5351A-B（110679） | Si5351 モジュール（I2C 0x60）。上から見て 1 番（VDDO）が左上の DIP-8 並び（2026-11-05 に部品形のピン番号を修正。前の部品形は鏡写しだった） |
| U8 | R-78E5.0-1.0 | `DCDC_RECOM_R-78E_78Lxx-pinmap` | 1 | DigiKey／Mouser | R-78E5.0-1.0 | 5V 1A DC-DC（RECOM R-78E5.0-1.0、78xx 互換）。PWR_IN から L20/C106 の LC フィルタ経由で常時給電 |
| U9 | LP2950-3.3_TO92 | `TO-92_Inline` | 1 | 秋月電子 | LP2950L-33-T92（108749） | Si5351 用 3.3V |

**IC・レギュレータ・モジュール 合計: 8**

---

## マイコンモジュール

| Reference | 値 / 型番 | フットプリント | 数量 | 購入先 | 購入先の型番（販売コード） | 備考 |
|---|---|---|---|---|---|---|
| U7 | Seeeduino_XIAO_Socket | `Seeeduino_XIAO_Socket` | 1 | 秋月電子 | 113991054（117454） | XIAO ESP32C3 本体（秋月 117454 は XIAO 本体で、ソケットではない）。ふちが端子なので 1×7 のピンヘッダを 2 本はんだ付けし、基板にじか付けかピンソケットで付ける（穴 φ1.0、V2 Ver 1.3 で φ0.9 から変更）。部品面を上にして差す。USB 端子は基板右辺向き。2026-11-05 に部品形を Seeed 公式の並び（列の間隔 15.24mm、上の列が右から D0〜D6）に修正 |

**マイコンモジュール 合計: 1**

---

## リレー K

| Reference | 値 / 型番 | フットプリント | 数量 | 購入先 | 購入先の型番（販売コード） | 備考 |
|---|---|---|---|---|---|---|
| K1 | G5V-2 DC12 | `Relay_DPDT_Omron_G5V-2_D1.0mm` | 1 | DigiKey／Mouser | G5V-2-DC12 | DPDT、送受切替（PTT = J7.3 → Q1 で駆動）。電源 12V なので **DC12V コイル品**を使う（コイル 288Ω・41.7mA）。穴はオムロン推奨の φ1.0（V2 Ver 1.3 で φ0.7 から変更） |

**リレー K 合計: 1**

---

## コネクタ J（ピンヘッダ）

| Reference | 値 / 型番 | フットプリント | 数量 | 購入先 | 購入先の型番（販売コード） | 備考 |
|---|---|---|---|---|---|---|
| J1 | RF_IN | `SolderWire_1x02_P2.54mm_D1.1mm` | 1 | （同軸ケーブル） | RG-174 など 50Ω | アンテナ入力（Pin1 = 芯線、□ パッド、Pin2 = 編組）。同軸ケーブルを穴 φ1.1mm に直接はんだ付けし、編組の引き出しは短くする（V2 Ver 1.2 にピンヘッダから変更） |
| J2 | PWR_IN | `SolderWire_1x02_P5.08mm_D1.1mm` | 1 | （電線） | AWG20（0.5sq） | 電源 12V 入力（Pin1 = +12V、□ パッド、Pin2 = GND）。AWG20 の電線を穴 φ1.1mm に直接はんだ付け（電流は送信時でも 1A 弱）。V2 Ver 1.2 で基板の左辺の前寄り（ケースの電源スイッチ・DC ジャックの側）に移した |
| J3, J5 | Volume | `PinHeader_1x03_P2.54mm_Vertical` | 2 | 秋月電子 | PH-1x40SG（100167） |  |
| J4 | AE-ADS1015 | `AE-ADS1015_Vertical` | 1 | 秋月電子 | AE-ADS1015（113838） | 秋月 AE-ADS1015（ADS1015 モジュール、I2C 0x48）を差す。A0 = U3（AD8307）の出力（S メーター・AGC、V2 追加）。**モジュール裏の SDA・SCL のプルアップ用はんだジャンパを短絡する（I2C の線にほかのプルアップがない。Si5351 モジュール・XIAO には付いていない）** |
| J6 | SP-OUT | `PinHeader_1x02_P2.54mm_Vertical` | 1 | 秋月電子 | PH-1x40SG（100167） |  |
| J7 | MIC-IN | `PinHeader_1x04_P2.54mm_Vertical` | 1 | 秋月電子 | PH-1x40SG（100167） |  |
| J8 | I2C_OUT-LCD | `PinHeader_1x03_P2.54mm_Vertical` | 1 | 秋月電子 | PH-1x40SG（100167） |  |
| J9 | TX-ON-LED | `PinHeader_1x02_P2.54mm_Vertical` | 1 | 秋月電子 | PH-1x40SG（100167） | 送信表示 LED（ふた上面、RF ゲインのつまみの後ろ）へ。V2 Ver 1.2 で基板の右側の辺の前寄りへ移した（Q20・R72 までは 0.25mm の線） |
| J10 | Encoder | `PinHeader_1x04_P2.54mm_Vertical` | 1 | 秋月電子 | PH-1x40SG（100167） |  |
| J11 | NX4832T035 | `PinHeader_1x04_P2.54mm_Vertical` | 1 | 秋月電子 | PH-1x40SG（100167） |  |
| J12 | POWER-LED | `PinHeader_1x02_P2.54mm_Vertical` | 1 | 秋月電子 | PH-1x40SG（100167） | 電源 LED（ふた上面、LCD の窓の下）へ。Pin1 = アノード側（R80 10kΩ 経由で +12V）、Pin2 = GND（V2 Ver 1.2 追加） |

**コネクタ J（ピンヘッダ） 合計: 12**

---

## パネル部品（基板非搭載）

| Reference | 値 / 型番 | フットプリント | 数量 | 購入先 | 購入先の型番（販売コード） | 備考 |
|---|---|---|---|---|---|---|
| LED1 | LED黄 | `PinHeader_1x02_P2.54mm_Vertical` | 1 | 秋月電子 | OSY5JA3Z74A（111639） | 基板非搭載。送信表示 LED、J9 に接続。ケース上面の TX の穴（φ3.0）に取付 |

**パネル部品（基板非搭載） 合計: 1**

---

## 回路図に載っていない部品

| 品名 | 数量 | 購入先 | 購入先の型番（販売コード） | 備考 |
|---|---|---|---|---|
| 放熱器 17PB046（HS1） | 1 | 秋月電子 | 17PB046-01025（105050） | 46.2×17×25mm、11.9℃/W（2026-10-16 に 20PB020 から変更）。17PB046 は断面 46.2 × 17mm のうち、取付面からフィン側が 10mm、反対の Q19 側に両端のつば（厚さ約 1.3mm、長さ 7mm）が出ている。Q19 はつばの間に入る。Q19 のタブに M3 ねじで固定、脚ピン 2 本（ピッチ 30mm）を基板の φ1.6 穴に差す |
| RF ゲイン用 可変抵抗 10kΩ B カーブ（回路図 VR1、DNP） | 1 | 秋月電子 | SH16K4B103L20KCCI（118292） | J3 に接続。R17（20kΩ）との分圧で、右いっぱいのとき AGC の線（Q3・Q7 のゲート）が約 4.0V（2026-11-05 に 5kΩ から変更。5kΩ では約 2.4V になり、Q2・Q6 の電圧が足りなくなる個体がある）。ケース上面の RF つまみ（パネル取付ボリューム、φ7.2 穴）。AGC の上限（最大ゲイン）を決めるので AGC 使用時も必ず付ける |
| AF ボリューム 10kΩ A カーブ（回路図 VR2、DNP） | 1 | 秋月電子 | SH16K4A103L20KCCI（129553） | J5 に接続、ケース上面 |
| ロータリーエンコーダ（押しスイッチ付き） | 1 | 秋月電子 | EC12E2420801（106357） | J10、ケース上面 |
| LCD NX4832T035（Nextion、3.5インチ 480×320 シリアル HMI） | 1 | Nextion 公式ストア（AliExpress・Amazon など） | NX4832T035_011 | J11。ケース上面のベゼルのボスに裏側から M3×6 で固定 |
| マイクコネクタ 4P | 1 | 千石電商／マルツ など（要確認） | 4P 丸型マイクコネクタ（メス、パネル取付 φ16） | J7、ケース上面 MIC（φ16.2） |
| イヤホンジャック 3.5mm スイッチ付き（MJ-352W-C） | 1 | 秋月電子 | MJ-352W-C（117359） | J6、ケース上面 PHN。差し込み口の M6 ねじをふたの φ6.2 穴に通しナットで固定。プラグを挿すとブレーク接点が開くので、スピーカーをブレーク接点経由でつなぐとイヤホン使用時にスピーカーが切れる |
| 電源スイッチ（φ13 穴）、3mm LED（高輝度） | 各 1 | 要確認 | φ13 穴に合うもの | ケース上面の LCD の窓の下（電源スイッチと電源ランプ）。LED は J12 に接続（電流制限は基板の R80 10kΩ、約 1mA なので高輝度品を使う） |
| DC ジャック（センタープラス）、ヒューズホルダ 5×20 ＋ 1A 速断、BNC | 2 ／ 1 ／ 1 | 秋月電子 | MJ-14 ／ MF-524M ／ B-014IF（106342 ／ 107079 ／ 100093） | 後面パネル（DC ジャックは後面と左側面に 1 個ずつ、並列） |
| IC ソケット DIP-8 | 3 | 秋月電子 | 2227-08-03（100017） | U3・U5・U6 用（推奨） |
| M3 インサートナット | 24 | Amazon／モノタロウ |  | ケース（基板スタンドオフ 4、側板内側のふた固定ボス 4、前後パネル一体ボスの上端 4・下端 4）、ベゼル（LCD 用 4、ベゼル固定用 4） |
| M3×8 ねじ | 4 | ホームセンター／モノタロウ |  | ベゼル→ふた（ふた裏から） |
| M3×10 ねじ | 8 | ホームセンター／モノタロウ |  | ふた固定（側板内側のボス 4、前後パネル一体のボス 4） |
| M3×10 皿ねじ | 4 | ホームセンター／モノタロウ |  | 前後パネル→底板（底板の裏から） |
| M3×6 ねじ | 8 | ホームセンター／モノタロウ |  | 基板固定 4、LCD→ベゼル 4 |
| スピーカー 5cm 8Ω 0.5W | 1 | 秋月電子 | DXYD50N-22Z-8A-F（116024） | J6（SP-OUT）に接続。ふた裏の通風スロットの左に M3×8 皿ねじ 4 本＋ナットで固定。マグネットの真下に来る C96 は寝かせるか高さ 7mm 以下の品にする（RFC1 は横置きの部品形） |
| M3×8 皿ねじ・M3 ナット | 各 4 | ホームセンター／モノタロウ |  | スピーカー固定（ふた上面から） |

**基板実装部品 合計: 280 点**（パネル部品 LED1 を除く）
