kazushinjo/PSN_TRX_XIAO_ESP32C3-V2/kicad/部品個数まとめ.md

# 部品個数まとめ

`bom_purchase.csv` から `make_bom_summary.py` で作成。同じ品（同じ購入先の型番）を 1 行にまとめ、合計個数と買う数を出したもの。部品表で値・足のピッチごとに分かれている行も、買う品が同じならここでは 1 行になる。

| 項目 | 数 |
|---|---|
| 回路図の部品 | 95 種類・281 個 |
| 回路図に載っていない部品（ケース・ねじ・パネル部品など） | 17 種類 |
| 価格が分かっている品の合計（税込、2026-10-15 時点） | 16,040 円（88 種類） |
| 価格が分かっていない品 | 24 種類（購入先・型番を確かめてから注文） |

買う数は「合計個数 ÷ 入数」の切り上げ（ピンヘッダは 40 ピンで 1 本として計算）。金額 = 買う数 × 単価。

## 抵抗（27 種類・80 個）

| 品名 | 値/型番 | 合計個数 | 部品番号 | 購入先 | 型番（販売コード） | 入数 | 買う数 | 金額 | メモ |
|---|---|---:|---|---|---|---|---:|---:|---|
| カーボン抵抗 1/4W | 4.7k | 7 | R1, R12, R23, R43, R61, R62, R67 | 秋月電子 | CF25J4K7B（125472） | 100本 | 1 | 170 |  |
| カーボン抵抗 1/4W | 10k | 7 | R2, R39, R40, R75, R78-R80 | 秋月電子 | RD25S 10K（125103） | 100本 | 1 | 100 |  |
| カーボン抵抗 1/4W | 100 | 5 | R3, R9, R18, R20, R68 | 秋月電子 | CF25J100RB（125101） | 100本 | 1 | 200 |  |
| カーボン抵抗 1/4W | 100k | 11 | R4, R6, R29, R32, R35, R44, R48, R49, R71, R73, R74 | 秋月電子 | CF25J100KB（125104） | 100本 | 1 | 200 |  |
| カーボン抵抗 1/4W | 2.2k | 2 | R5, R21 | 秋月電子 | CF25J2K2B（125222） | 100本 | 1 | 220 |  |
| カーボン抵抗 1/4W | 51 | 2 | R7, R65 | 秋月電子 | CF25J51RB（125510） | 100本 | 1 | 200 |  |
| カーボン抵抗 1/4W | 470 | 1 | R8 | 秋月電子 | CF25J470RB（125471） | 100本 | 1 | 200 |  |
| カーボン抵抗 1/4W | 1k | 11 | R10, R27, R30, R31, R33, R36, R37, R42, R45, R50, R72 | 秋月電子 | CF25J1KB（125102） | 100本 | 1 | 100 |  |
| カーボン抵抗 1/4W | 27k | 2 | R11, R22 | 秋月電子 | RD25S 27K（125273） | 100本 | 1 | 100 |  |
| カーボン抵抗 1/4W | 1.5k | 2 | R13, R34 | 秋月電子 | CF25J1K5B（125152） | 100本 | 1 | 170 |  |
| カーボン抵抗 1/4W | 33 | 1 | R14 | 秋月電子 | CF25J33RB（103941） | 100本 | 1 | 200 |  |
| カーボン抵抗 1/4W | 180 | 1 | R15 | 秋月電子 | CF25J180RB（125181） | 100本 | 1 | 100 |  |
| カーボン抵抗 1/4W | 330 | 4 | R16, R38, R46, R70 | 秋月電子 | CF25J330RB（125331） | 100本 | 1 | 200 |  |
| カーボン抵抗 1/4W | 20k | 3 | R17, R51, R66 | 秋月電子 | CF25J20KB（103940） | 100本 | 1 | 180 |  |
| カーボン抵抗 1/4W | 1.2k | 1 | R19 | 秋月電子 | CF25J1K2B（125122） | 100本 | 1 | 170 |  |
| カーボン抵抗 1/4W | 27 | 1 | R24 | 秋月電子 | CF25J27RB（114273） | 100本 | 1 | 100 |  |
| カーボン抵抗 1/4W | 220 | 1 | R25 | 秋月電子 | CF25J220RB（125221） | 100本 | 1 | 200 |  |
| カーボン抵抗 1/4W | 10 | 2 | R26, R69 | 秋月電子 | CF25J10RB（125100） | 100本 | 1 | 220 |  |
| カーボン抵抗 1/4W | 8.2k | 1 | R28 | 秋月電子 | CF25J8K2B（125822） | 100本 | 1 | 100 | AF 前置増幅 Q9 の入力 |
| 超小型 金属皮膜抵抗 1W 100Ω | 100 1W | 1 | R41 | 秋月電子 | MFU100F100RB（108816） | 100本 | 1 | 300 | 縦置き・2.54mm ピッチに入る小型品 |
| カーボン抵抗 1/4W 620Ω | 620 | 1 | R47 | 千石電商／マルツ など（要確認） | 1/4W 620Ω |  |  |  | 秋月に 1/4W 620Ω の扱いなし（2026-11-04 確認） |
| カーボン抵抗 1/4W | 22k | 1 | R52 | 秋月電子 | CF25J22KB（125223） | 100本 | 1 | 180 |  |
| カーボン抵抗 1/4W | 3.3k | 4 | R53-R56 | 秋月電子 | CF25J3K3B（125332） | 100本 | 1 | 180 | I・Q の RC（R53〜R56）は同じ袋のものを使う |
| カーボン抵抗 1/4W | 1M | 2 | R57, R59 | 秋月電子 | CF25J1MB（125105） | 100本 | 1 | 200 |  |
| カーボン抵抗 1/4W | 22 | 2 | R58, R60 | 秋月電子 | CF25J22RB（103821） | 100本 | 1 | 200 |  |
| カーボン抵抗 1/4W | 47 | 2 | R63, R64 | 秋月電子 | CF25J47RB（125470） | 100本 | 1 | 200 |  |
| カーボン抵抗 1/4W | 47k | 2 | R76, R77 | 秋月電子 | CF25J47KB（118208） | 100本 | 1 | 150 |  |

## 半固定抵抗（3 種類・5 個）

| 品名 | 値/型番 | 合計個数 | 部品番号 | 購入先 | 型番（販売コード） | 入数 | 買う数 | 金額 | メモ |
|---|---|---:|---|---|---|---|---:|---:|---|
| 半固定抵抗 TOCOS GF063P | 500 | 2 | VR3, VR4 | 秋月電子 | GF063P B501K（114900） | 1個 | 2 | 60 |  |
| 半固定抵抗 TOCOS GF063P | 1k | 2 | VR5, VR6 | 秋月電子 | GF063P B102K（114901） | 1個 | 2 | 60 |  |
| 多回転半固定抵抗 Bourns 3266W | 500 | 1 | VR7 | DigiKey／Mouser | 3266W-1-501LF |  |  |  | 秋月の 3296W は外形が大きく基板に合わない |

## コンデンサ（セラミック）（23 種類・90 個）

| 品名 | 値/型番 | 合計個数 | 部品番号 | 購入先 | 型番（販売コード） | 入数 | 買う数 | 金額 | メモ |
|---|---|---:|---|---|---|---|---:|---:|---|
| 積層セラミックコンデンサ 10pF 50V NP0 2.54mm | 10p | 1 | C1 | 秋月電子 | RD15N100J1HL2L-10（104058） | 10個 | 1 | 100 | 受信の入力同調 |
| 積層セラミックコンデンサ 0.01µF 50V X7R 2.54mm | 0.01u | 31 | C2, C3, C5-C7, C9, C10, C12, C15, C22, C23, C25, C26, C29, C32-C34, C51, C52, C54, C59, C74, C75, C82, C83, C85, C87-C89, C91, C110 | 秋月電子 | RD15W103K1HL2L-10（104063） | 10個 | 4 | 400 | 2mm ピッチに足を合わせる |
| 積層セラミックコンデンサ 5pF 50V C0G 2.54mm | 5p | 3 | C4, C100, C103 | 秋月電子 | RDE5C1H5R0C0P1H03B（131234） | 10個 | 1 | 150 |  |
| 積層セラミックコンデンサ 27pF 50V C0G 5mm | 27p | 1 | C8 | 秋月電子 | RDE5C1H270J0K1H03B（108095） | 10個 | 1 | 100 | L3 を 38〜39MHz に同調（V2 で 15p から変更）。2.54mm ピッチ品がないため足を寄せて使う |
| 積層セラミックコンデンサ 0.1µF 50V X7R 2.54mm | 0.1u | 15 | C11, C13, C14, C27, C28, C30, C35, C36, C41-C43, C49, C53, C64, C109 | 秋月電子 | RDER71H104K0P1H03B（113582） | 10個 | 2 | 200 |  |
| 積層セラミックコンデンサ 15pF 50V NP0 2.54mm | 15p | 4 | C16, C84, C86, C90 | 秋月電子 | RD15N150J1HL2L（104059） | 10個 | 1 | 100 |  |
| 積層セラミックコンデンサ 82pF 50V C0G 5mm | 82p | 3 | C17, C21, C99 | 秋月電子 | RDE5C1H820J0K1H03B（108101） | 10個 | 1 | 150 | ラダーフィルタ。値は水晶の運動定数を測ってから決める。2.54mm ピッチ品がないため足を寄せて使う |
| 積層セラミックコンデンサ 100pF 50V NP0 2.54mm | 100p | 2 | C18, C20 | 秋月電子 | RD15N101J1HL2L-10（104061） | 10個 | 1 | 100 | ラダーフィルタ。値は水晶の運動定数を測ってから決める |
| 積層セラミックコンデンサ 120pF 50V C0G 5mm | 120p | 1 | C19 | 秋月電子 | RDE5C1H121J0K1H03B（108103） | 10個 | 1 | 100 | ラダーフィルタ。値は水晶の運動定数を測ってから決める。2.54mm ピッチ品がないため足を寄せて使う |
| 積層セラミックコンデンサ 33pF 50V C0G 2.54mm | 33p | 2 | C24, C31 | 秋月電子 | RDE5C1H330J0P1H03B（113317） | 10個 | 1 | 180 | C24 は Q2 のドレイン同調、C31 は S メーター増幅の同調 |
| 積層セラミックコンデンサ 1µF 50V X7R 2.54mm | 1u | 7 | C37, C39, C40, C44-C46, C104 | 秋月電子 | RD15W105K1HL2L-503（115940） | 10個 | 1 | 170 |  |
| 積層セラミックコンデンサ 0.047µF 50V X7R 2.54mm | 0.047u | 1 | C38 | 秋月電子 | RDER71H473K0P1H03B（112059） | 1個 | 1 | 15 | AF 前置増幅の後の高域カット |
| フィルムコンデンサ 0.068µF 50V（ルビコン F2D） | 0.068u | 1 | C60 | 秋月電子 | 50F2D683J（110342） | 1個 | 1 | 10 | マイク LPF。2mm ピッチに足を合わせる |
| 積層セラミックコンデンサ 3300pF 50V C0G 5mm | 3300p | 4 | C66-C69 | 秋月電子 | RDE5C1H332J0K1H03B（108120） | 10個 | 1 | 120 | PDM 出力の RC（C66〜C69）。I・Q で値がそろうよう同じ袋のものを使う。2.54mm ピッチの C0G 品がないため足を寄せて使う |
| 積層セラミックコンデンサ 47pF 50V C0G 5mm | 47PF | 4 | C76-C79 | 秋月電子 | RDE5C1H470J0K1H03B（108045） | 10個 | 1 | 130 | 2.54mm ピッチ品がないため 5mm ピッチ品の足を寄せて使う |
| 積層セラミックコンデンサ 1000pF 50V 2.54mm | 0.001u | 2 | C80, C81 | 秋月電子 | RD15N102J1HL2L-10（104062） | 10個 | 1 | 100 |  |
| 積層セラミックコンデンサ 150pF 50V C0G 5mm | 150pF | 1 | C92 | 秋月電子 | RDE5C1H151J0K1H03B（108104） | 10個 | 1 | 130 |  |
| 積層セラミックコンデンサ 33pF 50V C0G 5mm | 33pF | 1 | C93 | 秋月電子 | RDE5C1H330J0K1H03B（108096） | 10個 | 1 | 120 |  |
| 積層セラミックコンデンサ 1000pF 50V C0G 5mm | 0.001u | 1 | C94 | 秋月電子 | RDE5C1H102J0K1H03B（108114） | 10個 | 1 | 130 |  |
| 積層セラミックコンデンサ 0.1µF 250V X7R 5mm | 0.1uF | 2 | C95, C97 | 秋月電子 | RDER72E104K2K1H03B（110147） | 1個 | 2 | 50 |  |
| 積層セラミックコンデンサ 39pF 50V C0G 5mm | 39p | 1 | C98 | 秋月電子 | RDE5C1H390J0K1H03B（108097） | 10個 | 1 | 100 |  |
| 積層セラミックコンデンサ 100pF 50V C0G 5mm | 100p | 1 | C101 | 秋月電子 | RDE5C1H101J0K1H03B（108063） | 10個 | 1 | 120 |  |
| 積層セラミックコンデンサ 68pF 50V C0G 5mm | 68p | 1 | C102 | 秋月電子 | RDE5C1H680J0K1H03B（108048） | 10個 | 1 | 100 |  |

## コンデンサ（電解）（4 種類・20 個）

| 品名 | 値/型番 | 合計個数 | 部品番号 | 購入先 | 型番（販売コード） | 入数 | 買う数 | 金額 | メモ |
|---|---|---:|---|---|---|---|---:|---:|---|
| 電解コンデンサ 100µF 25V | 100u | 3 | C47, C48, C96 | 秋月電子 | 25PX100MEFC5X11（117877） | 1個 | 3 | 30 |  |
| 電解コンデンサ 10µF 50V | 10u | 9 | C50, C55, C58, C61, C63, C105-C108 | 秋月電子 | 50PX10MEFC5X11（117897） | 1個 | 9 | 90 |  |
| 電解コンデンサ 47µF 35V | 47u | 1 | C56 | 秋月電子 | 35PX47MEFC5X11（117887） | 1個 | 1 | 10 |  |
| 電解コンデンサ 1µF 50V | 1u | 7 | C57, C62, C65, C70-C73 | 秋月電子 | 50PX1MEFC5X11（117889） | 1個 | 7 | 70 |  |

## トリマコンデンサ（2 種類・4 個）

| 品名 | 値/型番 | 合計個数 | 部品番号 | 購入先 | 型番（販売コード） | 入数 | 買う数 | 金額 | メモ |
|---|---|---:|---|---|---|---|---:|---:|---|
| セラミックトリマコンデンサ 30pF | 30p | 3 | TC1-TC3 | 秋月電子 | TMCV01-30P100VBG（115472） | 1個 | 3 | 75 |  |
| セラミックトリマコンデンサ 10pF（3〜10pF） | 10p | 1 | TC4 | 秋月電子 | TMCV01-10P100VBW（115470） | 1個 | 1 | 20 | TC3 と同じ TMCV01 系（同じ足） |

## コイル（10 種類・21 個）

| 品名 | 値/型番 | 合計個数 | 部品番号 | 購入先 | 型番（販売コード） | 入数 | 買う数 | 金額 | メモ |
|---|---|---:|---|---|---|---|---:|---:|---|
| トロイダルコア T-30-6（黄、0.4mm ポリウレタン線 11 回、2 回目にタップ） | T30-6 11T/2T・T30-6 11T/3T・T-30-6 8T/0.4mm | 3 | L1, L2, L18 | 秋月電子 | T-30-6（116458） | 1個 | 3 | 630 | Amidon。L18 と同じコア。線は別途 ／ Amidon。L1 と同じコア（タップの位置だけ違う）。線は別途 ／ Amidon。線は別途 |
| FCZ コイル 07S 50MHz（センタータップ付） | 7T50 | 4 | L3, L12-L14 | サトー電気 など（要確認） | 7S50 |  |  |  | FCZ 研究所の製品。類似品あり |
| マイクロインダクタ 8.2µH | 8.2uH | 1 | L4 | マルツ／DigiKey など（要確認） | AL0510-8R2K 相当（アキシャル 8.2µH） |  |  |  | 秋月に 8.2µH のマイクロインダクタの扱いなし（2026-11-04 確認） |
| マイクロインダクタ 4.7µH | 4.7uH | 2 | L5, L6 | 秋月電子 | AL0410-4R7K（104931） | 10本 | 1 | 80 | AL0510 の 4.7µH は扱いなし。一回り小さい AL0410 を縦に立てる |
| マイクロインダクタ 15mH | 15mH | 1 | L7 | 秋月電子 | AL0510-153K（111407） | 10本 | 1 | 110 |  |
| マイクロインダクタ 100nH | 100nH | 2 | L8, L9 | DigiKey／Mouser（要確認） | 100nH アキシャル（AL0510 相当） |  |  |  | 秋月に扱いなし。代替: 空芯 φ0.6mm 線・φ4.4mm 芯に 5 回巻き（線の中心で直径 5mm）・巻き幅 約3.9mm で約100nH（密巻き 3mm で約117nH、伸ばして合わせる）。L8 と L9 は軸を 90° ずらして付け、2 個の値をそろえる |
| マイクロインダクタ 1mH | 1mH | 2 | L10, L11 | 秋月電子 | AL0510-102K（111367） | 10本 | 1 | 150 |  |
| アキシャルインダクタ 270nH | 270nH | 1 | L15 | DigiKey／Mouser（要確認） | Fastron SMCC-R27K-02（0.27µH ±10%、Q 45、0.11Ω、1.4A） |  |  |  | 秋月に扱いなし |
| トロイダルコア T-50-10（0.6mm ポリウレタン線を巻く） | T-50-10 9T/0.6mm・T-50-10 10T/0.6mm・T-50-10 8T/0.6mm | 3 | L16, L17, L19 | 秋月電子 | T-50-10（111948） | 1個 | 3 | 450 | 線は別途 |
| マイクロインダクタ 10µH | 10uH | 2 | L20, RFC1 | 秋月電子 | AL0510-100K（104922） | 10本 | 1 | 110 |  |

## ダイオード（4 種類・10 個）

| 品名 | 値/型番 | 合計個数 | 部品番号 | 購入先 | 型番（販売コード） | 入数 | 買う数 | 金額 | メモ |
|---|---|---:|---|---|---|---|---:|---:|---|
| 整流ダイオード 1A | 1N4001 | 1 | D1 | 秋月電子 | 1N4007-3485（100934） | 20本 | 1 | 100 | 1N4001 の代わりに 1N4007 |
| 小信号ダイオード | 1N4148 | 2 | D2, D3 | 秋月電子 | 1N4148（100941） | 50本 | 1 | 200 | 受信入力の保護 |
| ゲルマニウムダイオード | 1N60 | 6 | D4-D9 | サトー電気 など（要確認） | 1N60 |  |  |  | 秋月に扱いなし |
| ショットキーダイオード 40V 1A | 1N5819 | 1 | D10 | 秋月電子 | 1N5819（117244） | 10本 | 1 | 100 |  |

## トランジスタ・FET（7 種類・22 個）

| 品名 | 値/型番 | 合計個数 | 部品番号 | 購入先 | 型番（販売コード） | 入数 | 買う数 | 金額 | メモ |
|---|---|---:|---|---|---|---|---:|---:|---|
| PNP トランジスタ | 2SA1015 | 1 | Q1 | 秋月電子 | 2SA1015L-GR-T92（106734） | 20個 | 1 | 100 |  |
| N-ch JFET（TO-92 小型） | 2SK192A | 4 | Q2, Q3, Q6, Q7 | 秋月電子／サトー電気 など（要確認） | 2SK192A-BL（東芝） |  |  |  | Q2・Q3（RF 増幅）と Q6・Q7（IF 増幅）のカスコード。BL ランク（IDSS 12〜24mA）を 4 個そろえる（上段・下段の組で IDSS が近いもの）。ソース抵抗 R3・R18 は 100Ω。ピン 1 D・2 S・3 G（データシートで確認済み）。製造中止品の流通在庫 |
| RF 用 N-ch JFET | 2SK439 | 2 | Q4, Q17 | サトー電気 など（要確認） | 2SK439 |  |  |  | 製造中止品 |
| NPN トランジスタ | 2SC1815 | 12 | Q5, Q8-Q11, Q14-Q16, Q18, Q20-Q22 | 秋月電子 | 2SC1815L-GR-T92（106477） | 20個 | 1 | 100 |  |
| PNP トランジスタ | 2SA950 | 1 | Q12 | 秋月電子 | 2SA950-Y（113825） | 20個 | 1 | 150 |  |
| NPN トランジスタ | 2SC2120 | 1 | Q13 | 秋月電子 | 2SC2120-Y（113829） | 20個 | 1 | 150 |  |
| RF パワー MOSFET | RD06HVF1 | 1 | Q19 | DigiKey／RF 部品店（要確認） | RD06HVF1 |  |  |  | 秋月に扱いなし |

## 水晶振動子（1 種類・6 個）

| 品名 | 値/型番 | 合計個数 | 部品番号 | 購入先 | 型番（販売コード） | 入数 | 買う数 | 金額 | メモ |
|---|---|---:|---|---|---|---|---:|---:|---|
| 水晶振動子 12MHz HC-49/S | 12MHz | 6 | Y1-Y6 | 秋月電子 | HUSG-12.000-20（108669） | 1個 | 6 | 180 | ラダーフィルタ用に同じロットを 10〜20 個買い、直列共振が ±50Hz 以内の 6 個を選ぶ |

## IC・レギュレータ・モジュール（7 種類・8 個）

| 品名 | 値/型番 | 合計個数 | 部品番号 | 購入先 | 型番（販売コード） | 入数 | 買う数 | 金額 | メモ |
|---|---|---:|---|---|---|---|---:|---:|---|
| ダブルバランスドミキサ IC（SSOP8） | NJM2594V | 2 | U1, U2 | 秋月電子 | NJM2594V（111195） | 1個 | 2 | 300 | 第 1 混合と積検波で 2 個。表面実装 |
| 対数増幅器（S メーター） | AD8307ANZ | 1 | U3 | 秋月電子 | AD8307ANZ（100195） | 1個 | 1 | 2,000 | DIP-8 |
| 5V 3 端子レギュレータ | 78L05 | 1 | U4 | 秋月電子 | TA78L05S（108973） | 1個 | 1 | 20 | 受信用 5V。78L05 と同じピン配置（TO-92） |
| デュアルオペアンプ | NJM2904 | 1 | U5 | 秋月電子 | NJM2904D（109216） | 1個 | 1 | 60 |  |
| Si5351A クロックジェネレータモジュール | Si5351_DIP8 | 1 | U6 | 秋月電子 | AE-Si5351A-B（110679） | 1セット | 1 | 650 | ピン配置を基板と照合してから取り付ける |
| DC-DC コンバータ 5V 1A（78xx 互換） | R-78E5.0-1.0 | 1 | U8 | DigiKey／Mouser | R-78E5.0-1.0 |  |  |  | 秋月は 0.5A 品 R-78E5.0-0.5（106353）のみ |
| 3.3V LDO レギュレータ | LP2950-3.3_TO92 | 1 | U9 | 秋月電子 | LP2950L-33-T92（108749） | 1個 | 1 | 30 |  |

## マイコンモジュール（1 種類・1 個）

| 品名 | 値/型番 | 合計個数 | 部品番号 | 購入先 | 型番（販売コード） | 入数 | 買う数 | 金額 | メモ |
|---|---|---:|---|---|---|---|---:|---:|---|
| Seeed Studio XIAO ESP32C3 | Seeeduino_XIAO_Socket | 1 | U7 | 秋月電子 | 113991054（117454） | 1個 | 1 | 1,080 |  |

## トランス・リレー（1 種類・1 個）

| 品名 | 値/型番 | 合計個数 | 部品番号 | 購入先 | 型番（販売コード） | 入数 | 買う数 | 金額 | メモ |
|---|---|---:|---|---|---|---|---:|---:|---|
| リレー DPDT 12V（オムロン G5V-2） | G5V-2 DC12 | 1 | K1 | DigiKey／Mouser | G5V-2-DC12 |  |  |  | 秋月に扱いなし |

## コネクタ（4 種類・12 個）

| 品名 | 値/型番 | 合計個数 | 部品番号 | 購入先 | 型番（販売コード） | 入数 | 買う数 | 金額 | メモ |
|---|---|---:|---|---|---|---|---:|---:|---|
| 同軸ケーブル（基板に直接はんだ付け） | RF_IN | 1 | J1 | （同軸ケーブル） | RG-174 など 50Ω |  |  |  | J1 はピンヘッダを使わず、穴 φ1.1mm に芯線と編組を直接はんだ付けする（編組の引き出しは短く） |
| 電源線（基板に直接はんだ付け） | PWR_IN | 1 | J2 | （電線） | AWG20（0.5sq） |  |  |  | J2 はピンヘッダを使わず、穴 φ1.1mm に電線を直接はんだ付けする（電流は送信時でも 1A 弱） |
| ピンヘッダ | Volume・SP-OUT・MIC-IN・I2C_OUT-LCD・TX-ON-LED・Encoder・NX4832T035・POWER-LED | 9（27 ピン） | J3, J5, J6, J7, J8, J9, J10, J11, J12 | 秋月電子 | PH-1x40SG（100167） | 1本(40P) | 1 | 35 | J3・J5〜J12 で 1 本 |
| ADS1015 12 ビット I2C AD コンバータモジュール | AE-ADS1015 | 1 | J4 | 秋月電子 | AE-ADS1015（113838） | 1個 | 1 | 540 | 付属のピンヘッダで基板に立てて差す。差す前に裏の SDA・SCL のプルアップ用はんだジャンパを短絡する（I2C の線にほかのプルアップがない） |

## パネル部品（基板非搭載）（1 種類・1 個）

| 品名 | 値/型番 | 合計個数 | 部品番号 | 購入先 | 型番（販売コード） | 入数 | 買う数 | 金額 | メモ |
|---|---|---:|---|---|---|---|---:|---:|---|
| 3mm LED 黄 | LED黄 | 1 | LED1 | 秋月電子 | OSY5JA3Z74A（111639） | 1個 | 1 | 20 |  |

## 回路図に載っていない部品（17 種類・59 個＋「各」の行）

| 品名 | 値/型番 | 合計個数 | 部品番号 | 購入先 | 型番（販売コード） | 入数 | 買う数 | 金額 | メモ |
|---|---|---:|---|---|---|---|---:|---:|---|
| 放熱器 17PB046（HS1） |  | 1 |  | 秋月電子 | 17PB046-01025（105050） | 1個 | 1 | 90 |  |
| RF ゲイン用 可変抵抗 10kΩ B カーブ（回路図 VR1、DNP） |  | 1 |  | 秋月電子 | SH16K4B103L20KCCI（118292） | 1個 | 1 | 80 |  |
| AF ボリューム 10kΩ A カーブ（回路図 VR2、DNP） |  | 1 |  | 秋月電子 | SH16K4A103L20KCCI（129553） | 1個 | 1 | 60 |  |
| ロータリーエンコーダ（押しスイッチ付き） |  | 1 |  | 秋月電子 | EC12E2420801（106357） | 1個 | 1 | 100 | 押しスイッチ付きか要確認 |
| LCD NX4832T035（Nextion、3.5インチ 480×320 シリアル HMI） |  | 1 |  | Nextion 公式ストア（AliExpress・Amazon など） | NX4832T035_011 |  |  |  |  |
| マイクコネクタ 4P |  | 1 |  | 千石電商／マルツ など（要確認） | 4P 丸型マイクコネクタ（メス、パネル取付 φ16） |  |  |  |  |
| イヤホンジャック 3.5mm スイッチ付き（MJ-352W-C） |  | 1 |  | 秋月電子 | MJ-352W-C（117359） | 1個 | 1 | 175 | M6 ナットでふたに固定。スイッチ付き |
| IC ソケット DIP-8 |  | 3 |  | 秋月電子 | 2227-08-03（100017） | 10個 | 1 | 110 |  |
| M3 インサートナット |  | 24 |  | Amazon／モノタロウ |  |  |  |  |  |
| M3×8 ねじ |  | 4 |  | ホームセンター／モノタロウ |  |  |  |  |  |
| M3×10 ねじ |  | 8 |  | ホームセンター／モノタロウ |  |  |  |  |  |
| M3×10 皿ねじ |  | 4 |  | ホームセンター／モノタロウ |  |  |  |  |  |
| M3×6 ねじ |  | 8 |  | ホームセンター／モノタロウ |  |  |  |  |  |
| スピーカー 5cm 8Ω 0.5W |  | 1 |  | 秋月電子 | DXYD50N-22Z-8A-F（116024） | 1個 | 1 | 250 |  |
| 電源スイッチ（φ13 穴）、3mm LED（高輝度） |  | 各 1 |  | 要確認 | φ13 穴に合うもの |  |  |  | LED は秋月 OSG5TA3Z74A（111635）、2.2kΩ は CF25J2K2B（125222） |
| DC ジャック（センタープラス）、ヒューズホルダ 5×20 ＋ 1A 速断、BNC |  | 2 ／ 1 ／ 1 |  | 秋月電子 | MJ-14 ／ MF-524M ／ B-014IF（106342 ／ 107079 ／ 100093） | 2個／1個／1個 |  |  | DC ジャック／ヒューズホルダ／BNC。ヒューズは MF51NR 250V 1（107129、40 円） |
| M3×8 皿ねじ・M3 ナット |  | 各 4 |  | ホームセンター／モノタロウ |  |  |  |  |  |
