kazushinjo/PSN_TRX_XIAO_ESP32C3-V2/kicad/bom.csv

Reference | Value | Footprint | Qty | DNP
C1 | 10p | Capacitor_THT:C_Disc_D3.0mm_W1.6mm_P2.50mm | 1
C2,C3,C5-C7,C9,C10,C12,C15,C22,C23,C25,C26,C29,C32-C34,C51,C52,C54,C74,C75,C82,C83,C85,C87-C89,C91,C110 | 0.01u | Capacitor_THT:C_Disc_D5.0mm_W2.5mm_P2.50mm | 30
C4,C100,C103 | 5p | Capacitor_THT:C_Disc_D3.0mm_W1.6mm_P2.50mm | 3
C8 | 27p | Capacitor_THT:C_Disc_D3.0mm_W1.6mm_P2.50mm | 1
C11,C13,C14,C27,C28,C30,C35,C36,C41-C43,C49,C53,C64,C109 | 0.1u | Capacitor_THT:C_Disc_D5.0mm_W2.5mm_P2.50mm | 15
C16,C84,C86,C90 | 15p | Capacitor_THT:C_Disc_D3.0mm_W1.6mm_P2.50mm | 4
C17,C21 | 82p | Capacitor_THT:C_Disc_D3.0mm_W1.6mm_P2.50mm | 2
C18,C20 | 100p | Capacitor_THT:C_Disc_D3.0mm_W1.6mm_P2.50mm | 2
C19 | 120p | Capacitor_THT:C_Disc_D3.0mm_W1.6mm_P2.50mm | 1
C24,C31 | 33p | Capacitor_THT:C_Disc_D3.0mm_W1.6mm_P2.50mm | 2
C37,C39,C40,C44-C46,C104 | 1u | Capacitor_THT:C_Disc_D5.0mm_W2.5mm_P2.50mm | 7
C38 | 0.047u | Capacitor_THT:C_Disc_D5.0mm_W2.5mm_P2.50mm | 1
C47,C48,C96 | 100u | Capacitor_THT:CP_Radial_D6.3mm_P2.50mm | 3
C50,C55,C58,C61,C63,C105-C108 | 10u | Capacitor_THT:CP_Radial_D5.0mm_P2.00mm | 9
C56 | 47u | Capacitor_THT:CP_Radial_D5.0mm_P2.00mm | 1
C57,C62,C65,C70-C73 | 1u | Capacitor_THT:CP_Radial_D5.0mm_P2.00mm | 7
C59 | 0.01u | PSN_TRX:C_Radial_D5.0mm_P2.00mm_CPpad | 1
C60 | 0.068u | PSN_TRX:C_Radial_D5.0mm_P2.00mm_CPpad | 1
C66-C69 | 3300p | Capacitor_THT:C_Disc_D5.0mm_W2.5mm_P2.50mm | 4
C76-C79 | 47PF | Capacitor_THT:C_Disc_D5.0mm_W2.5mm_P2.50mm | 4
C80,C81 | 0.001u | Capacitor_THT:C_Disc_D5.0mm_W2.5mm_P2.50mm | 2
C92 | 150pF | Capacitor_THT:C_Disc_D5.0mm_W2.5mm_P5.00mm | 1
C93 | 33pF | Capacitor_THT:C_Disc_D5.0mm_W2.5mm_P5.00mm | 1
C94 | 0.001u | Capacitor_THT:C_Disc_D5.0mm_W2.5mm_P5.00mm | 1
C95,C97 | 0.1uF | Capacitor_THT:C_Disc_D5.0mm_W2.5mm_P5.00mm | 2
C98 | 39p | Capacitor_THT:C_Disc_D5.0mm_W2.5mm_P5.00mm | 1
C99 | 82p | Capacitor_THT:C_Disc_D5.0mm_W2.5mm_P5.00mm | 1
C101 | 100p | Capacitor_THT:C_Disc_D5.0mm_W2.5mm_P5.00mm | 1
C102 | 68p | Capacitor_THT:C_Disc_D5.0mm_W2.5mm_P5.00mm | 1
D1 | 1N4001 | Diode_THT:D_DO-41_SOD81_P10.16mm_Horizontal | 1
D2,D3 | 1N4148 | Diode_THT:D_DO-35_SOD27_P2.54mm_Vertical_CathodeUp | 2
D4-D9 | 1N60 | Diode_THT:D_DO-35_SOD27_P2.54mm_Vertical_CathodeUp | 6
D10 | 1N5819 | Diode_THT:D_DO-41_SOD81_P5.08mm_Vertical_AnodeUp | 1
J1 | RF_IN | PSN_TRX:SolderWire_1x02_P2.54mm_D1.1mm | 1
J2 | PWR_IN | PSN_TRX:SolderWire_1x02_P5.08mm_D1.1mm | 1
J3,J5 | Volume | Connector_PinHeader_2.54mm:PinHeader_1x03_P2.54mm_Vertical | 2
J4 | AE-ADS1015 | PSN_TRX:AE-ADS1015_Vertical | 1
J6 | SP-OUT | Connector_PinHeader_2.54mm:PinHeader_1x02_P2.54mm_Vertical | 1
J7 | MIC-IN | Connector_PinHeader_2.54mm:PinHeader_1x04_P2.54mm_Vertical | 1
J8 | I2C_OUT-LCD | Connector_PinHeader_2.54mm:PinHeader_1x03_P2.54mm_Vertical | 1
J9 | TX-ON-LED | Connector_PinHeader_2.54mm:PinHeader_1x02_P2.54mm_Vertical | 1
J10 | Encoder | Connector_PinHeader_2.54mm:PinHeader_1x04_P2.54mm_Vertical | 1
J11 | NX4832T035 | Connector_PinHeader_2.54mm:PinHeader_1x04_P2.54mm_Vertical | 1
J12 | POWER-LED | Connector_PinHeader_2.54mm:PinHeader_1x02_P2.54mm_Vertical | 1
K1 | G5V-2 DC12 | PSN_TRX:Relay_DPDT_Omron_G5V-2_D1.0mm | 1
L1 | T30-6 11T/2T | PSN_TRX:L_T30_3pin_Vertical | 1
L2 | T30-6 11T/3T | PSN_TRX:L_T30_3pin_Vertical | 1
L3,L12-L14 | 7T50 | PSN_TRX:L_FCZ07S_CT | 4
L4 | 8.2uH | PSN_TRX:L_AL0510-153K_Vertical | 1
L5,L6 | 4.7uH | PSN_TRX:L_AL0510-153K_Vertical | 2
L7 | 15mH | PSN_TRX:L_AL0510-153K_Vertical | 1
L8,L9 | 100nH | PSN_TRX:L_AL0510-153K_Vertical | 2
L10,L11 | 1mH | PSN_TRX:L_AL0510-153K_Vertical | 2
L15 | 270nH | Inductor_THT:L_Axial_L9.5mm_D4.0mm_P2.54mm_Vertical_Fastron_SMCC | 1
L16 | T-50-10 9T/0.6mm | PSN_TRX:L_T50_2pin_Vertical | 1
L17 | T-50-10 10T/0.6mm | PSN_TRX:L_T50_2pin_Vertical | 1
L18 | T-30-6 8T/0.4mm | PSN_TRX:L_T30_2pin_Vertical | 1
L19 | T-50-10 8T/0.6mm | PSN_TRX:L_T50_2pin_Vertical | 1
L20 | 10uH | PSN_TRX:L_AL0510-153K_Vertical | 1
LED1 | LED黄 | Connector_PinHeader_2.54mm:PinHeader_1x02_P2.54mm_Vertical | 1 | 未実装(DNP)
Q1 | 2SA1015 | Package_TO_SOT_THT:TO-92_Inline | 1
Q2,Q3,Q6,Q7 | 2SK192A | Package_TO_SOT_THT:TO-92_Inline | 4
Q4,Q17 | 2SK439 | Package_TO_SOT_THT:TO-92_Inline | 2
Q5,Q8-Q11,Q14-Q16,Q18,Q20-Q22 | 2SC1815 | Package_TO_SOT_THT:TO-92_Inline | 12
Q12 | 2SA950 | Package_TO_SOT_THT:TO-92_Inline | 1
Q13 | 2SC2120 | Package_TO_SOT_THT:TO-92_Inline | 1
Q19 | RD06HVF1 | Package_TO_SOT_THT:TO-220-3_Vertical | 1
R1,R12,R23,R43,R61,R62,R67 | 4.7k | Resistor_THT:R_Axial_DIN0207_L6.3mm_D2.5mm_P2.54mm_Vertical | 7
R2,R39,R40,R75,R78-R80 | 10k | Resistor_THT:R_Axial_DIN0207_L6.3mm_D2.5mm_P2.54mm_Vertical | 7
R3,R9,R18,R20,R68 | 100 | Resistor_THT:R_Axial_DIN0207_L6.3mm_D2.5mm_P2.54mm_Vertical | 5
R4,R6,R29,R32,R35,R44,R48,R49,R71,R73,R74 | 100k | Resistor_THT:R_Axial_DIN0207_L6.3mm_D2.5mm_P2.54mm_Vertical | 11
R5,R21 | 2.2k | Resistor_THT:R_Axial_DIN0207_L6.3mm_D2.5mm_P2.54mm_Vertical | 2
R7,R65 | 51 | Resistor_THT:R_Axial_DIN0207_L6.3mm_D2.5mm_P2.54mm_Vertical | 2
R8 | 470 | Resistor_THT:R_Axial_DIN0207_L6.3mm_D2.5mm_P2.54mm_Vertical | 1
R10,R27,R30,R31,R33,R36,R37,R42,R45,R50,R72 | 1k | Resistor_THT:R_Axial_DIN0207_L6.3mm_D2.5mm_P2.54mm_Vertical | 11
R11,R22 | 27k | Resistor_THT:R_Axial_DIN0207_L6.3mm_D2.5mm_P2.54mm_Vertical | 2
R13,R34 | 1.5k | Resistor_THT:R_Axial_DIN0207_L6.3mm_D2.5mm_P2.54mm_Vertical | 2
R14 | 33 | Resistor_THT:R_Axial_DIN0207_L6.3mm_D2.5mm_P2.54mm_Vertical | 1
R15 | 180 | Resistor_THT:R_Axial_DIN0207_L6.3mm_D2.5mm_P2.54mm_Vertical | 1
R16,R38,R46 | 330 | Resistor_THT:R_Axial_DIN0207_L6.3mm_D2.5mm_P2.54mm_Vertical | 3
R17,R51,R66 | 20k | Resistor_THT:R_Axial_DIN0207_L6.3mm_D2.5mm_P2.54mm_Vertical | 3
R19 | 1.2k | Resistor_THT:R_Axial_DIN0207_L6.3mm_D2.5mm_P2.54mm_Vertical | 1
R24 | 27 | Resistor_THT:R_Axial_DIN0207_L6.3mm_D2.5mm_P2.54mm_Vertical | 1
R25 | 220 | Resistor_THT:R_Axial_DIN0207_L6.3mm_D2.5mm_P2.54mm_Vertical | 1
R26 | 10 | Resistor_THT:R_Axial_DIN0207_L6.3mm_D2.5mm_P2.54mm_Vertical | 1
R28 | 8.2k | Resistor_THT:R_Axial_DIN0207_L6.3mm_D2.5mm_P2.54mm_Vertical | 1
R41 | 100 1W | Resistor_THT:R_Axial_DIN0207_L6.3mm_D2.5mm_P2.54mm_Vertical | 1
R47 | 620 | Resistor_THT:R_Axial_DIN0207_L6.3mm_D2.5mm_P2.54mm_Vertical | 1
R52 | 22k | Resistor_THT:R_Axial_DIN0207_L6.3mm_D2.5mm_P2.54mm_Vertical | 1
R53-R56 | 3.3k | Resistor_THT:R_Axial_DIN0207_L6.3mm_D2.5mm_P2.54mm_Vertical | 4
R57,R59 | 1M | Resistor_THT:R_Axial_DIN0207_L6.3mm_D2.5mm_P2.54mm_Vertical | 2
R58,R60 | 22 | Resistor_THT:R_Axial_DIN0207_L6.3mm_D2.5mm_P2.54mm_Vertical | 2
R63,R64 | 47 | Resistor_THT:R_Axial_DIN0207_L6.3mm_D2.5mm_P2.54mm_Vertical | 2
R69 | 10 | Resistor_THT:R_Axial_DIN0207_L6.3mm_D2.5mm_P5.08mm_Vertical | 1
R70 | 330 | Resistor_THT:R_Axial_DIN0207_L6.3mm_D2.5mm_P5.08mm_Vertical | 1
R76,R77 | 47k | Resistor_THT:R_Axial_DIN0207_L6.3mm_D2.5mm_P2.54mm_Vertical | 2
RFC1 | 10uH | Inductor_THT:L_Axial_L14.0mm_D4.5mm_P15.24mm_Horizontal_Fastron_LACC | 1
TC1-TC3 | 30p | PSN_TRX:C_Trimmer_TMCV01 | 3
TC4 | 10p | PSN_TRX:C_Trimmer_TMCV01 | 1
U1,U2 | NJM2594V | Package_SO:TSSOP-8_4.4x3mm_P0.65mm | 2
U3 | AD8307ANZ | Package_DIP:DIP-8_W7.62mm | 1
U4 | 78L05 | Package_TO_SOT_THT:TO-92_Inline | 1
U5 | NJM2904 | Package_DIP:DIP-8_W7.62mm | 1
U6 | Si5351_DIP8 | PSN_TRX:DIP-8_W7.62mm | 1
U7 | Seeeduino_XIAO_Socket | PSN_TRX:Seeeduino_XIAO_Socket | 1
U8 | R-78E5.0-1.0 | PSN_TRX:DCDC_RECOM_R-78E_78Lxx-pinmap | 1
U9 | LP2950-3.3_TO92 | Package_TO_SOT_THT:TO-92_Inline | 1
VR3,VR4 | 500 | PSN_TRX:Potentiometer_TOCOS_GF063P_Vertical | 2
VR5,VR6 | 1k | PSN_TRX:Potentiometer_TOCOS_GF063P_Vertical | 2
VR7 | 500 | Potentiometer_THT:Potentiometer_Bourns_3266W_Vertical | 1
Y1-Y6 | 12MHz | Crystal:Crystal_HC49-U_Vertical | 6
