kazushinjo/PSN_TRX_XIAO_ESP32C3-V2/kicad/bom_purchase_sato.csv

区分 | Reference | 品名 | 値/型番 | フットプリント | 数量 | 購入先 | 購入先の型番 | 販売コード | 入数 | 価格（税込、サトー電気 2026-11-04／秋月 2026-10-15・11-04） | 購入メモ
抵抗 | R1,R12,R23,R43,R61,R62,R67 | カーボン抵抗 1/4W | 4.7k | R_Axial_DIN0207_L6.3mm_D2.5mm_P2.54mm_Vertical | 7 | サトー電気 | カーボン抵抗 1/4W S1 4.7kΩ |  | 1本 | 20（10本以上は単価 13、1種 100本 660）
抵抗 | R2,R39,R40,R75,R78-R80 | カーボン抵抗 1/4W | 10k | R_Axial_DIN0207_L6.3mm_D2.5mm_P2.54mm_Vertical | 7 | サトー電気 | カーボン抵抗 1/4W S1 10kΩ |  | 1本 | 20（10本以上は単価 13、1種 100本 660）
抵抗 | R3,R9,R18,R20,R68 | カーボン抵抗 1/4W | 100 | R_Axial_DIN0207_L6.3mm_D2.5mm_P2.54mm_Vertical | 5 | サトー電気 | カーボン抵抗 1/4W S1 100Ω |  | 1本 | 20（10本以上は単価 13、1種 100本 660）
抵抗 | R4,R6,R29,R32,R35,R44,R48,R49,R71,R73,R74 | カーボン抵抗 1/4W | 100k | R_Axial_DIN0207_L6.3mm_D2.5mm_P2.54mm_Vertical | 11 | サトー電気 | カーボン抵抗 1/4W S1 100kΩ |  | 1本 | 20（10本以上は単価 13、1種 100本 660）
抵抗 | R5,R21 | カーボン抵抗 1/4W | 2.2k | R_Axial_DIN0207_L6.3mm_D2.5mm_P2.54mm_Vertical | 2 | サトー電気 | カーボン抵抗 1/4W S1 2.2kΩ |  | 1本 | 20（10本以上は単価 13、1種 100本 660）
抵抗 | R7,R65 | カーボン抵抗 1/4W | 51 | R_Axial_DIN0207_L6.3mm_D2.5mm_P2.54mm_Vertical | 2 | サトー電気 | カーボン抵抗 1/4W S1 51Ω |  | 1本 | 20（10本以上は単価 13、1種 100本 660）
抵抗 | R8 | カーボン抵抗 1/4W | 470 | R_Axial_DIN0207_L6.3mm_D2.5mm_P2.54mm_Vertical | 1 | サトー電気 | カーボン抵抗 1/4W S1 470Ω |  | 1本 | 20（10本以上は単価 13、1種 100本 660）
抵抗 | R10,R27,R30,R31,R33,R36,R37,R42,R45,R50,R72 | カーボン抵抗 1/4W | 1k | R_Axial_DIN0207_L6.3mm_D2.5mm_P2.54mm_Vertical | 11 | サトー電気 | カーボン抵抗 1/4W S1 1kΩ |  | 1本 | 20（10本以上は単価 13、1種 100本 660）
抵抗 | R11,R22 | カーボン抵抗 1/4W | 27k | R_Axial_DIN0207_L6.3mm_D2.5mm_P2.54mm_Vertical | 2 | サトー電気 | カーボン抵抗 1/4W S1 27kΩ |  | 1本 | 20（10本以上は単価 13、1種 100本 660）
抵抗 | R13,R34 | カーボン抵抗 1/4W | 1.5k | R_Axial_DIN0207_L6.3mm_D2.5mm_P2.54mm_Vertical | 2 | サトー電気 | カーボン抵抗 1/4W S1 1.5kΩ |  | 1本 | 20（10本以上は単価 13、1種 100本 660）
抵抗 | R14 | カーボン抵抗 1/4W | 33 | R_Axial_DIN0207_L6.3mm_D2.5mm_P2.54mm_Vertical | 1 | サトー電気 | カーボン抵抗 1/4W S1 33Ω |  | 1本 | 20（10本以上は単価 13、1種 100本 660）
抵抗 | R15 | カーボン抵抗 1/4W | 180 | R_Axial_DIN0207_L6.3mm_D2.5mm_P2.54mm_Vertical | 1 | サトー電気 | カーボン抵抗 1/4W S1 180Ω |  | 1本 | 20（10本以上は単価 13、1種 100本 660）
抵抗 | R16,R38,R46 | カーボン抵抗 1/4W | 330 | R_Axial_DIN0207_L6.3mm_D2.5mm_P2.54mm_Vertical | 3 | サトー電気 | カーボン抵抗 1/4W S1 330Ω |  | 1本 | 20（10本以上は単価 13、1種 100本 660）
抵抗 | R17,R51,R66 | カーボン抵抗 1/4W | 20k | R_Axial_DIN0207_L6.3mm_D2.5mm_P2.54mm_Vertical | 3 | サトー電気 | カーボン抵抗 1/4W S1 20kΩ |  | 1本 | 20（10本以上は単価 13、1種 100本 660）
抵抗 | R19 | カーボン抵抗 1/4W | 1.2k | R_Axial_DIN0207_L6.3mm_D2.5mm_P2.54mm_Vertical | 1 | サトー電気 | カーボン抵抗 1/4W S1 1.2kΩ |  | 1本 | 20（10本以上は単価 13、1種 100本 660）
抵抗 | R24 | カーボン抵抗 1/4W | 27 | R_Axial_DIN0207_L6.3mm_D2.5mm_P2.54mm_Vertical | 1 | サトー電気 | カーボン抵抗 1/4W S1 27Ω |  | 1本 | 20（10本以上は単価 13、1種 100本 660）
抵抗 | R25 | カーボン抵抗 1/4W | 220 | R_Axial_DIN0207_L6.3mm_D2.5mm_P2.54mm_Vertical | 1 | サトー電気 | カーボン抵抗 1/4W S1 220Ω |  | 1本 | 20（10本以上は単価 13、1種 100本 660）
抵抗 | R26 | カーボン抵抗 1/4W | 10 | R_Axial_DIN0207_L6.3mm_D2.5mm_P2.54mm_Vertical | 1 | サトー電気 | カーボン抵抗 1/4W S1 10Ω |  | 1本 | 20（10本以上は単価 13、1種 100本 660）
抵抗 | R28 | カーボン抵抗 1/4W | 8.2k | R_Axial_DIN0207_L6.3mm_D2.5mm_P2.54mm_Vertical | 1 | サトー電気 | カーボン抵抗 1/4W S1 8.2kΩ |  | 1本 | 20（10本以上は単価 13、1種 100本 660）
抵抗 | R41 | 酸化金属皮膜抵抗 1W 100Ω | 100 1W | R_Axial_DIN0207_L6.3mm_D2.5mm_P2.54mm_Vertical | 1 | サトー電気 | 酸化金属皮膜抵抗 1W 100Ω（日本製） |  | 1本 | 28（1種 10本 220） | 縦置き・2.54mm ピッチに入るか外形を確かめる。入らなければ秋月の超小型品 MFU100F100RB
抵抗 | R47 | カーボン抵抗 1/4W | 620 | R_Axial_DIN0207_L6.3mm_D2.5mm_P2.54mm_Vertical | 1 | サトー電気 | カーボン抵抗 1/4W S1 620Ω |  | 1本 | 20（10本以上は単価 13、1種 100本 660）
抵抗 | R52 | カーボン抵抗 1/4W | 22k | R_Axial_DIN0207_L6.3mm_D2.5mm_P2.54mm_Vertical | 1 | サトー電気 | カーボン抵抗 1/4W S1 22kΩ |  | 1本 | 20（10本以上は単価 13、1種 100本 660）
抵抗 | R53-R56 | カーボン抵抗 1/4W | 3.3k | R_Axial_DIN0207_L6.3mm_D2.5mm_P2.54mm_Vertical | 4 | サトー電気 | カーボン抵抗 1/4W S1 3.3kΩ |  | 1本 | 20（10本以上は単価 13、1種 100本 660）
抵抗 | R57,R59 | カーボン抵抗 1/4W | 1M | R_Axial_DIN0207_L6.3mm_D2.5mm_P2.54mm_Vertical | 2 | サトー電気 | カーボン抵抗 1/4W S1 1MΩ |  | 1本 | 20（10本以上は単価 13、1種 100本 660）
抵抗 | R58,R60 | カーボン抵抗 1/4W | 22 | R_Axial_DIN0207_L6.3mm_D2.5mm_P2.54mm_Vertical | 2 | サトー電気 | カーボン抵抗 1/4W S1 22Ω |  | 1本 | 20（10本以上は単価 13、1種 100本 660）
抵抗 | R63,R64 | カーボン抵抗 1/4W | 47 | R_Axial_DIN0207_L6.3mm_D2.5mm_P2.54mm_Vertical | 2 | サトー電気 | カーボン抵抗 1/4W S1 47Ω |  | 1本 | 20（10本以上は単価 13、1種 100本 660）
抵抗 | R69 | カーボン抵抗 1/4W | 10 | R_Axial_DIN0207_L6.3mm_D2.5mm_P5.08mm_Vertical | 1 | サトー電気 | カーボン抵抗 1/4W S1 10Ω |  | 1本 | 20（10本以上は単価 13、1種 100本 660）
抵抗 | R70 | カーボン抵抗 1/4W | 330 | R_Axial_DIN0207_L6.3mm_D2.5mm_P5.08mm_Vertical | 1 | サトー電気 | カーボン抵抗 1/4W S1 330Ω |  | 1本 | 20（10本以上は単価 13、1種 100本 660）
抵抗 | R76,R77 | カーボン抵抗 1/4W | 47k | R_Axial_DIN0207_L6.3mm_D2.5mm_P2.54mm_Vertical | 2 | サトー電気 | カーボン抵抗 1/4W S1 47kΩ |  | 1本 | 20（10本以上は単価 13、1種 100本 660）
半固定抵抗 | VR3,VR4 | 半固定抵抗 東京コスモス GF063P | 500 | Potentiometer_TOCOS_GF063P_Vertical | 2 | サトー電気 | GF063P 500Ω（7mm角 立型） |  | 1個 | 50（1種 10個 462）
半固定抵抗 | VR5,VR6 | 半固定抵抗 東京コスモス GF063P | 1k | Potentiometer_TOCOS_GF063P_Vertical | 2 | サトー電気 | GF063P 1kΩ（7mm角 立型） |  | 1個 | 50（1種 10個 462）
半固定抵抗 | VR7 | 多回転半固定抵抗 Bourns 3266W | 500 | Potentiometer_Bourns_3266W_Vertical | 1 | DigiKey／Mouser | 3266W-1-501LF |  |  |  | 秋月の 3296W は外形が大きく基板に合わない
コンデンサ（セラミック） | C1 | セラミックコンデンサ 10pF 50V | 10p | C_Disc_D3.0mm_W1.6mm_P2.50mm | 1 | サトー電気 | セラミックコンデンサ ディスク型 50V 10pF |  | 1個 | 17（1種 10個 110） | 5本以上で注文。受信の入力同調。同調・フィルタ用。温度特性の表示がないので、気になる場合は秋月の C0G 品（bom_purchase.csv）を使う
コンデンサ（セラミック） | C2,C3,C5-C7,C9,C10,C12,C15,C22,C23,C25,C26,C29,C32-C34,C51,C52,C54,C74,C75,C82,C83,C85,C87-C89,C91,C110 | セラミックコンデンサ 0.01µF 50V | 0.01u | C_Disc_D5.0mm_W2.5mm_P2.50mm | 30 | サトー電気 | セラミックコンデンサ ディスク型 50V 0.01µF（103） |  | 1個 | 17（1種 10個 110） | 5本以上で注文
コンデンサ（セラミック） | C4,C100,C103 | セラミックコンデンサ 5pF 50V | 5p | C_Disc_D3.0mm_W1.6mm_P2.50mm | 3 | サトー電気 | セラミックコンデンサ ディスク型 50V 5pF |  | 1個 | 17（1種 10個 110） | 5本以上で注文。同調・フィルタ用。温度特性の表示がないので、気になる場合は秋月の C0G 品（bom_purchase.csv）を使う
コンデンサ（セラミック） | C8 | セラミックコンデンサ 27pF 50V | 27p | C_Disc_D3.0mm_W1.6mm_P2.50mm | 1 | サトー電気 | セラミックコンデンサ ディスク型 50V 27pF |  | 1個 | 17（1種 10個 110） | 5本以上で注文。L3 を 38〜39MHz に同調。同調・フィルタ用。温度特性の表示がないので、気になる場合は秋月の C0G 品（bom_purchase.csv）を使う
コンデンサ（セラミック） | C11,C13,C14,C27,C28,C30,C35,C36,C41-C43,C49,C53,C64,C109 | 積層セラミックコンデンサ 0.1µF 50V 2.54mm | 0.1u | C_Disc_D5.0mm_W2.5mm_P2.50mm | 15 | サトー電気 | 積層セラミックコンデンサ 50V 0.1µF（ムラタ） |  | 1個 | 22（50個 770） | 足の間隔 2.54mm を指定して注文（指定しないと 5.08mm が届く）
コンデンサ（セラミック） | C16,C84,C86,C90 | セラミックコンデンサ 15pF 50V | 15p | C_Disc_D3.0mm_W1.6mm_P2.50mm | 4 | サトー電気 | セラミックコンデンサ ディスク型 50V 15pF |  | 1個 | 17（1種 10個 110） | 5本以上で注文。同調・フィルタ用。温度特性の表示がないので、気になる場合は秋月の C0G 品（bom_purchase.csv）を使う
コンデンサ（セラミック） | C17,C21 | セラミックコンデンサ 82pF 50V | 82p | C_Disc_D3.0mm_W1.6mm_P2.50mm | 2 | サトー電気 | セラミックコンデンサ ディスク型 50V 82pF |  | 1個 | 17（1種 10個 110） | 5本以上で注文。ラダーフィルタ。値は水晶の運動定数を測ってから決める。同調・フィルタ用。温度特性の表示がないので、気になる場合は秋月の C0G 品（bom_purchase.csv）を使う
コンデンサ（セラミック） | C18,C20 | セラミックコンデンサ 100pF 50V | 100p | C_Disc_D3.0mm_W1.6mm_P2.50mm | 2 | サトー電気 | セラミックコンデンサ ディスク型 50V 100pF |  | 1個 | 17（1種 10個 110） | 5本以上で注文。ラダーフィルタ。値は水晶の運動定数を測ってから決める。同調・フィルタ用。温度特性の表示がないので、気になる場合は秋月の C0G 品（bom_purchase.csv）を使う
コンデンサ（セラミック） | C19 | セラミックコンデンサ 120pF 50V | 120p | C_Disc_D3.0mm_W1.6mm_P2.50mm | 1 | サトー電気 | セラミックコンデンサ ディスク型 50V 120pF |  | 1個 | 17（1種 10個 110） | 5本以上で注文。ラダーフィルタ。値は水晶の運動定数を測ってから決める。同調・フィルタ用。温度特性の表示がないので、気になる場合は秋月の C0G 品（bom_purchase.csv）を使う
コンデンサ（セラミック） | C24,C31 | セラミックコンデンサ 33pF 50V | 33p | C_Disc_D3.0mm_W1.6mm_P2.50mm | 2 | サトー電気 | セラミックコンデンサ ディスク型 50V 33pF |  | 1個 | 17（1種 10個 110） | 5本以上で注文。C24 は Q2 のドレイン同調、C31 は S メーター増幅の同調。同調・フィルタ用。温度特性の表示がないので、気になる場合は秋月の C0G 品（bom_purchase.csv）を使う
コンデンサ（セラミック） | C37,C39,C40,C44-C46,C104 | 積層セラミックコンデンサ 1µF 50V | 1u | C_Disc_D5.0mm_W2.5mm_P2.50mm | 7 | サトー電気 | 積層セラミックコンデンサ 50V 1.0µF |  | 1個 | 77（1種 10個 660）
コンデンサ（セラミック） | C38 | セラミックコンデンサ 0.047µF 100V | 0.047u | C_Disc_D5.0mm_W2.5mm_P2.50mm | 1 | サトー電気 | セラミックコンデンサ ディスク型 0.047µF（100V） |  | 1個 | 22（10個 176） | AF 前置増幅の後の高域カット
コンデンサ（セラミック） | C59 | セラミックコンデンサ 0.01µF 50V | 0.01u | C_Radial_D5.0mm_P2.00mm_CPpad | 1 | サトー電気 | セラミックコンデンサ ディスク型 50V 0.01µF（103） |  | 1個 | 17（1種 10個 110） | 5本以上で注文。2mm ピッチに足を合わせる
コンデンサ（セラミック） | C60 | マイラーフィルムコンデンサ 0.068µF 50V | 0.068u | C_Radial_D5.0mm_P2.00mm_CPpad | 1 | サトー電気 | マイラーフィルムコンデンサ 50V 0.068µF |  | 1個 | 28（1種 10個 220） | マイク LPF。2mm ピッチに足を合わせる
コンデンサ（セラミック） | C66-C69 | マイラーフィルムコンデンサ 3300pF 50V | 3300p | C_Disc_D5.0mm_W2.5mm_P2.50mm | 4 | サトー電気 | マイラーフィルムコンデンサ 50V 0.0033µF |  | 1個 | 17（1種 10個 143） | PDM 出力の RC（C66〜C69）。I・Q で値がそろうよう同じ袋のものを使う。足を 2.5mm に寄せる
コンデンサ（セラミック） | C76-C79 | セラミックコンデンサ 47pF 50V | 47PF | C_Disc_D5.0mm_W2.5mm_P2.50mm | 4 | サトー電気 | セラミックコンデンサ ディスク型 50V 47pF |  | 1個 | 17（1種 10個 110） | 5本以上で注文。同調・フィルタ用。温度特性の表示がないので、気になる場合は秋月の C0G 品（bom_purchase.csv）を使う
コンデンサ（セラミック） | C80,C81 | セラミックコンデンサ 1000pF 50V | 0.001u | C_Disc_D5.0mm_W2.5mm_P2.50mm | 2 | サトー電気 | セラミックコンデンサ ディスク型 50V 0.001µF（102） |  | 1個 | 17（1種 10個 110） | 5本以上で注文
コンデンサ（セラミック） | C92 | セラミックコンデンサ 150pF 50V | 150pF | C_Disc_D5.0mm_W2.5mm_P5.00mm | 1 | サトー電気 | セラミックコンデンサ ディスク型 50V 150pF |  | 1個 | 17（1種 10個 110） | 5本以上で注文。同調・フィルタ用。温度特性の表示がないので、気になる場合は秋月の C0G 品（bom_purchase.csv）を使う
コンデンサ（セラミック） | C93 | セラミックコンデンサ 33pF 50V | 33pF | C_Disc_D5.0mm_W2.5mm_P5.00mm | 1 | サトー電気 | セラミックコンデンサ ディスク型 50V 33pF |  | 1個 | 17（1種 10個 110） | 5本以上で注文。同調・フィルタ用。温度特性の表示がないので、気になる場合は秋月の C0G 品（bom_purchase.csv）を使う
コンデンサ（セラミック） | C94 | セラミックコンデンサ 1000pF 50V | 0.001u | C_Disc_D5.0mm_W2.5mm_P5.00mm | 1 | サトー電気 | セラミックコンデンサ ディスク型 50V 0.001µF（102） |  | 1個 | 17（1種 10個 110） | 5本以上で注文
コンデンサ（セラミック） | C95,C97 | 積層セラミックコンデンサ 0.1µF 250V X7R 5mm | 0.1uF | C_Disc_D5.0mm_W2.5mm_P5.00mm | 2 | 秋月電子 | RDER72E104K2K1H03B | 110147 | 1個 | 25
コンデンサ（セラミック） | C98 | セラミックコンデンサ 39pF 50V | 39p | C_Disc_D5.0mm_W2.5mm_P5.00mm | 1 | サトー電気 | セラミックコンデンサ ディスク型 50V 39pF |  | 1個 | 17（1種 10個 110） | 5本以上で注文。同調・フィルタ用。温度特性の表示がないので、気になる場合は秋月の C0G 品（bom_purchase.csv）を使う
コンデンサ（セラミック） | C99 | セラミックコンデンサ 82pF 50V | 82p | C_Disc_D5.0mm_W2.5mm_P5.00mm | 1 | サトー電気 | セラミックコンデンサ ディスク型 50V 82pF |  | 1個 | 17（1種 10個 110） | 5本以上で注文。同調・フィルタ用。温度特性の表示がないので、気になる場合は秋月の C0G 品（bom_purchase.csv）を使う
コンデンサ（セラミック） | C101 | セラミックコンデンサ 100pF 50V | 100p | C_Disc_D5.0mm_W2.5mm_P5.00mm | 1 | サトー電気 | セラミックコンデンサ ディスク型 50V 100pF |  | 1個 | 17（1種 10個 110） | 5本以上で注文。同調・フィルタ用。温度特性の表示がないので、気になる場合は秋月の C0G 品（bom_purchase.csv）を使う
コンデンサ（セラミック） | C102 | セラミックコンデンサ 68pF 50V | 68p | C_Disc_D5.0mm_W2.5mm_P5.00mm | 1 | サトー電気 | セラミックコンデンサ ディスク型 50V 68pF |  | 1個 | 17（1種 10個 110） | 5本以上で注文。同調・フィルタ用。温度特性の表示がないので、気になる場合は秋月の C0G 品（bom_purchase.csv）を使う
コンデンサ（電解） | C47,C48,C96 | 電解コンデンサ 100µF 25V | 100u | CP_Radial_D6.3mm_P2.50mm | 3 | サトー電気 | 電解コンデンサ 東信 UTES 25V 100µF |  | 1個 | 25 | 中止品・在庫限り。直径が φ6.3 以下か確かめる
コンデンサ（電解） | C50,C55,C58,C61,C63,C105-C108 | 電解コンデンサ 10µF 50V | 10u | CP_Radial_D5.0mm_P2.00mm | 9 | サトー電気 | 電解コンデンサ 東信 UTES 50V 10µF |  | 1個 | 22 | 中止品・在庫限り。直径が φ5 以下か確かめる
コンデンサ（電解） | C56 | 電解コンデンサ 47µF 35V | 47u | CP_Radial_D5.0mm_P2.00mm | 1 | サトー電気 | 電解コンデンサ 東信 UTES 35V 47µF |  | 1個 | 22 | 中止品・在庫少。直径が φ5 以下か確かめる
コンデンサ（電解） | C57,C62,C65,C70-C73 | 電解コンデンサ 1µF 50V | 1u | CP_Radial_D5.0mm_P2.00mm | 7 | サトー電気 | 電解コンデンサ 東信 UTES 50V 1µF |  | 1個 | 21 | 中止品・在庫限り
トリマコンデンサ | TC1-TC3 | セラミックトリマコンデンサ 30pF | 30p | C_Trimmer_TMCV01 | 3 | サトー電気 | セラミックトリマ 5mmφ 2本足 30pF（オレンジ） |  | 1個 | 88 | 足の間隔を基板（TMCV01 用）と照合してから付ける
トリマコンデンサ | TC4 | セラミックトリマコンデンサ 10pF | 10p | C_Trimmer_TMCV01 | 1 | サトー電気 | セラミックトリマ 4mmφ 2本足 10pF（無塗装） |  | 1個 | 110 | 足の間隔を基板（TMCV01 用）と照合してから付ける
コイル | L1 | トロイダルコア T-30-6（黄、0.4mm ポリウレタン線 11 回、2 回目にタップ） | T30-6 11T/2T | L_T30_3pin_Vertical | 1 | 秋月電子 | T-30-6 | 116458 | 1個 | 210 | Amidon。L18 と同じコア。線は別途
コイル | L2 | トロイダルコア T-30-6（黄、0.4mm ポリウレタン線 11 回、3 回目にタップ） | T30-6 11T/3T | L_T30_3pin_Vertical | 1 | 秋月電子 | T-30-6 | 116458 | 1個 | 210 | Amidon。L1 と同じコア（タップの位置だけ違う）。線は別途
コイル | L3,L12-L14 | FCZ コイル 7mm角 50MHz | 7T50 | L_FCZ07S_CT | 4 | サトー電気 | FCZ 7mm角 50MHz コイル 7T50Y（黄） |  | 1個 | 270 | 中国製・台湾の磁棒（Q が少し高い品）。センタータップの有無とピン配置を基板と照合する
コイル | L4 | リード型チョークコイル 8.2µH | 8.2uH | L_AL0510-153K_Vertical | 1 | サトー電気 | 太陽誘電 LAL03NA 8.2µH（2.6φ×7L） |  | 1本 | 55 | 横浜店扱い
コイル | L5,L6 | リード型コイル 4.7µH | 4.7uH | L_AL0510-153K_Vertical | 2 | サトー電気 | リード型コイル LGA0510 4.7µH（5.0φ×10.5L） |  | 1種 5個 | 66
コイル | L7 | マイクロインダクタ 15mH | 15mH | L_AL0510-153K_Vertical | 1 | 秋月電子 | AL0510-153K | 111407 | 10本 | 110
コイル | L8,L9 | リード型コイル 0.1µH | 100nH | L_AL0510-153K_Vertical | 2 | サトー電気 | リード型コイル LGA0307 0.1µH（2.8φ×7.0L） |  | 1種 5個 | 55 | 小型品は誤差 10〜15%。L8 と L9 は軸を 90° ずらして付け、2 個の値をそろえる
コイル | L10,L11 | リード型コイル 1mH | 1mH | L_AL0510-153K_Vertical | 2 | サトー電気 | リード型コイル LGA0510 1.0mH（5.0φ×10.5L） |  | 1種 5個 | 66
コイル | L15 | アキシャルインダクタ 270nH | 270nH | L_Axial_L9.5mm_D4.0mm_P2.54mm_Vertical_Fastron_SMCC | 1 | DigiKey／Mouser（要確認） | Fastron SMCC-R27K-02（0.27µH ±10%、Q 45、0.11Ω、1.4A） |  |  |  | 秋月に扱いなし
コイル | L16 | トロイダルコア T-50-10（0.6mm ポリウレタン線を巻く） | T-50-10 9T/0.6mm | L_T50_2pin_Vertical | 1 | サトー電気 | カーボニル鉄トロイダルコア T50-10（黒） |  | 1個 | 203 | 線は別途
コイル | L17 | トロイダルコア T-50-10（0.6mm ポリウレタン線を巻く） | T-50-10 10T/0.6mm | L_T50_2pin_Vertical | 1 | サトー電気 | カーボニル鉄トロイダルコア T50-10（黒） |  | 1個 | 203 | 線は別途
コイル | L18 | トロイダルコア T-30-6（黄、0.4mm ポリウレタン線を巻く） | T-30-6 8T/0.4mm | L_T30_2pin_Vertical | 1 | 秋月電子 | T-30-6 | 116458 | 1個 | 210 | Amidon。線は別途
コイル | L19 | トロイダルコア T-50-10（0.6mm ポリウレタン線を巻く） | T-50-10 8T/0.6mm | L_T50_2pin_Vertical | 1 | サトー電気 | カーボニル鉄トロイダルコア T50-10（黒） |  | 1個 | 203 | 線は別途
コイル | L20 | リード型コイル 10µH | 10uH | L_AL0510-153K_Vertical | 1 | サトー電気 | リード型コイル LGA0307 10µH（2.8φ×7.0L） |  | 1種 5個 | 55
コイル | RFC1 | カーボン抵抗 1/4W | 10uH | L_Axial_L14.0mm_D4.5mm_P15.24mm_Horizontal_Fastron_LACC | 1 | サトー電気 | カーボン抵抗 1/4W S1 10uHΩ |  | 1本 | 20（10本以上は単価 13、1種 100本 660）
ダイオード | D1 | 整流ダイオード 1A | 1N4001 | D_DO-41_SOD81_P10.16mm_Horizontal | 1 | サトー電気 | 1N4007 |  | 1本 | 17（20本 99） | 1N4001 の代わりに 1N4007
ダイオード | D2,D3 | 小信号ダイオード | 1N4148 | D_DO-35_SOD27_P2.54mm_Vertical_CathodeUp | 2 | サトー電気 | 1N4148（中国 SEMCOM、品質の高いほう） |  | 1本 | 22 | 受信入力の保護
ダイオード | D4-D9 | ゲルマニウムダイオード | 1N60 | D_DO-35_SOD27_P2.54mm_Vertical_CathodeUp | 6 | サトー電気 | 1N60 ゲルマ（赤 1 本帯） |  | 1本 | 66（10本 550）
ダイオード | D10 | ショットキーダイオード 40V 1A | 1N5819 | D_DO-41_SOD81_P5.08mm_Vertical_AnodeUp | 1 | 秋月電子 | 1N5819 | 117244 | 10本 | 100
トランジスタ・FET | Q1 | PNP トランジスタ | 2SA1015 | TO-92_Inline | 1 | サトー電気 | 2SA1015-GR（東芝） |  | 1個 | 22（10個 187）
トランジスタ・FET | Q2,Q3,Q6,Q7 | N-ch JFET（TO-92 小型） | 2SK192A | TO-92_Inline | 4 | 秋月電子／サトー電気 など（要確認） | 2SK192A-BL（東芝） |  |  |  | Q2・Q3（RF 増幅）と Q6・Q7（IF 増幅）のカスコード。BL ランク（IDSS 12〜24mA）を 4 個そろえる（上段・下段の組で IDSS が近いもの）。ソース抵抗 R3・R18 は 100Ω。ピン 1 D・2 S・3 G（データシートで確認済み）。製造中止品の流通在庫
トランジスタ・FET | Q4,Q17 | RF 用 N-ch FET | 2SK439 | TO-92_Inline | 2 | サトー電気 | 2SK439-E |  | 1個 | 396 | テーピング品（足を広げてある）2SK439-F なら 165 円。残少・横浜店扱いの品あり
トランジスタ・FET | Q5,Q8-Q11,Q14-Q16,Q18,Q20-Q22 | NPN トランジスタ | 2SC1815 | TO-92_Inline | 12 | サトー電気 | 2SC1815-GR（東芝オリジナル） |  | 1個 | 22（10個 176）
トランジスタ・FET | Q12 | PNP トランジスタ | 2SA950 | TO-92_Inline | 1 | サトー電気 | 2SA950 |  | 1個 | 55（10個 440）
トランジスタ・FET | Q13 | NPN トランジスタ | 2SC2120 | TO-92_Inline | 1 | サトー電気 | 2SC2120 |  | 1個 | 28（10個 220）
トランジスタ・FET | Q19 | RF パワー MOSFET | RD06HVF1 | TO-220-3_Vertical | 1 | サトー電気 | RD06HVF1（三菱） |  | 1個 | 660
水晶振動子 | Y1-Y6 | 水晶振動子 12MHz HC-49/US | 12MHz | Crystal_HC49-U_Vertical | 6 | サトー電気 | 水晶 12MHz HC49US |  | 1個 | 35（5個 145） | ラダーフィルタ用に同じロットを 10〜20 個買い、直列共振が ±50Hz 以内の 6 個を選ぶ
IC・レギュレータ・モジュール | U1,U2 | ダブルバランスドミキサ IC（SSOP8） | NJM2594V | TSSOP-8_4.4x3mm_P0.65mm | 2 | 秋月電子 | NJM2594V | 111195 | 1個 | 150 | 第 1 混合と積検波で 2 個。表面実装
IC・レギュレータ・モジュール | U3 | 対数増幅器（S メーター） | AD8307ANZ | DIP-8_W7.62mm | 1 | 秋月電子 | AD8307ANZ | 100195 | 1個 | 2000 | DIP-8
IC・レギュレータ・モジュール | U4 | 5V 3 端子レギュレータ | 78L05 | TO-92_Inline | 1 | サトー電気 | TA78L05S |  | 1個 | 55（10個 440） | 受信用 5V。78L05 と同じピン配置（TO-92）
IC・レギュレータ・モジュール | U5 | デュアルオペアンプ | NJM2904 | DIP-8_W7.62mm | 1 | サトー電気 | NJM2904D |  | 1個 | 44（10個 330）
IC・レギュレータ・モジュール | U6 | Si5351A クロックジェネレータモジュール | Si5351_DIP8 | DIP-8_W7.62mm | 1 | 秋月電子 | AE-Si5351A-B | 110679 | 1セット | 650 | ピン配置を基板と照合してから取り付ける
IC・レギュレータ・モジュール | U8 | DC-DC コンバータ 5V 1A（78xx 互換） | R-78E5.0-1.0 | DCDC_RECOM_R-78E_78Lxx-pinmap | 1 | DigiKey／Mouser | R-78E5.0-1.0 |  |  |  | 秋月は 0.5A 品 R-78E5.0-0.5（106353）のみ
IC・レギュレータ・モジュール | U9 | 3.3V LDO レギュレータ | LP2950-3.3_TO92 | TO-92_Inline | 1 | 秋月電子 | LP2950L-33-T92 | 108749 | 1個 | 30
マイコンモジュール | U7 | Seeed Studio XIAO ESP32C3 | Seeeduino_XIAO_Socket | Seeeduino_XIAO_Socket | 1 | 秋月電子 | 113991054 | 117454 | 1個 | 1080
トランス・リレー | K1 | リレー DPDT 12V（オムロン G5V-2） | G5V-2 DC12 | Relay_DPDT_Omron_G5V-2_D1.0mm | 1 | サトー電気 | G5V-2 DC12V |  | 1個 | 429
コネクタ | J1 | 同軸ケーブル（基板に直接はんだ付け） | RF_IN | SolderWire_1x02_P2.54mm_D1.1mm | 1 | （同軸ケーブル） | RG-174 など 50Ω |  |  |  | J1 はピンヘッダを使わず、穴 φ1.1mm に芯線と編組を直接はんだ付けする（編組の引き出しは短く）
コネクタ | J2 | 電源線（基板に直接はんだ付け） | PWR_IN | SolderWire_1x02_P5.08mm_D1.1mm | 1 | （電線） | AWG20（0.5sq） |  |  |  | J2 はピンヘッダを使わず、穴 φ1.1mm に電線を直接はんだ付けする（電流は送信時でも 1A 弱）
コネクタ | J3,J5 | ピンヘッダ | Volume | PinHeader_1x03_P2.54mm_Vertical | 2 | 秋月電子 | PH-1x40SG | 100167 | 1本(40P) | 35 | J3・J5〜J12 で 1 本
コネクタ | J4 | ADS1015 12 ビット I2C AD コンバータモジュール | AE-ADS1015 | AE-ADS1015_Vertical | 1 | 秋月電子 | AE-ADS1015 | 113838 | 1個 | 540 | 付属のピンヘッダで基板に立てて差す。差す前に裏の SDA・SCL のプルアップ用はんだジャンパを短絡する（I2C の線にほかのプルアップがない）
コネクタ | J6 | ピンヘッダ | SP-OUT | PinHeader_1x02_P2.54mm_Vertical | 1 | 秋月電子 | PH-1x40SG | 100167 | 1本(40P) | 35 | J3・J5〜J12 で 1 本
コネクタ | J7 | ピンヘッダ | MIC-IN | PinHeader_1x04_P2.54mm_Vertical | 1 | 秋月電子 | PH-1x40SG | 100167 | 1本(40P) | 35 | J3・J5〜J12 で 1 本
コネクタ | J8 | ピンヘッダ | I2C_OUT-LCD | PinHeader_1x03_P2.54mm_Vertical | 1 | 秋月電子 | PH-1x40SG | 100167 | 1本(40P) | 35 | J3・J5〜J12 で 1 本
コネクタ | J9 | ピンヘッダ | TX-ON-LED | PinHeader_1x02_P2.54mm_Vertical | 1 | 秋月電子 | PH-1x40SG | 100167 | 1本(40P) | 35 | J3・J5〜J12 で 1 本
コネクタ | J10 | ピンヘッダ | Encoder | PinHeader_1x04_P2.54mm_Vertical | 1 | 秋月電子 | PH-1x40SG | 100167 | 1本(40P) | 35 | J3・J5〜J12 で 1 本
コネクタ | J11 | ピンヘッダ | NX4832T035 | PinHeader_1x04_P2.54mm_Vertical | 1 | 秋月電子 | PH-1x40SG | 100167 | 1本(40P) | 35 | J3・J5〜J12 で 1 本
コネクタ | J12 | ピンヘッダ | POWER-LED | PinHeader_1x02_P2.54mm_Vertical | 1 | 秋月電子 | PH-1x40SG | 100167 | 1本(40P) | 35 | J3・J5〜J12 で 1 本
パネル部品（基板非搭載） | LED1 | 3mm LED 黄 | LED黄 | PinHeader_1x02_P2.54mm_Vertical | 1 | 秋月電子 | OSY5JA3Z74A | 111639 | 1個 | 20
回路図に載っていない部品 |  | 放熱器 17PB046（HS1） |  |  | 1 | 秋月電子 | 17PB046-01025 | 105050 | 1個 | 90
回路図に載っていない部品 |  | RF ゲイン用 可変抵抗 10kΩ B カーブ（回路図 VR1、DNP） |  |  | 1 | 秋月電子 | SH16K4B103L20KCCI | 118292 | 1個 | 80
回路図に載っていない部品 |  | AF ボリューム 10kΩ A カーブ（回路図 VR2、DNP） |  |  | 1 | 秋月電子 | SH16K4A103L20KCCI | 129553 | 1個 | 60
回路図に載っていない部品 |  | ロータリーエンコーダ（押しスイッチ付き） |  |  | 1 | 秋月電子 | EC12E2420801 | 106357 | 1個 | 100 | 押しスイッチ付きか要確認
回路図に載っていない部品 |  | LCD NX4832T035（Nextion、3.5インチ 480×320 シリアル HMI） |  |  | 1 | Nextion 公式ストア（AliExpress・Amazon など） | NX4832T035_011
回路図に載っていない部品 |  | マイクコネクタ 4P |  |  | 1 | 千石電商／マルツ など（要確認） | 4P 丸型マイクコネクタ（メス、パネル取付 φ16）
回路図に載っていない部品 |  | イヤホンジャック 3.5mm スイッチ付き（MJ-352W-C） |  |  | 1 | 秋月電子 | MJ-352W-C | 117359 | 1個 | 175 | M6 ナットでふたに固定。スイッチ付き
回路図に載っていない部品 |  | 電源スイッチ（φ13 穴）、3mm LED（高輝度） |  |  | 各 1 | 要確認 | φ13 穴に合うもの |  |  |  | LED は秋月 OSG5TA3Z74A（111635）、2.2kΩ は CF25J2K2B（125222）
回路図に載っていない部品 |  | DC ジャック（センタープラス）、ヒューズホルダ 5×20 ＋ 1A 速断、BNC |  |  | 2 ／ 1 ／ 1 | 秋月電子 | MJ-14 ／ MF-524M ／ B-014IF | 106342 ／ 107079 ／ 100093 | 2個／1個／1個 | 70／210／150 | DC ジャック／ヒューズホルダ／BNC。ヒューズは MF51NR 250V 1（107129、40 円）
回路図に載っていない部品 |  | IC ソケット DIP-8 |  |  | 3 | サトー電気 | IC ソケット 8P 一般品（板バネ） |  | 1個 | 20（10個 110）
回路図に載っていない部品 |  | M3 インサートナット |  |  | 24 | Amazon／モノタロウ
回路図に載っていない部品 |  | M3×8 ねじ |  |  | 4 | ホームセンター／モノタロウ
回路図に載っていない部品 |  | M3×10 ねじ |  |  | 8 | ホームセンター／モノタロウ
回路図に載っていない部品 |  | M3×10 皿ねじ |  |  | 4 | ホームセンター／モノタロウ
回路図に載っていない部品 |  | M3×6 ねじ |  |  | 8 | ホームセンター／モノタロウ
回路図に載っていない部品 |  | スピーカー 5cm 8Ω 0.5W |  |  | 1 | 秋月電子 | DXYD50N-22Z-8A-F | 116024 | 1個 | 250
回路図に載っていない部品 |  | M3×8 皿ねじ・M3 ナット |  |  | 各 4 | ホームセンター／モノタロウ
