kazushinjo/PSN_TRX_XIAO_ESP32C3-V2/kicad/production/PSN_TRX_BOM_JLCPCB.csv

Comment | Designator | Footprint | LCSC Part #
10p | C1 | C_Disc_D3.0mm_W1.6mm_P2.50mm
0.01u | C2,C3,C5,C6,C7,C9,C10,C12,C15,C22,C23,C25,C26,C29,C32,C33,C34,C51,C52,C54,C74,C75,C82,C83,C85,C87,C88,C89,C91,C110 | C_Disc_D5.0mm_W2.5mm_P2.50mm
5p | C4,C100,C103 | C_Disc_D3.0mm_W1.6mm_P2.50mm
27p | C8 | C_Disc_D3.0mm_W1.6mm_P2.50mm
0.1u | C11,C13,C14,C27,C28,C30,C35,C36,C41,C42,C43,C49,C53,C64,C109 | C_Disc_D5.0mm_W2.5mm_P2.50mm
15p | C16,C84,C86,C90 | C_Disc_D3.0mm_W1.6mm_P2.50mm
82p | C17,C21 | C_Disc_D3.0mm_W1.6mm_P2.50mm
100p | C18,C20 | C_Disc_D3.0mm_W1.6mm_P2.50mm
120p | C19 | C_Disc_D3.0mm_W1.6mm_P2.50mm
33p | C24,C31 | C_Disc_D3.0mm_W1.6mm_P2.50mm
1u | C37,C39,C40,C44,C45,C46,C104 | C_Disc_D5.0mm_W2.5mm_P2.50mm
0.047u | C38 | C_Disc_D5.0mm_W2.5mm_P2.50mm
100u | C47,C48,C96 | CP_Radial_D6.3mm_P2.50mm
10u | C50,C55,C58,C61,C63,C105,C106,C107,C108 | CP_Radial_D5.0mm_P2.00mm
47u | C56 | CP_Radial_D5.0mm_P2.00mm
1u | C57,C62,C65,C70,C71,C72,C73 | CP_Radial_D5.0mm_P2.00mm
0.01u | C59 | C_Radial_D5.0mm_P2.00mm_CPpad
0.068u | C60 | C_Radial_D5.0mm_P2.00mm_CPpad
3300p | C66,C67,C68,C69 | C_Disc_D5.0mm_W2.5mm_P2.50mm
47PF | C76,C77,C78,C79 | C_Disc_D5.0mm_W2.5mm_P2.50mm
0.001u | C80,C81 | C_Disc_D5.0mm_W2.5mm_P2.50mm
150pF | C92 | C_Disc_D5.0mm_W2.5mm_P5.00mm
33pF | C93 | C_Disc_D5.0mm_W2.5mm_P5.00mm
0.001u | C94 | C_Disc_D5.0mm_W2.5mm_P5.00mm
0.1uF | C95,C97 | C_Disc_D5.0mm_W2.5mm_P5.00mm
39p | C98 | C_Disc_D5.0mm_W2.5mm_P5.00mm
82p | C99 | C_Disc_D5.0mm_W2.5mm_P5.00mm
100p | C101 | C_Disc_D5.0mm_W2.5mm_P5.00mm
68p | C102 | C_Disc_D5.0mm_W2.5mm_P5.00mm
1N4001 | D1 | D_DO-41_SOD81_P10.16mm_Horizontal
1N4148 | D2,D3 | D_DO-35_SOD27_P2.54mm_Vertical_CathodeUp
1N60 | D4,D5,D6,D7,D8,D9 | D_DO-35_SOD27_P2.54mm_Vertical_CathodeUp
1N5819 | D10 | D_DO-41_SOD81_P5.08mm_Vertical_AnodeUp
RF_IN | J1 | SolderWire_1x02_P2.54mm_D1.1mm
PWR_IN | J2 | SolderWire_1x02_P5.08mm_D1.1mm
Volume | J3,J5 | PinHeader_1x03_P2.54mm_Vertical
AE-ADS1015 | J4 | AE-ADS1015_Vertical
SP-OUT | J6 | PinHeader_1x02_P2.54mm_Vertical
MIC-IN | J7 | PinHeader_1x04_P2.54mm_Vertical
I2C_OUT-LCD | J8 | PinHeader_1x03_P2.54mm_Vertical
TX-ON-LED | J9 | PinHeader_1x02_P2.54mm_Vertical
Encoder | J10 | PinHeader_1x04_P2.54mm_Vertical
NX4832T035 | J11 | PinHeader_1x04_P2.54mm_Vertical
POWER-LED | J12 | PinHeader_1x02_P2.54mm_Vertical
G5V-2 DC12 | K1 | Relay_DPDT_Omron_G5V-2_D1.0mm
T30-6 11T/2T | L1 | L_T30_3pin_Vertical
T30-6 11T/3T | L2 | L_T30_3pin_Vertical
7T50 | L3,L12,L13,L14 | L_FCZ07S_CT
8.2uH | L4 | L_AL0510-153K_Vertical
4.7uH | L5,L6 | L_AL0510-153K_Vertical
15mH | L7 | L_AL0510-153K_Vertical
100nH | L8,L9 | L_AL0510-153K_Vertical
1mH | L10,L11 | L_AL0510-153K_Vertical
270nH | L15 | L_Axial_L9.5mm_D4.0mm_P2.54mm_Vertical_Fastron_SMCC
T-50-10 9T/0.6mm | L16 | L_T50_2pin_Vertical
T-50-10 10T/0.6mm | L17 | L_T50_2pin_Vertical
T-30-6 8T/0.4mm | L18 | L_T30_2pin_Vertical
T-50-10 8T/0.6mm | L19 | L_T50_2pin_Vertical
10uH | L20 | L_AL0510-153K_Vertical
2SA1015 | Q1 | TO-92_Inline
2SK192A | Q2,Q3,Q6,Q7 | TO-92_Inline
2SK439 | Q4,Q17 | TO-92_Inline
2SC1815 | Q5,Q8,Q9,Q10,Q11,Q14,Q15,Q16,Q18,Q20,Q21,Q22 | TO-92_Inline
2SA950 | Q12 | TO-92_Inline
2SC2120 | Q13 | TO-92_Inline
RD06HVF1 | Q19 | TO-220-3_Vertical
4.7k | R1,R12,R23,R43,R61,R62,R67 | R_Axial_DIN0207_L6.3mm_D2.5mm_P2.54mm_Vertical
10k | R2,R39,R40,R75,R78,R79,R80 | R_Axial_DIN0207_L6.3mm_D2.5mm_P2.54mm_Vertical
100 | R3,R9,R18,R20,R68 | R_Axial_DIN0207_L6.3mm_D2.5mm_P2.54mm_Vertical
100k | R4,R6,R29,R32,R35,R44,R48,R49,R71,R73,R74 | R_Axial_DIN0207_L6.3mm_D2.5mm_P2.54mm_Vertical
2.2k | R5,R21 | R_Axial_DIN0207_L6.3mm_D2.5mm_P2.54mm_Vertical
51 | R7,R65 | R_Axial_DIN0207_L6.3mm_D2.5mm_P2.54mm_Vertical
470 | R8 | R_Axial_DIN0207_L6.3mm_D2.5mm_P2.54mm_Vertical
1k | R10,R27,R30,R31,R33,R36,R37,R42,R45,R50,R72 | R_Axial_DIN0207_L6.3mm_D2.5mm_P2.54mm_Vertical
27k | R11,R22 | R_Axial_DIN0207_L6.3mm_D2.5mm_P2.54mm_Vertical
1.5k | R13,R34 | R_Axial_DIN0207_L6.3mm_D2.5mm_P2.54mm_Vertical
33 | R14 | R_Axial_DIN0207_L6.3mm_D2.5mm_P2.54mm_Vertical
180 | R15 | R_Axial_DIN0207_L6.3mm_D2.5mm_P2.54mm_Vertical
330 | R16,R38,R46 | R_Axial_DIN0207_L6.3mm_D2.5mm_P2.54mm_Vertical
20k | R17,R51,R66 | R_Axial_DIN0207_L6.3mm_D2.5mm_P2.54mm_Vertical
1.2k | R19 | R_Axial_DIN0207_L6.3mm_D2.5mm_P2.54mm_Vertical
27 | R24 | R_Axial_DIN0207_L6.3mm_D2.5mm_P2.54mm_Vertical
220 | R25 | R_Axial_DIN0207_L6.3mm_D2.5mm_P2.54mm_Vertical
10 | R26 | R_Axial_DIN0207_L6.3mm_D2.5mm_P2.54mm_Vertical
8.2k | R28 | R_Axial_DIN0207_L6.3mm_D2.5mm_P2.54mm_Vertical
100 1W | R41 | R_Axial_DIN0207_L6.3mm_D2.5mm_P2.54mm_Vertical
620 | R47 | R_Axial_DIN0207_L6.3mm_D2.5mm_P2.54mm_Vertical
22k | R52 | R_Axial_DIN0207_L6.3mm_D2.5mm_P2.54mm_Vertical
3.3k | R53,R54,R55,R56 | R_Axial_DIN0207_L6.3mm_D2.5mm_P2.54mm_Vertical
1M | R57,R59 | R_Axial_DIN0207_L6.3mm_D2.5mm_P2.54mm_Vertical
22 | R58,R60 | R_Axial_DIN0207_L6.3mm_D2.5mm_P2.54mm_Vertical
47 | R63,R64 | R_Axial_DIN0207_L6.3mm_D2.5mm_P2.54mm_Vertical
10 | R69 | R_Axial_DIN0207_L6.3mm_D2.5mm_P5.08mm_Vertical
330 | R70 | R_Axial_DIN0207_L6.3mm_D2.5mm_P5.08mm_Vertical
47k | R76,R77 | R_Axial_DIN0207_L6.3mm_D2.5mm_P2.54mm_Vertical
10uH | RFC1 | L_Axial_L14.0mm_D4.5mm_P15.24mm_Horizontal_Fastron_LACC
30p | TC1,TC2,TC3 | C_Trimmer_TMCV01
10p | TC4 | C_Trimmer_TMCV01
NJM2594V | U1,U2 | TSSOP-8_4.4x3mm_P0.65mm
AD8307ANZ | U3 | DIP-8_W7.62mm
78L05 | U4 | TO-92_Inline
NJM2904 | U5 | DIP-8_W7.62mm
Si5351_DIP8 | U6 | DIP-8_W7.62mm
Seeeduino_XIAO_Socket | U7 | Seeeduino_XIAO_Socket
R-78E5.0-1.0 | U8 | DCDC_RECOM_R-78E_78Lxx-pinmap
LP2950-3.3_TO92 | U9 | TO-92_Inline
500 | VR3,VR4 | Potentiometer_TOCOS_GF063P_Vertical
1k | VR5,VR6 | Potentiometer_TOCOS_GF063P_Vertical
500 | VR7 | Potentiometer_Bourns_3266W_Vertical
12MHz | Y1,Y2,Y3,Y4,Y5,Y6 | Crystal_HC49-U_Vertical
