kazushinjo/PSN_TRX_XIAO_ESP32C3-V2/kicad/sim/results.txt

# PSN_TRX アナログ部シミュレーション 2026-11-11 06:06
## 直流動作点
Ic/Id [mA] (Vc/Vd [V]) Pd[mW]  hFE下限/上限 × 11/12/13.8V の範囲
Q7   2SK192A   Ic   7.40〜  7.43 mA  Vc 11.00〜13.80 V  Pd 最大   62.7 mW
Q6   2SK192A   Ic   7.40〜  7.43 mA  Vc  4.42〜 5.37 V  Pd 最大   34.4 mW
Q2   2SK192A   Ic   7.40〜  7.43 mA  Vc  4.42〜 5.37 V  Pd 最大   34.4 mW
Q3   2SK192A   Ic   7.40〜  7.43 mA  Vc 11.00〜13.80 V  Pd 最大   62.7 mW
Q9   2SC1815   Ic   6.93〜 10.51 mA  Vc  2.72〜 4.93 V  Pd 最大   43.5 mW
Q5   2SC1815   Ic   4.10〜  6.10 mA  Vc  4.57〜 5.04 V  Pd 最大   22.2 mW
Q8   2SC1815   Ic   3.61〜  5.33 mA  Vc 11.00〜13.80 V  Pd 最大   66.5 mW
Q18  2SC1815   Ic  11.80〜 17.61 mA  Vc 11.00〜13.80 V  Pd 最大  211.9 mW
Q10  2SC1815   Ic   6.93〜 10.51 mA  Vc  2.72〜 4.93 V  Pd 最大   43.5 mW
Q17  2SK439    Ic   6.63〜  6.74 mA  Vc 11.00〜13.80 V  Pd 最大   90.6 mW
Q4   2SK439    Ic   6.63〜  6.74 mA  Vc 11.00〜13.80 V  Pd 最大   90.6 mW
Q11  2SC1815   Ic   4.13〜  5.83 mA  Vc  6.41〜 8.52 V  Pd 最大   17.0 mW
Q13  2SC2120   Ic  36.62〜 68.25 mA  Vc  2.85〜 4.51 V  Pd 最大  237.1 mW
Q12  2SA950    Ic -68.25〜-36.62 mA  Vc  2.85〜 4.51 V  Pd 最大  237.1 mW
Q15  2SC1815   Ic   1.09〜  1.84 mA  Vc  4.18〜 7.22 V  Pd 最大   10.0 mW
Q16  2SC1815   Ic   1.09〜  1.84 mA  Vc  4.18〜 7.22 V  Pd 最大   10.0 mW
Q21  2SC1815   Ic   0.00〜  0.00 mA  Vc  3.67〜 4.60 V  Pd 最大    0.0 mW
Q14  2SC1815   Ic   5.66〜  8.30 mA  Vc  4.45〜 6.56 V  Pd 最大   30.1 mW
Q22  2SC1815   Ic   0.33〜  0.33 mA  Vc  0.02〜 0.02 V  Pd 最大    0.0 mW
R27W      0.136〜0.470
MIC       2.150〜2.150
U5A_out   2.500〜2.500
TX_SENSE  0.016〜0.019
Q2_G2     3.667〜4.600
Q21_B     0.000〜0.000
C104      0.000〜0.000
MIC 11 2.15 2.15
MIC 12 2.15 2.15
MIC 13.8 2.15 2.15
2SK192A-BL 個体差（12V、VGS(off) −1.2〜−3V・IDSS 12〜24mA）と、ソース抵抗 R3（RF 増幅 Q2）・R18（IF 増幅 Q6）:
  R3=R18= 47Ω: RF Id   6.8〜 14.8 mA（Q3 Vd 12.00〜12.00 V、Pd 最大 Q2 60・Q3 107 mW） | IF Id   6.8〜 14.8 mA（Q7 Vd 11.99〜12.00 V、Pd 最大 Q6 60・Q7 107 mW）
  R3=R18= 68Ω: RF Id   5.7〜 12.7 mA（Q3 Vd 12.00〜12.00 V、Pd 最大 Q2 51・Q3 90 mW） | IF Id   5.7〜 12.7 mA（Q7 Vd 11.99〜12.00 V、Pd 最大 Q6 51・Q7 90 mW）
  R3=R18=100Ω: RF Id   4.7〜 10.5 mA（Q3 Vd 12.00〜12.00 V、Pd 最大 Q2 42・Q3 73 mW） | IF Id   4.7〜 10.5 mA（Q7 Vd 11.99〜12.00 V、Pd 最大 Q6 42・Q7 73 mW）
  R3=R18=150Ω: RF Id   3.7〜  8.4 mA（Q3 Vd 12.00〜12.00 V、Pd 最大 Q2 34・Q3 56 mW） | IF Id   3.7〜  8.4 mA（Q7 Vd 12.00〜12.00 V、Pd 最大 Q6 34・Q7 56 mW）
定数: L10=0.001 L11=0.001 L5=4.7e-06 L6=4.7e-06 L7=0.015 Q10=2SC1815 Q11=2SC1815 Q12=2SA950 Q13=2SC2120 Q14=2SC1815 Q15=2SC1815 Q16=2SC1815 Q17=2SK439 Q18=2SC1815 Q2=2SK192A Q21=2SC1815 Q22=2SC1815 Q3=2SK192A Q4=2SK439 Q5=2SC1815 Q6=2SK192A Q7=2SK192A Q8=2SC1815 Q9=2SC1815 R11=27000.0 R12=4700.0 R13=1500.0 R14=33.0 R15=180.0 R16=330.0 R17=20000.0 R18=150.0 R22=27000.0 R23=4700.0 R24=27.0 R25=220.0 R28=8200.0 R29=100000.0 R3=150.0 R30=1000.0 R32=100000.0 R33=1000.0 R34=1500.0 R35=100000.0 R36=1000.0 R37=1000.0 R38=330.0 R39=10000.0 R4=100000.0 R40=10000.0 R41=100.0 R42=1000.0 R43=4700.0 R44=100000.0 R45=1000.0 R46=330.0 R47=620.0 R48=100000.0 R49=100000.0 R5=2200.0 R50=1000.0 R51=20000.0 R57=1000000.0 R58=22.0 R59=1000000.0 R6=100000.0 R60=22.0 R61=4700.0 R62=4700.0 R63=47.0 R64=47.0 R65=51.0 R66=20000.0 R67=4700.0 R68=100.0 R7=51.0 R73=100000.0 R74=100000.0 R75=10000.0 R76=47000.0 R77=47000.0 R78=10000.0 R79=10000.0 U5=NJM2904
## 送信 AF 系・受信 AF 系
マイク → U5A → AF_ADC（U7 の A2）の 1kHz 基準の振幅 [dB]、1 Pa（エレクトレット −42 dBV/Pa ≒ 3.6 µA）での電圧
  RL15  30Ω: 300Hz +0.0 500Hz +0.1 1000Hz +0.0 2000Hz -0.2 2700Hz -0.5 4000Hz -1.1 10000Hz -5.6 | 1 kHz・1 Pa で U5A 出力 337 mVrms、AF_ADC 234 mVrms
  RL15  90Ω: 300Hz +0.1 500Hz +0.1 1000Hz +0.0 2000Hz -0.3 2700Hz -0.5 4000Hz -1.2 10000Hz -5.8 | 1 kHz・1 Pa で U5A 出力 324 mVrms、AF_ADC 225 mVrms
U7 の PDM 出力 → 変調器入力（I=L10 側、Q=L11 側）の 1kHz 基準の振幅 [dB]、PDM・PWM の周波数での減衰
  負荷  200Ω: 300Hz -0.0 500Hz +0.0 1000Hz +0.0 2000Hz -0.2 2700Hz -0.4 4000Hz -0.8 10000Hz -3.8 | 78kHz -30.0 156kHz -56.7 | I/Q の差 位相 0.00° 振幅 0.00dB
  負荷 1000Ω: 300Hz +0.0 500Hz +0.0 1000Hz +0.0 2000Hz -0.2 2700Hz -0.4 4000Hz -0.9 10000Hz -4.6 | 78kHz -36.8 156kHz -55.3 | I/Q の差 位相 0.00° 振幅 0.00dB
  RC が I +3%・Q −3% ずれた場合（補正なし）: 位相差 最大 2.02° 振幅差 最大 0.27dB → 抑圧の上限 32.6dB
  同上、ファームウェアで遅延差 2.19µs・利得差 -0.22dB を補正した後: 抑圧 最悪 49.6dB
受信 AF 系: 積検波 U2 の出力（DET_EF）→ Q9（前置増幅）→ スピーカー（8Ω）の 1kHz 基準 [dB]、音量つまみ 10kΩ の位置別
  音量 0.2: 300Hz +0.6 1000Hz +0.0 2700Hz -2.0 4000Hz -3.2 10000Hz -11.8  (1kHz 利得 29.8 dB)
  音量 0.5: 300Hz +0.7 1000Hz +0.0 2700Hz -2.0 4000Hz -3.2 10000Hz -11.9  (1kHz 利得 33.3 dB)
  音量 0.9: 300Hz +0.3 1000Hz +0.0 2700Hz -2.0 4000Hz -3.1 10000Hz -11.8  (1kHz 利得 41.9 dB)
定数: C105=9.999999999999999e-06 C37=1e-06 C38=4.7e-08 C39=1e-06 C40=1e-06 C41=1e-07 C42=1e-07 C43=1e-07 C44=1e-06 C45=1e-06 C46=1e-06 C47=9.999999999999999e-05 C48=9.999999999999999e-05 C55=9.999999999999999e-06 C56=4.7e-05 C57=1e-06 C58=9.999999999999999e-06 C59=1e-08 C60=6.8e-08 C61=9.999999999999999e-06 C62=1e-06 C63=9.999999999999999e-06 C65=1e-06 C66=3.3990000000000004e-09 C67=3.3990000000000004e-09 C68=3.201e-09 C69=3.201e-09 C70=1e-06 C71=1e-06 C72=1e-06 C73=1e-06 C80=1e-09 C81=1e-09 C82=1e-08 C83=1e-08 L10=0.001 L11=0.001 L7=0.015 Q10=2SC1815 Q11=2SC1815 Q12=2SA950 Q13=2SC2120 Q14=2SC1815 Q15=2SC1815 Q16=2SC1815 Q9=2SC1815 R27=1000.0 R28=8200.0 R29=100000.0 R30=1000.0 R31=1000.0 R32=100000.0 R33=1000.0 R34=1500.0 R35=100000.0 R36=1000.0 R37=1000.0 R38=330.0 R39=10000.0 R40=10000.0 R41=100.0 R42=1000.0 R43=4700.0 R44=100000.0 R45=1000.0 R46=330.0 R47=620.0 R48=100000.0 R49=100000.0 R50=1000.0 R51=20000.0 R52=22000.0 R53=3399.0 R54=3399.0 R55=3201.0 R56=3201.0 R57=1000000.0 R58=22.0 R59=1000000.0 R60=22.0 R61=4700.0 R62=4700.0 R63=47.0 R64=47.0 R73=100000.0 R74=100000.0 U5=NJM2904
## PA 出力 LPF・PA 入力・RFC1・DC-DC 入力フィルタ・AGC
PA 出力 LPF（7 素子＋2 倍波トラップ、50Ω 源・50Ω 負荷、出力は整合時 0dB 基準）
  L19/L16/L17 のばらつき・Coss・トラップ L のばらつきごとに、TC4 を 2 倍波最小、TC3 を反射減衰量最大に合わせた結果
 L×   Coss | L18×  | TC4[pF] | TC3[pF] | 反射減衰量 | 挿入損失 | 2倍波 | 3倍波 | 4倍波 | TC4 未調整(6.5p)の2倍波
 0.93  18p | 0.93  |   6.50  |    14   |    26.0    |   0.43   |  -71.5 |  -75.3 |  -94.3 |  -71.5
 0.93  18p | 1.07  |   5.00  |    13   |    29.1    |   0.41   |  -70.5 |  -75.3 |  -94.3 |  -30.2
 0.93  25p | 0.93  |   6.50  |    16   |    34.8    |   0.42   |  -72.6 |  -76.4 |  -95.5 |  -72.6
 0.93  25p | 1.07  |   5.00  |    15   |    42.2    |   0.41   |  -71.6 |  -76.4 |  -95.4 |  -31.3
 1.00  18p | 0.93  |   6.50  |    11   |    27.2    |   0.46   |  -73.4 |  -77.1 |  -96.0 |  -73.4
 1.00  18p | 1.07  |   5.00  |    11   |    34.2    |   0.44   |  -72.5 |  -77.2 |  -96.1 |  -30.8
 1.00  25p | 0.93  |   6.50  |    13   |    42.4    |   0.45   |  -74.5 |  -78.2 |  -97.2 |  -74.5
 1.00  25p | 1.07  |   5.00  |    13   |    34.4    |   0.45   |  -73.6 |  -78.3 |  -97.2 |  -31.9
 1.07  18p | 0.93  |   6.50  |     8   |    21.7    |   0.53   |  -75.1 |  -78.6 |  -97.5 |  -75.1
 1.07  18p | 1.07  |   5.00  |     8   |    25.6    |   0.50   |  -74.2 |  -78.8 |  -97.6 |  -31.4
 1.07  25p | 0.93  |   6.50  |     9   |    27.2    |   0.51   |  -76.1 |  -79.7 |  -98.6 |  -76.1
 1.07  25p | 1.07  |   5.00  |     9   |    38.0    |   0.49   |  -75.2 |  -79.8 |  -98.7 |  -32.4
PA 入力: 50Ω 源から見た不整合損失（VR7 は Idq に合わせた位置を 0.3〜0.7 で振る）
  gm 0.3 S, VR7 0.3: Zin   38.4  -24.6j Ω  不整合損失  0.4 dB
  gm 0.3 S, VR7 0.7: Zin   59.1  -22.2j Ω  不整合損失  0.2 dB
  gm 1.0 S, VR7 0.3: Zin   41.2  +25.1j Ω  不整合損失  0.4 dB
  gm 1.0 S, VR7 0.7: Zin   59.5  +27.4j Ω  不整合損失  0.3 dB
  ゲート電圧の上限（VR7 最大）: 11V→6.63V, 12V→7.23V, 13.8V→8.31V
RFC1 10µH（自己共振 29MHz、分布容量 3.0pF）: 51MHz で -1531j Ω（1531Ω、容量性）
DC-DC 入力フィルタ L20/C106: R-78E の入力側から見たインピーダンス
  電源抵抗 0.05Ω・C106 ESR 0.3Ω: ピーク 2.62Ω @ 15.8kHz
  電源抵抗 0.1Ω・C106 ESR 0.1Ω: ピーク 4.06Ω @ 15.8kHz
  電源抵抗 0.2Ω・C106 ESR 0.5Ω: ピーク 1.54Ω @ 16.2kHz
  R-78E の負性入力抵抗（入力電力 1.5W、12V）: -96Ω
  R-78E の負性入力抵抗（入力電力 2.5W、12V）: -58Ω
AGC（Q21）: AGC_PWM の平均電圧（12 ビット PWM のデューティ）→ Q2_G2 [V]（J3 は 10kΩ・最大と仮定）
  hFE 200: 0.00V(0)→4.00 0.50V(621)→3.97 0.55V(683)→3.82 0.60V(745)→3.39 0.65V(807)→2.68 0.70V(869)→1.82 0.75V(931)→0.89 0.80V(993)→0.18 1.13V(1403)→0.09
  hFE 400: 0.00V(0)→4.00 0.50V(621)→3.97 0.55V(683)→3.80 0.60V(745)→3.17 0.65V(807)→1.94 0.70V(869)→0.35 0.75V(931)→0.14 0.80V(993)→0.12 1.13V(1403)→0.09
定数: C100=5e-12 C101=1e-10 C102=6.8e-11 C103=5e-12 C92=1.5e-10 C93=3.3e-11 C94=1e-09 C98=3.9e-11 C99=8.2e-11 L15=2.7e-07 L16=2.68677e-07 L17=3.3170000000000004e-07 L18=2.46528e-07 L19=2.1228800000000003e-07 L20=9.999999999999999e-06 Q21=2SC1815 R17=20000.0 R69=10.0 R70=330.0 R75=10000.0 R76=47000.0 TC3=9e-12 TC4=6.5e-12 VR7=500.0
## 過渡解析（大信号の歪み・飽和、PA の高調波、電源投入・送信開始）
受信 AF 系の最大出力（1 kHz、スピーカー 8Ω、音量 0.9、電源 12V）: 積検波 U2 の出力（DET_EF）の振幅を上げていったときの出力と歪み率
  入力    2 mVpk → 出力    3.82 mW  歪み率   0.7 %
  入力    5 mVpk → 出力   23.23 mW  歪み率   1.5 %
  入力   10 mVpk → 出力   75.84 mW  歪み率   4.2 %
  入力   20 mVpk → 出力  112.23 mW  歪み率  11.2 %
  入力   40 mVpk → 出力  104.95 mW  歪み率  22.8 %
  入力   80 mVpk → 出力  100.31 mW  歪み率  27.9 %
  入力  160 mVpk → 出力   96.87 mW  歪み率  37.0 %
  歪み率 1% 以下の最大出力: 3.8 mW
  歪み率 3% 以下の最大出力: 23.2 mW
  歪み率 10% 以下の最大出力: 75.8 mW
マイク入力の大きさと飽和（1 kHz、L7 直流抵抗 60Ω、音量つまみ 5kΩ、電源 12V）。U5A は NJM2904 の出力範囲 0.03〜3.6V で制限。U7 の ADC（減衰 12dB）は約 0〜2.5V、中点 1.65V
   0.3 Pa（ 83.5 dB SPL）: Q14 コレクタ  5.16〜 5.17 V | U5A 出力 2.36〜2.64 V 歪み   0.0 % | AF_ADC 1.55〜1.75 V 歪み   0.0 %
     1 Pa（ 94.0 dB SPL）: Q14 コレクタ  5.14〜 5.19 V | U5A 出力 2.03〜2.97 V 歪み   0.0 % | AF_ADC 1.33〜1.97 V 歪み   0.0 %
     2 Pa（100.0 dB SPL）: Q14 コレクタ  5.12〜 5.21 V | U5A 出力 1.57〜3.43 V 歪み   0.0 % | AF_ADC 1.00〜2.30 V 歪み   0.0 %
     3 Pa（103.5 dB SPL）: Q14 コレクタ  5.09〜 5.24 V | U5A 出力 1.10〜3.60 V 歪み  15.8 % | AF_ADC 0.68〜2.41 V 歪み  15.8 %
     5 Pa（108.0 dB SPL）: Q14 コレクタ  5.05〜 5.28 V | U5A 出力 0.16〜3.60 V 歪み  49.4 % | AF_ADC 0.02〜2.41 V 歪み  49.4 %
    10 Pa（114.0 dB SPL）: Q14 コレクタ  4.93〜 5.40 V | U5A 出力 0.04〜3.60 V 歪み  65.4 % | AF_ADC -0.06〜2.42 V 歪み  65.4 %
U7 の PDM 出力（平均値）の振幅と変調器入力の歪み（1 kHz、I 側 = Q15、電源 12V）。フルスケール ±1.65V、FIR の通過域利得 1、出力レベル（out）初期値 10 %
  FIR 入力のレベル: マイク 1 Pa・mic 0dB で約 −19 dBFS、試験トーン −12 dBFS（ALC で効き始めまで絞られる）、ALC の効き始め −20 dBFS（2026-10-28 から。それまでは −6 dBFS）
  負荷  200Ω: -30dBFS・10%(±5mV)→  16mVpk  0.4%  -23dBFS・10%(±12mV)→  35mVpk  1.0%  -20dBFS・10%(±16mV)→  49mVpk  1.4%  -19dBFS・10%(±19mV)→  55mVpk  1.5%  -12dBFS・10%(±41mV)→ 123mVpk  3.6%  -6dBFS・10%(±83mV)→ 234mVpk  8.5%
  負荷 1000Ω: -30dBFS・10%(±5mV)→  63mVpk  0.4%  -23dBFS・10%(±12mV)→ 141mVpk  0.8%  -20dBFS・10%(±16mV)→ 198mVpk  1.2%  -19dBFS・10%(±19mV)→ 223mVpk  1.3%  -12dBFS・10%(±41mV)→ 494mVpk  3.1%  -6dBFS・10%(±83mV)→ 947mVpk  7.2%
  （参考）PDM の振幅を大きくした場合
  負荷  200Ω: ±0.20V→  398mVpk 32.7%(Q15C 28.1%)  ±0.83V→  516mVpk 84.8%(Q15C 72.4%)  ±1.65V→  565mVpk 108.8%(Q15C 92.3%)
  負荷 1000Ω: ±0.20V→ 1665mVpk 29.7%(Q15C 29.4%)  ±0.83V→ 2176mVpk 81.4%(Q15C 80.7%)  ±1.65V→ 2148mVpk 99.9%(Q15C 99.0%)
PA 大信号（RD06HVF1 を 2 乗特性の簡易モデル Vth 3.0V で近似、ゲートを 50.5MHz の正弦波で直接駆動、LPF は L×1.00・Coss 18p・TC3 11p・TC4 6.5p、50Ω 負荷、電源 12V）
  Idq  | ゲート振幅 | 出力 [W] | 効率 | ドレイン最大 | ドレインの 2/3 倍波 [dBc] | 出力の 2/3/4 倍波 [dBc]
   50mA |   0.5 V    |   0.68  |  46% |    21.2 V   |       -11.8 /  -45.9       |   -65.4 / -116.1 / -113.6
   50mA |   1.0 V    |   1.61  |  70% |    26.1 V   |       -14.4 /  -20.7       |   -67.9 /  -95.1 / -116.0
   50mA |   1.5 V    |   1.95  |  74% |    27.5 V   |       -16.2 /  -17.2       |   -69.7 /  -91.9 / -118.7
   50mA |   2.5 V    |   2.24  |  77% |    28.7 V   |       -16.0 /  -16.0       |   -69.6 /  -90.7 / -125.9
  200mA |   0.5 V    |   1.61  |  55% |    25.3 V   |       -23.5 /  -24.8       |   -77.1 /  -99.2 / -136.2
  200mA |   1.0 V    |   2.16  |  71% |    28.2 V   |       -16.6 /  -17.6       |   -70.1 /  -92.3 / -132.7
  200mA |   1.5 V    |   2.32  |  74% |    29.0 V   |       -15.3 /  -16.6       |   -68.8 /  -91.3 / -126.6
  200mA |   2.5 V    |   2.46  |  76% |    29.6 V   |       -14.3 /  -16.1       |   -67.8 /  -90.9 / -122.3
電源投入（RX12V が 1ms で 0→12V）時のスピーカー（8Ω）のポップ音: 音量 0.5、電源 12V
  スピーカー端の最大 +0.33 V（5 ms）、瞬間電力 14 mW。0.1V 以下に戻るまで 19 ms
送信開始（リレーで TX12V が 0→12V、10µs）: 変調器入力の過渡（I 側）。U7 は同時に PDM の平均を 64ms かけて中点 1.65V へ上げる（I は AGC のデューティ 0.6V から、Q は 0V から）。入力は 0.45 秒無音にする（MUTE_N）
  負荷  200Ω I: 変調器入力の最大   +575 mV（  0.0 ms）、±10mV 以内になるまで   95 ms、Q15 コレクタ 5.25 V（定常）
  負荷  200Ω Q: 変調器入力の最大   +575 mV（  0.0 ms）、±10mV 以内になるまで   98 ms、Q16 コレクタ 5.25 V（定常）
  負荷 1000Ω I: 変調器入力の最大  +2077 mV（  0.1 ms）、±10mV 以内になるまで  112 ms、Q15 コレクタ 5.25 V（定常）
  負荷 1000Ω Q: 変調器入力の最大  +2077 mV（  0.1 ms）、±10mV 以内になるまで  115 ms、Q16 コレクタ 5.25 V（定常）
送信開始時のマイク系: AF_ADC（U7 の A2）の過渡（マイク無音、L7 60Ω。マイクは +5V から常時給電、Q14 と U5A の電源は TX12V と同時に入る）
  AF_ADC の最大のずれ -1.97 V（30 ms、-0.32 V）、±10mV 以内になるまで 295 ms、U5A 出力 0.04〜3.60 V
## 受信部（V2: 12MHz の SSB スーパー。BPF・ラダーフィルタ・利得）
### 受信の前段（L1・L2 T30-6 11T、コア Q 約 120、結合 k 0.9。Q2・Q3 2SK192A-BL カスコード、混合器の入力 600Ω と仮定）
  L2 のタップ 2T: TC1 11.00pF・TC2 18.25pF、電力利得 +19.9dB、雑音指数 0.88dB
  L2 のタップ 3T: TC1 11.00pF・TC2 18.50pF、電力利得 +22.6dB、雑音指数 0.88dB
→ タップ 3T（回路図どおり）で計算: TC1 11.00pF、TC2 18.50pF（トリマの範囲内）
  50.0MHz: -0.5 dB
  51.0MHz: -0.4 dB
  イメージ 26.5MHz（LO 38.5 − 12）: -48.3 dB
  27MHz 帯（CB・小電力）: -47.6 dB
  半 IF 44.5MHz（LO + 6）: -19.8 dB
  局発 38.5MHz の漏れ: -32.5 dB
  12MHz の素通り: -66.4 dB
  FM 放送 76MHz: -39.7 dB
  FM 放送 90MHz: -46.2 dB
  3LO − IF 103.5MHz: -50.5 dB
  −3dB 帯域: 49.18〜51.88MHz
  50.5MHz での Q2 のゲート電圧（整合時のアンテナ端 1 に対して）: 10.37 倍（+20.3 dB）
  AGC（Q3 のゲート 4.0V）: 前段の利得 +0.0 dB
  AGC（Q3 のゲート 2.0V）: 前段の利得 -0.2 dB
  AGC（Q3 のゲート 1.0V）: 前段の利得 -3.9 dB
  AGC（Q3 のゲート 0.0V）: 前段の利得 -15.7 dB
### 12MHz ラダーフィルタ（水晶の運動定数は仮定: Cm 15fF、Rs 25Ω、C0 4pF。入力・出力とも 330Ω（出力 R16、入力は L 整合））
  今の定数（82p/100p/120p/100p/82p、R16 330Ω）: 損失 6.1 dB、−3dB 幅 2220Hz、−6dB 幅 2560Hz、−60dB 幅 7710Hz、通過域のリップル 3.0 dB、中心 +1530Hz（12MHz から）
  終端 220Ω なら: 損失 5.7 dB、−3dB 幅 2240Hz、−6dB 幅 2610Hz、−60dB 幅 7360Hz、通過域のリップル 2.9 dB、中心 +1505Hz（12MHz から）
  終端 470Ω なら: 損失 6.8 dB、−3dB 幅 2120Hz、−6dB 幅 2510Hz、−60dB 幅 8020Hz、通過域のリップル 3.0 dB、中心 +1545Hz（12MHz から）
  Cm 10fF の水晶なら: 損失 6.1 dB、−3dB 幅 1470Hz、−6dB 幅 1700Hz、−60dB 幅 5140Hz、通過域のリップル 2.9 dB、中心 +1020Hz（12MHz から）
  Cm 20fF の水晶なら: 損失 6.1 dB、−3dB 幅 2960Hz、−6dB 幅 3410Hz、−60dB 幅 10290Hz、通過域のリップル 3.0 dB、中心 +2055Hz（12MHz から）
  水晶の直列共振が ±60Hz ばらついたとき: 損失 6.1 dB、−3dB 幅 2220Hz、−6dB 幅 2560Hz、−60dB 幅 7730Hz、通過域のリップル 2.9 dB、中心 +1530Hz（12MHz から）
### 利得（2SK192A-BL: Vp −2V・Idss 18mA、2SC1815: hFE 200 と仮定）
  RF 増幅（Q2・Q3 2SK192A-BL カスコード、ゲート → L2 のタップ → NJM2594 の入力 600Ω）: 電圧利得 +13.1 dB（50.5MHz）
    動作点: Q2 ソース 0.72V → ドレイン電流 約 7.2mA、Q2 の Vds 4.02V、Q3 の Vds 7.25V
  混合後増幅（Q5 ＋ L 整合 → 330Ω）: 電圧利得 +18.7 dB、電力利得 +23.6 dB（NJM2594 の出力 1kΩ 基準）
    動作点: エミッタ 1.01V（Ic 約 4.7mA）、コレクタ 4.92V
### IF 増幅（Q6・Q7 2SK192A-BL カスコード: Vp −2V・Idss 18mA）と S メーター増幅（Q8）。L5・L6 の Q 60、U2 の入力 600Ω、AD8307 の入力 1.1kΩ と仮定
  Q6 のゲート → U2 の入力: +14.0 dB（12MHz）。L5・C24 の同調 12.84MHz
  Q6 のゲート → AD8307 の入力: +23.0 dB（12MHz）。L6・C31 の同調 10.25MHz
    動作点（AGC なし・Q7 ゲート 4.0V）: Q6 ソース 0.72V（Id 約 7.2mA）、Q8 エミッタ 1.03V（Ic 約 4.2mA）
### レベル配分（AGC なし、NJM2594 の変換利得 0dB と仮定、S9 = −73dBm・50µV/50Ω）
  アンテナ端 → U2 の入力（= 積検波の出力）: +60.1 dB（BPF +20.3、RF +13.1、混合後 +18.7、水晶 -6.1、IF +14.0）
  S1（0.2µV）   : 積検波の出力    0.202 mVrms → スピーカー    0.0783 mW（音量 0.9）| AD8307 の入力  -51.9 dBm（範囲 −75〜+17）
  S5（3.2µV）   : 積検波の出力    3.231 mVrms → スピーカー   20.0376 mW（音量 0.9）| AD8307 の入力  -27.9 dBm（範囲 −75〜+17）
  S9（50µV）    : 積検波の出力   50.479 mVrms → スピーカー  113.0000 mW（音量 0.9）| AD8307 の入力   -4.0 dBm（範囲 −75〜+17）
  S9+20dB     : 積検波の出力  504.785 mVrms → スピーカー  113.0000 mW（音量 0.9）| AD8307 の入力  +16.0 dBm（範囲 −75〜+17）
  S9+40dB     : 積検波の出力 5047.852 mVrms → スピーカー  113.0000 mW（音量 0.9）| AD8307 の入力  +36.0 dBm（範囲 −75〜+17）
  ※ スピーカーの出力は出力段の最大（約 113mW）で頭打ちとした。段どうしの負荷を含めた値は full.py（アンテナ → スピーカー）を見る
## 回路全体（受信: アンテナ → スピーカー、送信: 局発・変調器 → アンテナ）
### 受信: アンテナからスピーカーまで（混合器の変換利得 0dB・BFO 11.9999 MHz（USB）・局発 38.5001 MHz・音量 0.9）
  希望の側帯波（USB）: S9 の信号の音声周波数ごとのスピーカー出力（8Ω）
   100Hz -17.3dB  200Hz -9.4dB  300Hz -5.6dB  400Hz -2.9dB  600Hz -0.4dB  1000Hz -0.4dB  1500Hz +0.0dB  2000Hz -3.0dB  2500Hz -3.0dB  2800Hz -5.3dB  3000Hz -10.4dB  3500Hz -31.0dB
   S9・1kHz でスピーカー 4335.25mW 相当（+15.4dBV、小信号の線形計算で出力段の飽和を含まない値）。いちばん大きいのは 1500Hz
   ※ 実際の出力は出力段の最大 約 113mW（tran.py、歪み 11%）で頭打ちになる → S9 では 113mW。帯域・選択度・イメージなどの比は線形の値のまま使える
   音声の −6dB 帯域: 300〜2830Hz
  選択度（希望信号 USB 1kHz と同じ大きさの妨害波を入れたときのスピーカー出力の比）
   逆側帯波（LSB 1kHz、受信周波数 −1kHz）: -33.1dB（音声 1000Hz）
   逆側帯波（LSB 2kHz）: -48.9dB（音声 2000Hz）
   隣接（+3.5kHz）: -30.6dB（音声 3500Hz）
   隣接（+5kHz）: -68.9dB（音声 5000Hz）
   隣接（−3kHz）: -60.6dB（音声 3000Hz）
   隣接（−5kHz）: -77.8dB（音声 5000Hz）
   隣接（+10kHz）: -140.6dB（音声 10000Hz）
   イメージ（26.4992MHz）: -48.3dB（前段の同調回路と RF 増幅の差。混合器の偶数次などは含まない）
   12MHz の素通り（前段で -66.4dB。NJM2594 の信号の漏れ −30dB と仮定すると合計 -96dB）
   半 IF（44.5MHz）: 前段で -19.8dB（混合器の 2 次ひずみの分はさらに低い）
  感度: 前段（入力同調＋Q2・Q3）の雑音指数 0.9dB、電力利得 +22.6dB。混合器の雑音指数を 10dB とすると 全体 1.0dB、最小検出信号（帯域 2.4kHz）-139dBm（0.02µV）≒ S0
  感度: 前段（入力同調＋Q2・Q3）の雑音指数 0.9dB、電力利得 +22.6dB。混合器の雑音指数を 15dB とすると 全体 1.4dB、最小検出信号（帯域 2.4kHz）-139dBm（0.03µV）≒ S0
### 送信: 局発・変調器から PA・LPF・50Ω まで（50.5MHz の過渡解析、音声は直流で与える準静的な計算）
  7T50（L14〜L12）は一次 0.5µH・二次リンク 2/7 巻・結合 0.85・Q 70 と仮定（実物の値で変わる）。PA は 2 乗特性の簡易モデル、Idq 100mA
  音声なし（VR5・VR6 は中点、ダイオードがそろっている）: キャリアの漏れ 0.822mW（-1dBm）
  VR5 0.50・VR6 0.53 に合わせると: キャリアの漏れ 0.0034mW（-25dBm）
  D4 の IS が 30% 大きいとき: キャリアの漏れ 1.600mW（2dBm）→ VR5 で打ち消す
  I 側だけに音声（直流）を入れたときの出力（50Ω）と 2 倍波
    音声   20mV: 出力  0.004W（  5.7dBm）、2 倍波 -67dBc
    音声   50mV: 出力  0.027W（ 14.4dBm）、2 倍波 -78dBc
    音声  100mV: 出力  0.114W（ 20.6dBm）、2 倍波 -90dBc
    音声  200mV: 出力  0.422W（ 26.3dBm）、2 倍波 -81dBc
    音声  400mV: 出力  1.282W（ 31.1dBm）、2 倍波 -74dBc
    音声  800mV: 出力  1.680W（ 32.3dBm）、2 倍波 -75dBc
  I と Q の出力の位相差 -93.2°・振幅差 -0.16dB（音声 100mV、VR3・VR4 は中点）→ RF 側だけで決まる逆側帯波の抑圧 31dB
  VR3 0.9・VR4 0.60 に合わせると: 位相差 -90.0°・振幅差 +0.74dB → 振幅を iqa で補正して抑圧 73dB（ファームウェアの iqd・iqa は音声側の遅延と利得の補正なので、RF 側の一定の位相ずれは VR3・VR4 で合わせる）
## ブロックごとの確認（blocks.py）
### 7T50 コイル（FCZ 07S50: 0.68µH、コアで 0.51〜0.80µH）の同調。浮遊容量は 3pF と仮定
  L3（C8 27p）: 38.5MHz に必要な L 0.570µH → 範囲内（コアの端まで +9%）。コアで合う範囲 32.5〜40.7MHz
  L12（C84 15p）: 50.5MHz に必要な L 0.552µH → 範囲内（コアの端まで +6%）。コアで合う範囲 41.9〜52.5MHz
  L13（C86 15p）: 50.5MHz に必要な L 0.552µH → 範囲内（コアの端まで +6%）。コアで合う範囲 41.9〜52.5MHz
  L14（C90 15p）: 50.5MHz に必要な L 0.552µH → 範囲内（コアの端まで +6%）。コアで合う範囲 41.9〜52.5MHz
### 第 1 局発バッファ（受信、CLK0 38.5MHz → C74 → L8・C76・C77 → VR3（中点）→ C5 → Q4 → L3 → R8・R9 → C10 → U1）
  Si5351 の出力は基本波 2.10Vpk・出力抵抗 30Ω、U1 のキャリア入力 1000Ω と仮定。L3 はコアで 38.5MHz に合わせる
  L3 を 0.562µH に合わせると同調 38.50MHz: Q4 のゲート 186mVrms → U1 のキャリア入力 354mVrms（51dBmV）
    動作点: Q4 ソース 0.34V（Id 約 6.7mA）、ドレイン 11.99V
    38.0MHz（受信 50.0／51.0MHz）: -1.8dB（38.5MHz 比）
    39.0MHz（受信 50.0／51.0MHz）: -1.6dB（38.5MHz 比）
### BFO（CLK2 12MHz → R19・R20 → C26 → U2 のキャリア入力）
  U2 のキャリア入力 102mVrms（基本波。矩形波の高調波はそのまま入る）
### IF 増幅（Q6・Q7 → L5・C24）と S メーター増幅（Q8 → L6・C31）の同調（L5・L6 は AL0410-4R7K、Q 60 と仮定）
  今の定数（C24 33p・C31 33p）: L5 の同調 12.84MHz → U2 の入力 +14.0dB、L6 の同調 10.25MHz → AD8307 の入力 +23.0dB（12MHz、Q6 のゲート基準）
    C24 を 39p にすると: 同調 11.80MHz、U2 の入力 +14.1dB
    C24 を 47p にすると: 同調 10.71MHz、U2 の入力 +13.5dB
    C24 を 56p にすると: 同調 9.74MHz、U2 の入力 +12.4dB
    C31 を 10p にすると: 同調 11.43MHz、AD8307 の入力 +22.8dB
    C31 を 15p にすると: 同調 11.28MHz、AD8307 の入力 +23.1dB
    C31 を 18p にすると: 同調 11.15MHz、AD8307 の入力 +23.2dB
    C31 を 22p にすると: 同調 10.96MHz、AD8307 の入力 +23.3dB
  IF 増幅の AGC（Q7 のゲート電圧 → U2 の入力、4.0V 基準）: 4.0V +0.0dB、2.0V -0.1dB、1.0V -3.7dB、0.5V -9.6dB、0.0V -15.5dB
  L5・L6 は ±10%（4.23〜5.17µH）で同調が約 ±5% 動く（12MHz で ±0.6MHz）。Q 60 の帯域は約 0.2MHz なので、ばらつきの大きいときは C の差し替えで合わせる（調整 5）
### 送信表示（アンテナ側 C102 の RF → C103 5p → D8・D9 の倍電圧検波 → R71 → Q20 → LED、J9）
  出力     0.1mW（ 0.10Vpk）: Q20 のベース 0.04V → LED 電流 約 0.0mA
  出力     0.3mW（ 0.17Vpk）: Q20 のベース 0.11V → LED 電流 約 0.0mA
  出力     1.0mW（ 0.32Vpk）: Q20 のベース 0.26V → LED 電流 約 0.0mA
  出力     3.0mW（ 0.55Vpk）: Q20 のベース 0.56V → LED 電流 約 0.0mA
  出力    10.0mW（ 1.00Vpk）: Q20 のベース 0.71V → LED 電流 約 9.8mA
  出力   100.0mW（ 3.16Vpk）: Q20 のベース 0.77V → LED 電流 約 9.9mA
  出力  1000.0mW（10.00Vpk）: Q20 のベース 0.97V → LED 電流 約 10.0mA
  出力  2000.0mW（14.14Vpk）: Q20 のベース 1.07V → LED 電流 約 10.0mA
### 送受切替（PTT → R1 → Q1（2SA1015）→ K1 のコイル、G5V-2 DC12 のコイル 12V・約 41.7mA と仮定）
  PTT を GND に落としたとき: Q1 のベース電流 約 2.32mA、コイル電流 41.7mA → 必要な hFE 18（2SA1015-GR は 200〜400 で十分に飽和）
  PTT を開放したとき: R2（10kΩ）でベースがエミッタと同電位 → Q1 はオフ。D1（1N4001）がコイルの逆起電力を吸収
