kazushinjo/PSN_TRX_XIAO_ESP32C3-V2/docs/PSN_TRX_部品実装図.pdf

# PSN_TRX_XIAO_ESP32C3-V2 部品実装図（部品面）

## 基板 134.1 × 129.7 mm / 4層 / リード部品＋表面実装 2 点（U1・U2 NJM2594V） V2 Ver 1.4 2026-11-11

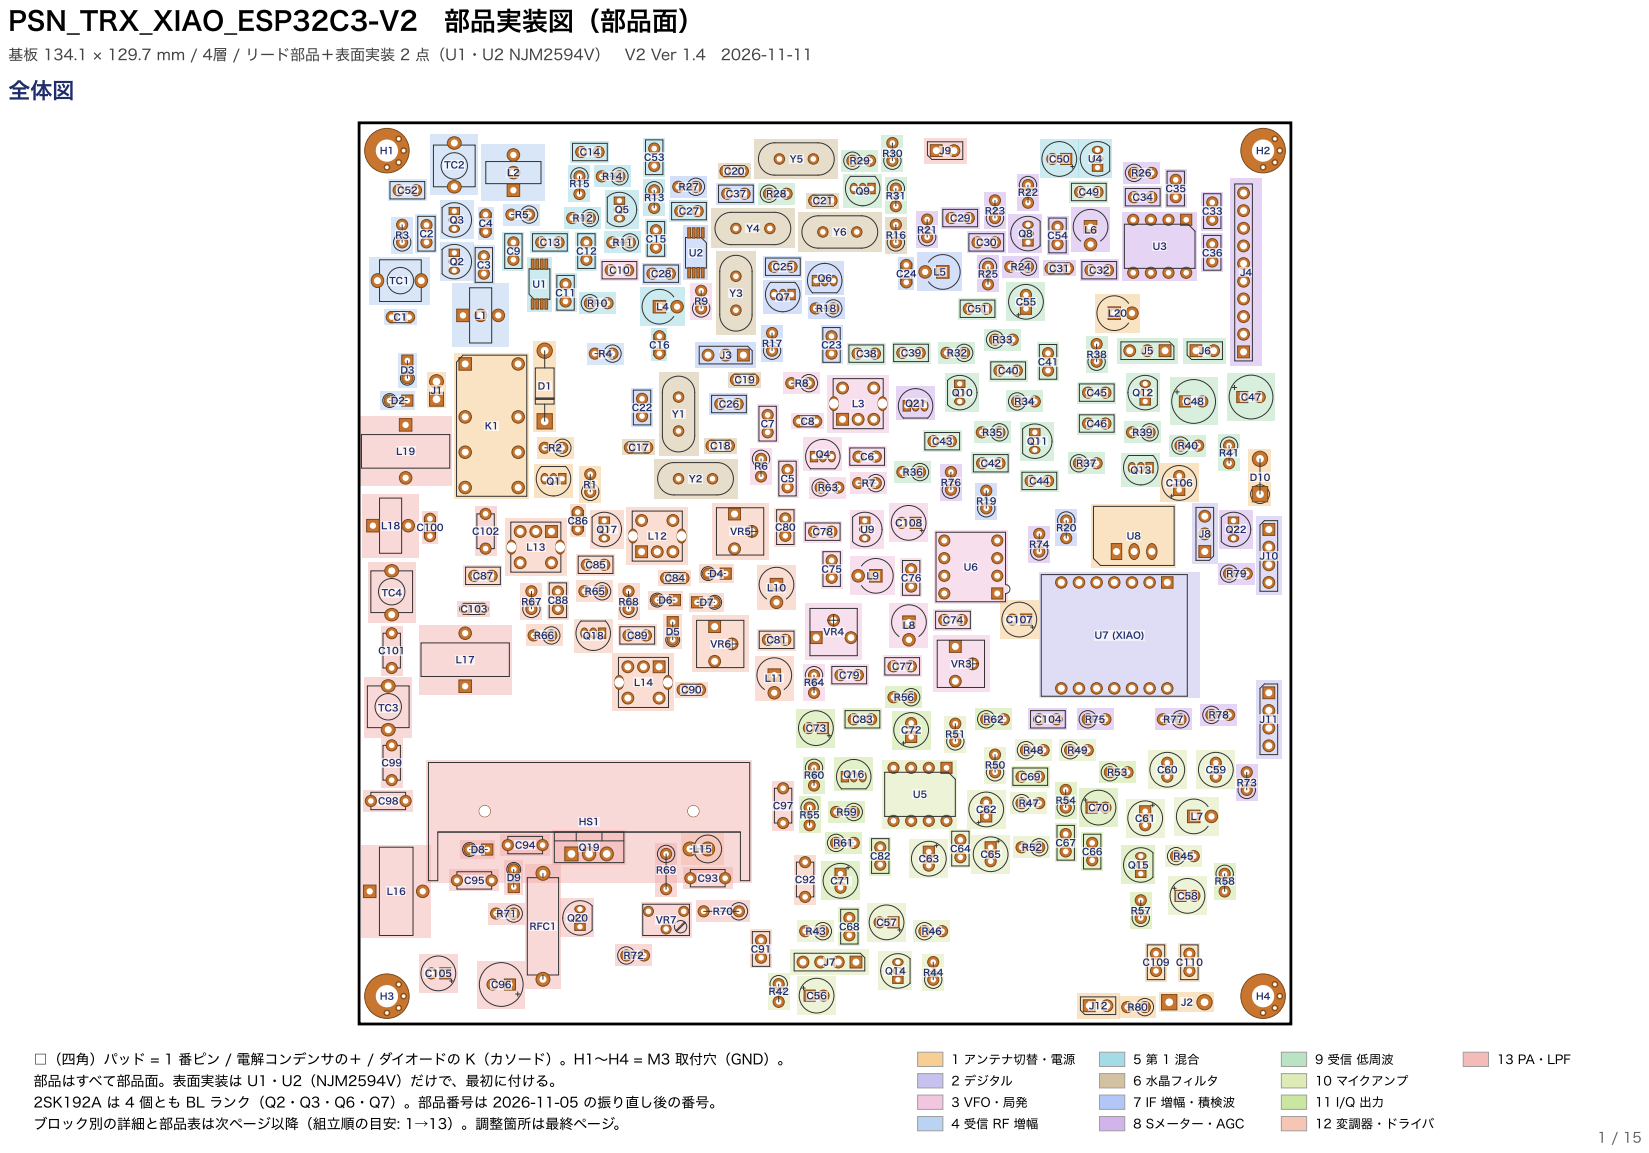
[picture p32: page 1]

□（四角）パッド = 1 番ピン / 電解コンデンサの＋ / ダイオードの K（カソード）。H1〜H4 = M3 取付穴（GND）。
部品はすべて部品面。表面実装は U1・U2（NJM2594V）だけで、最初に付ける。
2SK192A は 4 個とも BL ランク（Q2・Q3・Q6・Q7）。部品番号は 2026-11-05 の振り直し後の番号。
ブロック別の詳細と部品表は次ページ以降（組立順の目安: 1→13）。調整箇所は最終ページ。

部品番号 | 値/型番 | 種類 | 注意
D1 | 1N4001 | ダイオード | 極性: □が K

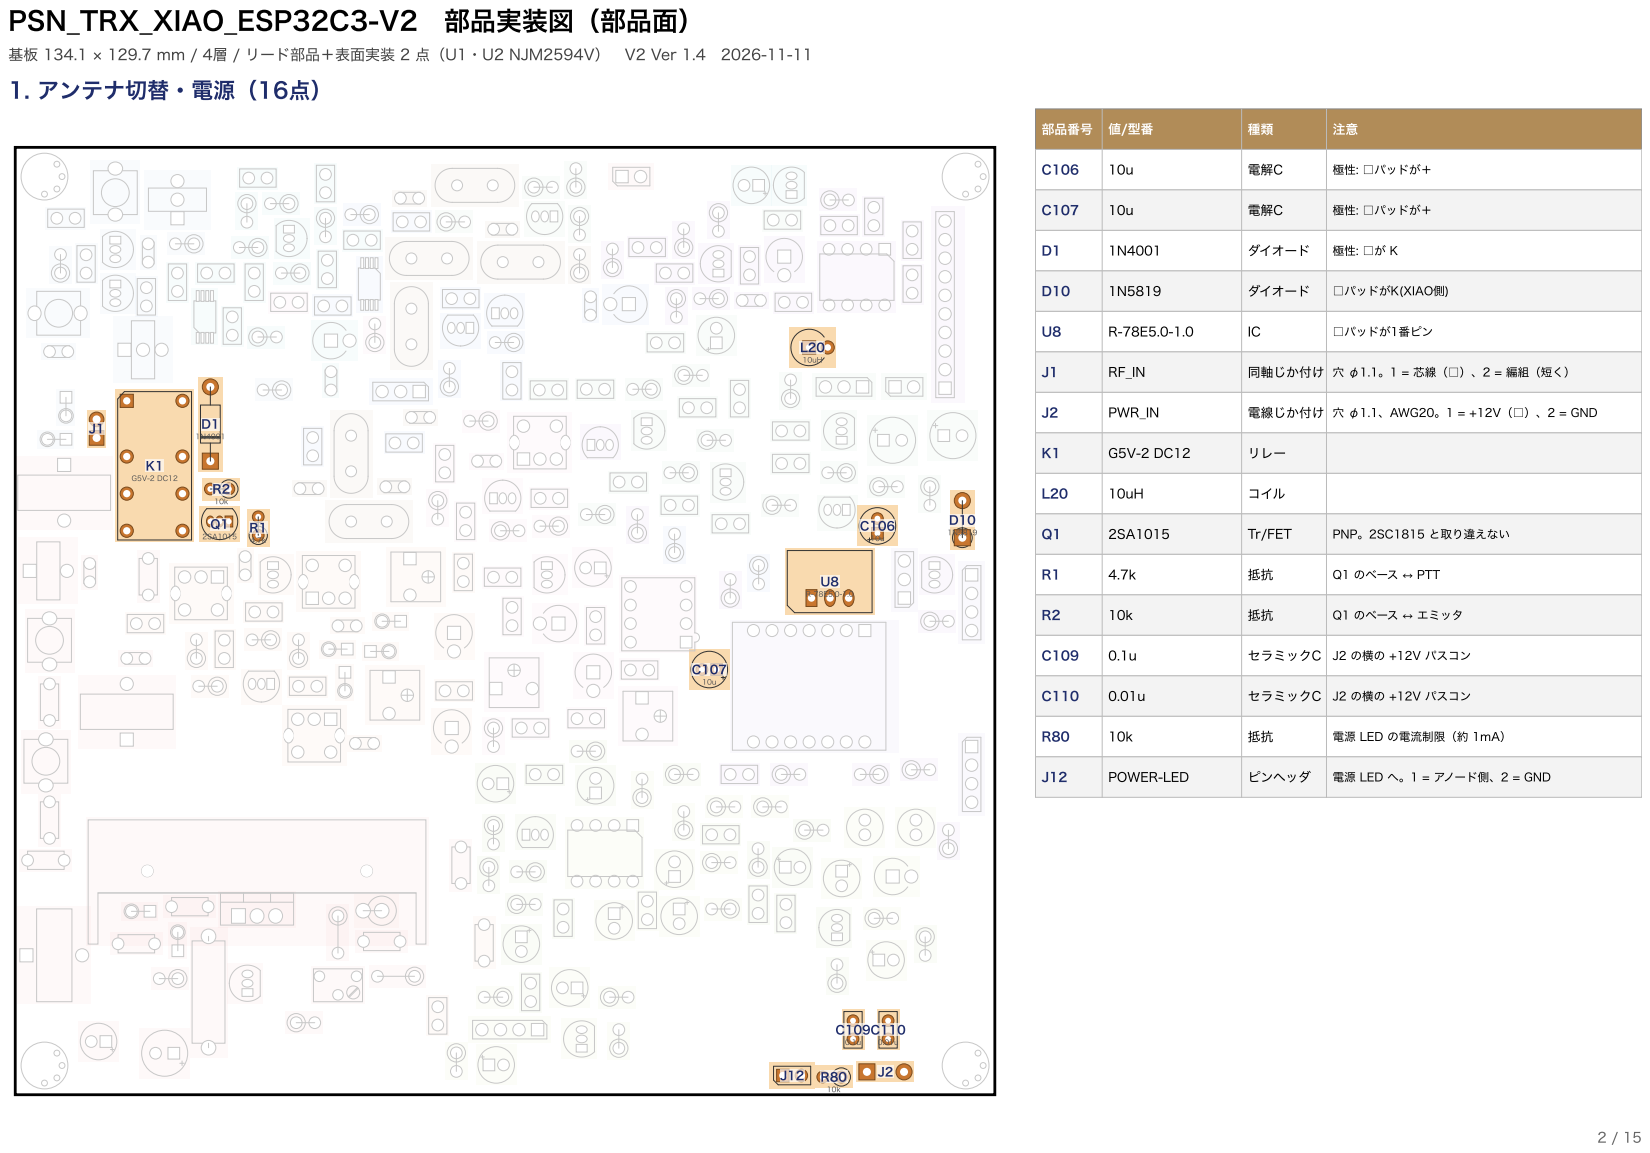
[picture p33: page 2]

部品番号 | 値/型番 | 種類 | 注意
J10 | Encoder | ピンヘッダ

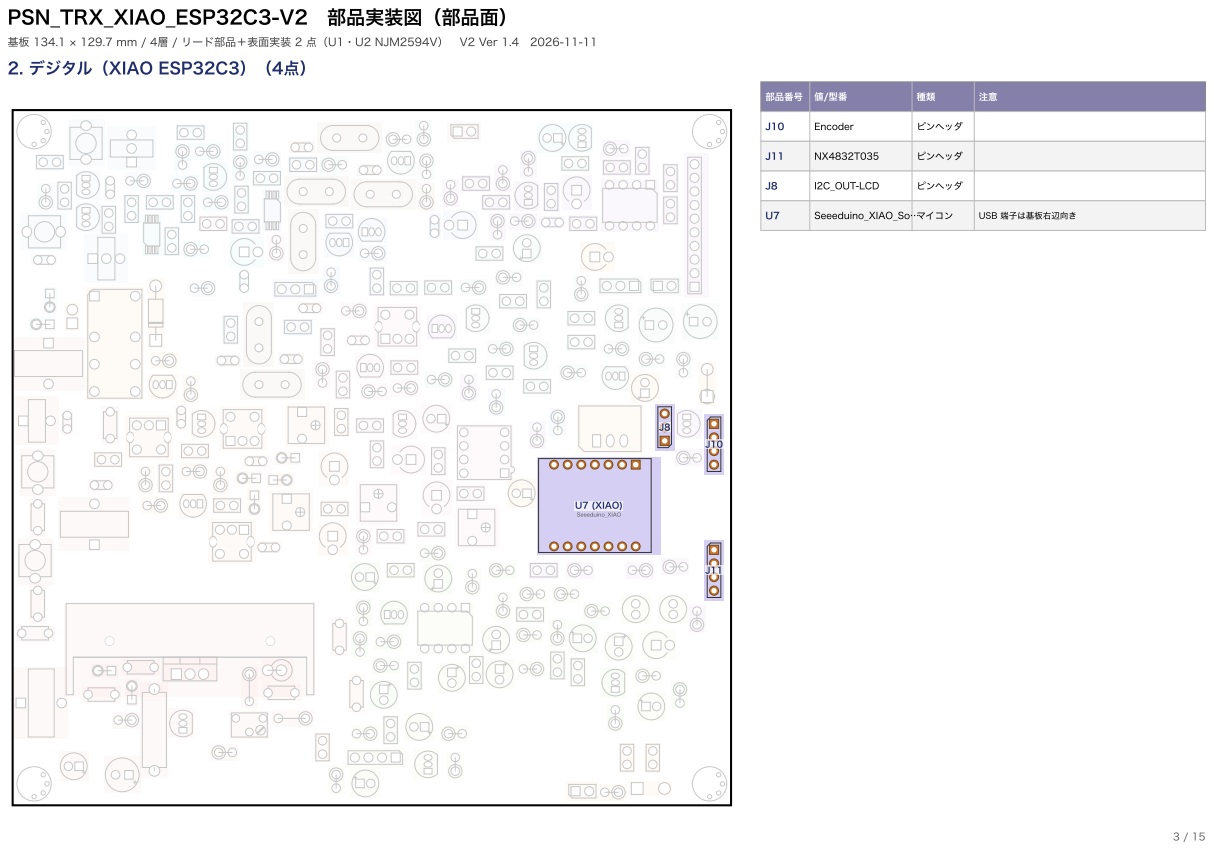
[picture p34: page 3]
U7 (XIAO); Seeeduino_XIAO; ピンヘッダ; I2C_OUT-LCD; Seeeduino_XIAO_So…マイコン; USB 端子は基板右辺向き; 2. デジタル（XIAO ESP32C3）（4点）

部品番号 | 値/型番 | 種類 | 注意
C7 | 0.01u | セラミックC

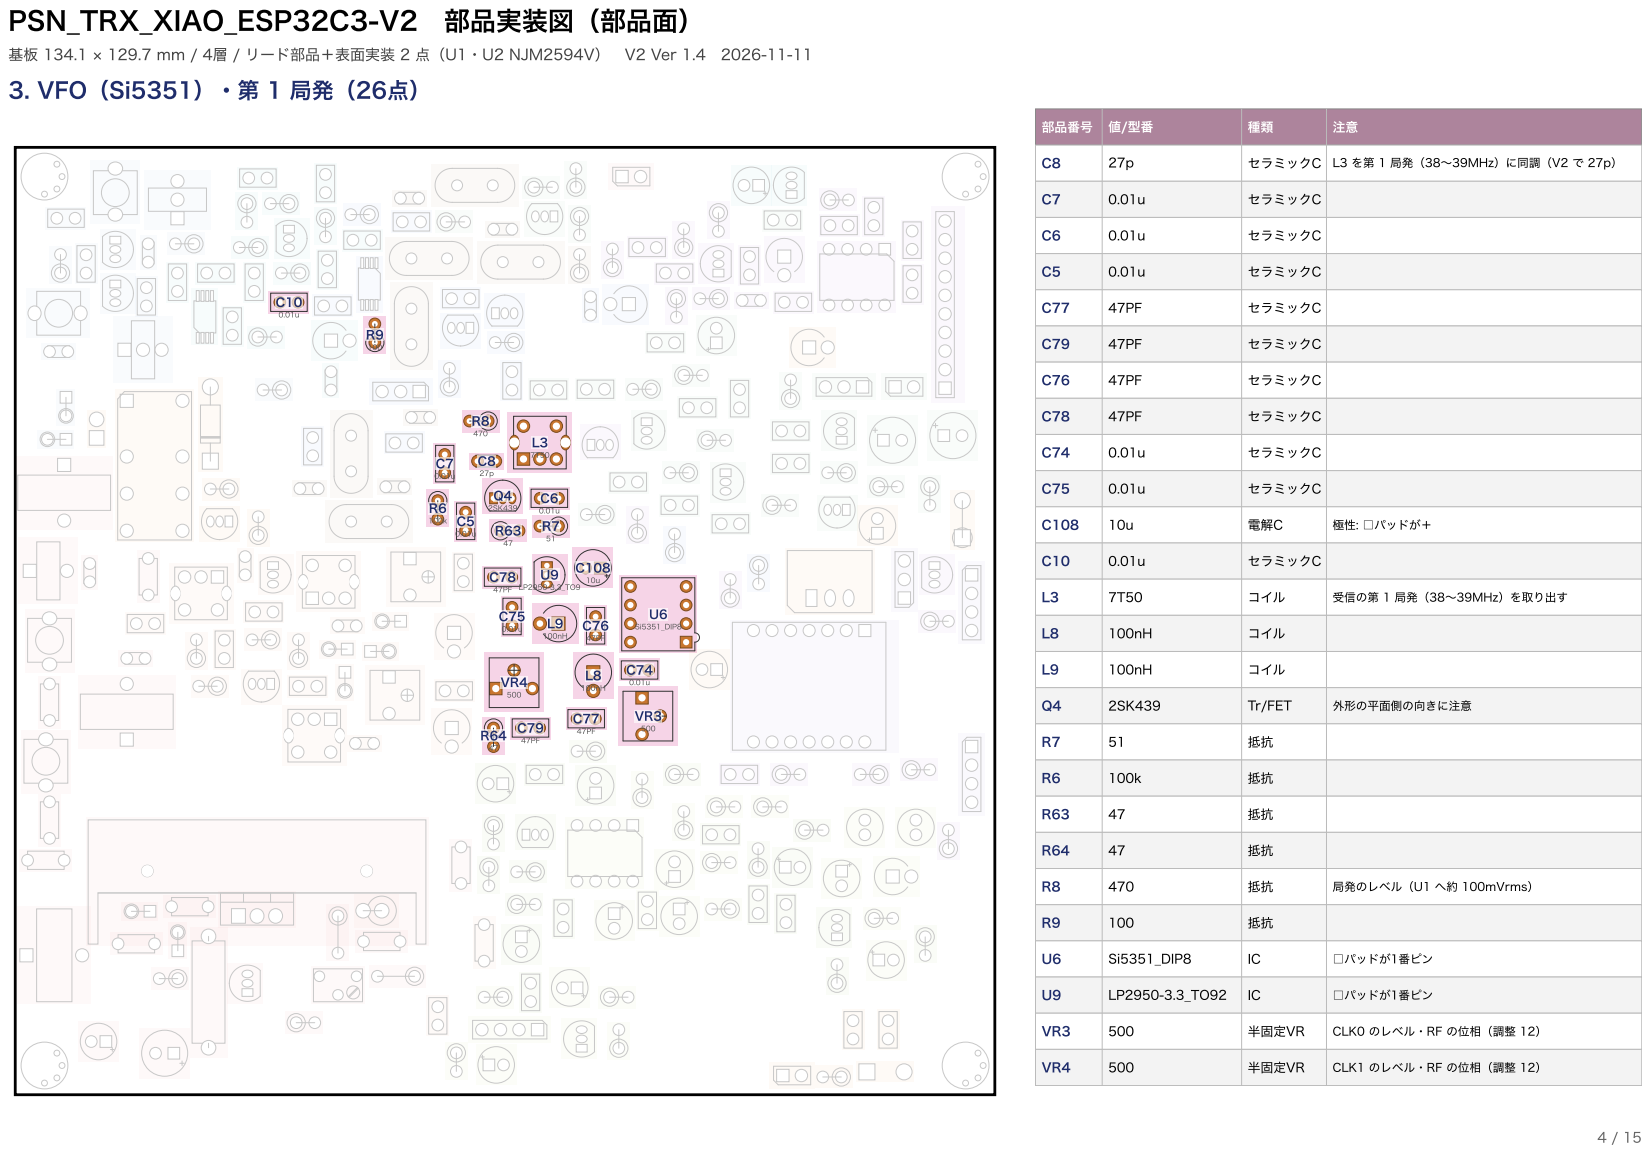
[picture p35: page 4]

L2
C52

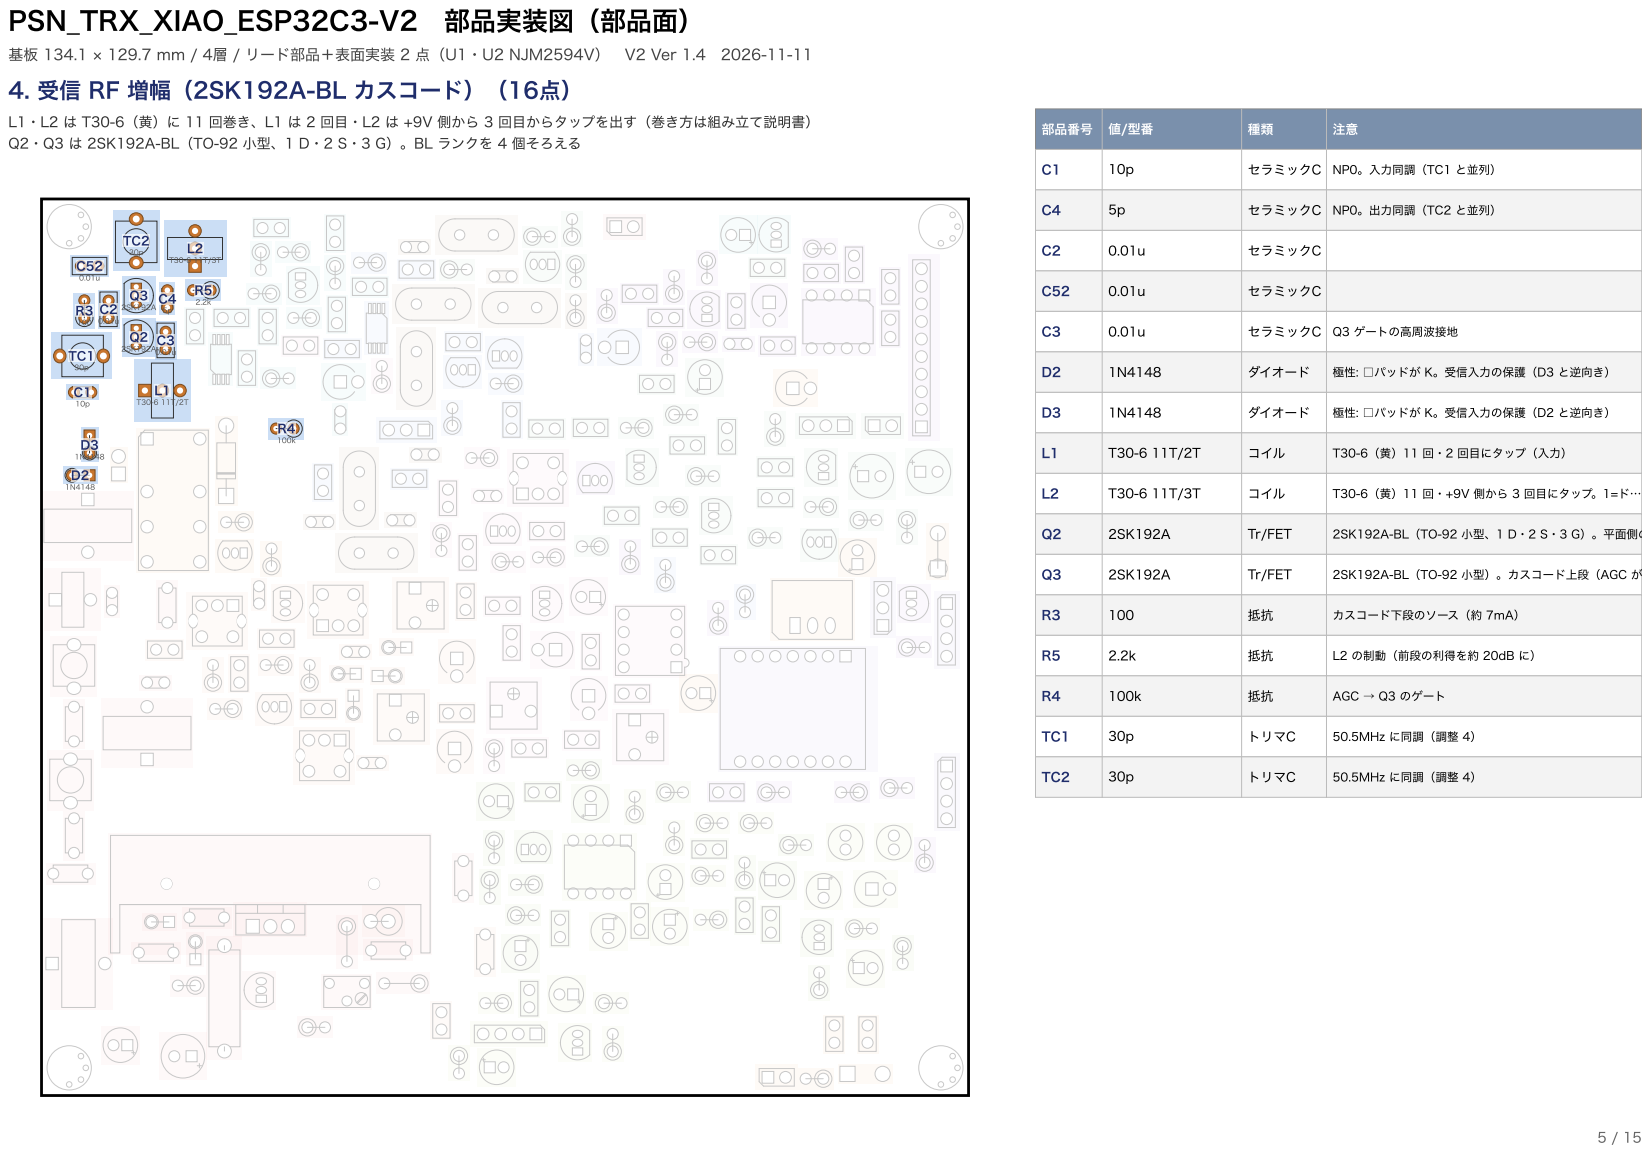
[picture p36: page 5]

4. 受信 RF 増幅（2SK192A-BL カスコード）（16点）

L1・L2 は T30-6（黄）に 11 回巻き、L1 は 2 回目・L2 は +9V 側から 3 回目からタップを出す（巻き方は組み立て説明書）
Q2・Q3 は 2SK192A-BL（TO-92 小型、1 D・2 S・3 G）。BL ランクを 4 個そろえる

C53
C50

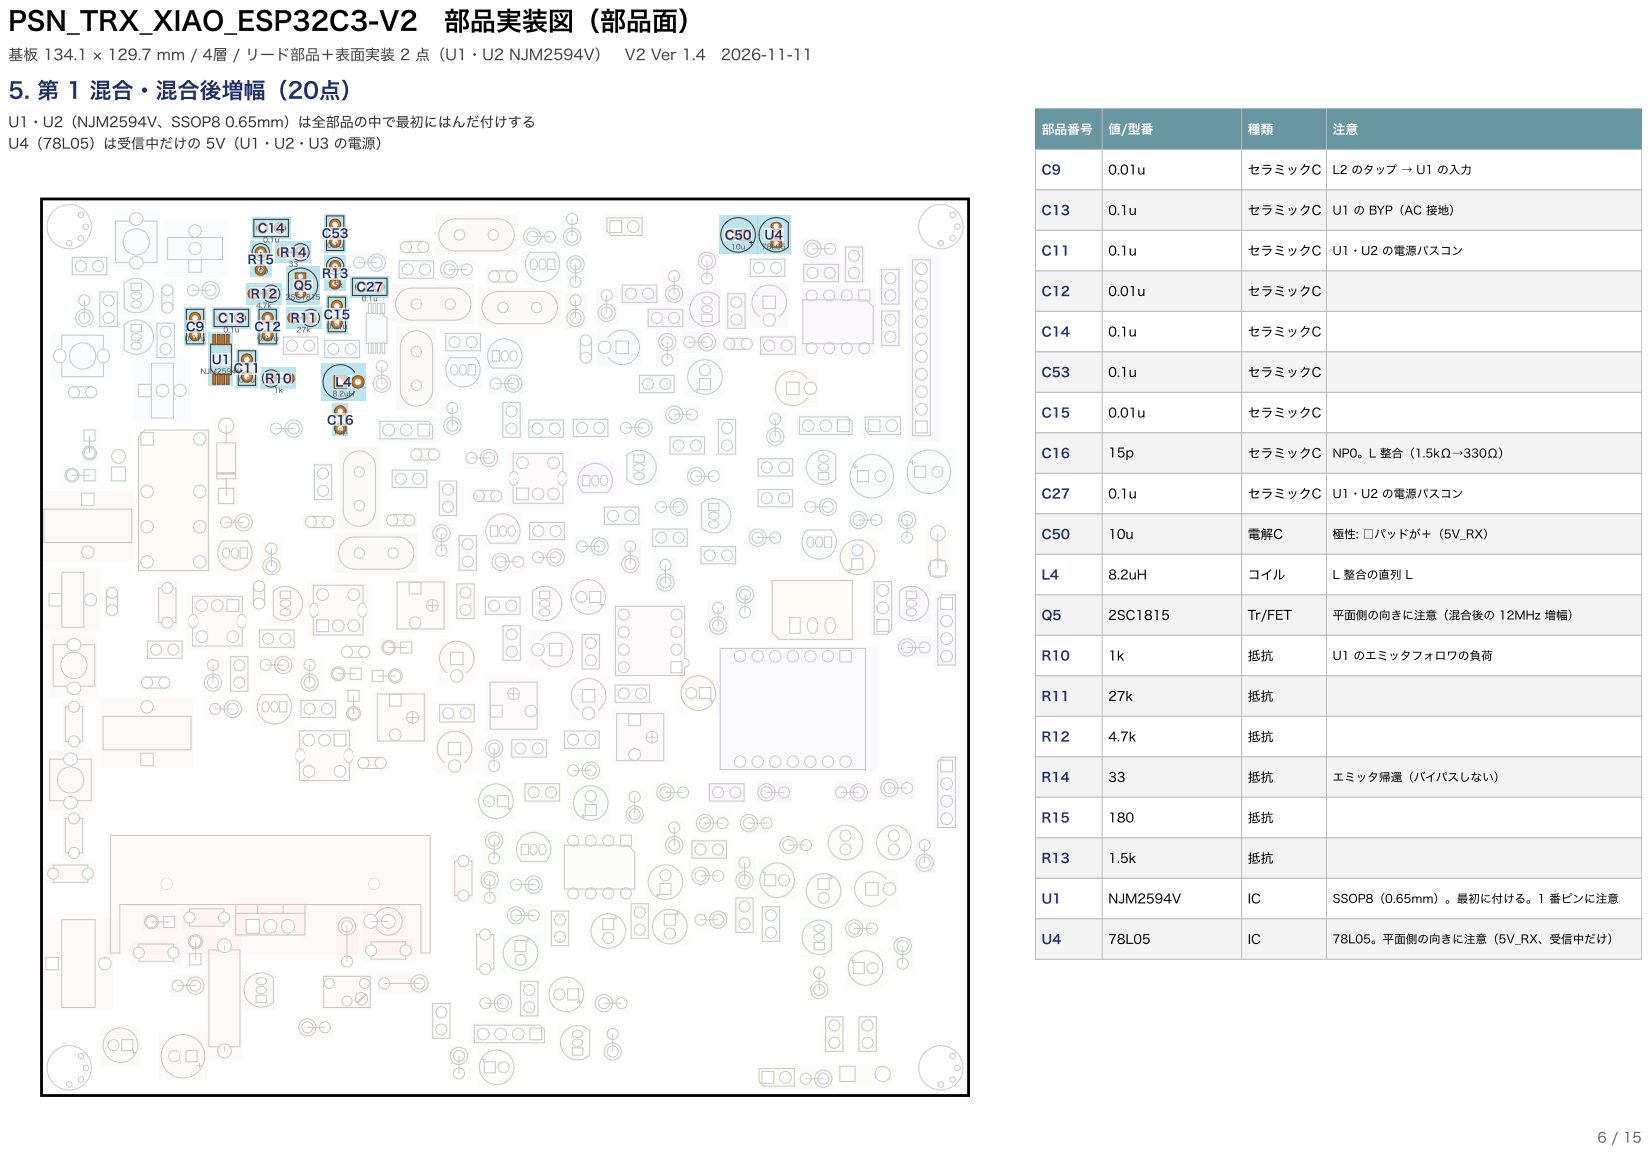
[picture p37: page 6]

Y5
C20

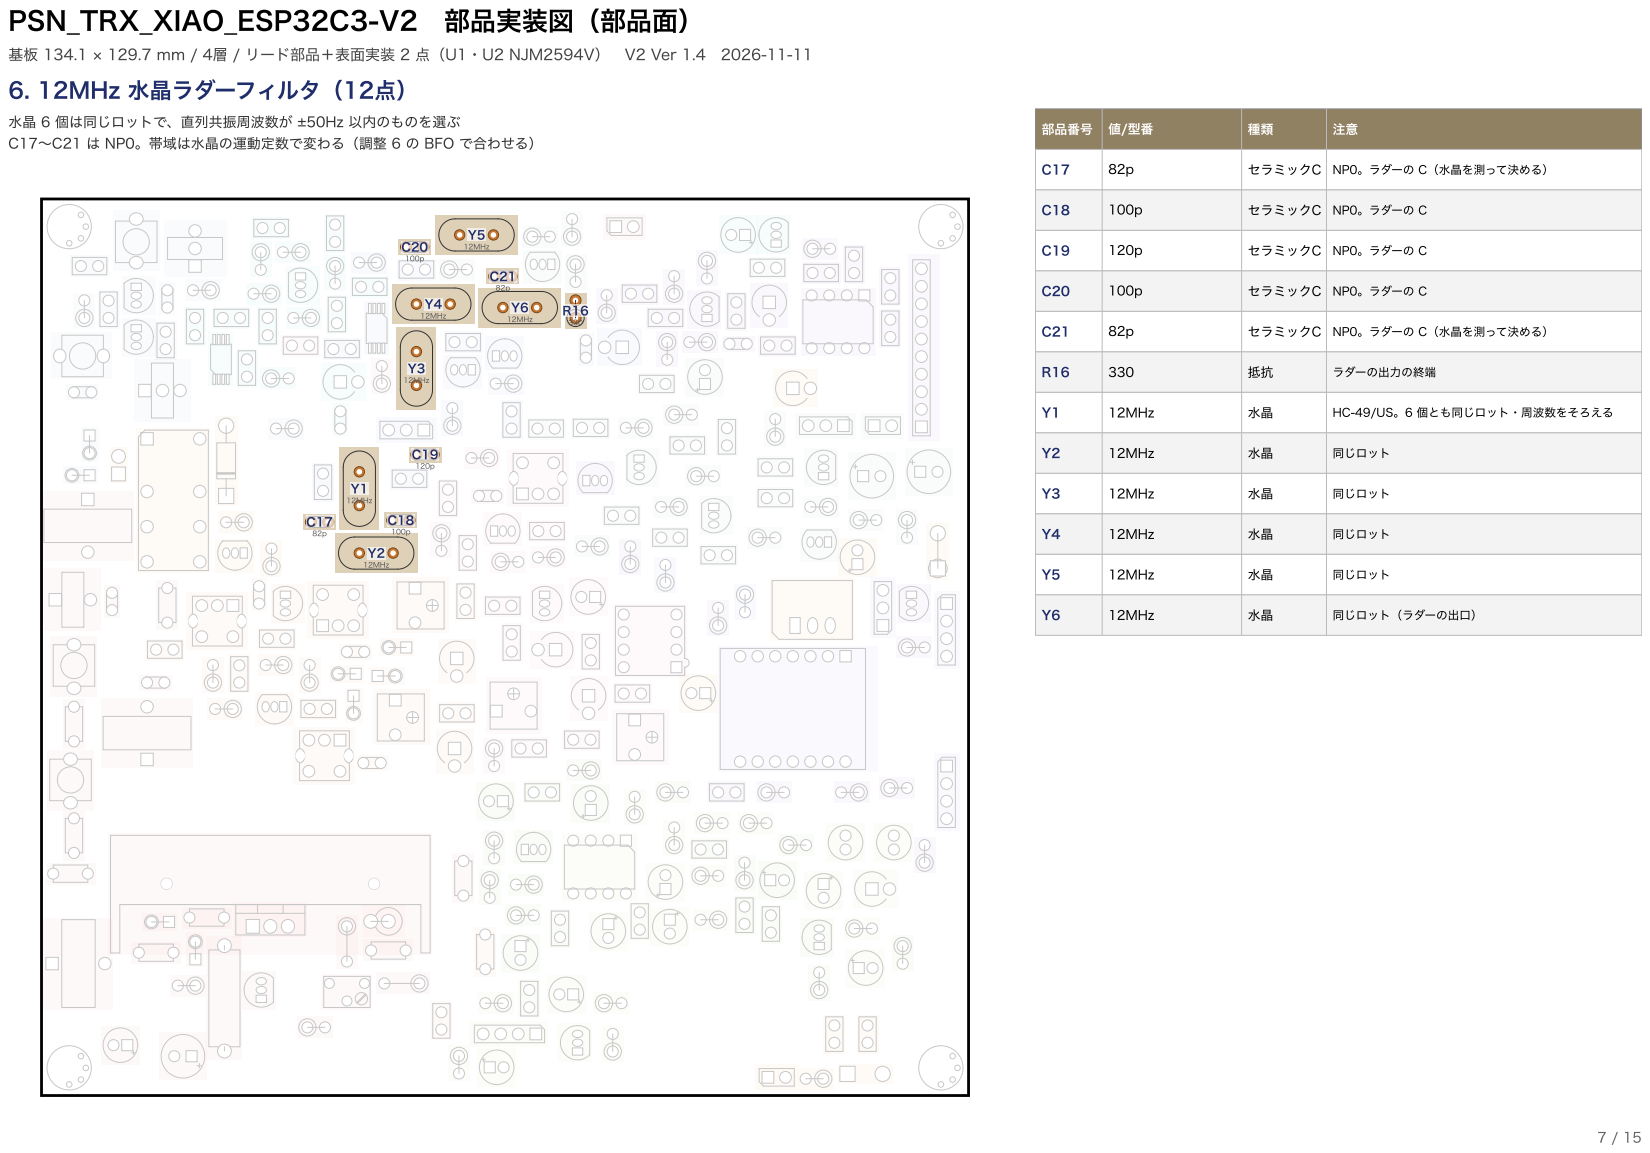
[picture p38: page 7]
12MHz; 部品番号; セラミックC; NP0。ラダーの C（水晶を測って決める）; NP0。ラダーの C; ラダーの出力の終端; HC-49/US。6 個とも同じロット・周波数をそろえる; 同じロット; 同じロット（ラダーの出口）; 6. 12MHz 水晶ラダーフィルタ（12点）

水晶 6 個は同じロットで、直列共振周波数が ±50Hz 以内のものを選ぶ
C17〜C21 は NP0。帯域は水晶の運動定数で変わる（調整 6 の BFO で合わせる）

R27

部品番号 | 値/型番 | 種類 | 注意

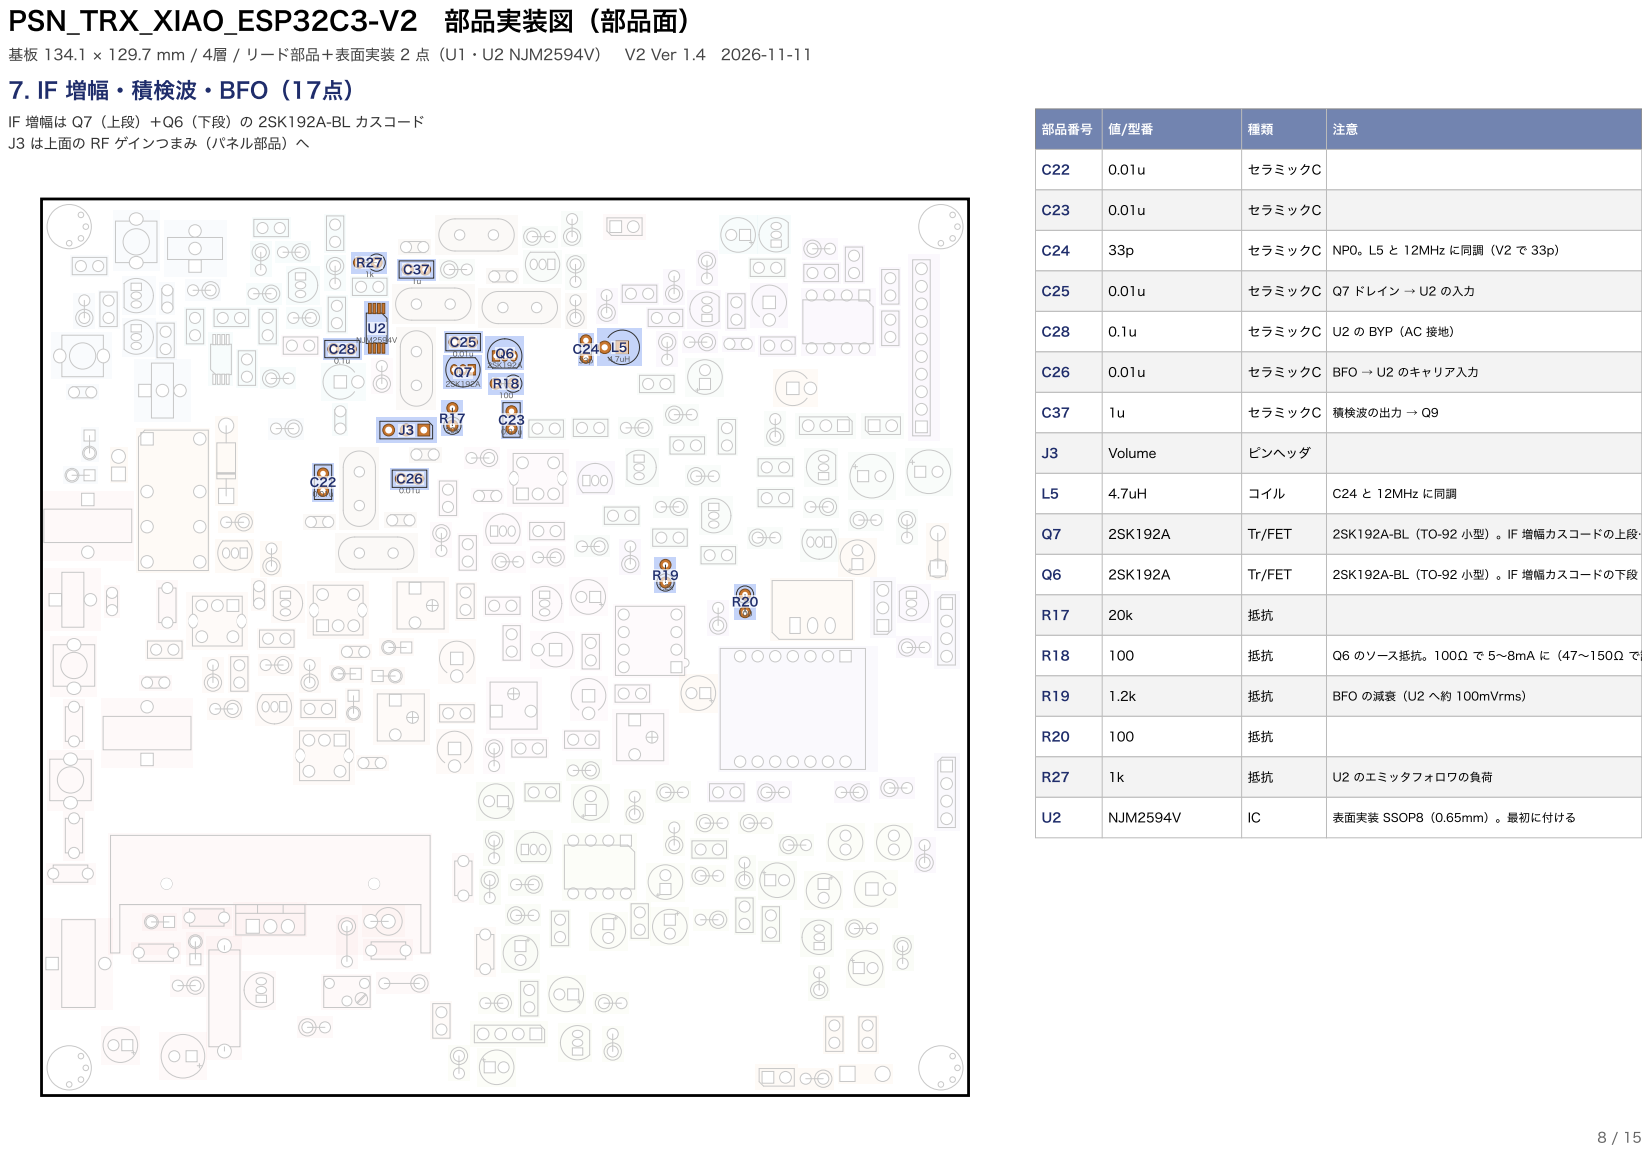
[picture p39: page 8]

7. IF 増幅・積検波・BFO（17点）

IF 増幅は Q7（上段）＋Q6（下段）の 2SK192A-BL カスコード
J3 は上面の RF ゲインつまみ（パネル部品）へ

C35

R26

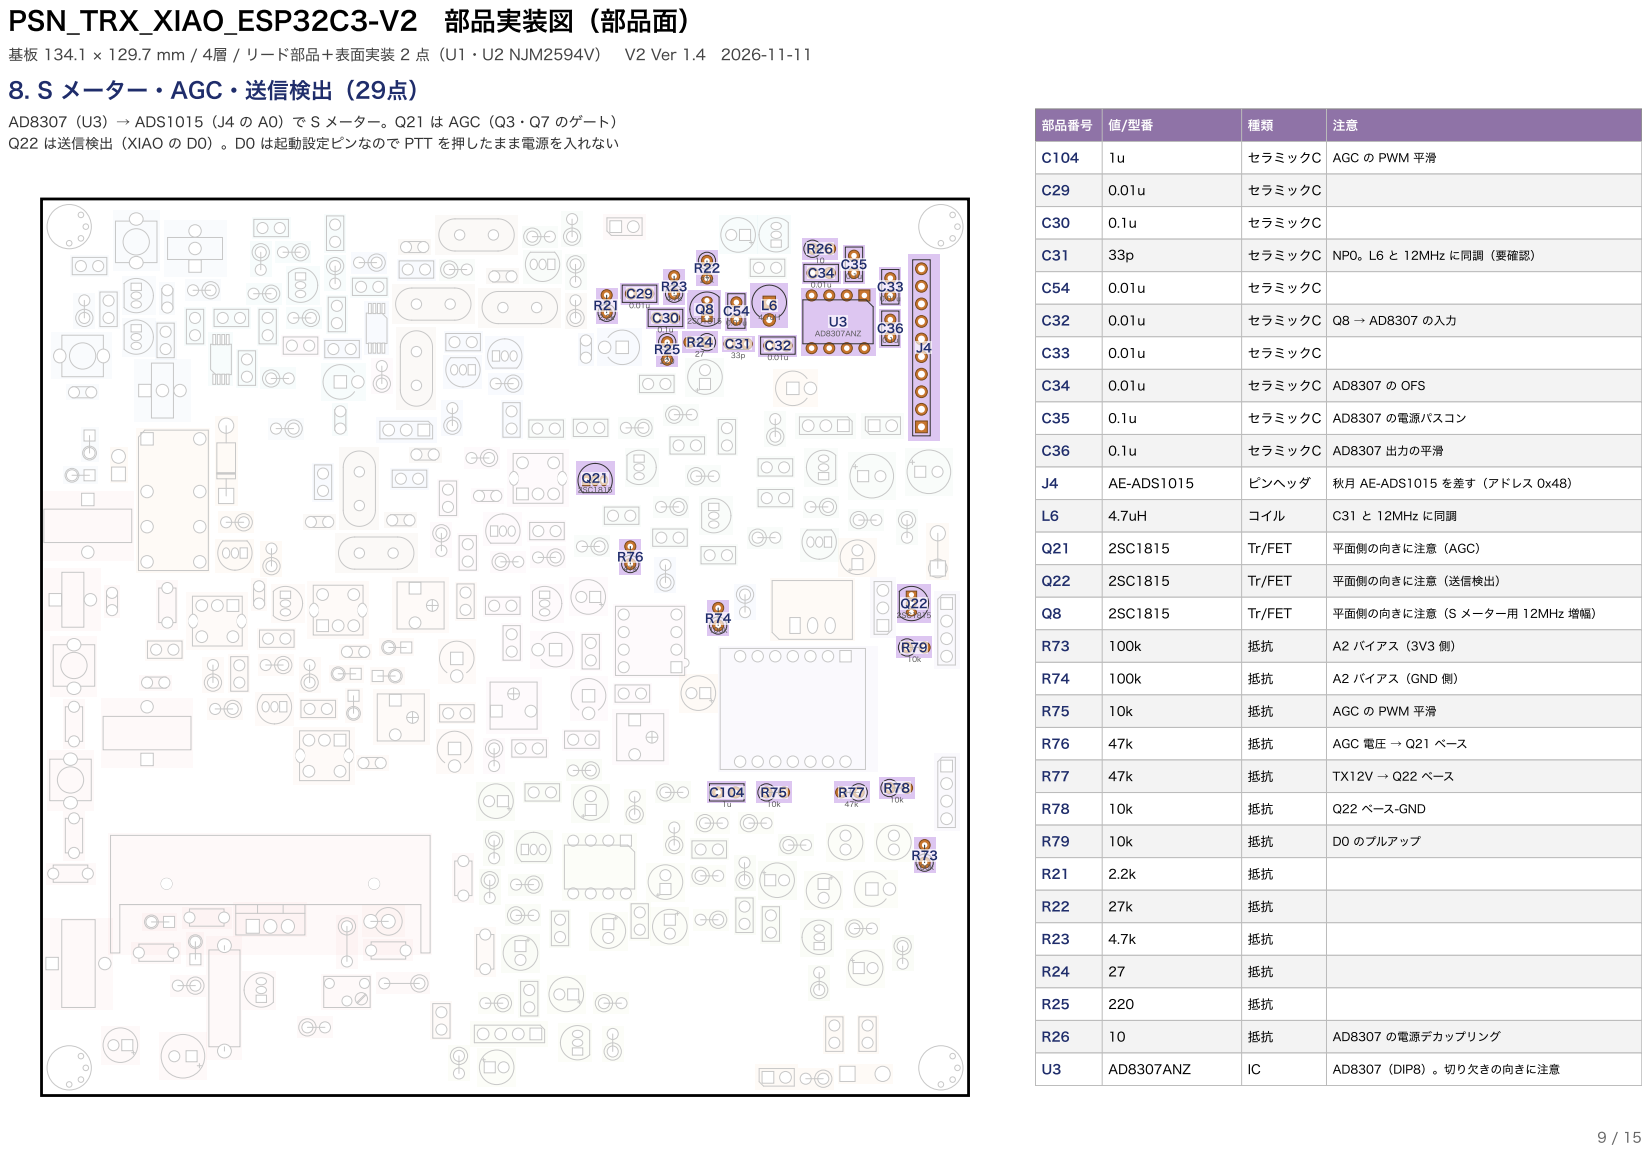
[picture p40: page 9]

AD8307（U3）→ ADS1015（J4 の A0）で S メーター。Q21 は AGC（Q3・Q7 のゲート）
Q22 は送信検出（XIAO の D0）。D0 は起動設定ピンなので PTT を押したまま電源を入れない

R28

Q9

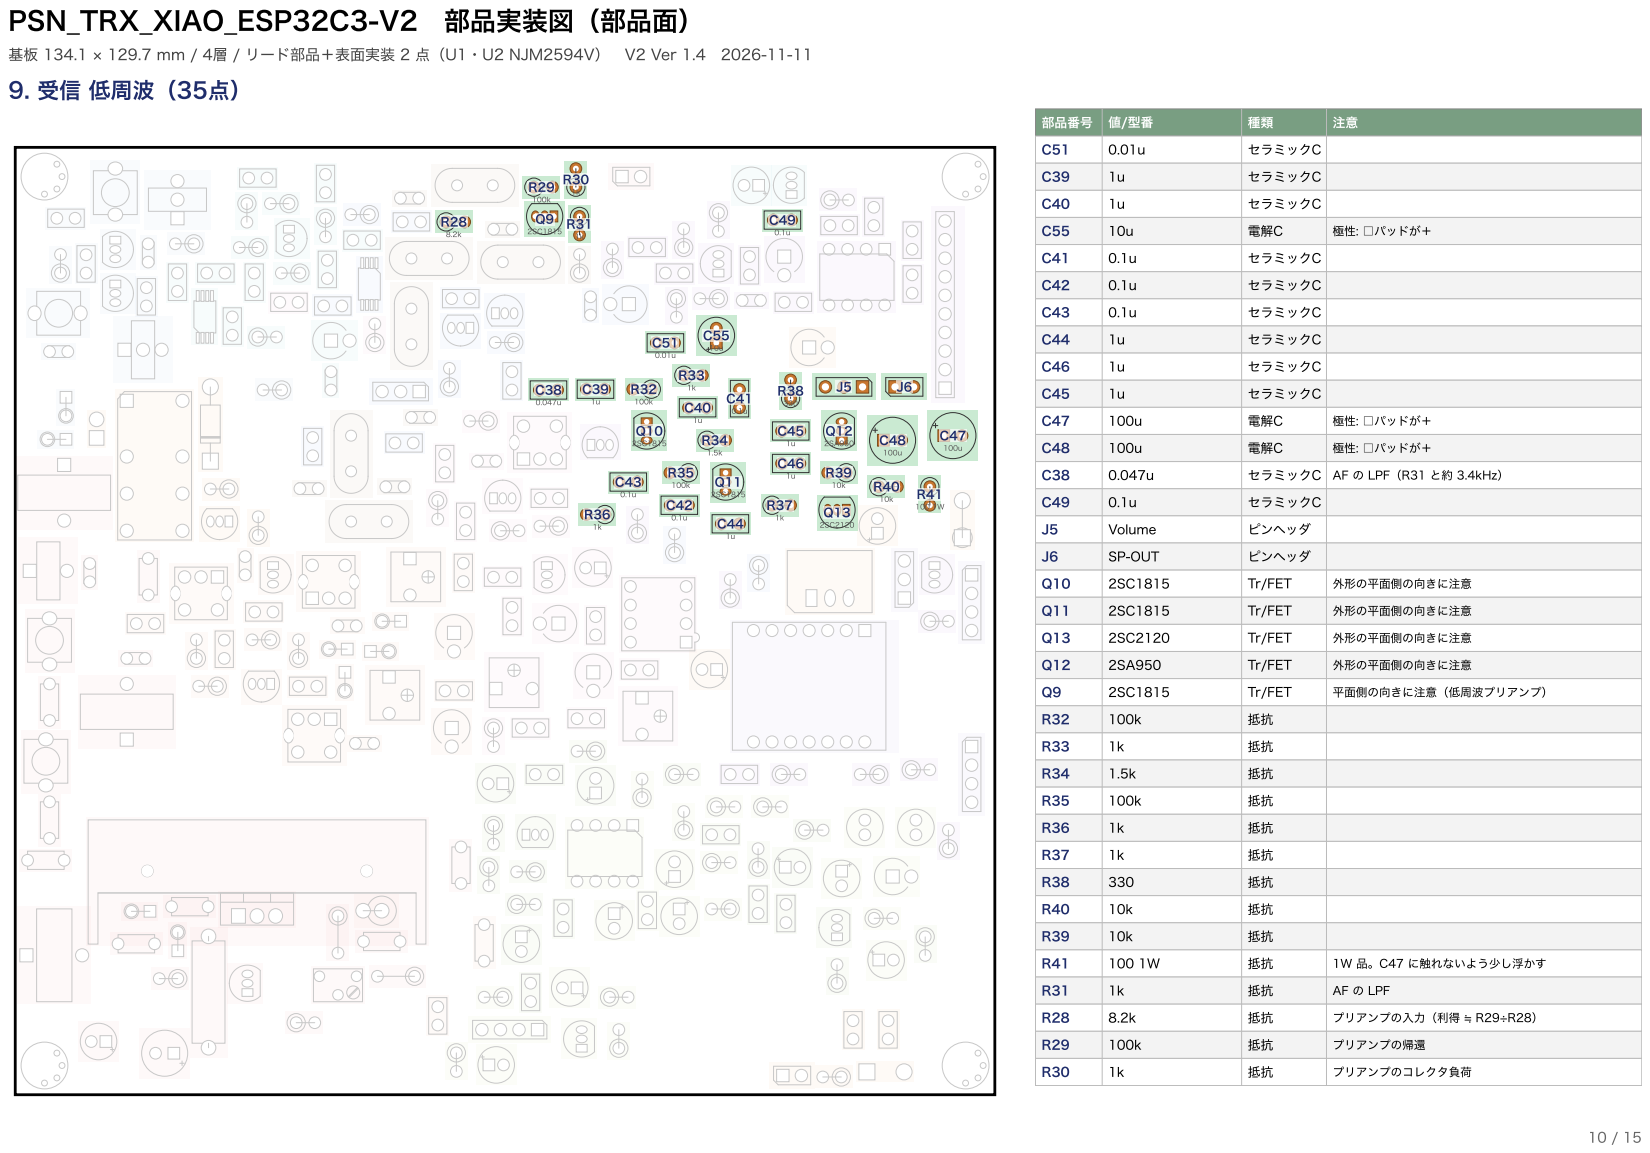
[picture p41: page 10]

部品番号 | 値/型番 | 種類 | 注意

# 10. 送信 マイクアンプ（25点）

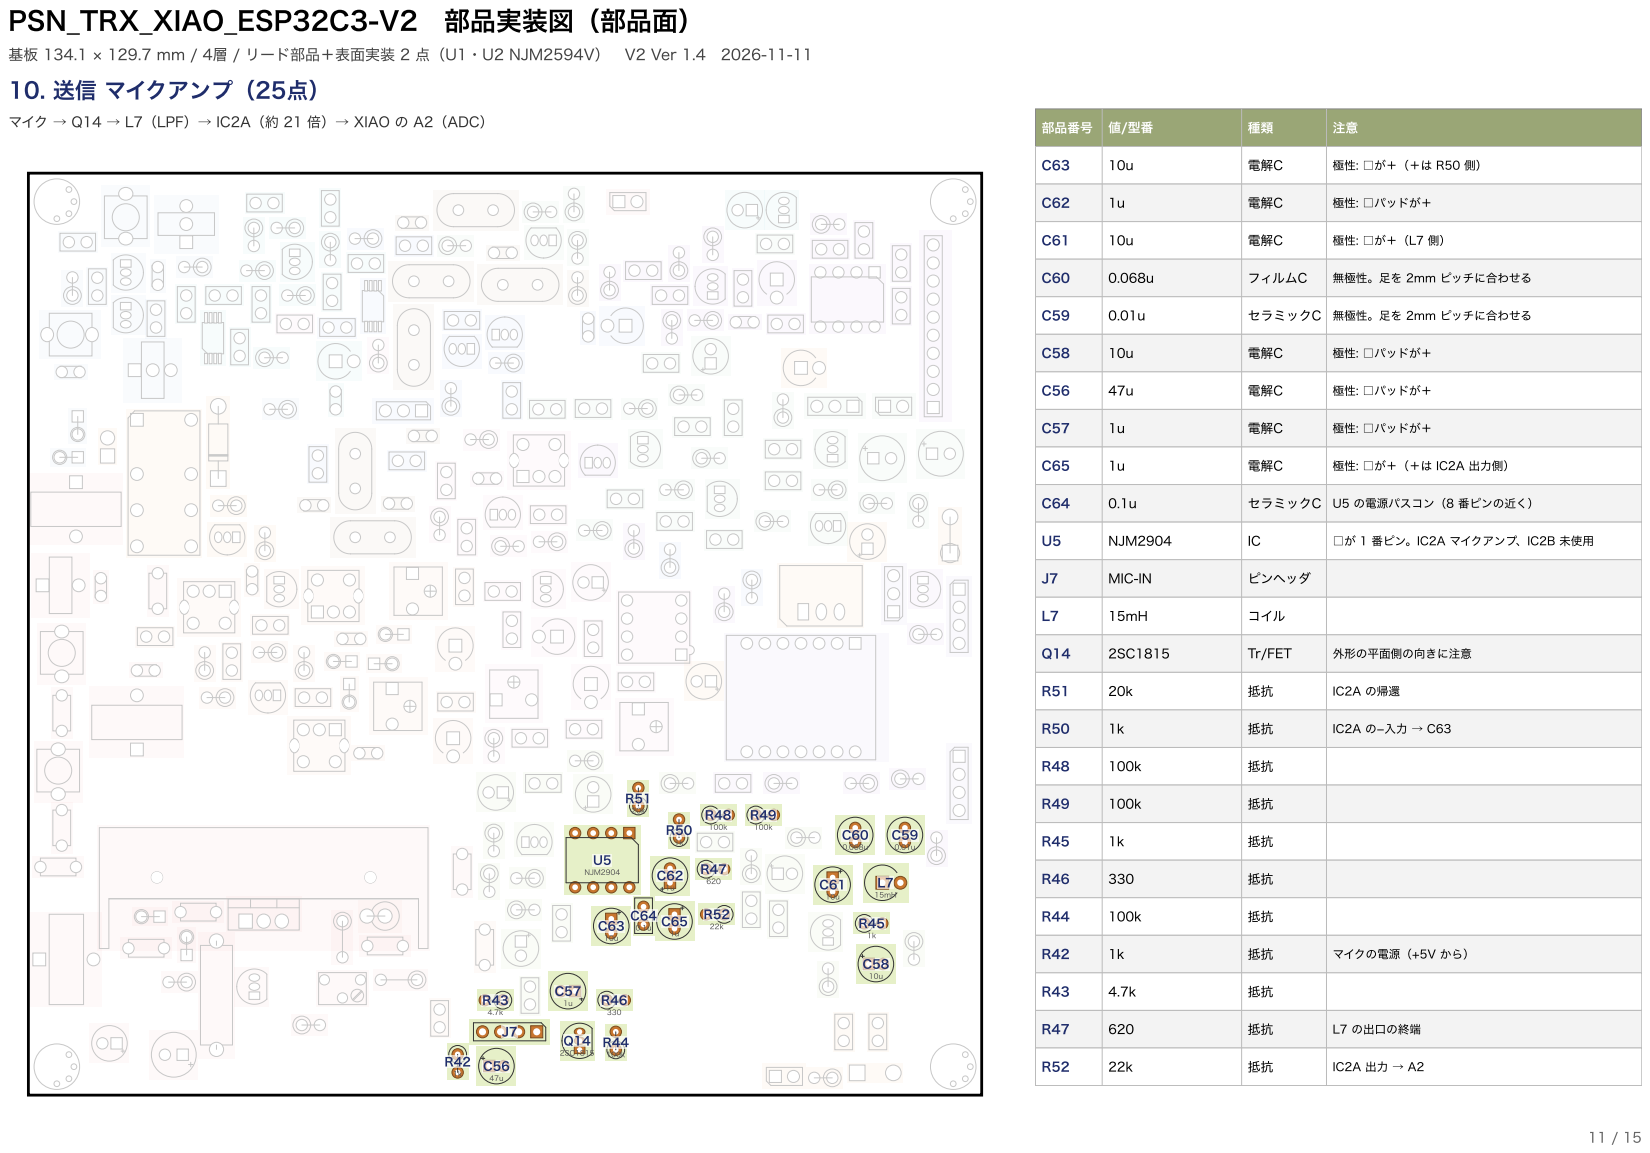
[picture p42: page 11]

マイク → Q14 → L7（LPF）→ IC2A（約 21 倍）→ XIAO の A2（ADC）

部品番号 | 値/型番 | 種類 | 注意
C83 | 0.01u | セラミックC

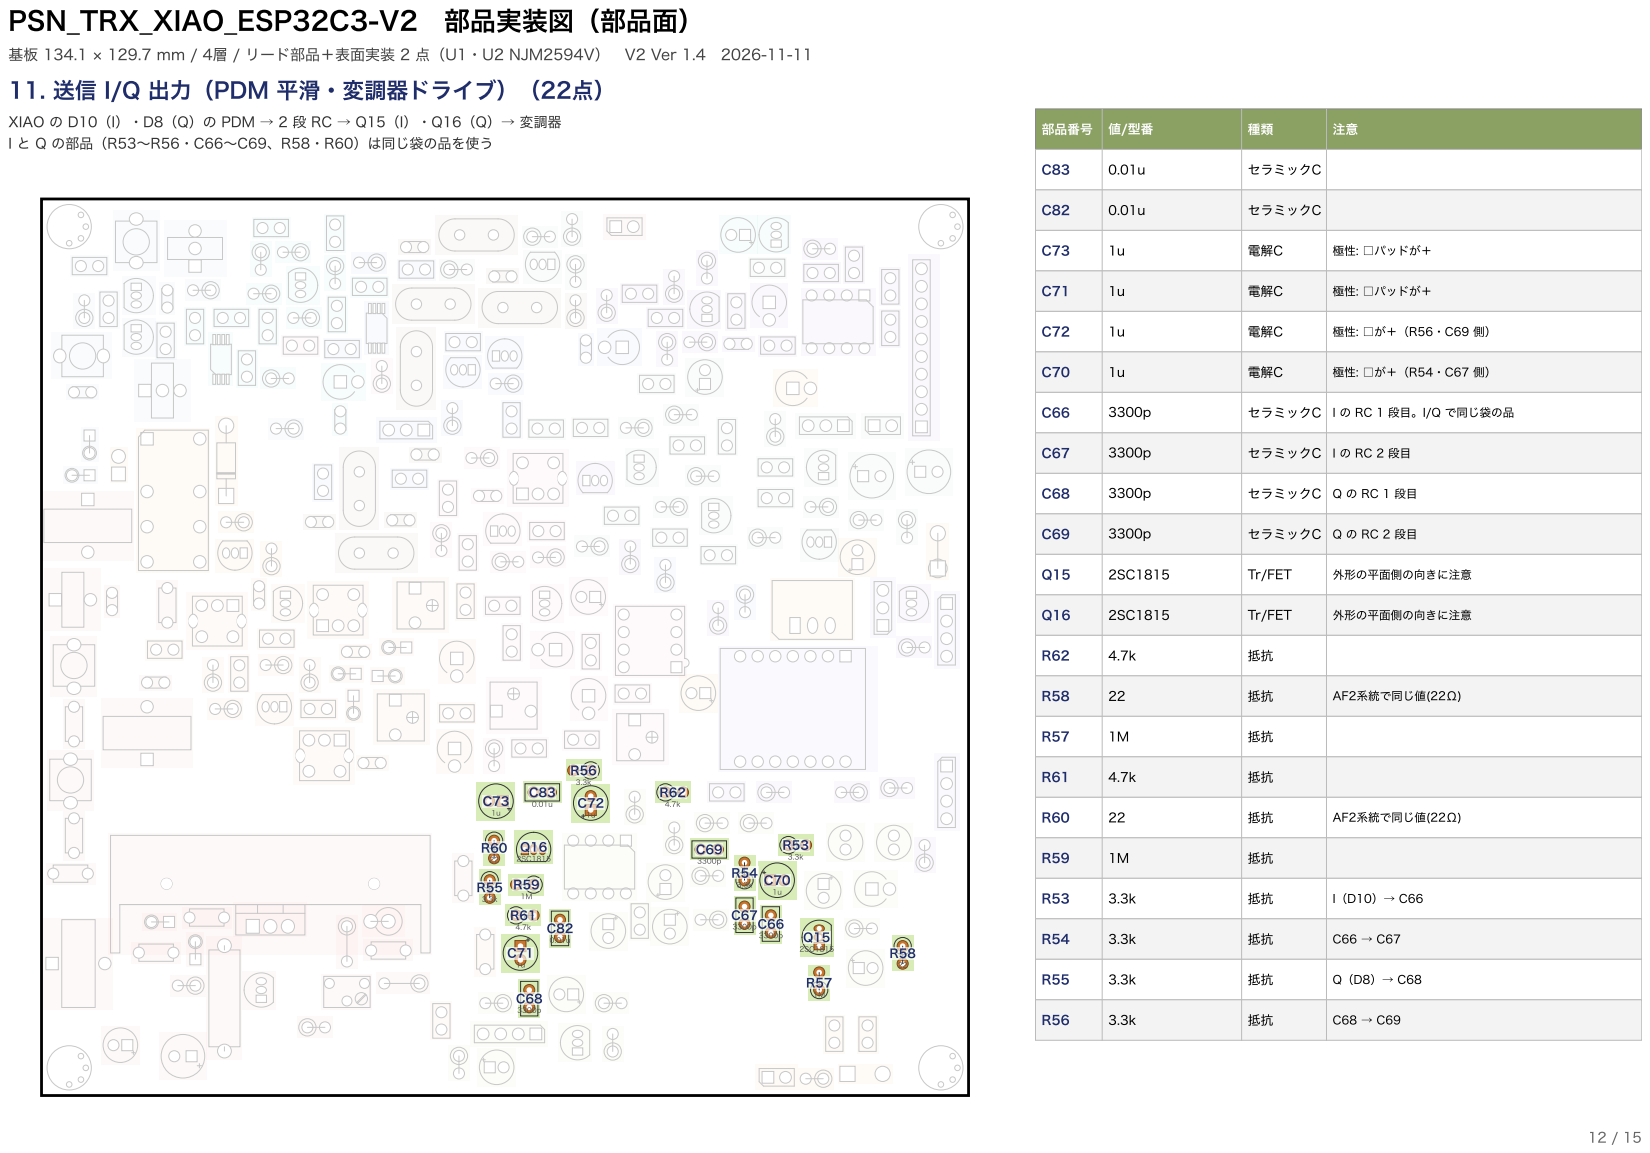
[picture p43: page 12]

11. 送信 I/Q 出力（PDM 平滑・変調器ドライブ）（22点）

XIAO の D10（I）・D8（Q）の PDM → 2 段 RC → Q15（I）・Q16（Q）→ 変調器
I と Q の部品（R53〜R56・C66〜C69、R58・R60）は同じ袋の品を使う

部品番号 | 値/型番 | 種類 | 注意
C92 | 150pF | セラミックC

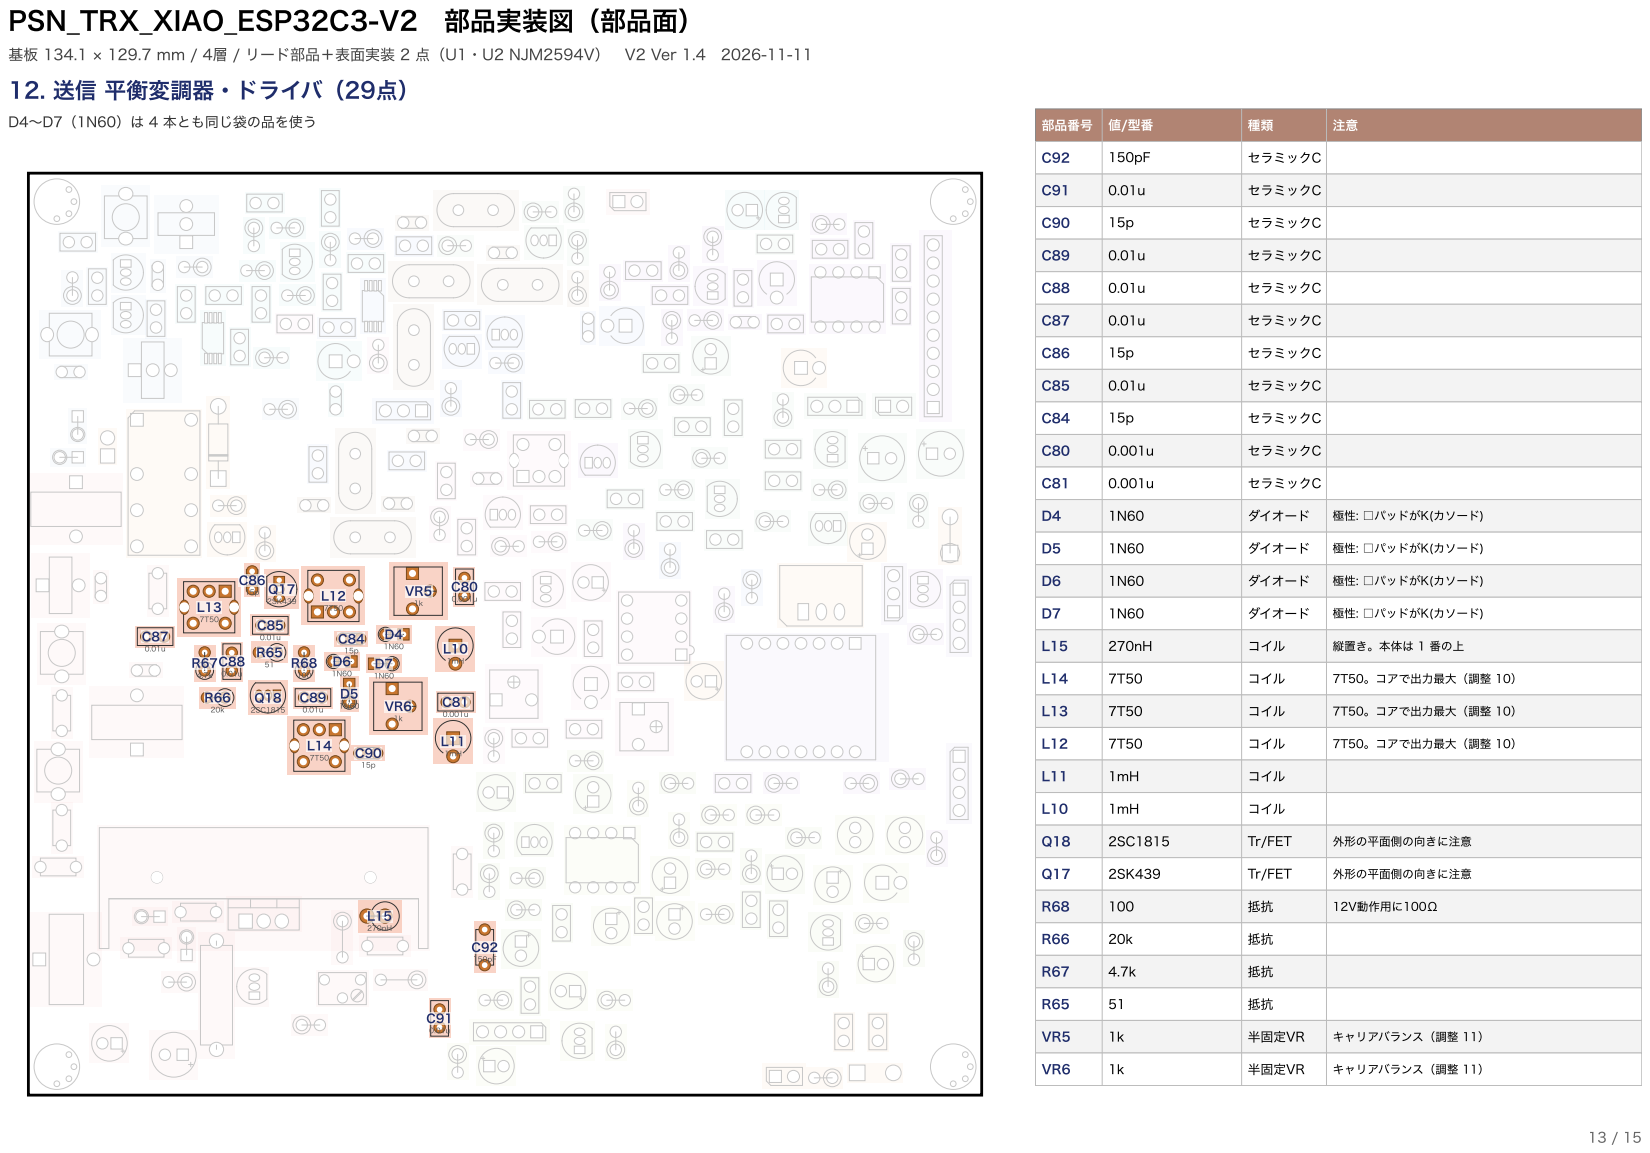
[picture p44: page 13]

J9

部品番号 | 値/型番 | 種類 | 注意

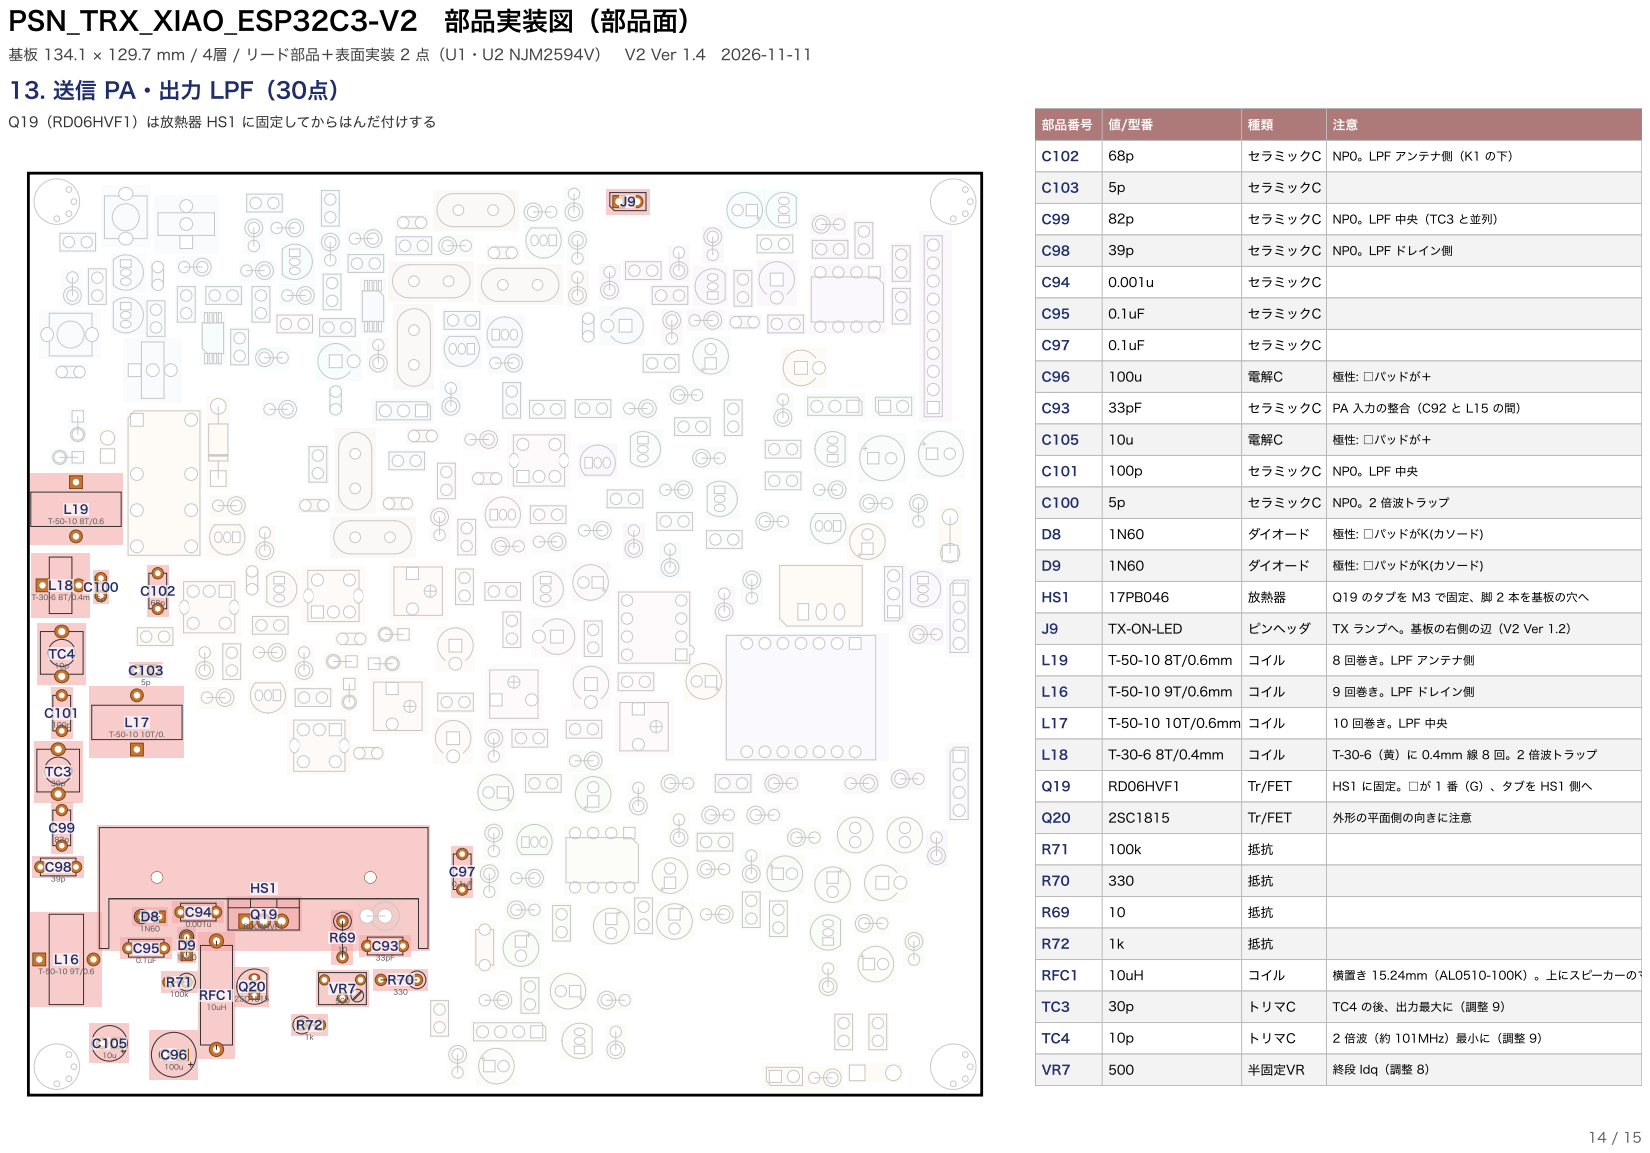
[picture p45: page 14]

13. 送信 PA・出力 LPF（30点）

U4
TC2

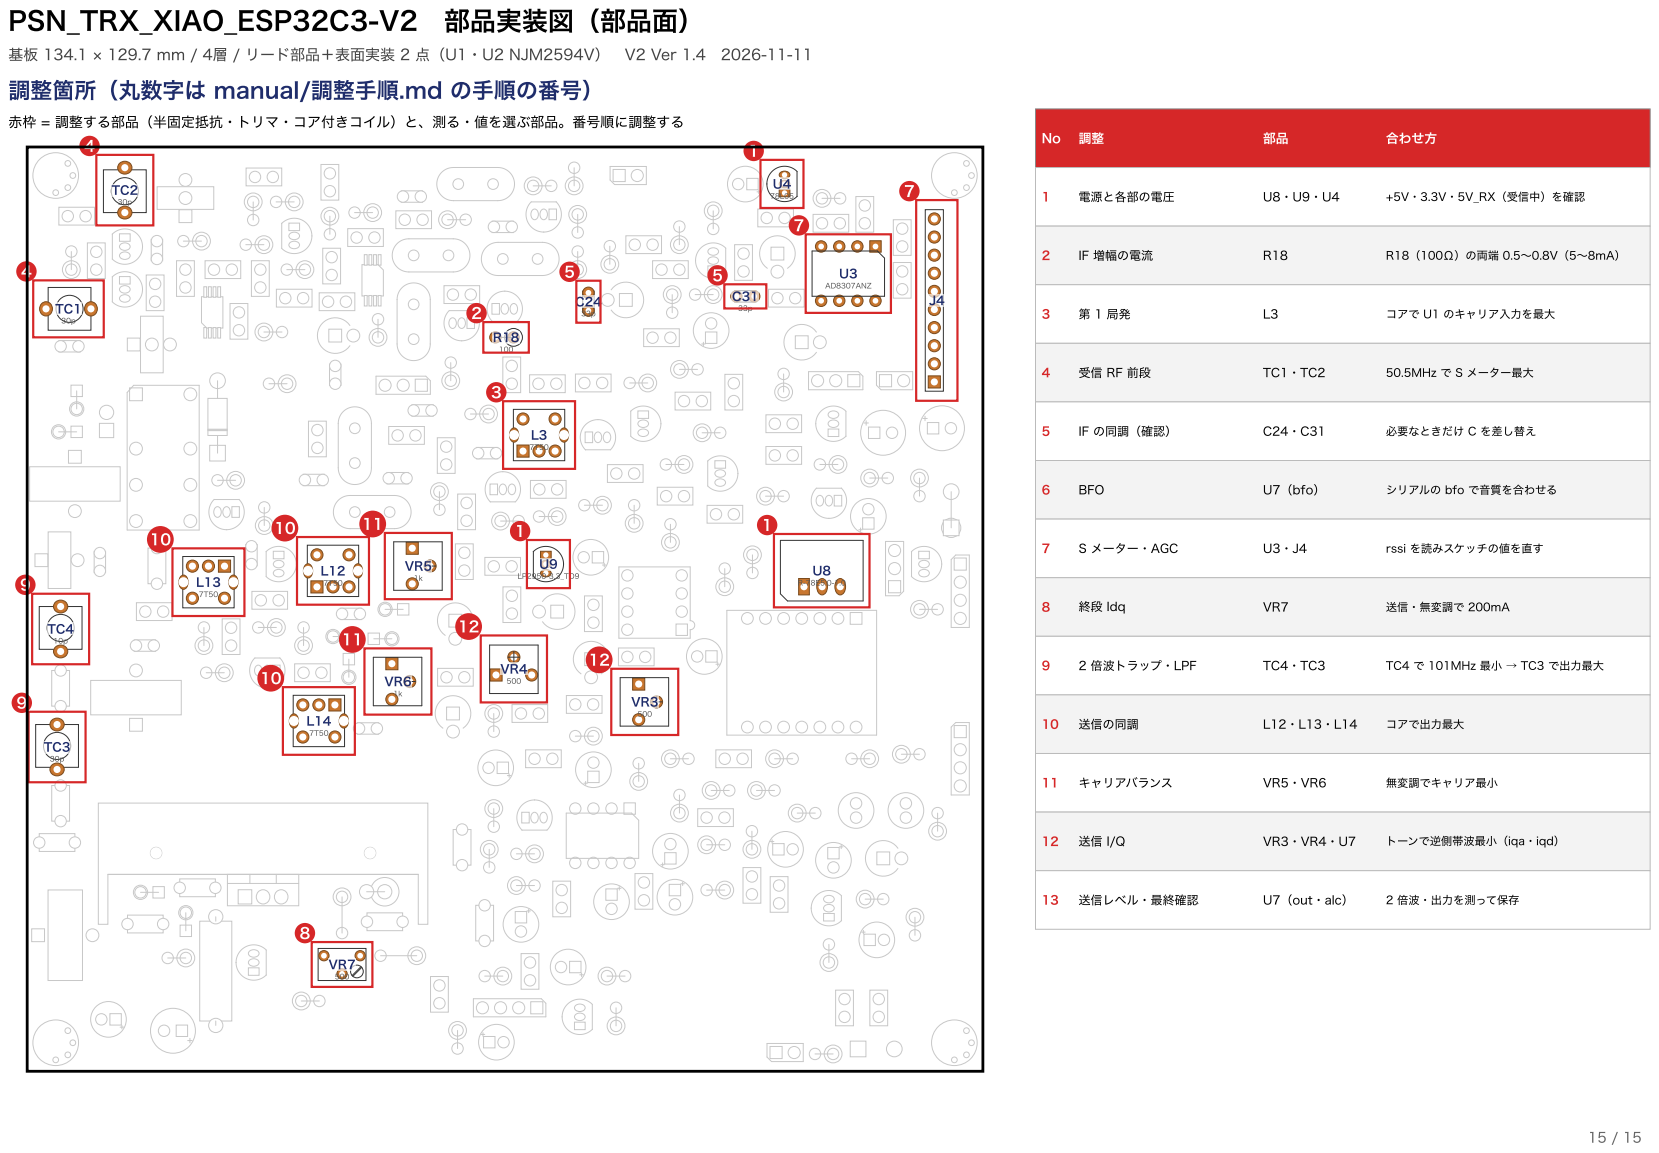
[picture p46: page 15]

調整箇所（丸数字は manual/調整手順.md の手順の番号）

赤枠 = 調整する部品（半固定抵抗・トリマ・コア付きコイル）と、測る・値を選ぶ部品。番号順に調整する
