kazushinjo/PSN_TRX_XIAO_ESP32C3-V2/docs/PSN_TRX_原寸確認図.pdf

# PSN_TRX_XIAO_ESP32C3-V2 原寸確認図（部品面から見た図、1:1）

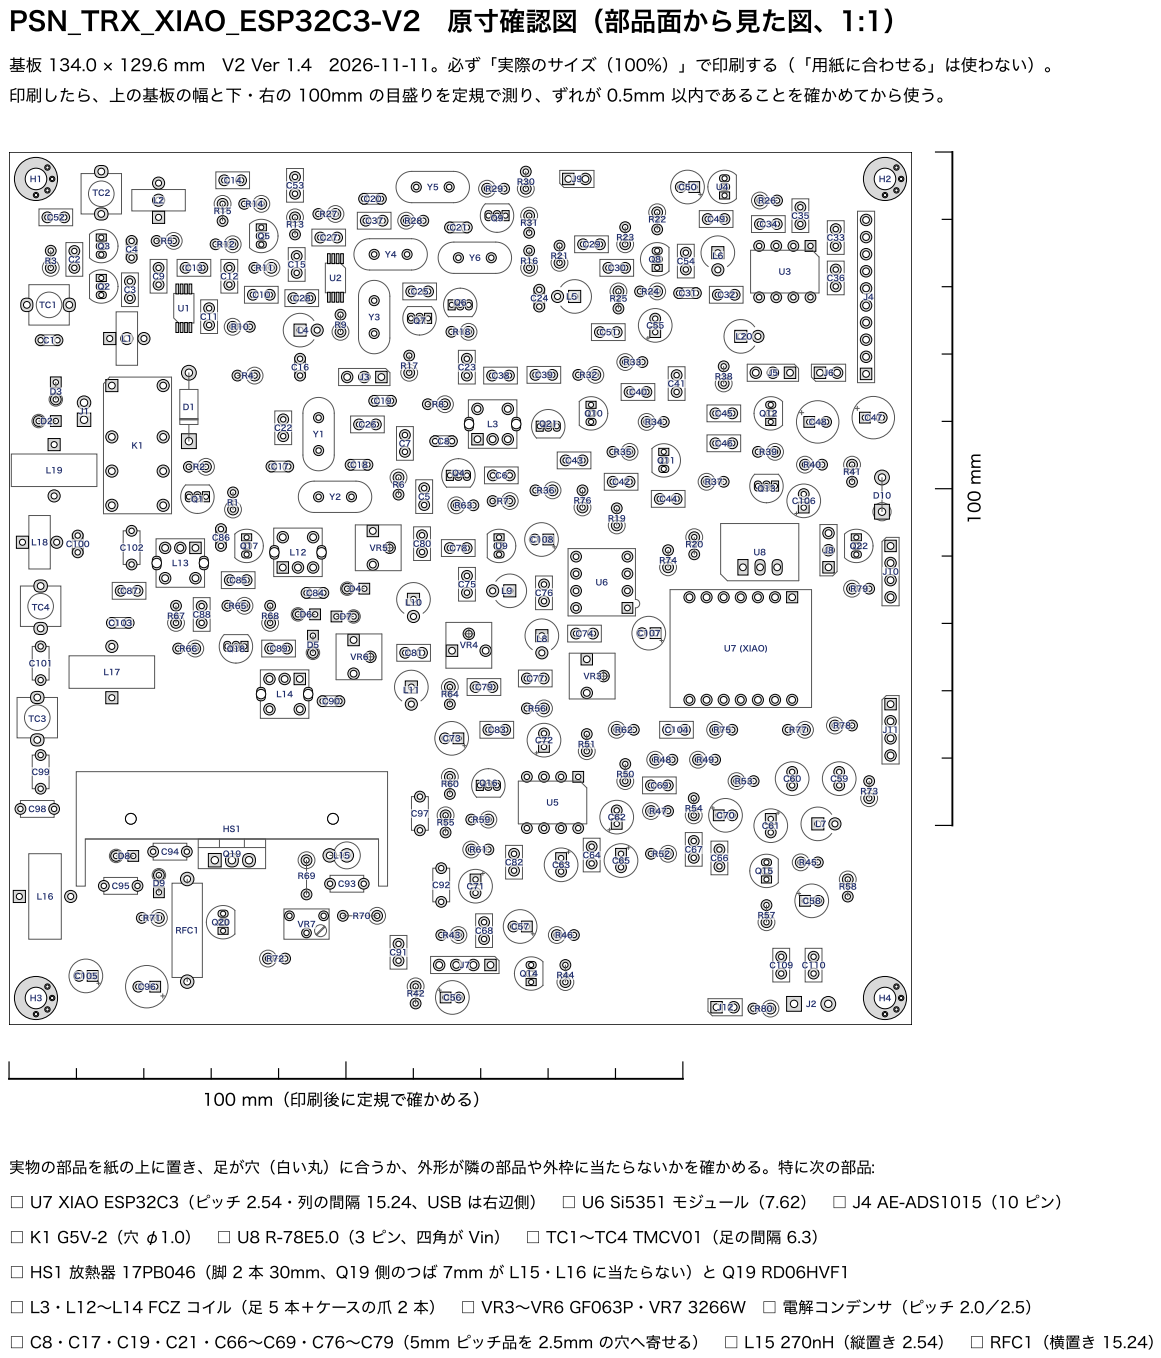
[picture p47: page 1]

基板 134.0 × 129.6 mm V2 Ver 1.4 2026-11-11。必ず「実際のサイズ（100%）」で印刷する（「用紙に合わせる」は使わない）。

印刷したら、上の基板の幅と下・右の 100mm の目盛りを定規で測り、ずれが 0.5mm 以内であることを確かめてから使う。

実物の部品を紙の上に置き、足が穴（白い丸）に合うか、外形が隣の部品や外枠に当たらないかを確かめる。特に次の部品:

□ U7 XIAO ESP32C3（ピッチ 2.54・列の間隔 15.24、USB は右辺側）　□ U6 Si5351 モジュール（7.62）　□ J4 AE-ADS1015（10 ピン）

□ K1 G5V-2（穴 φ1.0）　□ U8 R-78E5.0（3 ピン、四角が Vin）　□ TC1〜TC4 TMCV01（足の間隔 6.3）

□ L3・L12〜L14 FCZ コイル（足 5 本＋ケースの爪 2 本）　□ VR3〜VR6 GF063P・VR7 3266W　□ 電解コンデンサ（ピッチ 2.0／2.5）

□ C8・C17・C19・C21・C66〜C69・C76〜C79（5mm ピッチ品を 2.5mm の穴へ寄せる）　□ L15 270nH（縦置き 2.54）　□ RFC1（横置き 15.24）

## U6-VDD LED K⁽Q²⁰⁾

# PSN_TRX_XIAO_ESP32C3-V2 原寸確認図（2）主な部品のピン名・信号名（部品面から見た図、1:1）

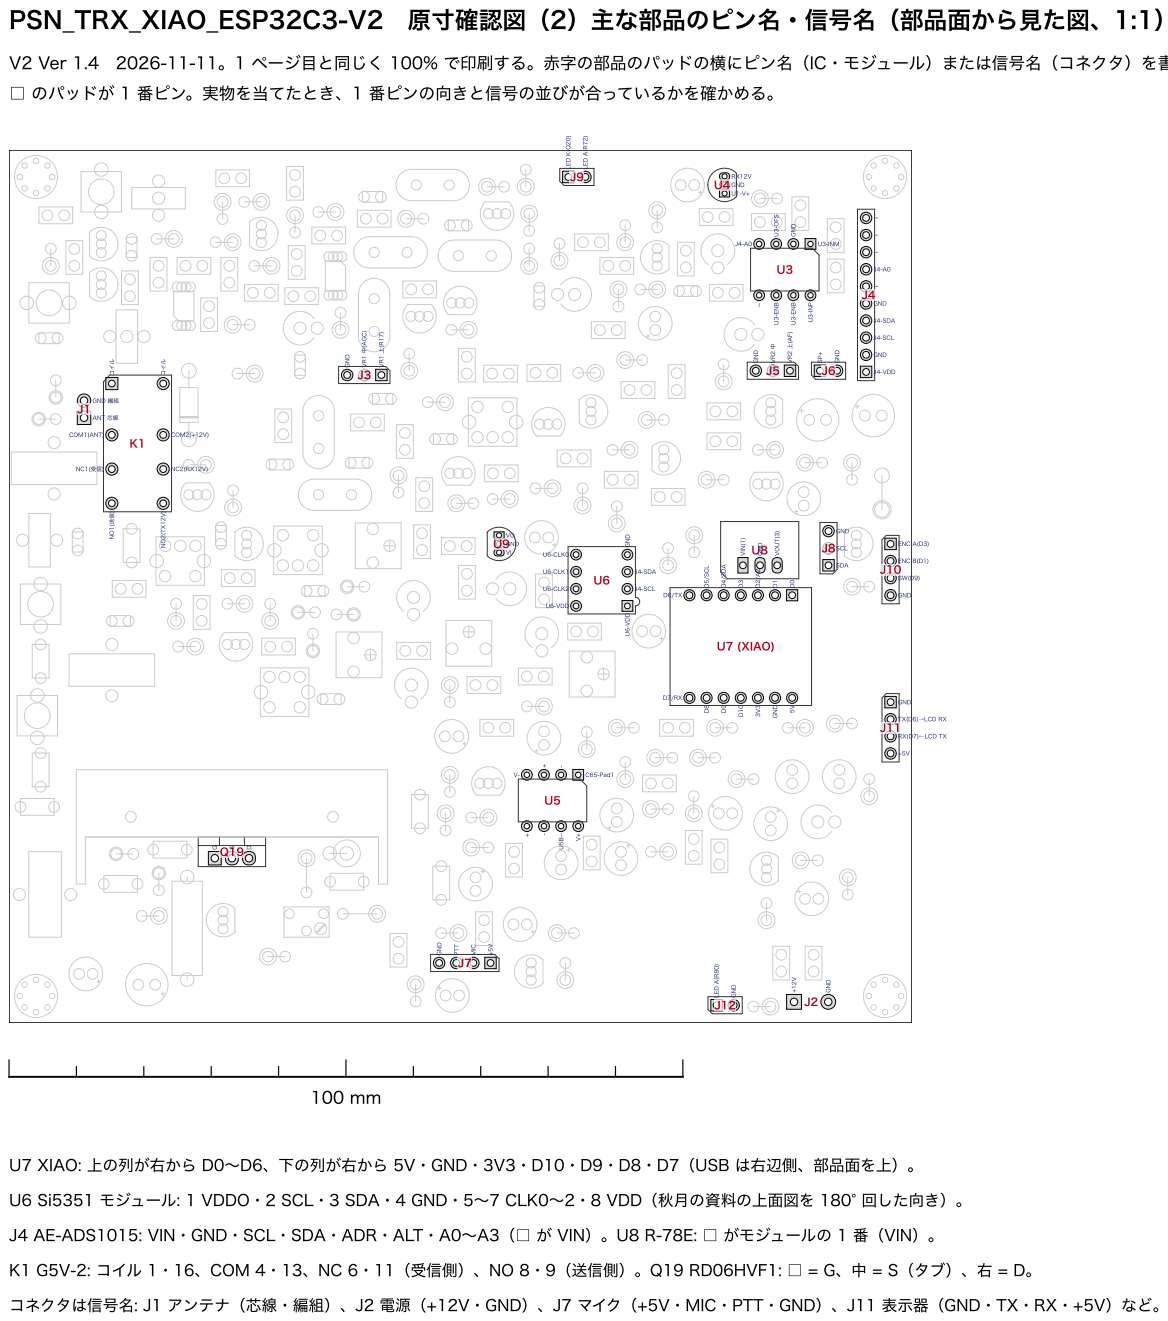
[picture p48: page 2]

V2 Ver 1.4 2026-11-11。1 ページ目と同じく 100% で印刷する。赤字の部品のパッドの横にピン名（IC・モジュール）または信号名（コネクタ）を書いた。

□ のパッドが 1 番ピン。実物を当てたとき、1 番ピンの向きと信号の並びが合っているかを確かめる。

U7 XIAO: 上の列が右から D0〜D6、下の列が右から 5V・GND・3V3・D10・D9・D8・D7（USB は右辺側、部品面を上）。

U6 Si5351 モジュール: 1 VDDO・2 SCL・3 SDA・4 GND・5〜7 CLK0〜2・8 VDD（秋月の資料の上面図を 180° 回した向き）。

J4 AE-ADS1015: VIN・GND・SCL・SDA・ADR・ALT・A0〜A3（□ が VIN）。U8 R-78E: □ がモジュールの 1 番（VIN）。

K1 G5V-2: コイル 1・16、COM 4・13、NC 6・11（受信側）、NO 8・9（送信側）。Q19 RD06HVF1: □ = G、中 = S（タブ）、右 = D。

コネクタは信号名: J1 アンテナ（芯線・編組）、J2 電源（+12V・GND）、J7 マイク（+5V・MIC・PTT・GND）、J11 表示器（GND・TX・RX・+5V）など。
