kazushinjo/PSN_TRX_XIAO_ESP32C3-V2/kicad/PSN_TRX_部品配置図.pdf

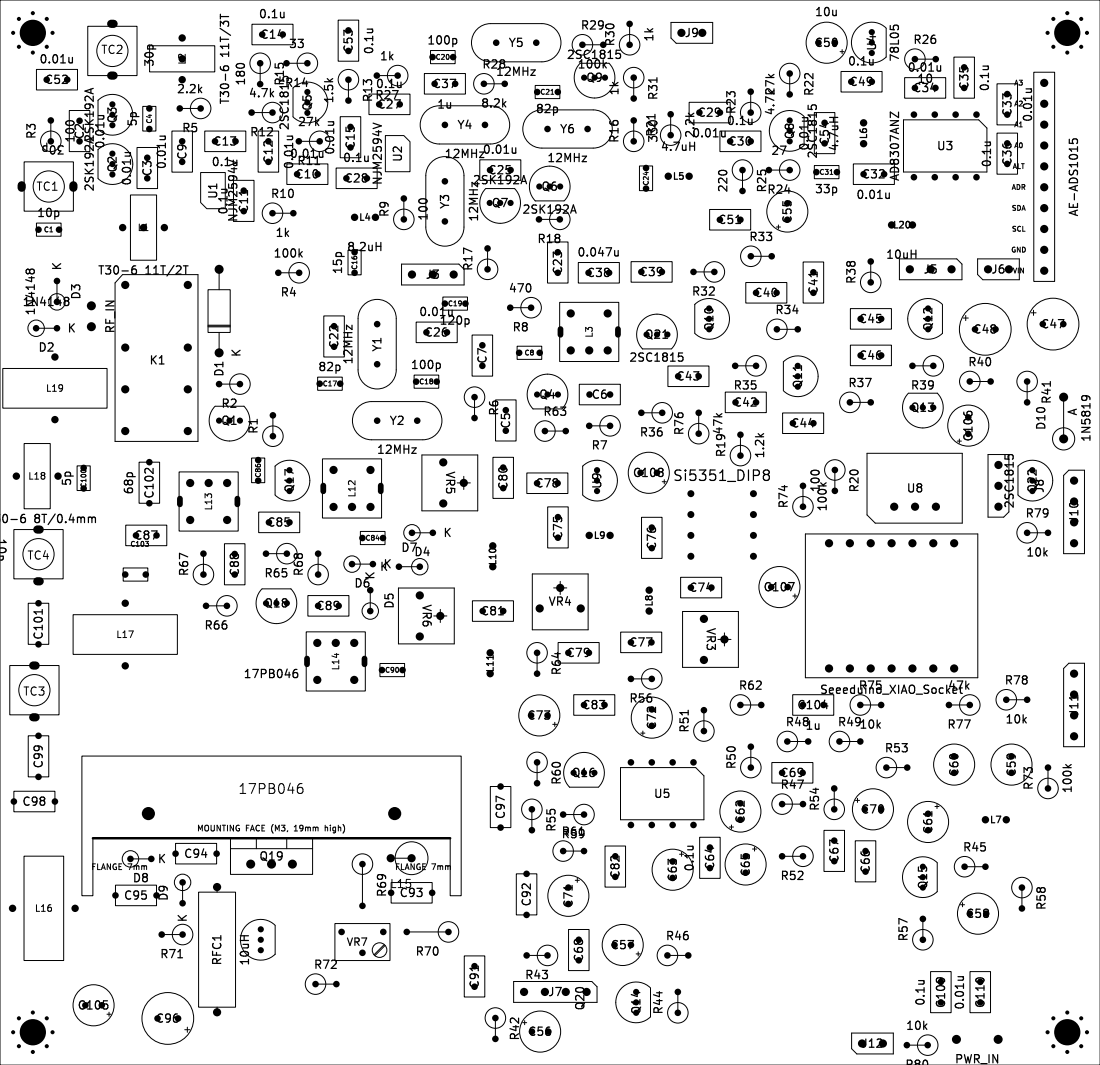
[picture p49: page 1]
