kazushinjo/PSN_TRX_XIAO_ESP32C3-V2/kicad/PSN_TRX.kicad_pcb

## KiCad design kicad/PSN_TRX.kicad_pcb (2026-11-10)

Schematic: PSN_TRX.kicad_sch, 50Mhz PSN トランシーバ

Parts:
C1: 10p; C_Disc_D3.0mm_W1.6mm_P2.50mm
C2, C3, C5, C6, C7, C9, C10, C12, C15, C22, C23, C25, C26, C29, C32, C33, C34, C51, C52, C54, C74, C75, C82, C83, C85, C87, C88, C89, C91, C110: 0.01u; C_Disc_D5.0mm_W2.5mm_P2.50mm
C4, C100, C103: 5p; C_Disc_D3.0mm_W1.6mm_P2.50mm
C8: 27p; C_Disc_D3.0mm_W1.6mm_P2.50mm
C11, C13, C14, C27, C28, C30, C35, C36, C41, C42, C43, C49, C53, C64, C109: 0.1u; C_Disc_D5.0mm_W2.5mm_P2.50mm
C16, C84, C86, C90: 15p; C_Disc_D3.0mm_W1.6mm_P2.50mm
C17, C21: 82p; C_Disc_D3.0mm_W1.6mm_P2.50mm
C18, C20: 100p; C_Disc_D3.0mm_W1.6mm_P2.50mm
C19: 120p; C_Disc_D3.0mm_W1.6mm_P2.50mm
C24, C31: 33p; C_Disc_D3.0mm_W1.6mm_P2.50mm
C37, C39, C40, C44, C45, C46, C104: 1u; C_Disc_D5.0mm_W2.5mm_P2.50mm
C38: 0.047u; C_Disc_D5.0mm_W2.5mm_P2.50mm
C47, C48, C96: 100u; CP_Radial_D6.3mm_P2.50mm
C50, C55, C58, C61, C63, C105, C106, C107, C108: 10u; CP_Radial_D5.0mm_P2.00mm
C56: 47u; CP_Radial_D5.0mm_P2.00mm
C57, C62, C65, C70, C71, C72, C73: 1u; CP_Radial_D5.0mm_P2.00mm
C59: 0.01u; C_Radial_D5.0mm_P2.00mm_CPpad
C60: 0.068u; C_Radial_D5.0mm_P2.00mm_CPpad
C66, C67, C68, C69: 3300p; C_Disc_D5.0mm_W2.5mm_P2.50mm
C76, C77, C78, C79: 47PF; C_Disc_D5.0mm_W2.5mm_P2.50mm
C80, C81: 0.001u; C_Disc_D5.0mm_W2.5mm_P2.50mm
C92: 150pF; C_Disc_D5.0mm_W2.5mm_P5.00mm
C93: 33pF; C_Disc_D5.0mm_W2.5mm_P5.00mm
C94: 0.001u; C_Disc_D5.0mm_W2.5mm_P5.00mm
C95, C97: 0.1uF; C_Disc_D5.0mm_W2.5mm_P5.00mm
C98: 39p; C_Disc_D5.0mm_W2.5mm_P5.00mm
C99: 82p; C_Disc_D5.0mm_W2.5mm_P5.00mm
C101: 100p; C_Disc_D5.0mm_W2.5mm_P5.00mm
C102: 68p; C_Disc_D5.0mm_W2.5mm_P5.00mm
D1: 1N4001; D_DO-41_SOD81_P10.16mm_Horizontal
D2, D3: 1N4148; D_DO-35_SOD27_P2.54mm_Vertical_CathodeUp
D4, D5, D6, D7, D8, D9: 1N60; D_DO-35_SOD27_P2.54mm_Vertical_CathodeUp
D10: 1N5819; D_DO-41_SOD81_P5.08mm_Vertical_AnodeUp
J1: RF_IN; SolderWire_1x02_P2.54mm_D1.1mm
J2: PWR_IN; SolderWire_1x02_P5.08mm_D1.1mm
J3, J5: Volume; PinHeader_1x03_P2.54mm_Vertical
J4: AE-ADS1015; AE-ADS1015_Vertical
J6: SP-OUT; PinHeader_1x02_P2.54mm_Vertical
J7: MIC-IN; PinHeader_1x04_P2.54mm_Vertical
J8: I2C_OUT-LCD; PinHeader_1x03_P2.54mm_Vertical
J9: TX-ON-LED; PinHeader_1x02_P2.54mm_Vertical
J10: Encoder; PinHeader_1x04_P2.54mm_Vertical
J11: NX4832T035; PinHeader_1x04_P2.54mm_Vertical
J12: POWER-LED; PinHeader_1x02_P2.54mm_Vertical
K1: G5V-2 DC12; Relay_DPDT_Omron_G5V-2_D1.0mm
L1: T30-6 11T/2T; L_T30_3pin_Vertical
L2: T30-6 11T/3T; L_T30_3pin_Vertical
L3, L12, L13, L14: 7T50; L_FCZ07S_CT
L4: 8.2uH; L_AL0510-153K_Vertical
L5, L6: 4.7uH; L_AL0510-153K_Vertical
L7: 15mH; L_AL0510-153K_Vertical
L8, L9: 100nH; L_AL0510-153K_Vertical
L10, L11: 1mH; L_AL0510-153K_Vertical
L15: 270nH; L_Axial_L9.5mm_D4.0mm_P2.54mm_Vertical_Fastron_SMCC
L16: T-50-10 9T/0.6mm; L_T50_2pin_Vertical
L17: T-50-10 10T/0.6mm; L_T50_2pin_Vertical
L18: T-30-6 8T/0.4mm; L_T30_2pin_Vertical
L19: T-50-10 8T/0.6mm; L_T50_2pin_Vertical
L20: 10uH; L_AL0510-153K_Vertical
LED1: LED黄; PinHeader_1x02_P2.54mm_Vertical; not fitted
Q1: 2SA1015; TO-92_Inline
Q2, Q3, Q6, Q7: 2SK192A; TO-92_Inline
Q4, Q17: 2SK439; TO-92_Inline
Q5, Q8, Q9, Q10, Q11, Q14, Q15, Q16, Q18, Q20, Q21, Q22: 2SC1815; TO-92_Inline
Q12: 2SA950; TO-92_Inline
Q13: 2SC2120; TO-92_Inline
Q19: RD06HVF1; TO-220-3_Vertical
R1, R12, R23, R43, R61, R62, R67: 4.7k; R_Axial_DIN0207_L6.3mm_D2.5mm_P2.54mm_Vertical
R2, R39, R40, R75, R78, R79, R80: 10k; R_Axial_DIN0207_L6.3mm_D2.5mm_P2.54mm_Vertical
R3, R9, R18, R20, R68: 100; R_Axial_DIN0207_L6.3mm_D2.5mm_P2.54mm_Vertical
R4, R6, R29, R32, R35, R44, R48, R49, R71, R73, R74: 100k; R_Axial_DIN0207_L6.3mm_D2.5mm_P2.54mm_Vertical
R5, R21: 2.2k; R_Axial_DIN0207_L6.3mm_D2.5mm_P2.54mm_Vertical
R7, R65: 51; R_Axial_DIN0207_L6.3mm_D2.5mm_P2.54mm_Vertical
R8: 470; R_Axial_DIN0207_L6.3mm_D2.5mm_P2.54mm_Vertical
R10, R27, R30, R31, R33, R36, R37, R42, R45, R50, R72: 1k; R_Axial_DIN0207_L6.3mm_D2.5mm_P2.54mm_Vertical
R11, R22: 27k; R_Axial_DIN0207_L6.3mm_D2.5mm_P2.54mm_Vertical
R13, R34: 1.5k; R_Axial_DIN0207_L6.3mm_D2.5mm_P2.54mm_Vertical
R14: 33; R_Axial_DIN0207_L6.3mm_D2.5mm_P2.54mm_Vertical
R15: 180; R_Axial_DIN0207_L6.3mm_D2.5mm_P2.54mm_Vertical
R16, R38, R46: 330; R_Axial_DIN0207_L6.3mm_D2.5mm_P2.54mm_Vertical
R17, R51, R66: 20k; R_Axial_DIN0207_L6.3mm_D2.5mm_P2.54mm_Vertical
R19: 1.2k; R_Axial_DIN0207_L6.3mm_D2.5mm_P2.54mm_Vertical
R24: 27; R_Axial_DIN0207_L6.3mm_D2.5mm_P2.54mm_Vertical
R25: 220; R_Axial_DIN0207_L6.3mm_D2.5mm_P2.54mm_Vertical
R26: 10; R_Axial_DIN0207_L6.3mm_D2.5mm_P2.54mm_Vertical
R28: 8.2k; R_Axial_DIN0207_L6.3mm_D2.5mm_P2.54mm_Vertical
R41: 100 1W; R_Axial_DIN0207_L6.3mm_D2.5mm_P2.54mm_Vertical
R47: 620; R_Axial_DIN0207_L6.3mm_D2.5mm_P2.54mm_Vertical
R52: 22k; R_Axial_DIN0207_L6.3mm_D2.5mm_P2.54mm_Vertical
R53, R54, R55, R56: 3.3k; R_Axial_DIN0207_L6.3mm_D2.5mm_P2.54mm_Vertical
R57, R59: 1M; R_Axial_DIN0207_L6.3mm_D2.5mm_P2.54mm_Vertical
R58, R60: 22; R_Axial_DIN0207_L6.3mm_D2.5mm_P2.54mm_Vertical
R63, R64: 47; R_Axial_DIN0207_L6.3mm_D2.5mm_P2.54mm_Vertical
R69: 10; R_Axial_DIN0207_L6.3mm_D2.5mm_P5.08mm_Vertical
R70: 330; R_Axial_DIN0207_L6.3mm_D2.5mm_P5.08mm_Vertical
R76, R77: 47k; R_Axial_DIN0207_L6.3mm_D2.5mm_P2.54mm_Vertical
RFC1: 10uH; L_Axial_L14.0mm_D4.5mm_P15.24mm_Horizontal_Fastron_LACC
TC1, TC2, TC3: 30p; C_Trimmer_TMCV01
TC4: 10p; C_Trimmer_TMCV01
U1, U2: NJM2594V; TSSOP-8_4.4x3mm_P0.65mm
U3: AD8307ANZ; DIP-8_W7.62mm
U4: 78L05; TO-92_Inline
U5: NJM2904; DIP-8_W7.62mm
U6: Si5351_DIP8; DIP-8_W7.62mm
U7: Seeeduino_XIAO_Socket
U8: R-78E5.0-1.0; DCDC_RECOM_R-78E_78Lxx-pinmap
U9: LP2950-3.3_TO92; TO-92_Inline
VR1, VR2: 10k; Potentiometer_TOCOS_GF063P_Vertical; not fitted
VR3, VR4: 500; Potentiometer_TOCOS_GF063P_Vertical
VR5, VR6: 1k; Potentiometer_TOCOS_GF063P_Vertical
VR7: 500; Potentiometer_Bourns_3266W_Vertical
Y1, Y2, Y3, Y4, Y5, Y6: 12MHz; Crystal_HC49-U_Vertical

Connections:
+5V: C64.1, C107.1, D10.2 (A), J7.1, J11.4, R42.1, R48.1, U5.8 (V+), U8.1 (VO), U9.3 (VI)
/+12V: C109.1, C110.1, J2.1, K1.13, L20.1, Q1.1 (E), R2.1, R80.1
/PSN_I_OUT: C67.1, C70.1, R54.1
/PTT: J7.3, R1.2
/TX12V: C86.2, C87.1, C90.2, C91.1, C95.1, C96.1, C97.1, K1.9, L13.3 (SB), L14.3 (SB), R45.1, R61.1, R62.1, R66.1, R70.1, R72.2, R77.1, RFC1.1
GND: C1.2, C2.2, C3.2, C4.2, C6.2, C7.2, C11.2, C13.2, C14.2, C16.2, C17.2, C18.2, C19.2, C20.2, C21.2, C22.2, C23.2, C27.2, C28.2, C30.2, C31.2, C33.2, C34.2, C35.2, C36.2, C38.2, C41.2, C42.2, C43.2, C47.2, C49.2, C50.2, C51.2, C52.2, C53.2, C54.2, C55.2, C56.2, C59.2, C60.2, C63.2, C64.2, C66.2, C67.2, C68.2, C69.2, C76.1, C77.1, C78.1, C79.1, C82.2, C83.2, C85.2, C87.2, C89.2, C91.2, C93.2, C95.2, C96.2, C97.2, C98.2, C99.2, C100.2, C101.2, C102.2, C104.2, C105.2, C106.2, C107.2, C108.2, C109.2, C110.2, D1.2 (A), D2.2 (A), D3.1 (K), D8.2 (A), J1.2, J2.2, J3.3, J4.2 (GND), J4.5 (ADDR), J5.3, J6.2, J7.4, J8.3 (GND), J10.4, J11.1, J12.2, K1.1, L1.3, L3.5 (AB), L12.2 (CT), L12.5 (AB), L13.5 (AB), L14.5 (AB), Q9.1 (E), Q10.1 (E), Q13.1 (E), Q19.2 (S), Q20.1 (E), Q21.1 (E), Q22.1 (E), R3.2, R6.2, R7.2, R9.2, R10.2, R12.2, R15.2, R16.2, R18.2, R20.2, R23.2, R25.2, R27.2, R36.2, R46.2, R47.2, R49.2, R58.2, R60.2, R63.2, R64.2, R65.2, R67.2, R68.2, R71.2, R74.2, R78.2, TC1.2, TC2.2, TC3.2, TC4.2, U1.4 (GND), U2.4 (GND), U3.2 (COM), U4.2 (GND), U5.4 (V-), U5.5 (+), U6.4 (GND), U7.9 (GND), U8.2 (GND), U9.2 (GND), VR7.3; also elsewhere on the board
unnamed: C5.2, C80.1, R63.1, VR3.1
unnamed: C10.1, R8.2, R9.1
unnamed: C14.1, R14.2, R15.1
unnamed: C15.2, C16.1, L4.1
unnamed: C17.1, Y1.2, Y2.1
unnamed: C18.1, Y2.2, Y3.1
unnamed: C19.1, Y3.2, Y4.1
unnamed: C20.1, Y4.2, Y5.1
unnamed: C21.1, Y5.2, Y6.1
unnamed: C26.1, R19.2, R20.1
unnamed: C29.1, R21.2
unnamed: C30.1, R24.2, R25.1
unnamed: C37.2, R28.1
unnamed: C38.1, C39.1, R31.2
unnamed: C40.2, C41.1, R34.1
unnamed: C44.2, R38.1
unnamed: C56.1, R42.2, R43.1
unnamed: C58.2, C59.1, L7.2
unnamed: C60.1, C61.1, L7.1
unnamed: C61.2, C62.2, R47.1
unnamed: C63.1, R50.2
unnamed: C65.1, R51.1, U5.1
unnamed: C65.2, R52.2
unnamed: C66.1, R53.1, R54.2
unnamed: C68.1, R55.1, R56.2
unnamed: C69.1, C72.1, R56.1
unnamed: C71.2, C82.1, L10.2
unnamed: C73.2, C83.1, L11.2
unnamed: C74.1, C76.2, L8.1
unnamed: C75.1, C78.2, L9.1
unnamed: C77.2, L8.2, VR3.2, VR3.3
unnamed: C79.2, L9.2, VR4.2, VR4.3
unnamed: C80.2, L10.1, VR5.2
unnamed: C81.1, R64.1, VR4.1
unnamed: C81.2, L11.1, VR6.2
unnamed: C92.2, C93.1, L15.1
unnamed: C94.2, C98.1, L16.2
unnamed: C99.1, L16.1, L17.1, TC3.1
unnamed: C100.1, L18.2, TC4.1
unnamed: C101.1, L17.2, L18.1, L19.2
unnamed: C102.1, C103.1, K1.8, L19.1
unnamed: C104.1, R75.2, R76.1
unnamed: D1.1 (K), K1.16, Q1.2 (C)
unnamed: D2.1 (K), D3.2 (A), K1.6, L1.2 (TAP)
unnamed: C84.1, D4.2 (A), D6.2 (A), L12.1 (SA)
unnamed: D4.1 (K), VR5.1
unnamed: D5.2 (A), VR5.3
unnamed: C84.2, D5.1 (K), D7.1 (K), L12.3 (SB)
unnamed: D6.1 (K), VR6.1
unnamed: D7.2 (A), VR6.3
unnamed: C103.2, D8.1 (K), D9.2 (A)
unnamed: D9.1 (K), Q20.3 (B), R71.1
unnamed: D10.1 (K), U7.8 (VIN)
unnamed: J1.1, K1.4
unnamed: J3.1, R17.1
unnamed: C22.1, J3.2, Q7.3 (G), Q21.2 (C), R4.1
unnamed: C36.1, J4.7 (A0), U3.4 (OUT)
unnamed: J4.3 (SCL), J8.2 (SCL), U6.2 (SCL), U7.6 (D5/SCL)
unnamed: J4.4 (SDA), J8.1 (SDA), U6.3 (SDA), U7.5 (D4/SDA)
unnamed: J4.1 (VDD), R73.1, R79.1, U7.10 (3V3)
unnamed: J5.1, R38.2
unnamed: C45.2, C46.1, J5.2
unnamed: C48.2, J6.1
unnamed: C57.1, J7.2, R43.2
unnamed: J9.1, Q20.2 (C)
unnamed: J9.2, R72.1
unnamed: J10.1, U7.4 (D3/A3)
unnamed: J10.2, U7.2 (D1/A1)
unnamed: J10.3, U7.12 (D9/MISO)
unnamed: J11.2, U7.7 (D6/TX)
unnamed: J11.3, U7.14 (D7/RX)
unnamed: J12.1, R80.2
unnamed: C9.1, L2.2 (TAP)
unnamed: L3.4 (AA), R8.1
unnamed: C8.1, L3.1 (SA), Q4.3 (D)
unnamed: L4.2, Y1.1
unnamed: L12.4 (AA), Q17.1 (G)
unnamed: C88.2, L13.4 (AA)
unnamed: C86.1, L13.1 (SA), Q17.3 (D)
unnamed: C92.1, L14.4 (AA)
unnamed: C90.1, L14.1 (SA), Q18.2 (C)
unnamed: Q1.3 (B), R1.1, R2.2
unnamed: Q2.1 (D), Q3.2 (S)
unnamed: C1.1, L1.1, Q2.3 (G), TC1.1
unnamed: C2.1, Q2.2 (S), R3.1
unnamed: C4.1, L2.1, Q3.1 (D), R5.2, TC2.1
unnamed: C3.1, Q3.3 (G), R4.2
unnamed: C5.1, Q4.1 (G), R6.1
unnamed: C6.1, Q4.2 (S), R7.1
unnamed: C12.2, Q5.3 (B), R11.2, R12.1
unnamed: C15.1, Q5.2 (C), R13.2
unnamed: Q5.1 (E), R14.1
unnamed: Q6.1 (D), Q7.2 (S)
unnamed: Q6.3 (G), R16.1, Y6.2
unnamed: C23.1, Q6.2 (S), R18.1
unnamed: C24.1, C25.1, L5.2, Q7.1 (D), R21.1
unnamed: C29.2, Q8.3 (B), R22.2, R23.1
unnamed: C31.1, C32.1, L6.2, Q8.2 (C)
unnamed: Q8.1 (E), R24.1
unnamed: Q9.3 (B), R28.2, R29.1
unnamed: Q9.2 (C), R29.2, R30.1, R31.1
unnamed: C39.2, Q10.3 (B), R32.1
unnamed: C40.1, Q10.2 (C), R32.2, R33.1
unnamed: C42.1, Q11.3 (B), R34.2, R35.1
unnamed: C44.1, Q11.2 (C), R35.2, R37.1
unnamed: C43.1, Q11.1 (E), R36.1
unnamed: C45.1, Q12.3 (B), R39.2
unnamed: C48.1, Q12.2 (C), Q13.2 (C), R39.1, R40.2
unnamed: C47.1, Q12.1 (E), R41.1
unnamed: C46.2, Q13.3 (B), R40.1
unnamed: C57.2, Q14.3 (B), R44.2
unnamed: C58.1, Q14.2 (C), R44.1, R45.2
unnamed: Q14.1 (E), R46.1
unnamed: C70.2, Q15.3 (B), R57.2
unnamed: C71.1, Q15.2 (C), R57.1, R62.2
unnamed: Q15.1 (E), R58.1
unnamed: C72.2, Q16.3 (B), R59.2
unnamed: C73.1, Q16.2 (C), R59.1, R61.2
unnamed: Q16.1 (E), R60.1
unnamed: C85.1, Q17.2 (S), R65.1
unnamed: C88.1, Q18.3 (B), R66.2, R67.1
unnamed: C89.1, Q18.1 (E), R68.1
unnamed: C94.1, Q19.3 (D), RFC1.2
unnamed: L15.2, Q19.1 (G), R69.1
unnamed: Q21.3 (B), R76.2
unnamed: Q22.3 (B), R77.2, R78.1
unnamed: Q22.2 (C), R79.2, U7.1 (D0/A0)
unnamed: R69.2, VR7.2
unnamed: R70.2, VR7.1
unnamed: C13.1, U1.6 (BYP)
unnamed: C10.2, U1.7 (CARR)
unnamed: C12.1, R10.1, U1.3 (OUT2)
unnamed: C9.2, U1.5 (SIG)
unnamed: C11.1, C27.1, C50.1, R26.1, U1.1 (V+), U2.1 (V+), U4.1 (VO)
unnamed: C28.1, U2.6 (BYP)
unnamed: C26.2, U2.7 (CARR)
unnamed: C37.1, R27.1, U2.3 (OUT2)
unnamed: C25.2, U2.5 (SIG)
unnamed: C35.1, R26.2, U3.6 (ENB), U3.7 (VPS)
unnamed: C33.1, U3.1 (INM)
unnamed: C32.2, U3.8 (INP)
unnamed: C34.1, U3.3 (OFS)
unnamed: C62.1, R48.2, R49.1, U5.3 (+)
unnamed: R50.1, R51.2, U5.2 (-)
unnamed: U5.6 (-), U5.7
unnamed: C74.2, U6.5 (CLK0)
unnamed: C75.2, U6.6 (CLK1)
unnamed: R19.1, U6.7 (CLK2)
unnamed: C108.1, U6.1 (VDDO), U6.8 (VDD), U9.1 (VO)
unnamed: R52.1, R73.2, R74.1, U7.3 (D2/A2)
unnamed: R55.2, U7.13 (D8/SCK)
unnamed: R53.2, R75.1, U7.11 (D10/MOSI)
unnamed: C106.1, L20.2, U8.3 (VI)
RX12V: C7.1, C8.2, C24.2, C49.1, C51.1, C52.1, C53.1, C54.1, C55.1, C105.1, K1.11, L2.3, L3.3 (SB), L5.1, L6.1, R5.1, R11.1, R13.1, R17.2, R22.1, R30.2, R33.2, R37.2, R41.2, U4.3 (VI)

Notes on the sheet:
混合後増幅・L 整合
合成・平衡変調
DDS
局発 = 受信 − 12MHz（CLK0 → Q4 → L3）
S メーター
音量（パネルの VR2）
第 1 混合
IF 増幅
送信音声の I/Q 生成（Ver 2.0）: マイク → L7 LPF → IC2A（約 21 倍）→ C65・R52 → U7 の A2（受信中は S メーター用の受信音）→ 複素 FIR（16 kHz、127 タップ、300〜2700 Hz）→ PDM（D8 = Q、D10 = I。D10 は受信中は AGC の PWM）→ 2 段 RC（約 15 kHz）→ C72・C70。送信検出は D0 へ移動
SSB フィルタ（12MHz ラダー）
スピーカー
Q9 はプリアンプ（V2 改）、Q10・Q11 は電圧増幅、Q13・Q12 は出力段（スピーカー 8Ω）
積検波
低周波増幅
AF PSN・信号分割
IF 増幅は Q7・Q6（2SK192A カスコード）。R18 は Q6 のソース抵抗
受信部（V2: 12MHz の SSB シングルスーパー）
IF 増幅（Q7・Q6）の出力を AD8307 で測る → ADS1015 → XIAO（I2C 0x48）
RF PSN
BFO = CLK2（R19・R20 で約 90mV）
J4 は秋月 AE-ADS1015（立てて差す）
水晶 6 個は同じロットから直列共振 ±50Hz 以内を選ぶ
入力同調・RF 増幅（50MHz）
終段増幅
受信 5V・パスコン
励振増幅
マイクアンプ
AGC 出力・送信検出（XIAO）。V2: S メーターは AD8307 → AE-ADS1015（上の受信部） AGC は Q21 で IF 増幅 Q7 と RF 増幅 Q3 のゲートを下げる方向のみ。最大ゲインは J3 の VR1 で設定（VR1 必須）
L1（入力同調）→ 2SK192A カスコード（Q2・Q3）→ L2（出力同調）。RF 段にも AGC・RF ゲインが効く
RF ゲイン（パネルの VR1）
AGC は Q21 で G2 を下げる
1.5kΩ → 330Ω（ラダーの終端）

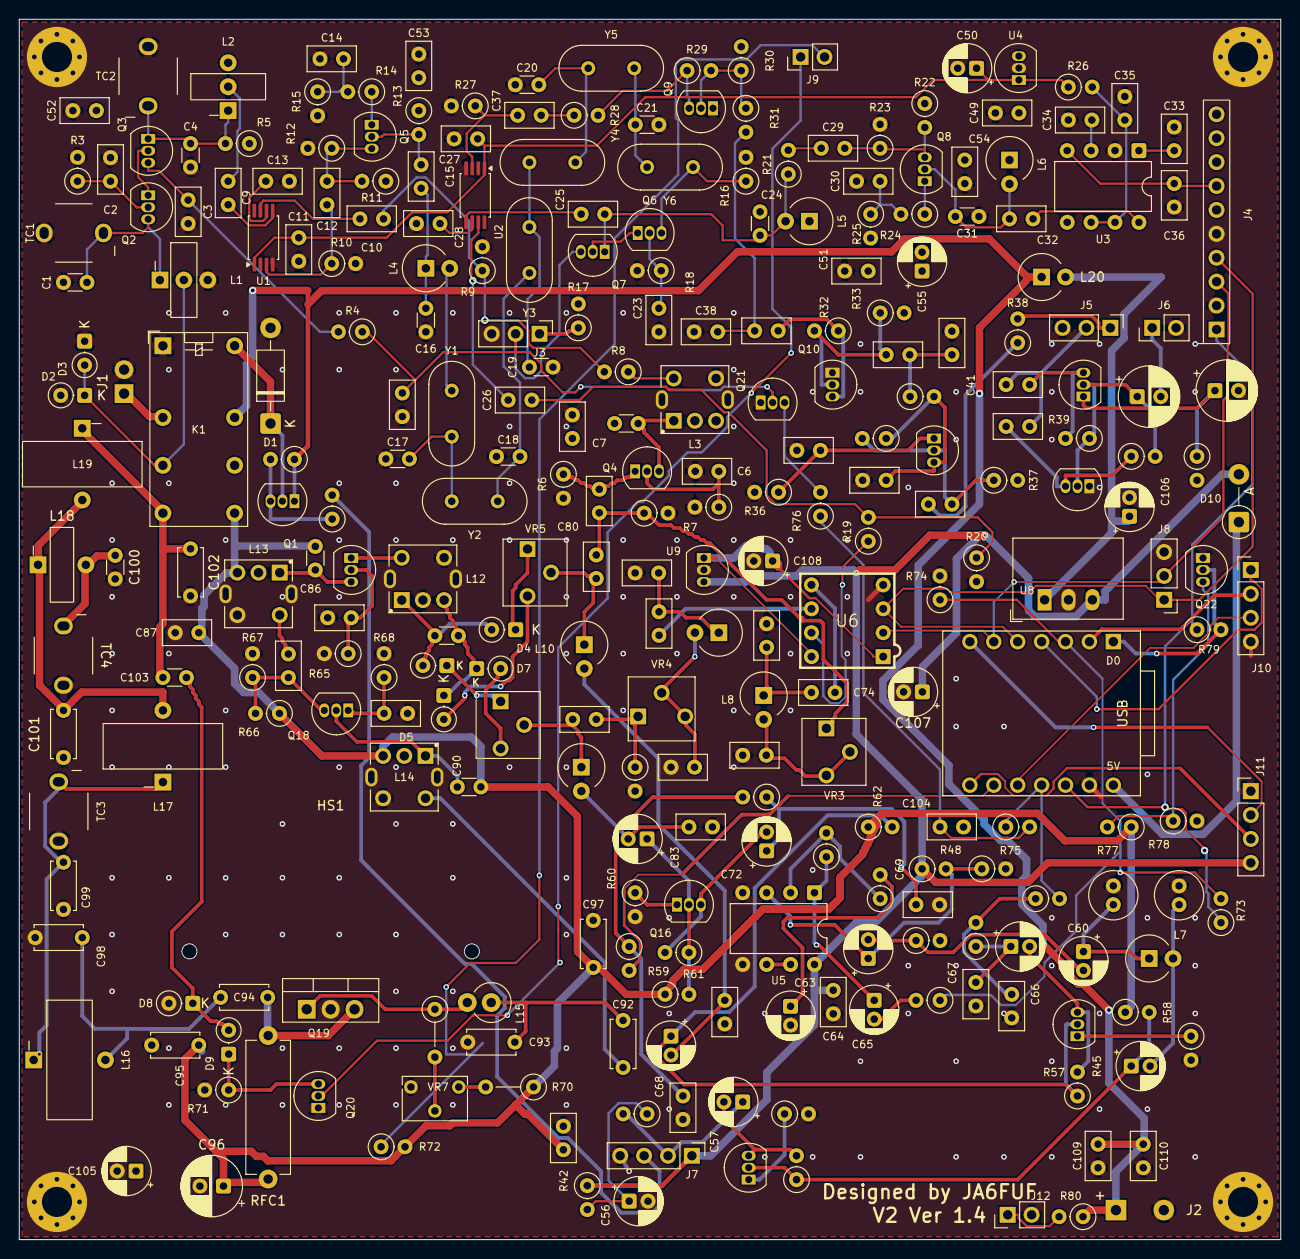
[picture p50: board PSN_TRX.kicad_pcb from above]

Board: 4 copper layers, 134.0 x 129.6 mm, 285 parts (0 on the bottom side), 160 nets.

Other parts of the board:
H1, H2, H3, H4: M3; MountingHole_3.2mm_M3_Pad_Via
HS1: 17PB046; Heatsink_17PB046

Their connections:
GND: H1.1, H2.1, H3.1, H4.1; also elsewhere on the board
