kazushinjo/PSN_TRX_XIAO_ESP32C3-V2/(commit log)

2026-10-30 PSN_TRX-V2（50MHz PSN 方式 SSB トランシーバ、受信 12MHz シングルスーパー）V2 Ver 1.0
    回路図・基板（134.1 × 129.7mm、4 層）・JLCPCB 用製造データ・ファームウェア（XIAO ESP32C3）・
    部品表・部品実装図・調整手順・回路シミュレーション（kicad/sim）
2026-10-30 JLCPCB 提出資料の 4.1 節を V2 Ver 1.0 の計算結果に差し替え
2026-10-30 資料の中のリポジトリ名を PSN_TRX_XIAO_ESP32C3-V2 にそろえる
2026-10-30 ケースを V2 基板（134.0 × 129.63mm）に合わせ、アンテナの BNC を基板 J1 のすぐ後ろへ移す
    - ケースの幅を 215 → 220mm にし、基板寸法・取付穴を V2 に、基板の左端を X 43.3 に
    - 上面右列を X 184、DC ジャックを W-20、ヒューズを X 21 に移す
    - 放熱器 HS1 が左へ来るので、スピーカーを X 41 に移し、後ろ側のふた固定ボスを Y 169.8 に移す
    - BNC を J1 の 3.6mm 右（L1 をかわす）に移し、後面の通風スロットを BNC の左だけにする
    - 穴あけ図・プレビュー画像・README・マニュアルの外形を更新
2026-10-30 ケースのプレビュー画像: 使っていない旧設計の 3 枚を削除し、前面パネルの画像を今のモデルで作り直す
2026-10-30 ケース: DC ジャックを後面のヒューズホルダの隣へ移す（ジャック〜ヒューズの線を短く）
    DC ジャックの本体は基板の左後ろの角の上（基板上 4mm 以上）を通るが、そこには取付穴 H3 しかない。
2026-10-30 ケース: 左側面にも DC ジャック（後面と同じ品、並列）を追加
    - ヒューズホルダ本体のすぐ前（Y 125mm、下から約 20mm）。内側から座ぐりして板厚 1.8mm
    - 文字は彫り込み 0.6mm（エンボスだとベースの幅が 220mm を超える）
    - ヒューズ・ふた固定ボス・基板・スピーカー・LCD との干渉チェックを追加
    - 左側面のプレビュー画像、README・マニュアル（両方に同時に電源をつながない注意）、部品表の DC ジャックを 2 個に
2026-10-30 BOM.md を V2 Ver 1.0 の回路図（bom.csv）に合わせて作り直す
    - 部品表を V2 の bom.csv から作り直す（86 点追加・11 点削除、C11・C29 の値、Q4/Q5 を TO-92 に）。基板実装 202 → 277 点
    - 水晶振動子 Y の表を追加、U4〜U7 を IC の表に、J11（ADS1015）をコネクタの表に
    - 備考は今も正しい旧 BOM.md の記載を残し、V2 の部品は部品実装図の部品メモ（docs/tools/parts_notes.json）に合わせる
    - スピーカー下の注意を今のケース（C13 だけ）に、IC ソケットを 3 個（U7 の分）に
    - 冒頭に V2 の変更点を追加し、それより前の履歴は V1 の履歴とした
2026-10-30 回路図: U3（XIAO）まわりの配線を整理
    - J7（エンコーダ）を U3 の上、J8（表示器）を U3 の下、J9（I2C 出力）を SDA/SCL の横へ移し、各信号をまっすぐ引く
    - SDA/SCL は U1–U3 を水平の直線でつなぎ、J11 へは途中から上へ分岐
    - 右側の 3V3・D10・D8 と左側の D0・D2 は平行に並べて下ろし、元の配線へつなぐ
    - U3 のピンや本体の上を通っていた線、行き戻りしていた線をなくす
    - D8 アノード・J8.4・J10.1 の +5V は電源シンボルにし、上から引き回していた長い配線を外す
    - ネットリストは変更前と同一、ERC 結果も変更前と同じ（エラ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
2026-10-30 回路図: 電源部・マイクアンプ・U3 まわりの配置を整理（接続は変更なし）
    デスクトップで編集した版を取り込む。IC1・U2 などの電源部を下へ、
    Q15〜Q18 のマイクアンプを右下へ広げ、U3・J7・J9 の位置を調整、
    L19 の向きを 0° に。U3 移動で残っていた GND の切れ端の線を削除。
    ネットリストは前の版と同じ（171 ネット）、ERC 0 件。
    プロジェクトの回路図リビジョンを V2 Ver 1.0 に。
2026-10-30 回路図: 配線とジャンクションの位置を整理（接続は変更なし）
    KiCad で編集した版を取り込む。ネットリストは前の版と同じ（171 ネット）、
    ERC 0 件。
2026-10-30 回路図: 部品と配線の位置を整理（接続は変更なし）
2026-10-30 ERC: パネル部品 VR1/VR5/LED1 の未接続除外を移動後の位置に合わせる
2026-10-31 受信の JFET 4 個（Q4・Q5・Q20・Q25）を J310 から 2SK192A-GR に置き換え
    - 2SK192A（東芝）はピン 1 D・2 S・3 G で J310 と同じ並び。TO-92_Inline のまま、基板のパターン・配置は変更なし
    - R66（Q20 のソース）100Ω → 47Ω。R5 は 3SK59 用の 120Ω のまま、Q4・Q5 を付けるときは 47Ω（22〜100Ω で 5〜8mA）
    - DRC 0・未配線 0・回路図との不一致 0、ERC 未除外 0。ガーバーは部品の値を含まないので出し直しなし
    - 部品表（bom・購入用・まとめ・BOM.md・JLCPCB BOM・座標ファイル）、README、調整手順、JLCPCB 提出資料、部品実装図 PDF を更新
    - シミュレー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
2026-10-31 L19 のタップを +9V 側から 2 回目 → 3 回目に（2SK192A-GR で下がった利得を戻す）
    - L19 の値を T30-6 11T/3T に（L18 は 11T/2T のまま）。基板は変更なし（DRC 0・未配線 0・回路図との不一致 0、ERC 0）
    - シミュレーション: RF 増幅 +7.7 → +10.5dB、前段の電力利得 +19.9dB・雑音指数 0.96dB、全体の雑音指数 1.3dB（混合器 NF 10dB）
    - S9 で AD8307 の入力 −8.2dBm（J310 のときと同じ）なので、ファームウェアの RSSI_S9_MV 1900・AGC_TARGET_MV 1750 に戻す
    - 部品表（L18・L19 を別の行に）、JLCPCB BOM・座標ファイル、README、調整手順、提出資料、部品実装図 P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
2026-11-03 購入表: 秋月の「要確認」部品を確認し、サトー電気優先版を追加
    - bom_purchase.csv: V2 で増えた抵抗・コンデンサ・T-30-6・NJM2594V・TA78L05S・
    12MHz 水晶などの秋月の販売コード・価格を 2026-11-04 に確認して記入
    - bom_purchase_sato.csv（make_bom_purchase_sato.py）: サトー電気で扱いのある
    部品をサトー電気から買う版（価格は 2026-11-04 の通販カタログ）
    - BOM.md: 購入先の説明を更新、サトー電気版への案内を追加
2026-11-03 説明書: 操作説明書・送信 I/Q 調整手順を V2 Ver 1.0 に合わせる
    - manual/README.md: 受信方式（12MHz SSB シングルスーパー）、AD8307 の S メーター、
    BFO・sb コマンド、困ったときの表、スケッチの調整値（RSSI_*）を V2 に更新
    - manual/送信IQ調整手順.md: V2 では sb で受信も切り替わるので、送信だけ逆のときは
    I/Q 経路の取り違えを調べるように変更。参照先を調整手順・操作説明書に
    - manual/調整手順.md: 同じく側波帯が逆のときの説明を修正
    - README.md: 更新済み資料に操作説明書と送信 I/Q 調整手順を追加
    - kicad/PSN_TRX.kicad_pro: ERC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
2026-11-05 V2 Ver 1.1: 部品形の誤りを修正、3SK59 を廃止、部品番号を信号の流れ順に振り直し
    - 部品形: XIAO ESP32C3 を Seeed 公式の並び（列の間隔 11.43→15.24mm、鏡写しを修正）、
    Si5351 モジュール（DIP-8）のピン番号を上から見た正しい並びに、L20 を縦置き、
    RFC1 を横置き 15.24mm（スピーカーのマグネットの下）、J2 を電源線じか付け用（穴 φ1.5mm）に
    - 3SK59（旧 Q2）を削除。2SK192A は 4 個とも BL ランク、ソース抵抗 R3・R18 を 100Ω に
    - パスコン（C3・C50・C106・C107）を足元へ移動、回路図の C51〜C55 を実装位置の近くへ
    - ネット名 +9V→RX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
2026-11-05 V2 Ver 1.1: ブロックごとのシミュレーション追加、docx 4 本を V2 化、VR1 を 10kΩ B に
    - kicad/sim/blocks.py を追加（7T50 の同調範囲・局発/BFO のレベル・IF/S メーターの同調・IF 増幅の AGC・送信表示・PTT）。README・JLCPCB 提出資料 4.1・調整手順 3/5 をその結果に合わせた
    - docx 4 本（組み立て説明書・評価試験報告書・回路図論理検証レポート・VFO 仕様書）を V2 Ver 1.1 の内容で書き直し（docs/tools/make_docx.py）
    - 部品実装図の XIAO の表示を U7 に直して再出力、組み立て説明書用の図を docs/assembly_images/ に
    - 3SK59 時代の番号（Q2 の G2 など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
2026-11-05 部品形の再確認: 間違いやすい部品の部品形の図（寸法・信号入り）、I2C のプルアップの手順を追加
    - docs/PSN_TRX_間違いやすい部品形.pdf（9 ページ、PNG は docs/images/fp_check/、作成は docs/tools/make_fp_check.py）。基板に置いた向きの部品形に、ピッチ・列の間隔・穴径・ランド・外形の寸法と、パッドごとのピン名・つながる信号を入れた
    - 部品形の再確認: 276 点でシンボルのピン番号・パッドごとの接続が一致。C47・C48・C96 は買う品が φ5・ピッチ 2.0mm（部品形 2.5mm、足を広げて差す）、Y1〜Y6 は HC-49/S（足の間隔は同じ）など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
2026-11-05 V2 Ver 1.2: 電源関係を左・アンテナ関係を右に集める（J2 移動・J1/J2 じか付け φ1.1・電源 LED・ケースの操作部の並び）
    - 基板: J2（電源入力）を基板の左辺の前寄りへ移し、穴を φ1.5 → φ1.1mm（AWG20、電流 1A 弱に合わせる）に。J1（アンテナ）を同軸のじか付け（2.54mm ピッチ、穴 φ1.1mm）に
    - J2 の横に +12V のパスコン C109（0.1µF）・C110（0.01µF）、電源 LED 用に R80（10kΩ、約 1mA）と J12 を追加（部品 276 → 280 点）
    - 旧 J2 の +12V の短い配線を外し、新しい J2 から L20 まで +12V（0.8mm、約 111mm、ビア 3 個）を基板の前半分に引いた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
2026-11-05 V2 Ver 1.2: TX ランプを RF ゲインの後ろへ、J9 を基板の右側の辺へ、LCD の窓を 20mm 右へ
    - ケース: TX ランプをふたの右の列（RF ゲインのつまみの後ろ、X 184・Y 142）へ。LCD・ベゼルを下の列とは別に 20mm 右へ（ベゼル左端 X 33）。下の列（POWER・ON・MIC・PHN）は X 85.5 を中心に 24mm 間隔のまま
    - 基板: J9（TX ランプ）を右側の辺の前寄り（R31 と R23 の間）へ移し、Q20・R72 まで 0.25mm で引き直した（受信の入口・PA 出力 LPF を避けて基板の中ほどを通す、ビア 3 個）。ほかの配線は動かしていない
    - DRC 違反 0・未配線 0・回路図との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
2026-11-05 ケース: LCD の窓を左へ 7mm（ベゼル左端 X 26）、TX ランプを奥へ 7mm、下の列の POWER・ON を左へ・MIC・PHN を右へ 5mm
    - LCD・ベゼル: ベゼルの左端 X 33 → 26mm（窓の中心 X 88.5mm）
    - TX ランプ: Y 142 → 149mm（RF ゲインのつまみの後ろ）
    - 下の列: POWER X 44.5・ON X 68.5・MIC X 102.5・PHN X 126.5mm（Y 20mm）
    - 干渉チェック（assert）は全部通る。MIC の本体と基板の J10 のすき間は約 0.9mm なので、J10 のケーブルは MIC と反対の向きへ出す
    - 上面図・組立図・ケースの README・README の変更履歴を更新
2026-11-06 組み立て説明書: J10（エンコーダ）のケーブルを MIC と反対の向きへ出す注意を追加
    - ふた裏の MIC コネクタの本体と J10 のすき間が約 0.9mm なので、低いコネクタを使い、ケーブルはケースの右奥へ倒して出す
    - 5.1 コネクタの表・5.3 配線の要点・6 章 通電前のチェックリストに記載
2026-11-07 V2 Ver 1.3: 論理チェックの残り項目と部品形のメーカー資料照合への対応
    - マイクのバイアスを送信 12V から +5V に（R42 の電源側を +5V へ、470Ω → 1kΩ）。13.8V で約 11.2V かかり耐圧 10V を超えていた。マイク電圧は約 2.2〜4.4V
    - C59・C60（セラミック・フィルム）を極性マークなしの部品形 C_Radial_D5.0mm_P2.00mm_CPpad に（パッド・穴は電解用と同じ）
    - I2C のプルアップは AE-ADS1015 のはんだジャンパを短絡する方式に資料をそろえた（購入用部品表の「つながない」を訂正）
    - K1（G5V-2）の穴をオムロン推奨の φ1.0（ランド φ1.8）に
    -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
2026-11-07 V2 Ver 1.3: 部品形をメーカー資料で総点検（TMCV01・放熱器・L15/L16）と原寸確認図
    - TMCV01（TC1〜TC4）の足の間隔を 5.0 → 6.3mm（Topmay の取付穴図）、穴を長穴 1.0 x 1.3mm に
    - 放熱器 17PB046 の外形を実物どおり（取付面からフィン側 10mm、Q19 側に両端のつば 7mm）に
    - つばに当たっていた L15 を縦置き 2.54mm（つばの内側）に、L16 を左下へ移動
    - T-50 縦置きの外形を本体と足だけに、関係する配線 10 区間を引き直し（ビア +3）、放熱器の下の信号ビアを外へ
    - 原寸確認図 docs/PSN_TRX_原寸確認図.pdf（A4、1:1）と make_print_check.py を追加
    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
2026-11-07 原寸確認図に 2 ページ目（主な部品のピン名・コネクタの信号名）を追加
    - XIAO・Si5351・ADS1015・R-78E・AD8307・NJM2904・78L05・LP2950・RD06HVF1 のピン名、K1 の接点、J1〜J12 の信号名をパッドの横に記入（1:1）
2026-11-10 V2 Ver 1.3 のアナログ部シミュレーションを再計算し、報告書（md・PDF）を追加
    - kicad/sim を最新の回路図（f2359f1）で再計算（ngspice-45.2）。計算用データ・結果とも前回と同じ
    - docs/PSN_TRX_シミュレーション結果.md・.pdf: 直流動作点、送受信 AF、送信 I/Q、PA 出力 LPF、
    PA 入力・RFC1、DC-DC 入力フィルタ・AGC・過渡解析、受信部と回路全体、適用範囲をまとめた
    - docs/tools/make_sim_report_pdf.py: 報告書の PDF を作るスクリプト
    - iq_scan.py・sideband.py: 部品番号の振り直しで線の色の指定（C1・C2）が C102・C103 に
    書き換わり、2 本の線が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
2026-11-10 V2 Ver 1.4: PA の入力を 50Ω に整合（C93 を C92 と L15 の間へ、C92 150pF・C93 33pF・L15 270nH）
    - 回路図: C93 の 1 番を Q19 のゲートから C92・L15 の間へつなぎ替え（線で結線）、値を変更、版を V2 Ver 1.4 に
    - 基板: C93 をその場で 180° 回し、ゲートへ行っていた B.Cu の線 2 本を外して F.Cu の線を 2 区間引いた。
    シルクを V2 Ver 1.4 に。DRC 0・未配線 0・回路図との不一致 0、穴・外形は同じ
    - ngspice: 50Ω 源に対する不整合損失 3.4〜5.3dB → 0.2〜0.4dB（50〜51MHz で 0.5dB 以下）。
    送信の出力は同じ変調器入力で約 +5dB、最大 約 1.7W
    - 部品: C92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
2026-11-10 V2 Ver 1.4 の最終チェック: 資料の版数表記を Ver 1.4 にそろえた
    - kicad/BOM.md の最終更新、kicad/README.txt の 1 行目、JLCPCB 提出資料の資料更新日の記述
    - 最終チェック: ERC・DRC・回路図との照合 0、シミュレーション全体の再計算は前回と一致
2026-11-12 回路図: 版数の表示を V2 Ver 1.4 にし、KiCad 10 で保存し直す(回路は変更なし)
    kicad_pro の sch_revision を V2 Ver 1.0 → V2 Ver 1.4。kicad_sch は KiCad 10.0.6 で保存した
    書き直し(電源シンボルの定義の埋め込みなど)。前のコミットとネットリストを比べ、部品283・
    ネット180・接続とも一致、ERC はエラー0・警告0。
2026-11-12 回路図: 配線と接続点の描き方を整理する(回路は変更なし)
    前のコミットとネットリストを比べ、日時の行を除いて差分0行(部品283・ネット180・接続とも一致)。
2026-11-12 README に基板パターン（表面・裏面）の図を追加
2026-11-13 Mac の .DS_Store をリポジトリから外す（.gitignore で除外済み）
